mwelling/robot-chopper/Media/GCS-Platform/2010-04-21 18.45.57.jpg

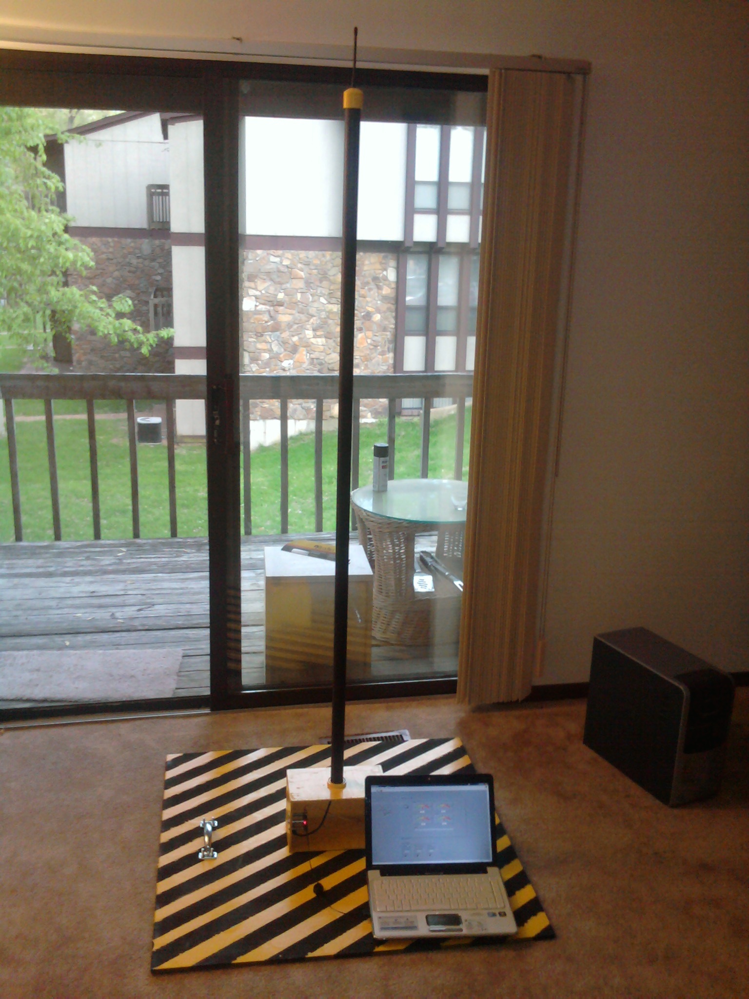
Media/GCS-Platform/2010-04-21 18.45.57.jpg
