mwelling/robot-chopper/Media/GCS-Interface/Interface2.png

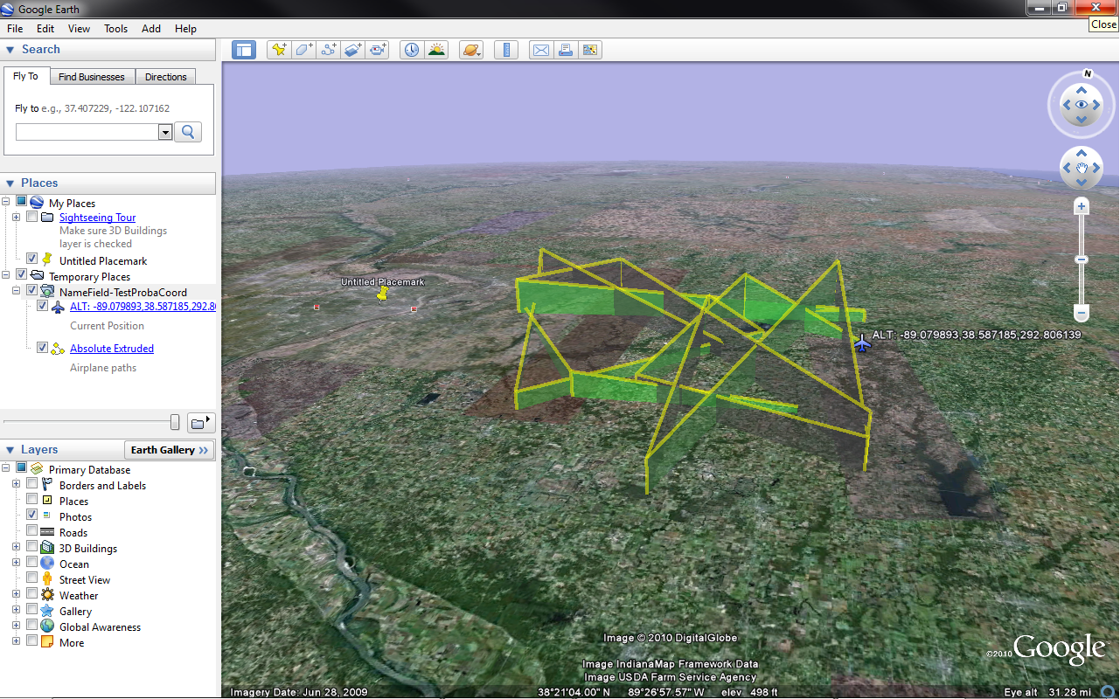
Media/GCS-Interface/Interface2.png
