mwelling/robot-chopper/RemoteControl/Program/ReadMe.txt

Version 1.0:  Manual Control of the Vehicle using the Analog Joysticks, including ability to remove power from Vehicle motor controllers using Kill Switch. Network initialization using 3-way handshake.  Error display on LCD Screen.  RCU will only work with Vehicle, no support for the GCS is possible.

Version 2.0:  Using XBee API Mode, RCU can communicate to GCS and/or Vehicle.

Version 3.0:  Limited autonomous functions (non-GPS enabled) such as Land, Take-Off and Hover implemented.  Force Feedback on RCU, specifics to be developed.

Version 4.0:  Enhanced autonomous functions (GPS enabled) such as Return to RCU, Follow-Me, etc.
