mwelling/robot-chopper/Analysis/INU Calibration/INU Design.docx

Accelerometer Filter Design

Overview:

An Accelerometer detects acceleration through a MEMS device. As an accelerometer works with quickly varying measurements, most of the noise present in an accelerometer is contained in a lower bandwidth.

Using the Matlab Filter Toolbox, a Low pass filter was designed with the following parameters:

Filter Type: Low-Pass, Butterworth, 4th Order.
Filter Cutoff Frequency: 20 Hz
Filter Equation:

H(s)=(.001(.0199s^4 +.0797s^3 +.1195s^2 +.0797s+.0199)/(s^4 -3.6353s^3 +4.9709s^2 -3.0293s+.6941)

Accelerometer Output: ∆a_x ,∆a_y ,∆a_z

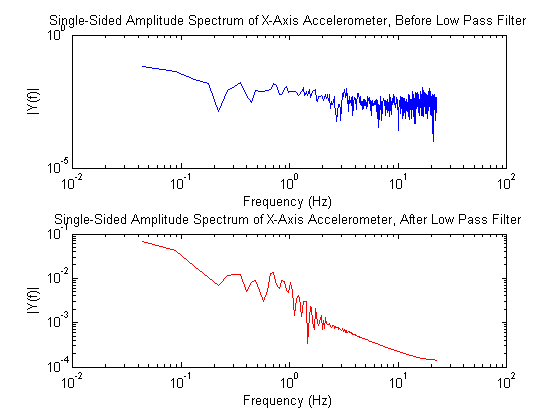
[picture p3: figure]

Figure 1. Accelerometer Filter Results

Gyroscope Filter Design

A Gyroscope detects rotational movement through a MEMS device. As a gyroscope works with measurements that are much slower to change, most of the noise present in a gyroscope is present in higher bandwidths.

bandwidth.

Using the Matlab Filter Toolbox, a High pass filter was designed with the following parameters:

Filter Type: High-Pass, Butterworth, 4th Order.
Filter Cutoff Frequency: 20 Hz
Filter Equation:

H(s)=(.3926s^4 - 1.5705s^3 +2.3558s^2 -1.5705s+.3296)/(s^4 -2.1909s^3 +2.0419s^2 - .895s+.1542)

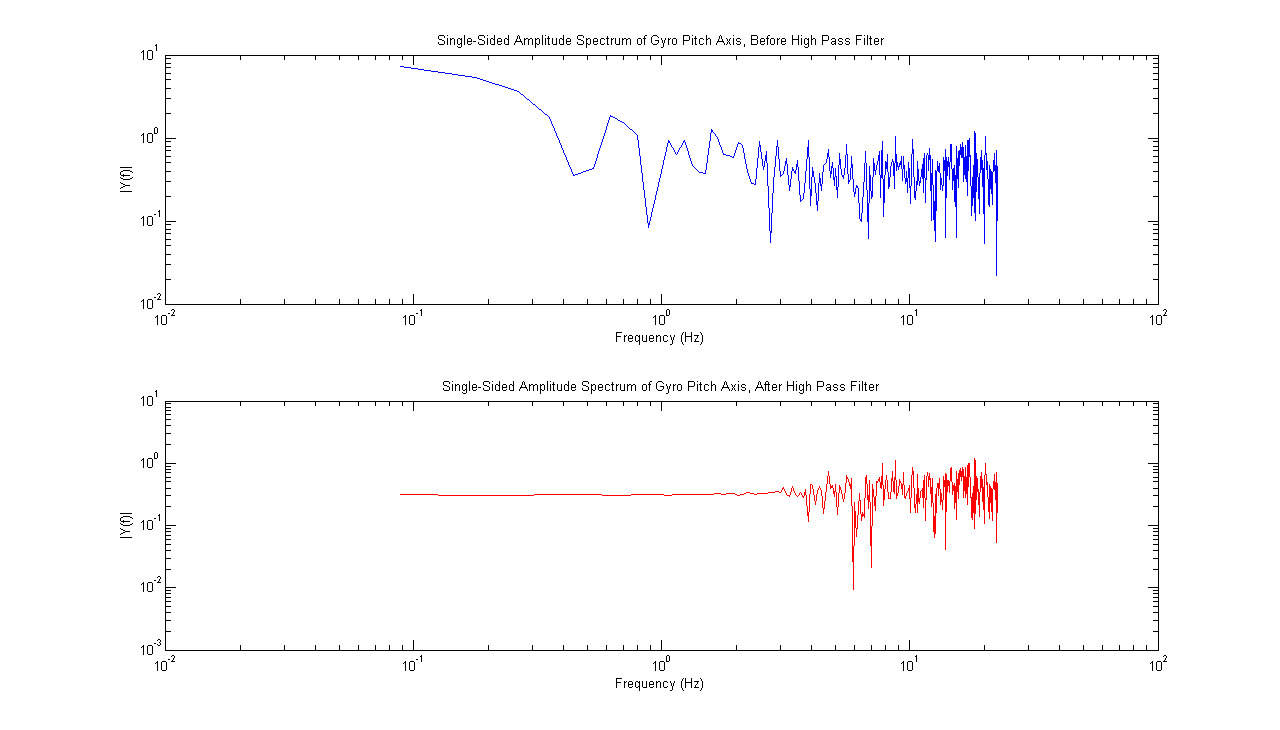
[picture p4: figure]

Figure 2. Gyroscope Filter Results

Kinematic Equations

∆v_x = ∆a_x ∆t ∆s_x = ∆v_x ∆t+ (∆a_x (∆t)^2)/2

s_x =∑ ∆s_x

∆v_y = ∆a_y ∆t ∆s_y = ∆v_y ∆t+ (∆a_y (∆t)^2)/2

s_y =∑ ∆s_y

∆v_z = ∆a_z ∆t ∆s_z = ∆v_z ∆t+ (∆a_z (∆t)^2)/2

s_z =∑ ∆s_z
