mwelling/robot-chopper/Analysis/Dynamics/Flight Dynamics Analysis.docx

Flight Dynamics Analysis

# List of Symbols

Symbol | Domain | Unit | Description
ε | R | - | Quaternion angle of rotation
θ | R | rad | Pitch Angle
θ | R | (rad)/s | Pitch Angle Rate
ω | R | (rad)/s | Propeller Angular Velocity
c_T | R | - | Thrust coefficient of a propeller
c_P | R | - | Power coefficient of a propeller
D_P | R | m | Propeller Diameter
F_P | R^(3x1) | N | Total thrust generated by the propellers, F_P =[F_(P_x) F_(P_y) F_(P_z) ]
I' | R | A | Electrical current consumption of the motor
I_O | R | A | Electrical current consumption of the motor in no-load condition
K_T | R | (kg∙m^2)/(rad^2) | Constant value to calculate the thrust provided by a propeller given its angular speed
K_M | R | (kg∙m^2)/(rad^2) | Constant value to calculate the moment provided by a propeller given its angular speed
K_(TM) | R | m | Constant value that relates thrust and moment of a propeller
k_v | R | (RPM)/V | Propeller’s speed in revolutions per minute per unit of voltage
M_P | R | N∙m | Propeller’s moment
n | R | s^(-1) | Propeller’s speed in revolutions per second
P_P | R | W | Propeller power
ρ | R | (kg)/(m^3) | Air density at sea level and 20°C
Q^(') | R | A⋅s | Electric charge of the battery (usually presented in mAh)
r | R | m | Propeller radius
T | R | N | Propeller Thrust
V_m | R | V | Motor’s power supply voltage
V_O | R | V | Minimum power supply required for propeller rotation
ω_v | R | (rad)/(V∙s) | Propeller angular speed in S.I. units per unit of voltage

# Equations

## Typical Values

ρ=1.2041 (kg)/(m^3)

## Propeller Power

c_P =.0743

P_P =c_P (4ρr^5)/(π^3)ω^3

## Propeller Thrust

c_T =.1154

T_P =c_T (4ρr^4)/(π^2)ω^2
