mwelling/robot-chopper/Project Management/Design Review/12-Nov-2010/Handouts/3-DevProgress.pdf

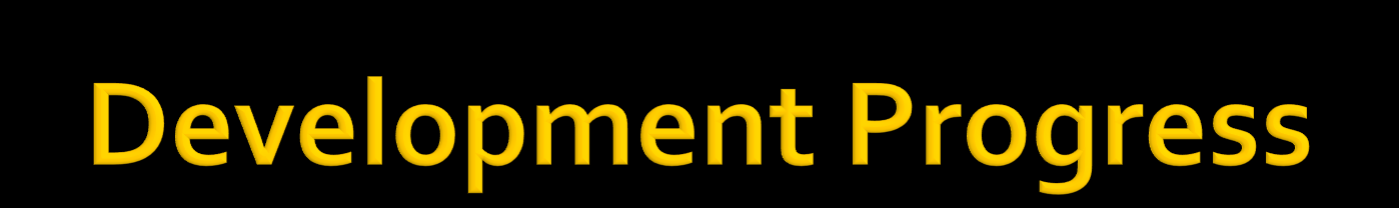
[picture p47: figure]

- Cost: 24% of material/part cost invested.
- Tasks: 23% of defined tasks completed.

# - Currently in Phase 1 with limited

development in Phase 2.

System | System Total: | Un-Funded: | Funded: | # Tasks | # Completed | % Complete
RCU: | 265.55 | 0.00 | 265.55 | 18 | 8 | 44%
Test-Stand: | 1,119.27 | 1,071.72 | 47.55 | 15 | 3 | 20%
GCS: | 2,245.59 | 1,926.89 | 318.70 | 12 | 4 | 33%
Vehicle: | 1,185.70 | 669.55 | 516.15 | 34 | 3 | 9%
Total: | 4,816.11 | 3,668.16 | 1,147.95 | 79 | 18 | 23%
