mwelling/robot-chopper/Marketing/PRPresentation.pdf

# General Overview (http://www.google.com/imgres?h=561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)

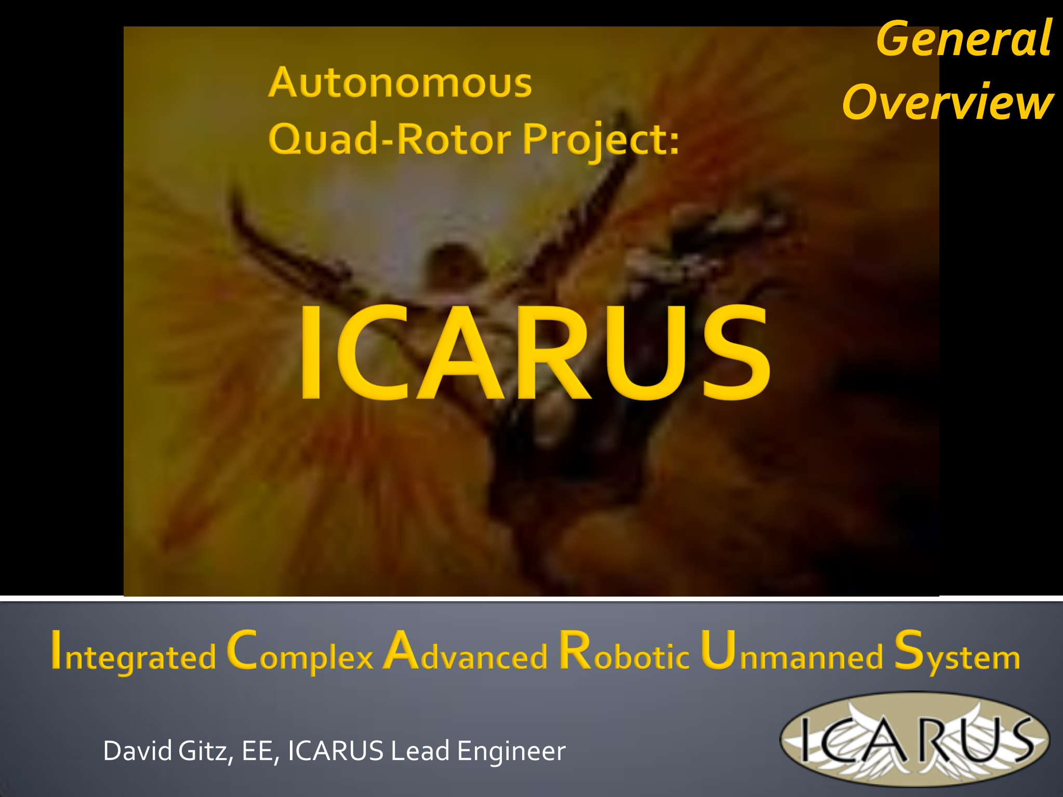
[picture p48: page 1]

## David Gitz, EE, ICARUS Lead Engineer

## - Ben Wasson

### - Masters Student - ICARUS Business Manager

## - David Gitz

### - Electrical Engineer - ICARUS Lead Engineer

## - Michael Welling

### - PhD Candidate - ICARUS Systems Engineer

## - James Chaklos

### - Masters Student - ICARUS Test-Stand Engineer

## - Steve Warren

### - Computer Engineer - ICARUS Communications Engineer

# Core Team

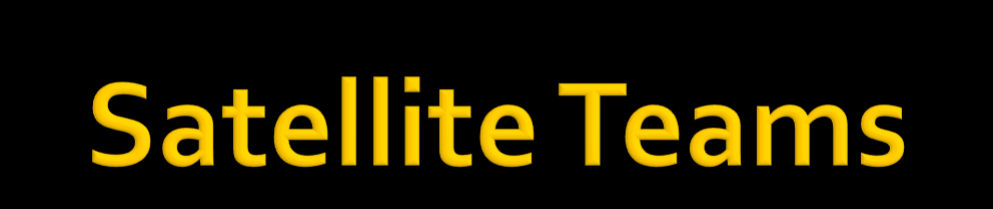
[picture p49: figure]

# - Washington University UAV Team - SIU-Carbondale Control Systems Lab - SIU-Carbondale Senior Design (pending)

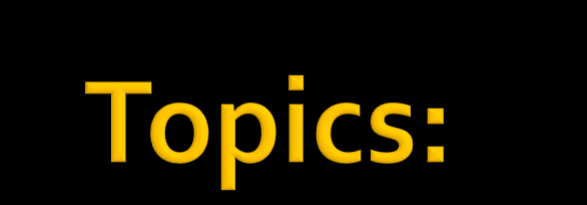
[picture p50: figure]

# - Applications - The Future - System Description - Capabilities - Competitor Analysis

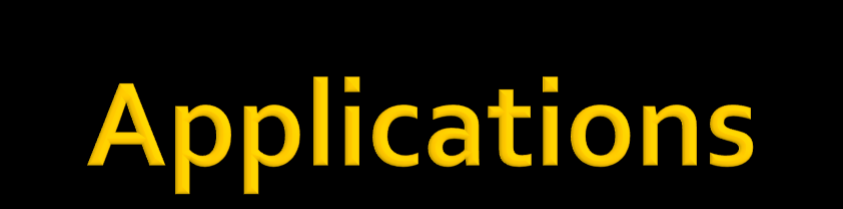
[picture p51: figure]
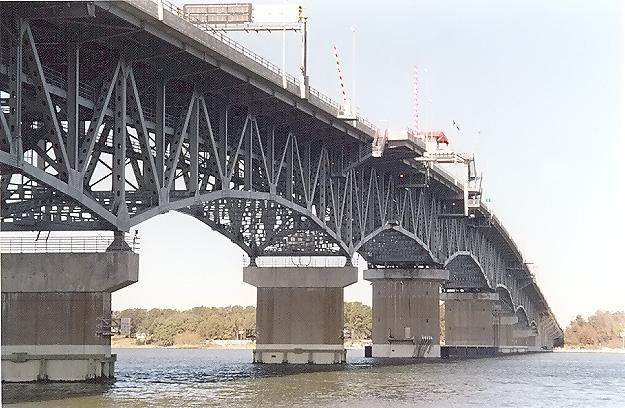
[picture p52: figure]
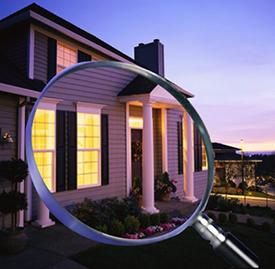
[picture p53: figure]

Civil Inspection | Residential
| Inspection

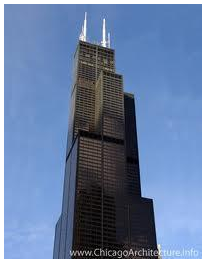
[picture p54: figure]

### Large Building Inspection

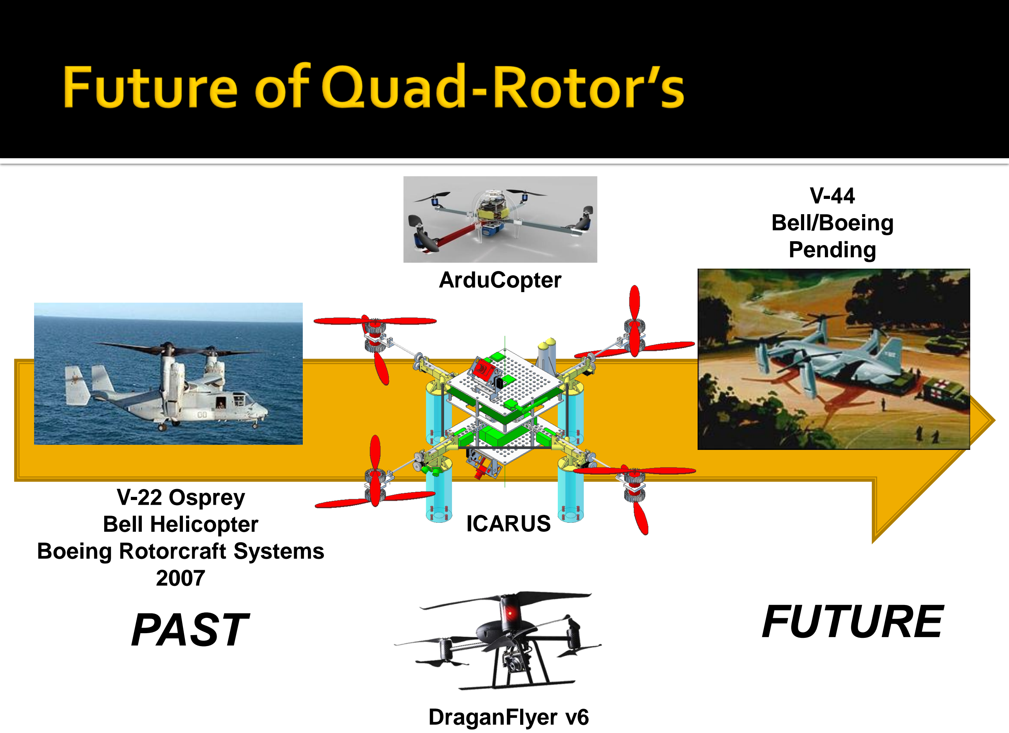
[picture p55: page 6]

V-44
Bell/Boeing
Pending

V-22 Osprey
Bell Helicopter
Boeing Rotorcraft Systems
2007

ArduCopter

DraganFlyer v6

PAST | FUTURE

ICARUS

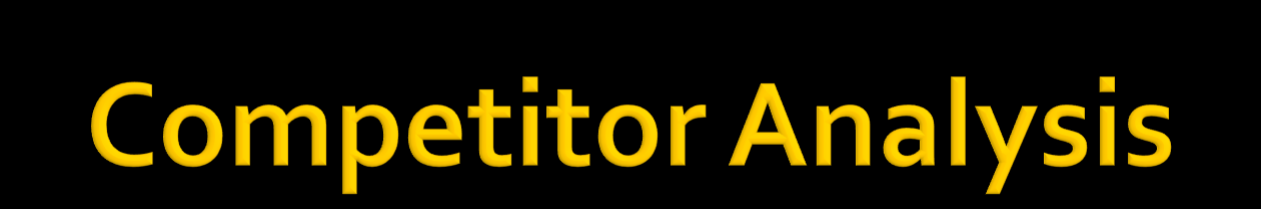
[picture p56: figure]
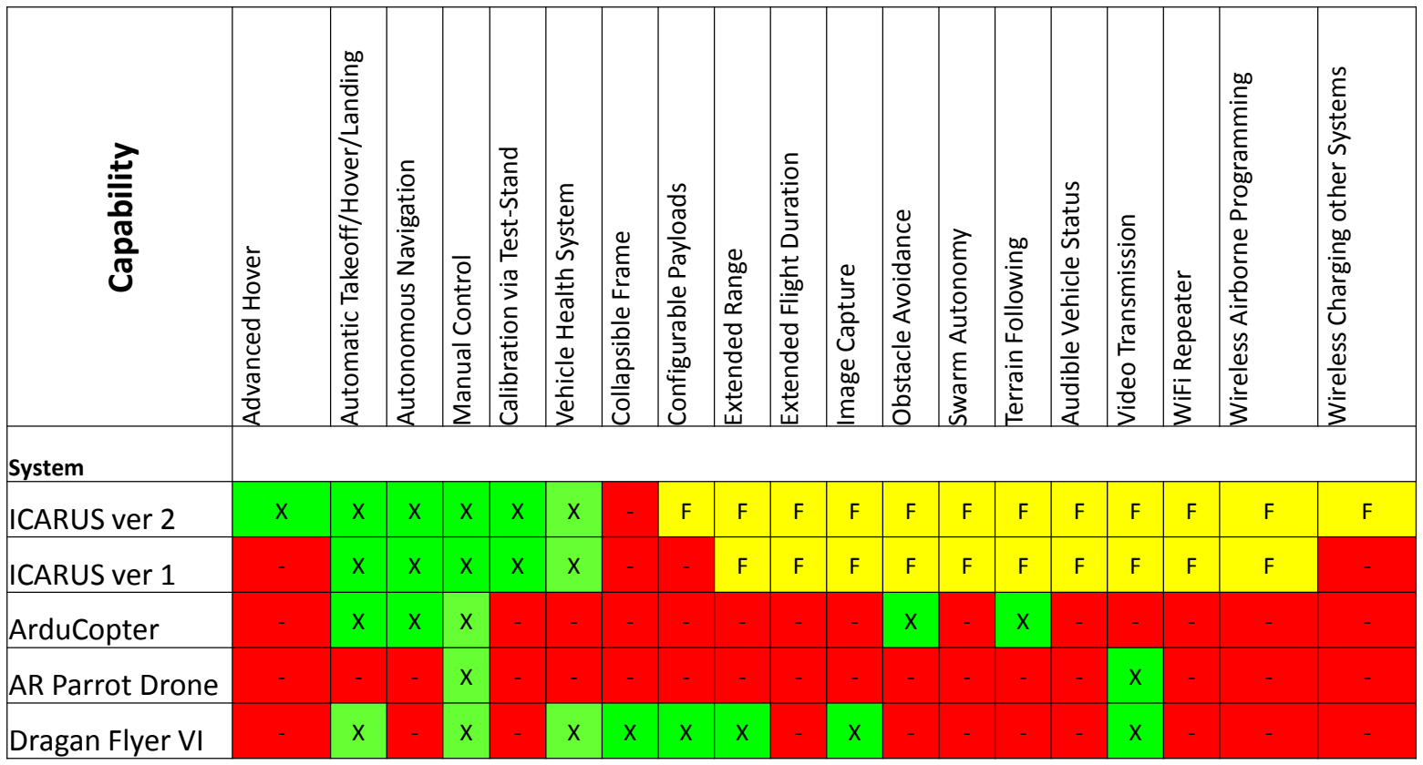
[picture p57: figure]
Capability; Advanced Hover; Automatic Takeoff/Hover/Landing; Autonomous Navigation; Manual Control; Calibration via Test-Stand; Vehicle Health System; Collapsible Frame; Configurable Payloads; Extended Range; Extended Flight Duration; Image Capture; Obstacle Avoidance; Swarm Autonomy; Terrain Following; Audible Vehicle Status; Video Transmission; WiFi Repeater; Wireless Airborne Programming; Wireless Charging other Systems; System

ICARUS ver 2 | X | X | X | X | X | X | - | F | F | F | F | F | F | F | F | F | F | F | F
ICARUS ver 1 | - | X | X | X | X | X | - | - | F | F | F | F | F | F | F | F | F | F | -
ArduCopter | - | X | X | X | - | - | - | - | - | - | - | X | - | X | - | - | - | - | -
AR Parrot Drone | - | - | - | X | - | - | - | - | - | - | - | - | - | - | - | X | - | - | -
Dragan Flyer VI | - | X | - | X | - | X | X | X | X | - | X | - | - | - | - | X | - | - | -

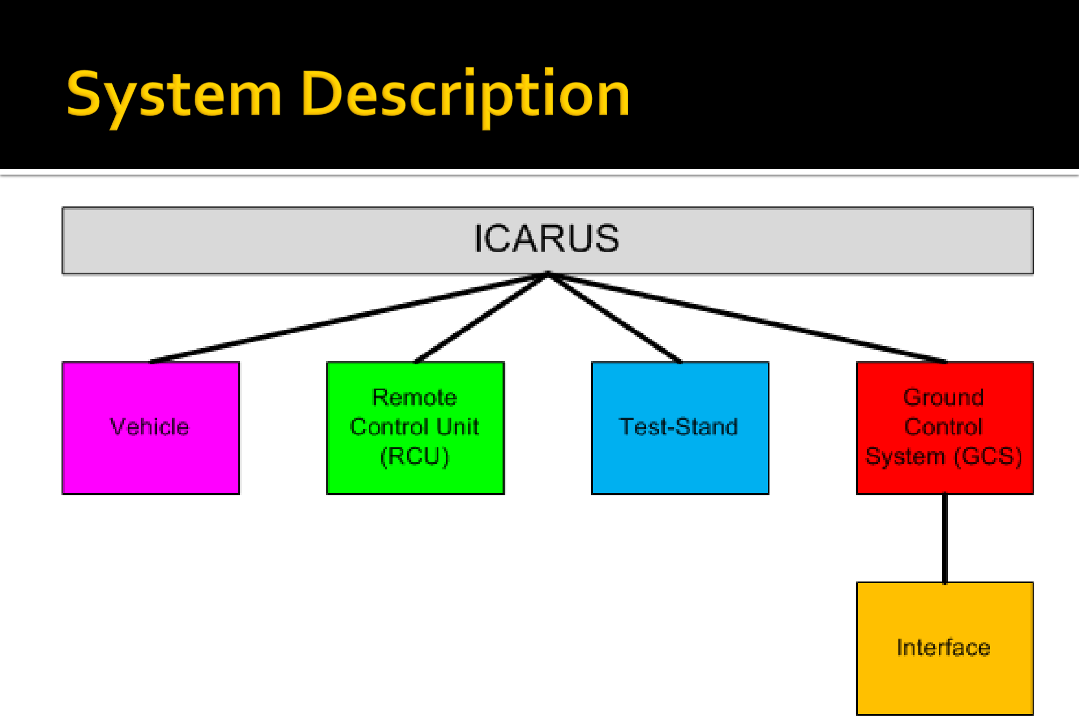
[picture p58: page 8]

# Vehicle

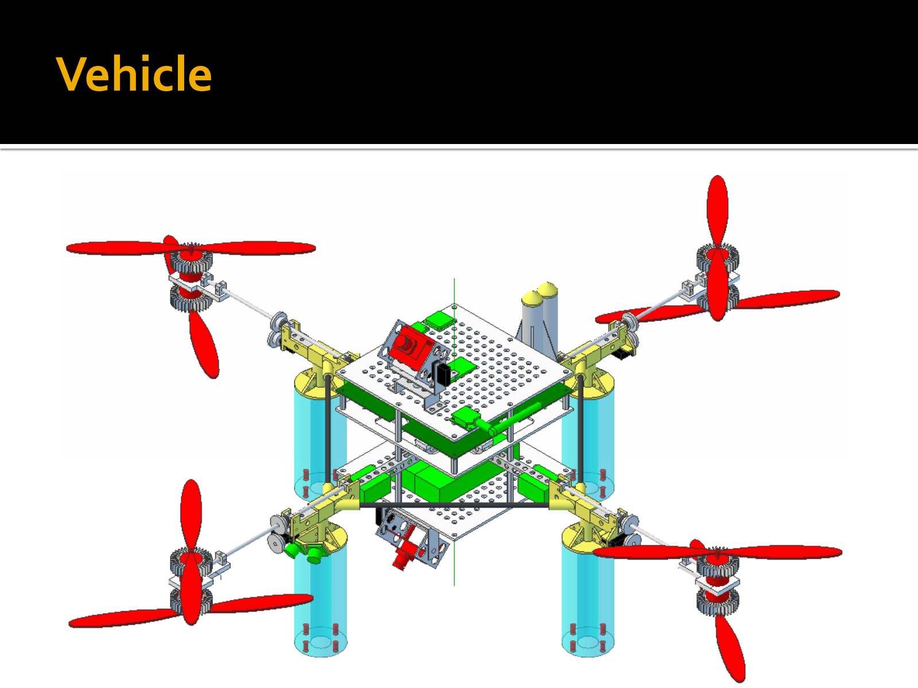
[picture p59: page 9]

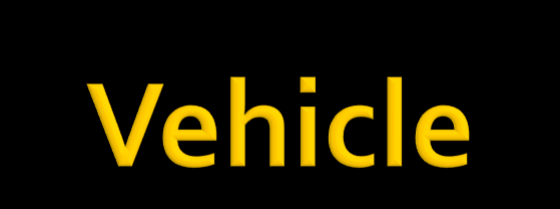
[picture p60: figure]
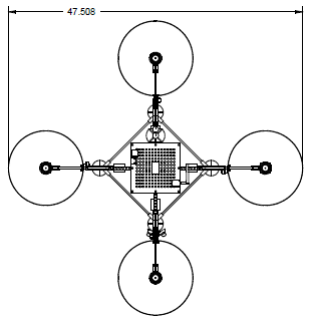
[picture p61: figure]

# - Quad-Rotor design – Offers simpler control system with fewer moving parts than a single rotor helicopter and minor reduction in lift capacity

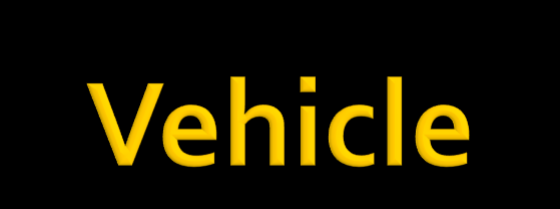
[picture p62: figure]

# - 2 “Brains”, 1 SoM Board and 1 Parallax PropellerTM uC - SoM handles waypoint

navigation, mission planning, vehicle health.

# - PropellerTM uC handles PWM

generation.

# - In the event of an in-air mishap, PropellerTM uC can take over Vehicle and land

safely.

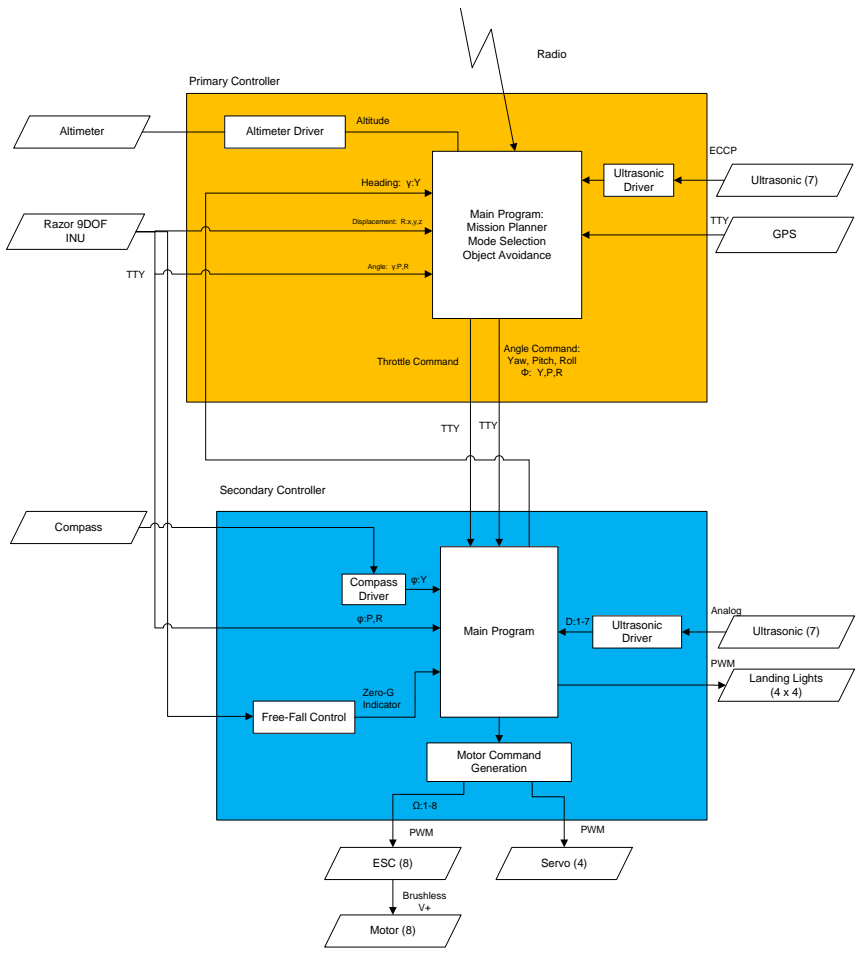
[picture p63: figure]
Primary Controller; Secondary Controller; Main Program; Motor Command Generation ESC (8) Ω:1-8; Motor (8); Ultrasonic (7); TTY; Analog; PWM; Brushless V+; Radio; TTY Altimeter; Altimeter Driver; Altitude; Compass; Compass Driver; Free-Fall Control; Ultrasonic Driver D:1-7 φ:Y φ:P,R; Zero-G Indicator; Ultrasonic (7) Ultrasonic Driver; ECCP Razor 9DOF INU; Servo (4); Landing Lights (4 x 4) PWM

Main Program: Mission Planner Mode Selection Object Avoidance | GPS
Throttle Command | Angle Command: Yaw, Pitch, Roll Φ: Y,P,R

Heading: γ:Y Displacement: R:x,y,z Angle: γ:P,R

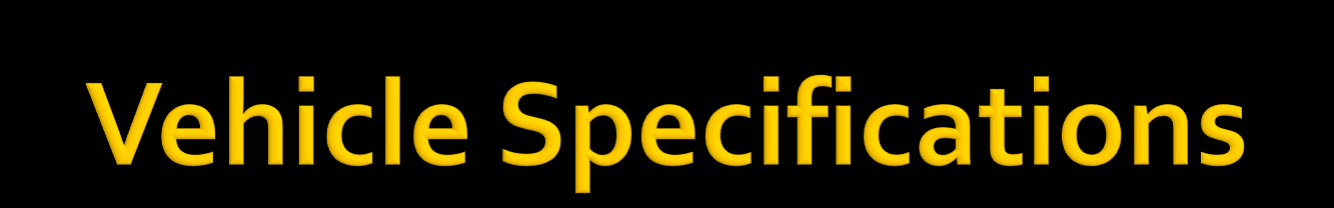
[picture p64: figure]

# - Sensors: 3-Axis Accelerometer, 3-Axis Gyroscope, 3-Axis Magnetometer (INU), Digital Compass, Altimeter, GPS, 7 Ultrasonic Sensors

- Power: 8 Brushless DC 200 Watt Motors, 4 Micro Servo’s,

# 2 Lithium-Ion 11.1V 5 Amp-Hours Batteries, 4 18A Electronic

Speed Controllers, 5V and 3.3V Linear Voltage Regulators.

# - Control: SoM Controller (Primary), Propeller Controller

(Secondary), custom PCB.

# - Communications: Xbee Radio for Command/Control, Video

Transmitter, Wi-Fi (Field programming, tentative).

# - Fabrication: ~50% COTS, ~50% produced by

MakerBot/Ponoku.

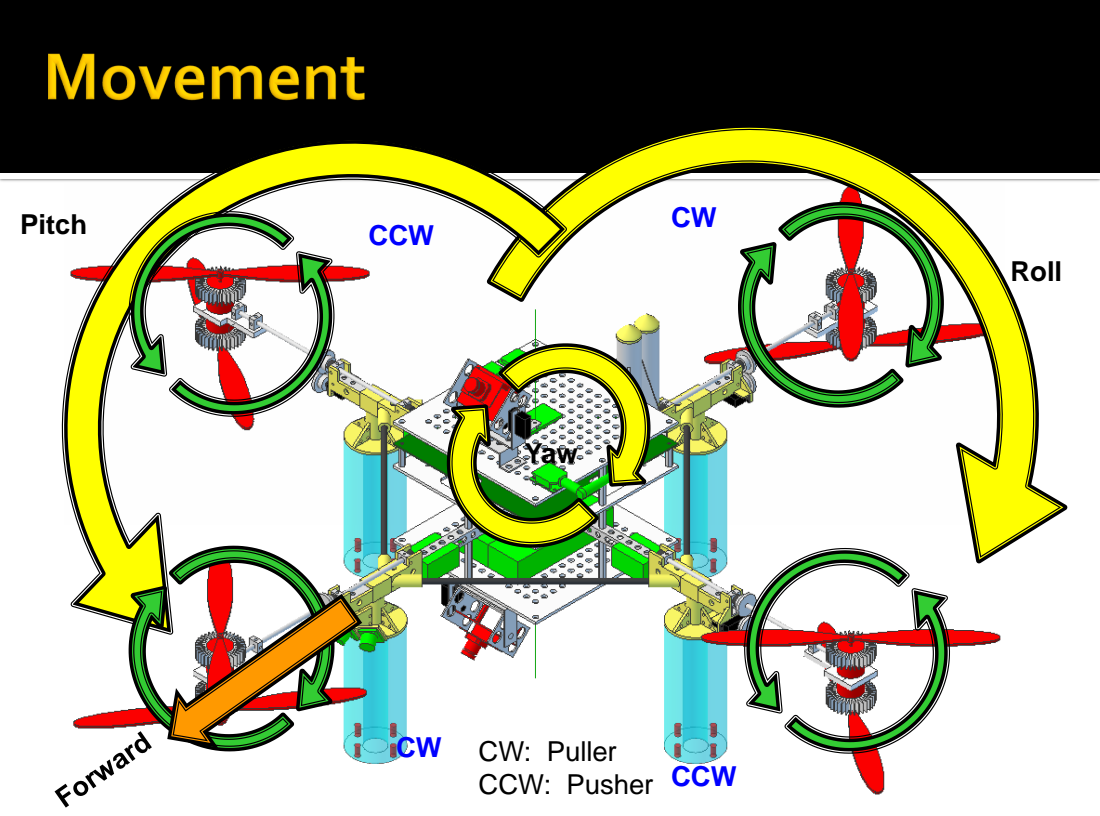
[picture p65: page 13]
Yaw; Pitch; Roll; CW: Puller CCW: Pusher; CCW

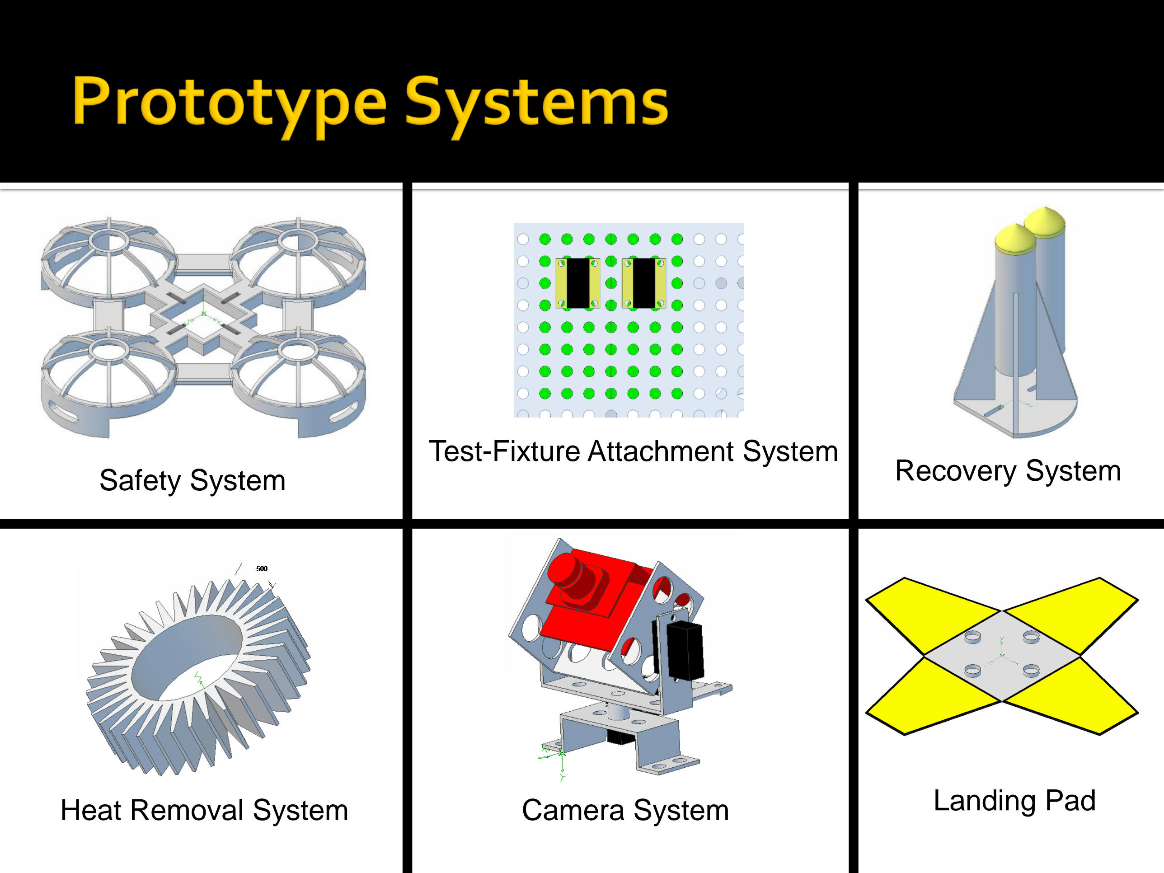
[picture p66: page 14]

### Heat Removal System

### Test-Fixture Attachment System

Safety System | Recovery System
Camera System | Landing Pad

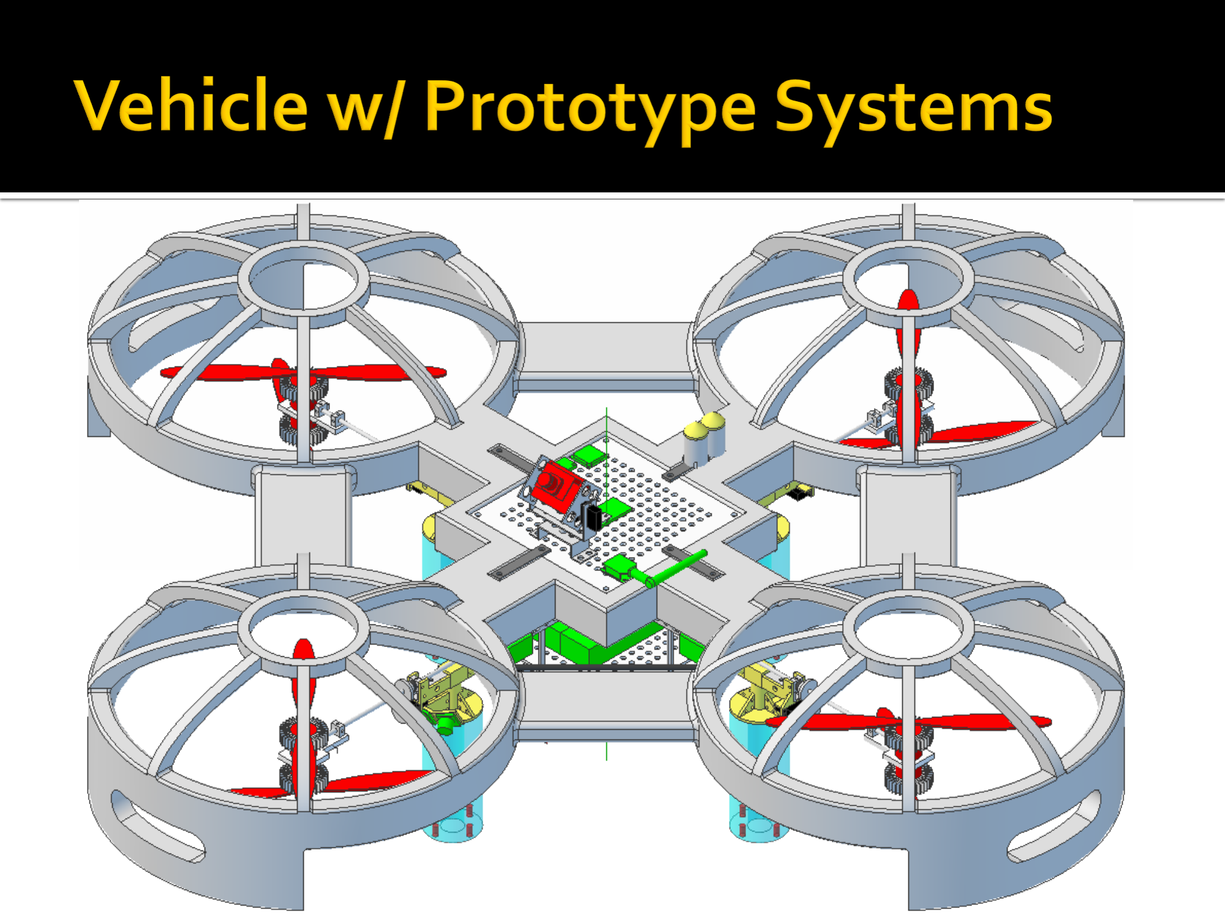
[picture p67: page 15]

# - Custom PCB inside

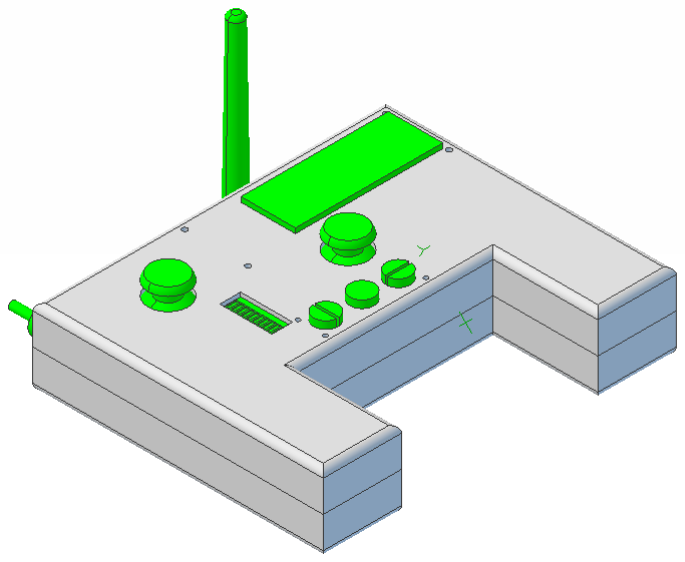
[picture p68: figure]

# Xbox-360 Controller - Features Mode and Error Display, Vehicle

Battery Indicator,

# Force-Feedback and 5 hours of continuous

operation.

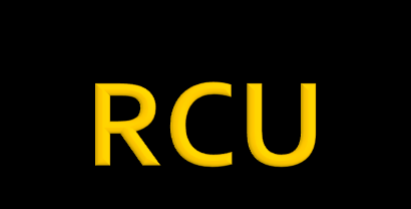
[picture p69: figure]

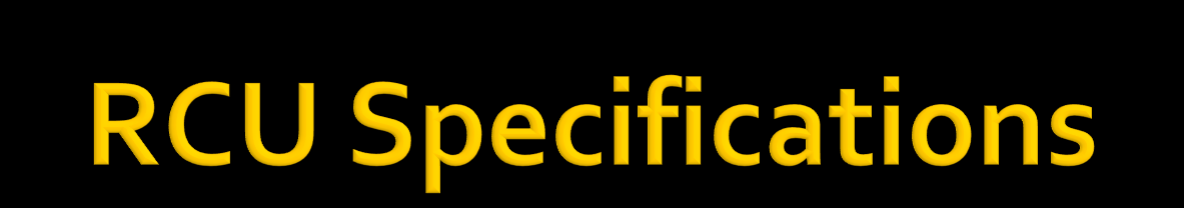
[picture p70: figure]

# - Communications: XBee Radio for Command/Control - Input/Output: 9 Switches/Buttons, 2 Dual-

Axis Joysticks, GPS Sensor, 10-Segment LED, LCD Screen, Vibrating Motors.

# - Power: 2 Ni-Mh AA Batteries, 3.3 and 5V

Boost Converters.

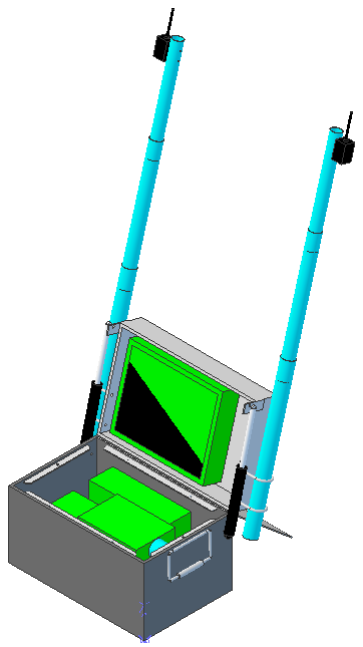
[picture p71: figure]

- Includes computer,

# touch-screen monitor and batteries for field

operation.

# - Communications Radio and Video Receiver - Heavy-duty field transportable case

# GCS

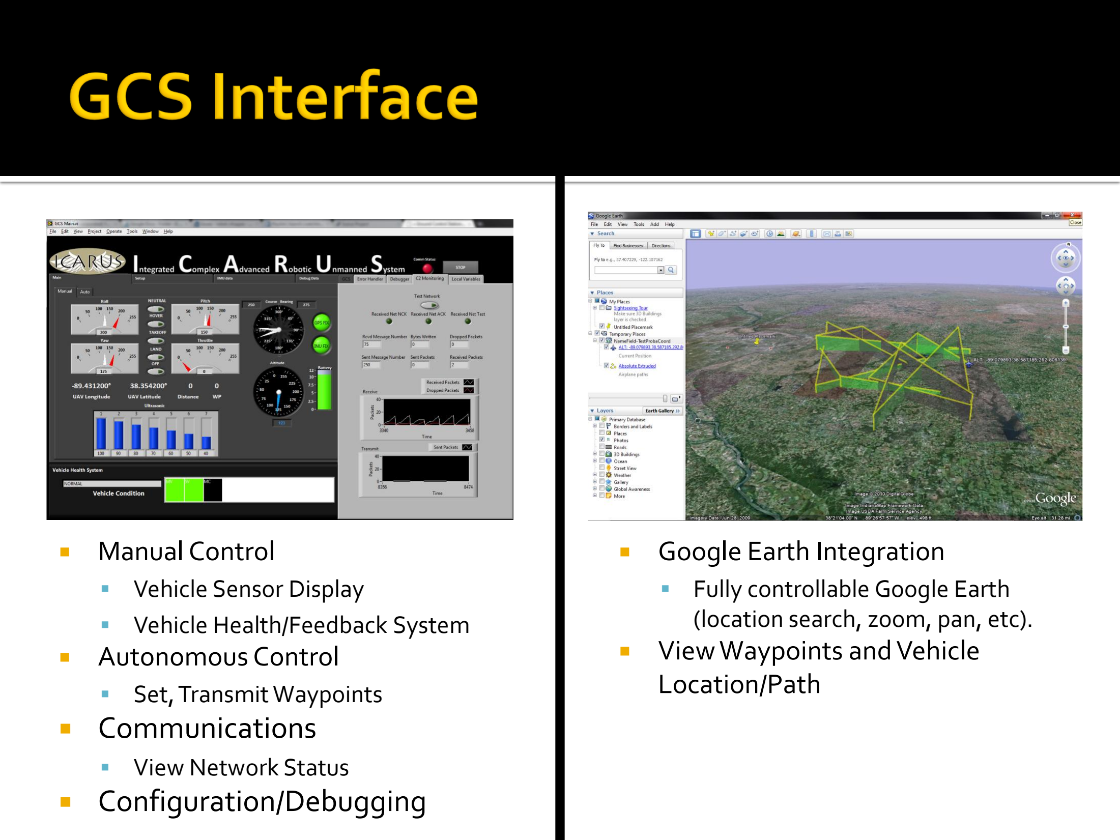
[picture p72: page 19]

### - Manual Control

- Vehicle Sensor Display
- Vehicle Health/Feedback System

### - Autonomous Control

- Set, Transmit Waypoints

## - Communications

- View Network Status

## - Configuration/Debugging

### - Google Earth Integration

- Fully controllable Google Earth (location search, zoom, pan, etc).

### - View Waypoints and Vehicle Location/Path

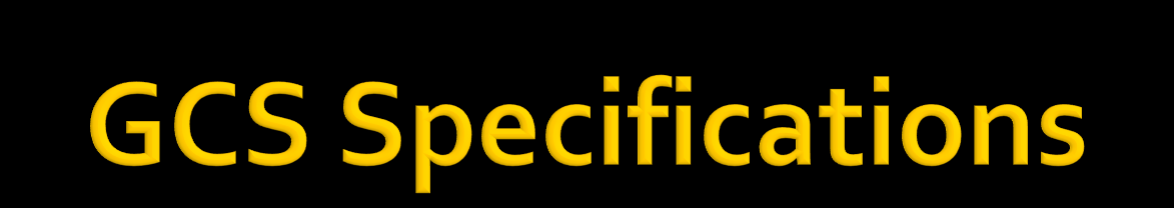
[picture p73: figure]

# - Software: National Instruments LabView integrated with Google Earth mapping

software.

# - Power: 2 12V 26Amp-Hour Batteries, 120V AC Power Inverter, Vehicle battery fast

charger.

# - Communications: XBee Radio for Command/Control, Video Receiver

# Test-Stand

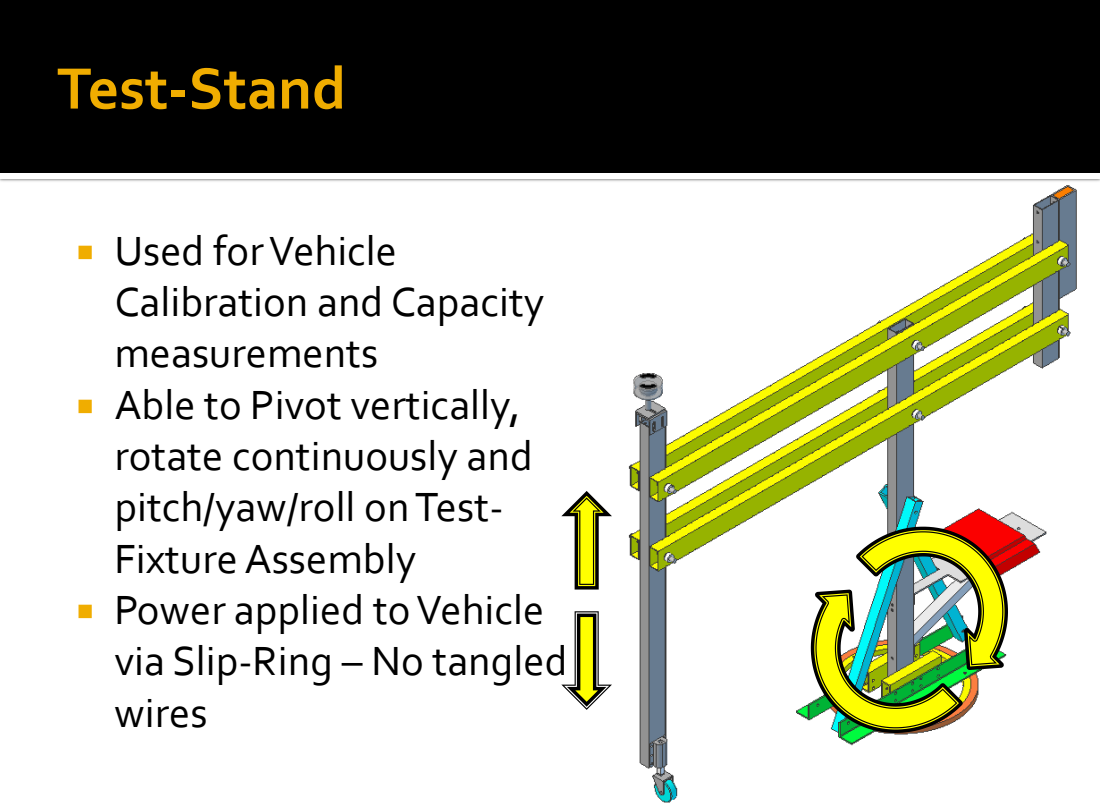
[picture p74: page 21]

Used for Vehicle
Calibration and Capacity
measurements
Able to Pivot vertically,
rotate continuously and
pitch/yaw/roll on Test-
Fixture Assembly
Power applied to Vehicle
via Slip-Ring – No tangled
wires

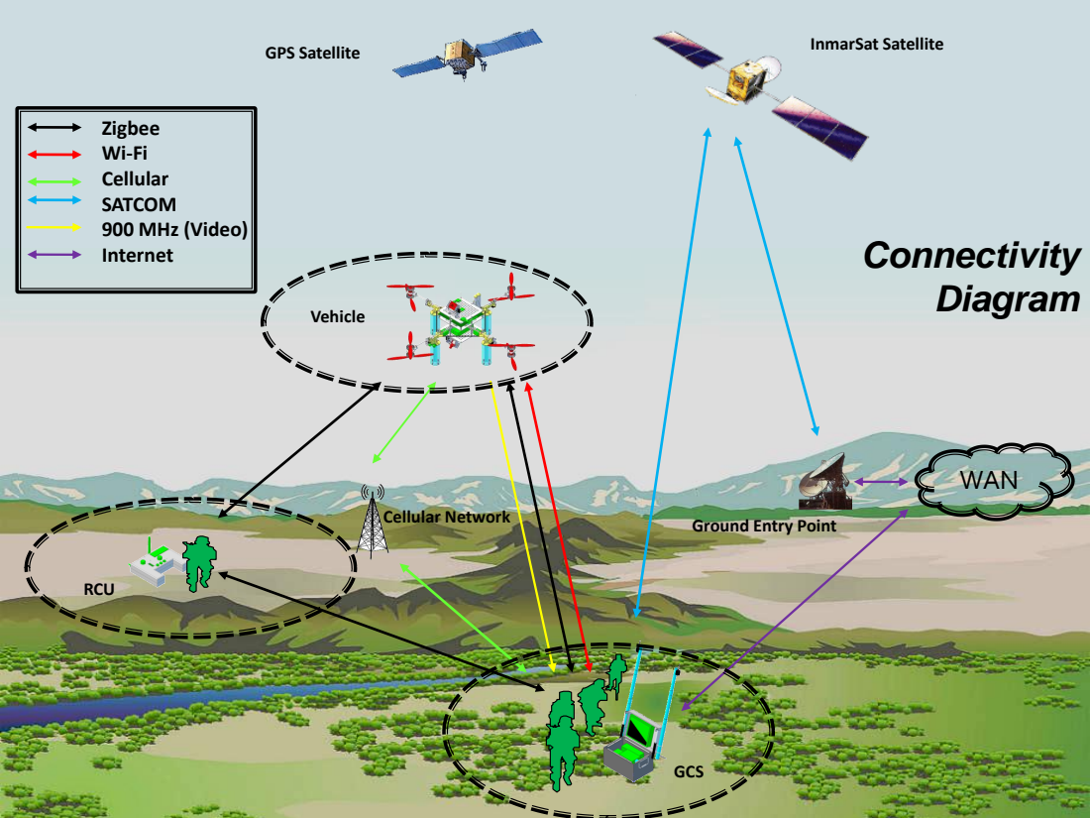
[picture p75: page 22]
GCS; RCU; Vehicle; Cellular Network; GPS Satellite; Zigbee Wi-Fi Cellular SATCOM 900 MHz (Video) Internet; InmarSat Satellite; WAN; Connectivity Diagram

Ground Entry Point

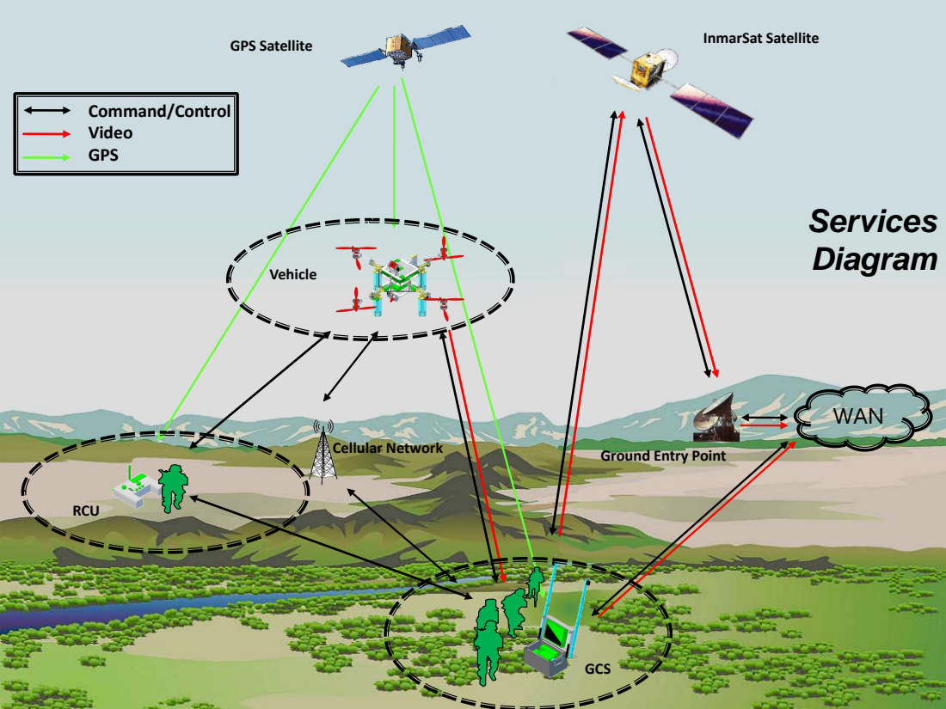
[picture p76: page 23]
GCS; RCU; Vehicle; Cellular Network; GPS Satellite; Command/Control Video GPS; InmarSat Satellite; WAN; Services Diagram

Ground Entry Point

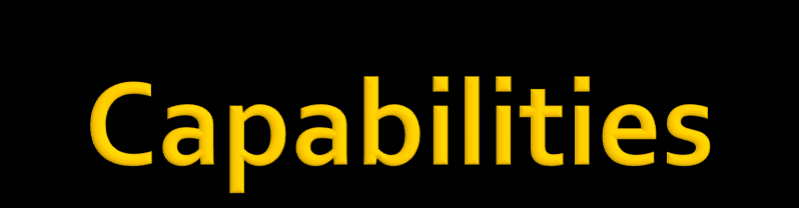
[picture p77: figure]

### Capabilities - Planned

ManualControl via RCU or GCS | Simple Calibration and Testing via Test-Stand
Limited Autonomous Navigation via RCU | Error Display on RCU and GCS
Extended Autonomous Navigation viaGCS | Force-Feedback on RCU
Automatic Takeoff, Hover and Landing | Vehicle Health Reporting

### Capabilities - Future

Real-TimeVideo Transmission to GCS | Image Capture
Wireless airborne programming | Advanced Hover modes
Vehicle Status Audio via RCU | Extended Range
Configurable Payloads | Terrain Following
Extended Flight Duration | Obstacle Avoidance
Swarm Autonomy | Vehicle Status -Audio

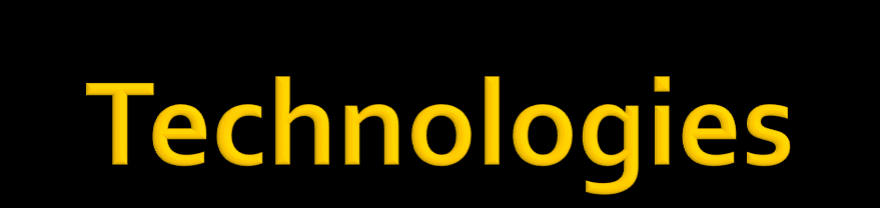
[picture p78: figure]

### Technologies - Planned

Command/Control Network Monitoring | Inertial Navigation Unit (INU) w/ Altitude and Heading Reference System (AHRS)
Power Management | Primary/Secondary Controller Implementation
Waypoint Navigation | Communications Protocol
Co-Axial Rotors | Tilt Rotors

### Technologies - Future

3d Feedback | Audio Commands
Automatic Landing Pad | Cellular Network
Cel-Phone Control | Target Detection
Data Storage | GCS Interface (MATLAB)
JAUS Interoperability | Motor Heat Dissipation
R/C Control | RCU Testing Software
Recovery System | Wireless Charging
Satellite Communications | Simultaneous Localization and Mapping (SLAM)

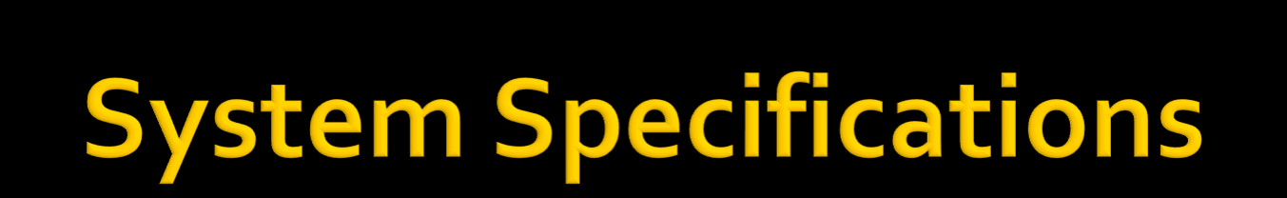
[picture p79: figure]

# - Range: ~1.5 km LOS (~3km with Xbee Mesh Network) - Duration:

# - Vehicle: ~12 min (100% Throttle) , ~20 min ( Hover) - RCU: ~4-6 hrs - GCS: ~4-6 hrs (including field charging Vehicle)

# - Speed: ~2 - 4 kph - Weight: ~5.5 lbs - Size: 48” x 48” x 10.5” - Propeller Rotation: Max: 3,000 RPM - Vertical Thrust: ~7.8 lbs

# - Contact:

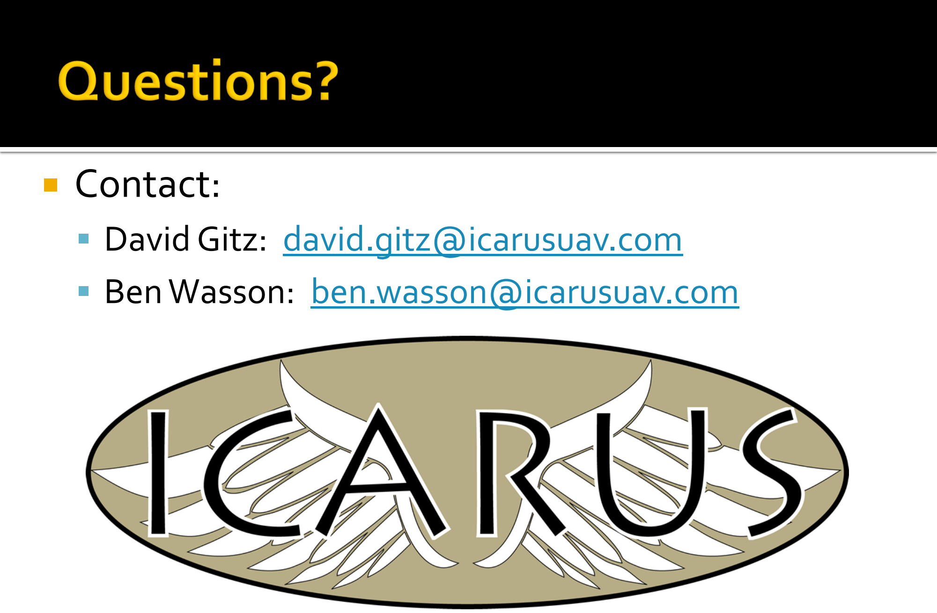
[picture p80: page 27]

# - David Gitz: david.gitz@icarusuav.com - Ben Wasson: ben.wasson@icarusuav.com
