mwelling/robot-chopper/Project Management/Phase Chart.pdf

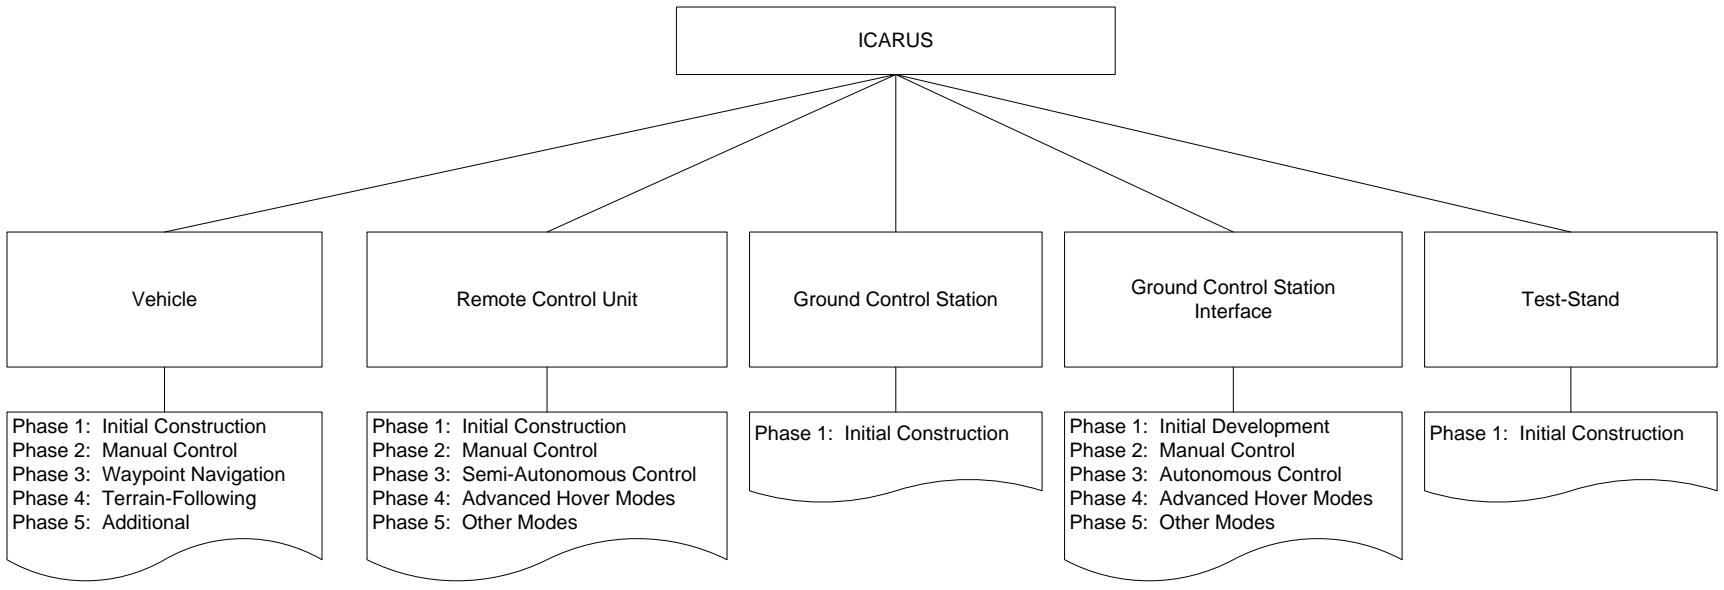
[picture p81: figure]
Phase 5: Additional; Vehicle; ICARUS; Phase 3: Semi-Autonomous Control; Remote Control Unit; Phase 1: Initial Development Phase 2: Manual Control Phase 3: Autonomous Control

Phase 1: Initial Construction Phase 2: Manual Control

Phase 3: Waypoint Navigation Phase 4: Terrain-Following

Phase 1: Initial Construction Phase 2: Manual Control

Phase 4: Advanced Hover Modes Phase 5: Other Modes

Phase 1: Initial Construction Ground Control Station | Ground Control Station Interface | Test-Stand
Phase 4: Advanced Hover Modes Phase 5: Other Modes | Phase 1: Initial Construction
