mwelling/robot-chopper/Marketing/MarketingPresentation.pdf

# Marketing Overview

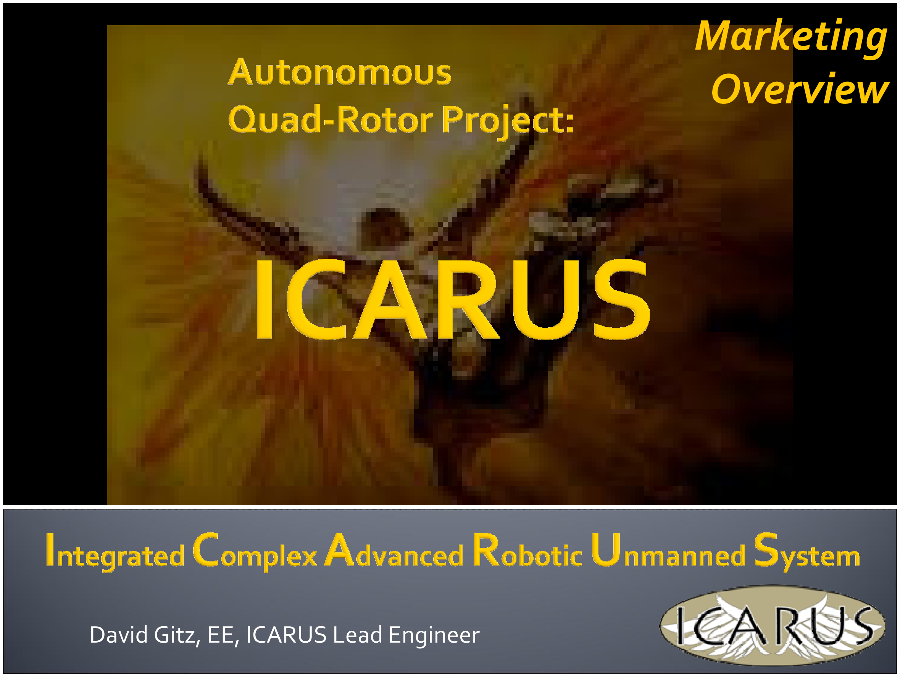
[picture p82: page 1]

### David Gitz, EE, ICARUS Lead Engineer

Sometimes, flying feels too godlike to be attained by man. Sometimes, the world from above seems too beautiful, too wonderful, too distant for human eyes to see . . .
— Charles A. Lindbergh, 'The Spirit of St. Louis,' 1953.'

There is an art, it says, or rather, a knack to flying. The knack lies in learning how to throw yourself at the ground and miss. [...] Clearly, it is this second part, the missing, which presents the difficulties.
— Douglas Adams,‘The Hitchhiker’s Guide to the Galaxy’

# “To develop innovative and interoperable unmanned systems”

| Ben Wasson
| Masters Student
| ICARUS Business Manager
| David Gitz
| Electrical Engineer
| ICARUS Lead Engineer
| Michael Welling
| PhD Candidate
| ICARUS Systems Engineer
| James Chaklos
| Masters Student
| ICARUS Test-Stand Engineer
| Steve Warren
| Computer Engineer
| ICARUS Communications Engineer

# Core Team

# Washington University UAV Team SIU-Carbondale ECE Lab Team SIU-Carbondale Senior Design (pending) Boeing ONE Group (pending)

# Applications The Future System Description Capabilities Competitor Analysis

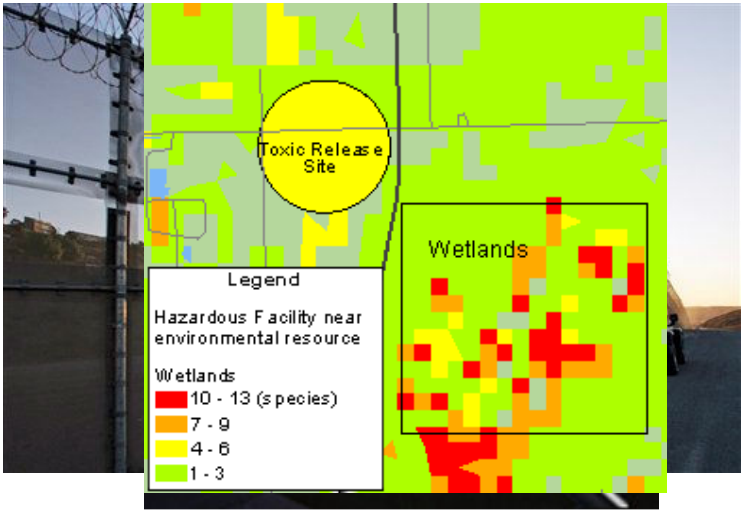
[picture p83: figure]

V-44
Bell/Boeing
Pending

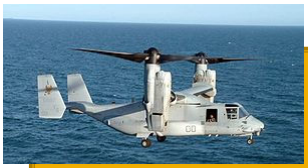
[picture p84: figure]
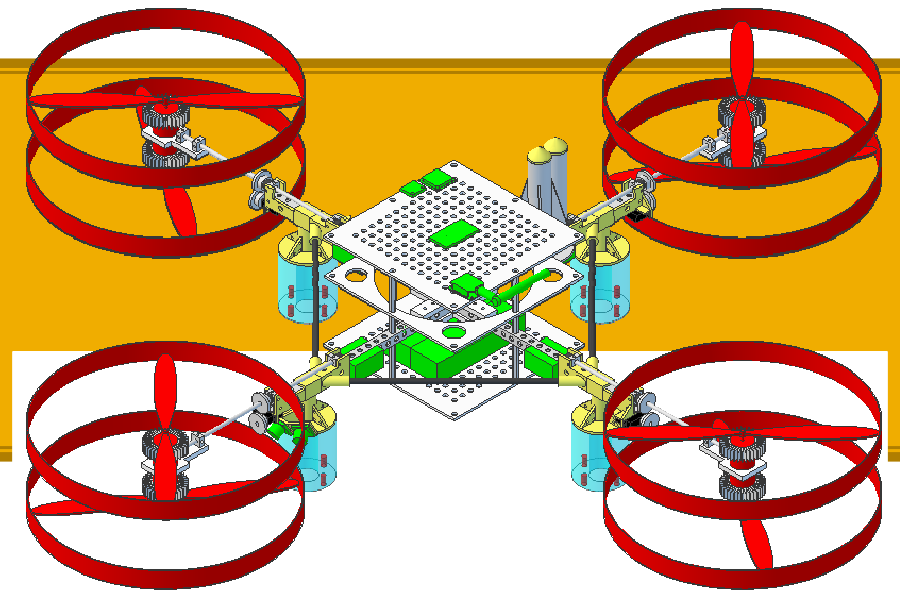
[picture p85: figure]

V-22 Osprey
Bell Helicopter
Boeing Rotorcraft Systems
2007

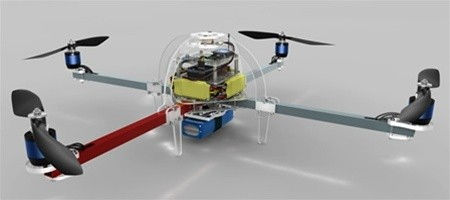
[picture p86: figure]
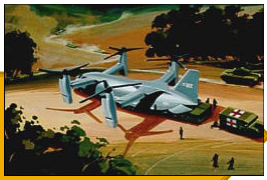
[picture p87: figure]

ArduCopter

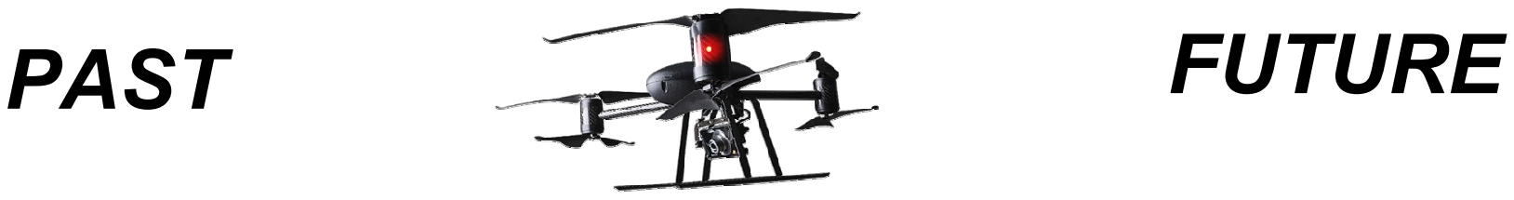
[picture p88: figure]
PAST; FUTURE

DraganFlyer v6

ICARUS

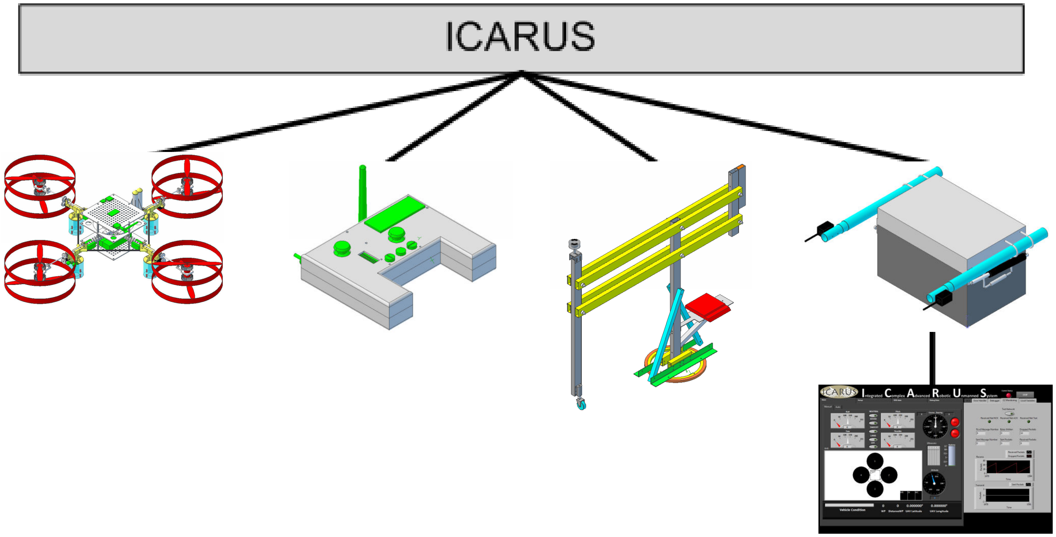
[picture p89: figure]
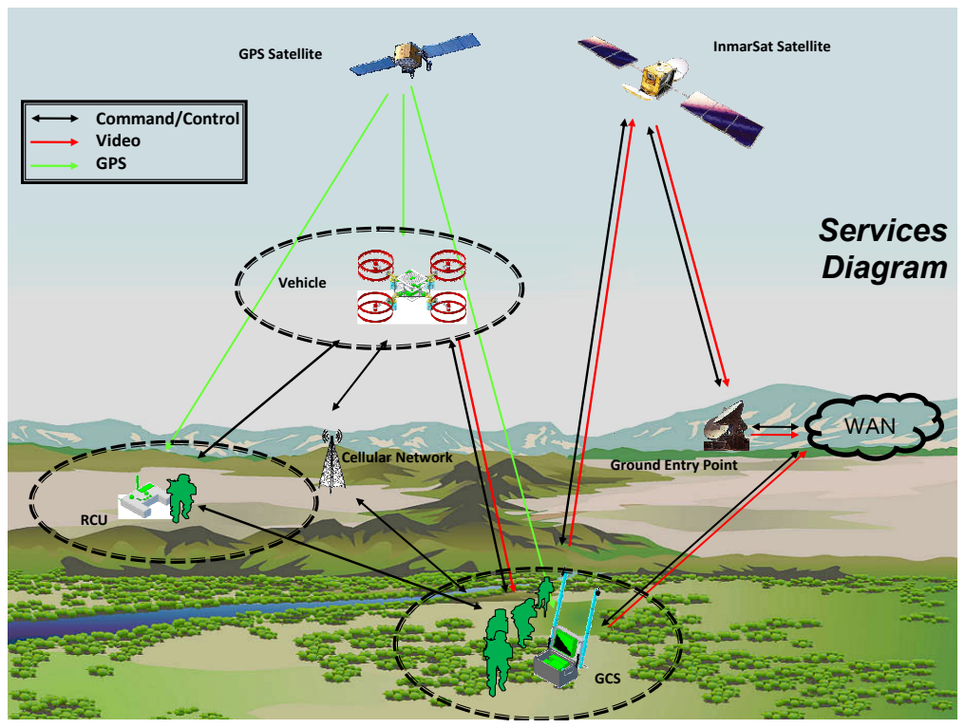
[picture p90: page 9]
GCS; RCU; Vehicle; Cellular Network; GPS Satellite; Command/Control Video GPS; InmarSat Satellite; WAN; Services Diagram

Ground Entry Point

Capabilities - Planned

Manual Control via RCU or GCS | Simple Calibration and Testing via Test-Stand
Limited Autonomous Navigation via RCU | Error Display on RCU and GCS
Extended Autonomous Navigation via GCS | Force-Feedback on RCU
Automatic Takeoff, Hover and Landing | Vehicle Health Reporting

Capabilities - Future

Real-Time Video Transmission to GCS | Image Capture
Wireless airborne programming | Advanced Hover modes
Vehicle Status Audio via RCU | Extended Range
Configurable Payloads | Terrain Following
Extended Flight Duration | Obstacle Avoidance
Swarm Autonomy | Vehicle Status - Audio

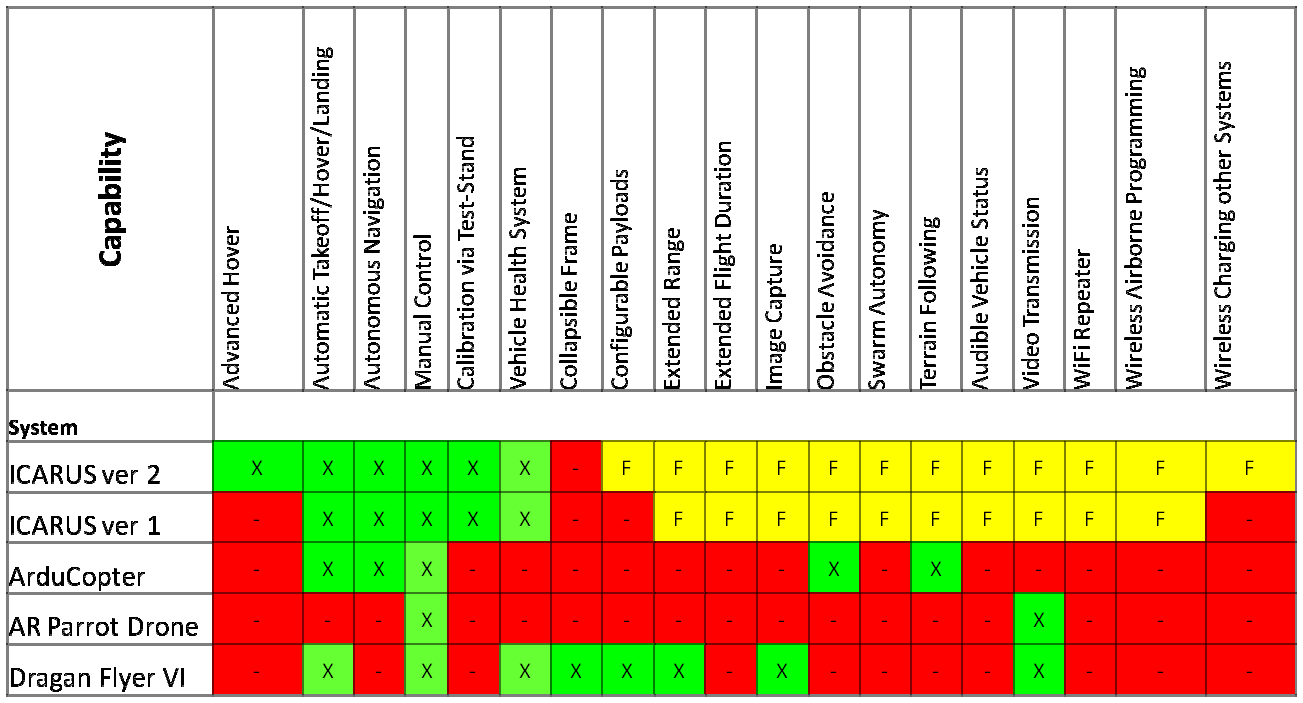
[picture p91: figure]

# Contact:

# David Gitz: david.gitz@icarusuav.com Ben Wasson: ben.wasson@icarusuav.com

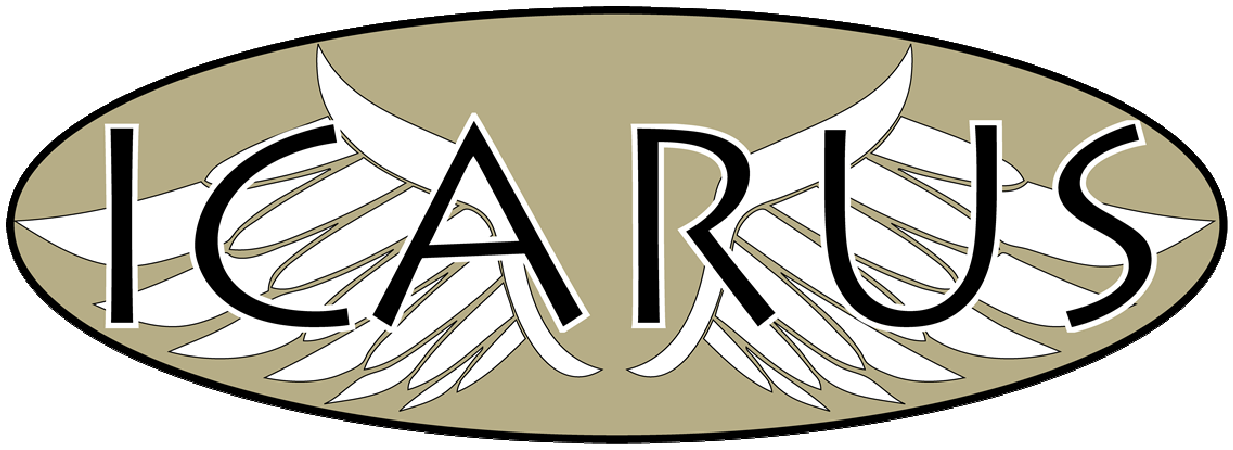
[picture p92: figure]
