mwelling/robot-chopper/Documentation/CompetitorAnalysis.pdf

Application Bridge Inspection

Crime Scene Investigation
Development Platform
Home Inspection

Enfironment Surveying
Reconaissance

Survivor Search

System
ICARUS ver 2 (http://www.icarusuav.com/) | X | X | X | X | X | X | X
ICARUS ver 1 | X | X | X | X | X | X | X
ArduCopter (http://code.google.com/p/arducopter/) | - | - | X | X | - | - | -
AR Parrot Drone (http://ardrone.parrot.com/parrot-ar-drone/usa/) | - | - | X | X | - | X | -
Dragan Flyer VI (http://www.draganfly.com/uav-helicopter/draganflyer-x6/index.php) | X | X | - | X | X | X | X

Capability
System
ICARUS ver 2 (http://www.icarusuav.com/) | X | X | X | X | X | X | - | F | F | F | F | F | F | F | F | F | F | F | F
ICARUS ver 1 | - | X | X | X | X | X | - | - | F | F | F | F | F | F | F | F | F | F | -
ArduCopter (http://code.google.com/p/arducopter/) | - | X | X | X | - | - | - | - | - | - | - | X | - | X | - | - | - | - | -
AR Parrot Drone (http://ardrone.parrot.com/parrot-ar-drone/usa/) | - | - | - | X | - | - | - | - | - | - | - | - | - | - | - | X | - | - | -
Dragan Flyer VI (http://www.draganfly.com/uav-helicopter/draganflyer-x6/index.php) | - | X | - | X | - | X | X | X | X | - | X | - | - | - | - | X | - | - | -

Advanced Hover

Automatic

Takeoff/Hover/Landing

Autonomous Navigation

Manual Control

Calibration via Test-Stand
Vehicle Health System

Collapsible Frame

Configurable Payloads

Extended Range

Extended Flight Duration

Image Capture

Obstacle Avoidance
Swarm Autonomy
Terrain Following

Audible Vehicle Status
Video Transmission

WiFi Repeater

Wireless Airborne

Programming

Wireless Charging other

Systems

Technology CoAxial Rotors

Command/Control Network Monitoring

Invertial Navigation Unit
Power Management

Primary/Secondary Controller Implementation

Rotatable Pylons

Waypoint Navigation
3D Feedback

Automatic Landing Pad

System
ICARUS ver 2 (http://www.icarusuav.com/) | X | X | X | X | X | X | X | F | F
ICARUS ver 1 | - | X | X | X | X | - | X | F | F
ArduCopter (http://code.google.com/p/arducopter/) | - | - | X | X | - | - | X | - | -
AR Parrot Drone (http://ardrone.parrot.com/parrot-ar-drone/usa/) | - | - | - | - | - | - | - | - | -
Dragan Flyer VI (http://www.draganfly.com/uav-helicopter/draganflyer-x6/index.php) | X | X | X | - | - | - | - | - | -

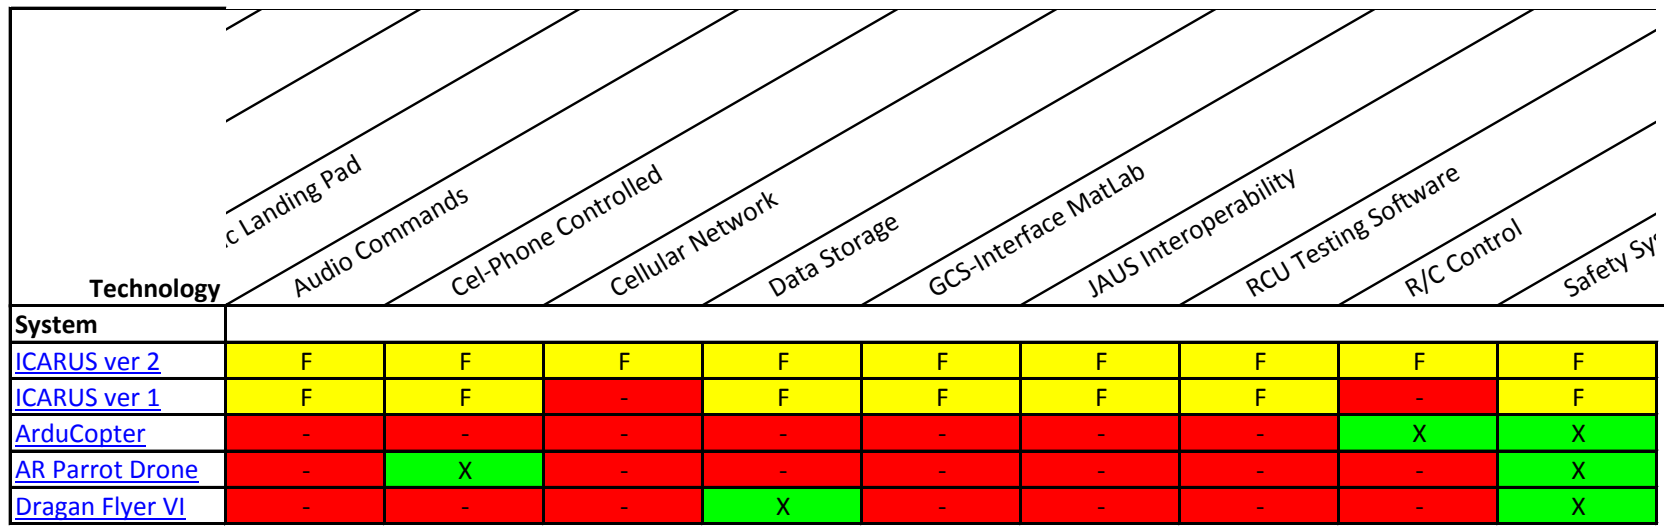
[picture p93: figure]
Technology System; ICARUS ver 2 (http://www.icarusuav.com/); ICARUS ver 1; ArduCopter (http://code.google.com/p/arducopter/); AR Parrot Drone (http://ardrone.parrot.com/parrot-ar-drone/usa/); Dragan Flyer VI (http://www.draganfly.com/uav-helicopter/draganflyer-x6/index.php); Audio Commands; Cel-Phone Controlled Cellular Network Data Storage; GCS-Interface MatLab JAUS Interoperability; RCU Testing Software; R/C Control; Safety System

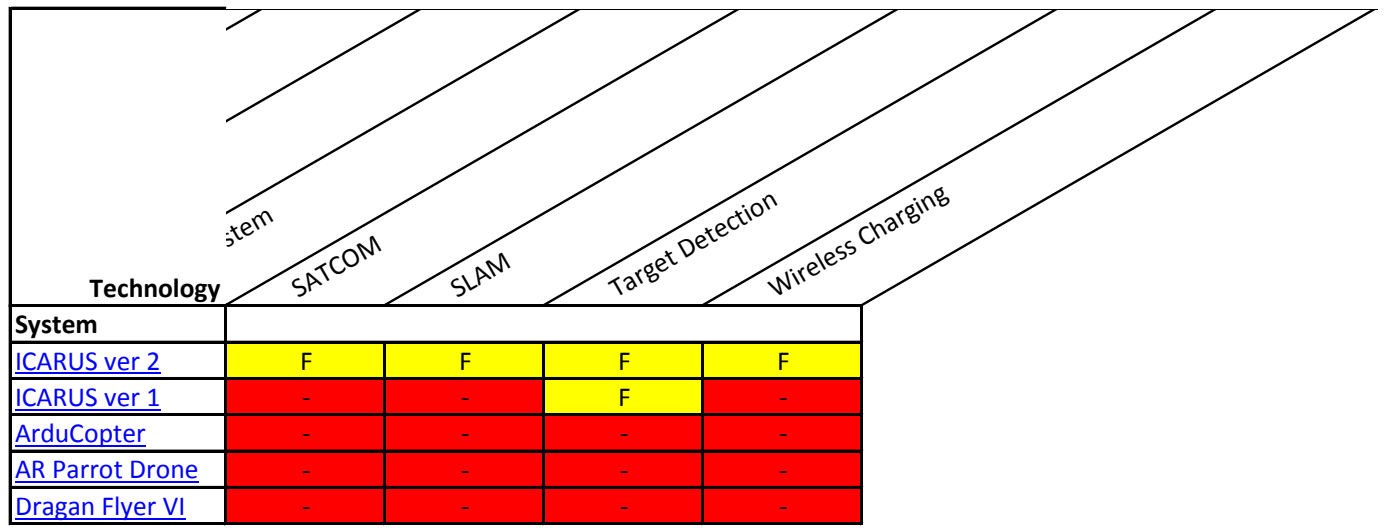
[picture p94: figure]
Technology System; ICARUS ver 2 (http://www.icarusuav.com/); ICARUS ver 1; ArduCopter (http://code.google.com/p/arducopter/); AR Parrot Drone (http://ardrone.parrot.com/parrot-ar-drone/usa/); Dragan Flyer VI (http://www.draganfly.com/uav-helicopter/draganflyer-x6/index.php); SATCOM; SLAM; Target Detection; Wireless Charging
