mwelling/robot-chopper/Marketing/TechnicalPresentation.pdf

# Technical Overview (http://www.google.com/imgres?h=561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)

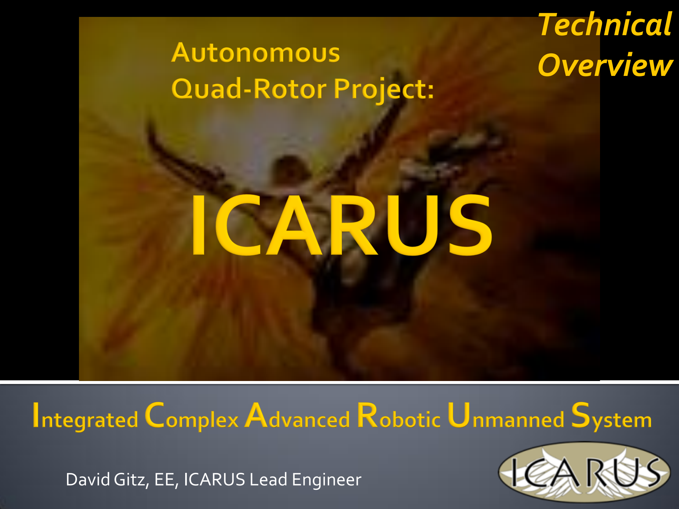
[picture p95: page 1]

## David Gitz, EE, ICARUS Lead Engineer


# - System Description - Capabilities and Technologies - System Specifications

- Q&A

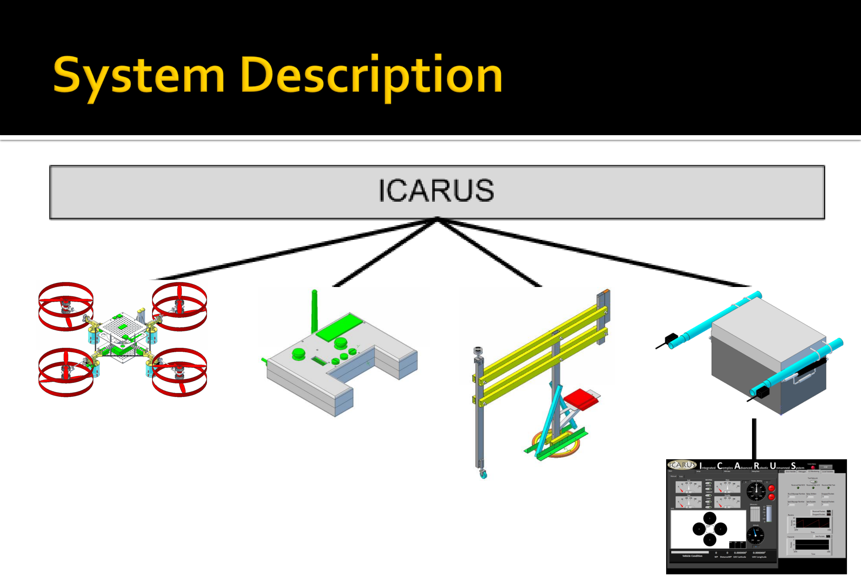
[picture p96: page 3]

# Vehicle (http://dgitz.ipower.com/projects/robochopper/Media/Vehicle/VehicleAssy.pdf)

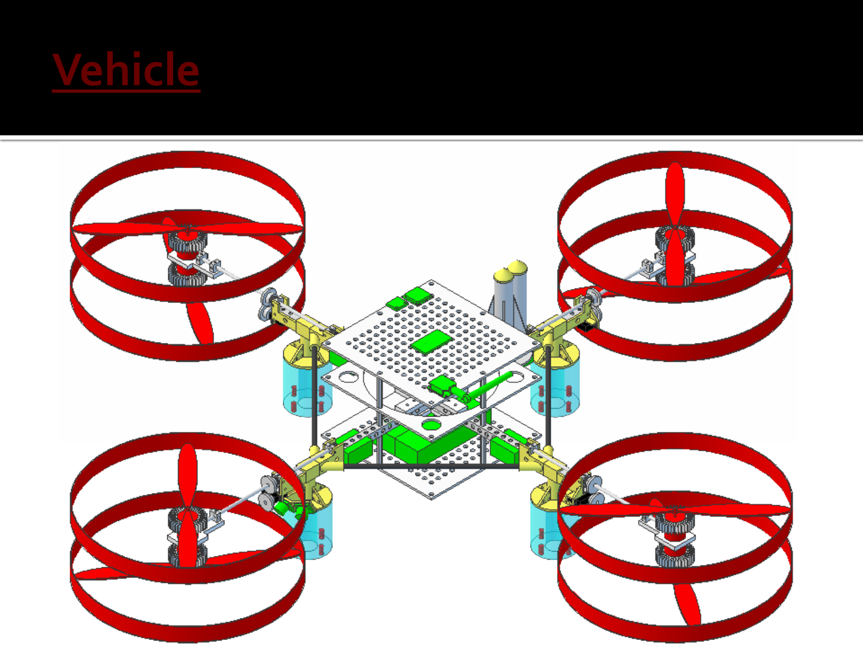
[picture p97: page 4]

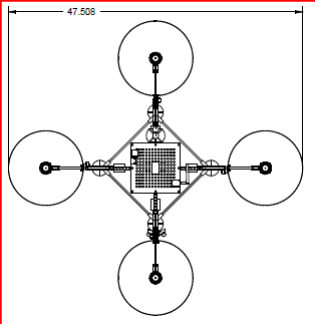
[picture p98: figure]

# - Quad-Rotor design – Offers simpler control system with fewer moving parts than a single rotor helicopter and minor reduction in lift capacity


# - 2 “Brains”, 1 SoM Board and 1 Parallax PropellerTM uC - SoM handles waypoint

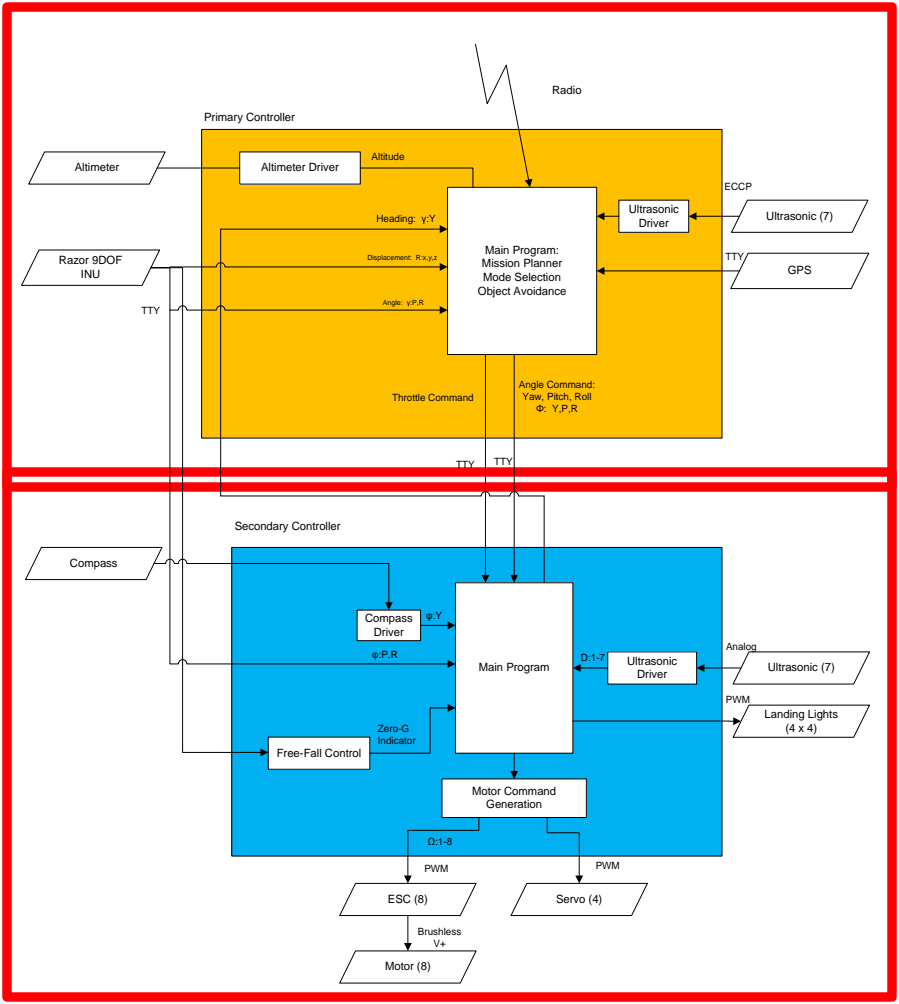
[picture p99: figure]
Primary Controller; Secondary Controller; Main Program; Motor Command Generation ESC (8) Ω:1-8; Motor (8); Ultrasonic (7); TTY; Analog; PWM; Brushless V+; Radio; TTY Altimeter; Altimeter Driver; Altitude; Compass; Compass Driver; Free-Fall Control; Ultrasonic Driver D:1-7 φ:Y φ:P,R; Zero-G Indicator; Ultrasonic (7) Ultrasonic Driver; ECCP Razor 9DOF INU; Servo (4); Landing Lights (4 x 4) PWM

navigation, mission planning, vehicle health.

# - PropellerTM uC handles PWM

generation.

# - In the event of an in-air mishap, PropellerTM uC can take over Vehicle and land

safely.

Main Program: Mission Planner Mode Selection Object Avoidance | GPS
Throttle Command | Angle Command: Yaw, Pitch, Roll Φ: Y,P,R

Heading: γ:Y Displacement: R:x,y,z Angle: γ:P,R


# - Sensors: 3-Axis Accelerometer, 3-Axis Gyroscope, 3-Axis Magnetometer (INU), Digital Compass, Altimeter, GPS, 7 Ultrasonic Sensors

- Power: 8 Brushless DC 200 Watt Motors, 4 Micro Servo’s,

# 2 Lithium-Ion 11.1V 5 Amp-Hours Batteries, 4 18A Electronic

Speed Controllers, 5V and 3.3V Linear Voltage Regulators.

# - Control: SoM Controller (Primary), Propeller Controller

(Secondary), custom PCB.

# - Communications: Xbee Radio for Command/Control, Video

Transmitter, Wi-Fi (Field programming, tentative).

# - Fabrication: ~50% COTS, ~50% produced by

MakerBot/Ponoku.

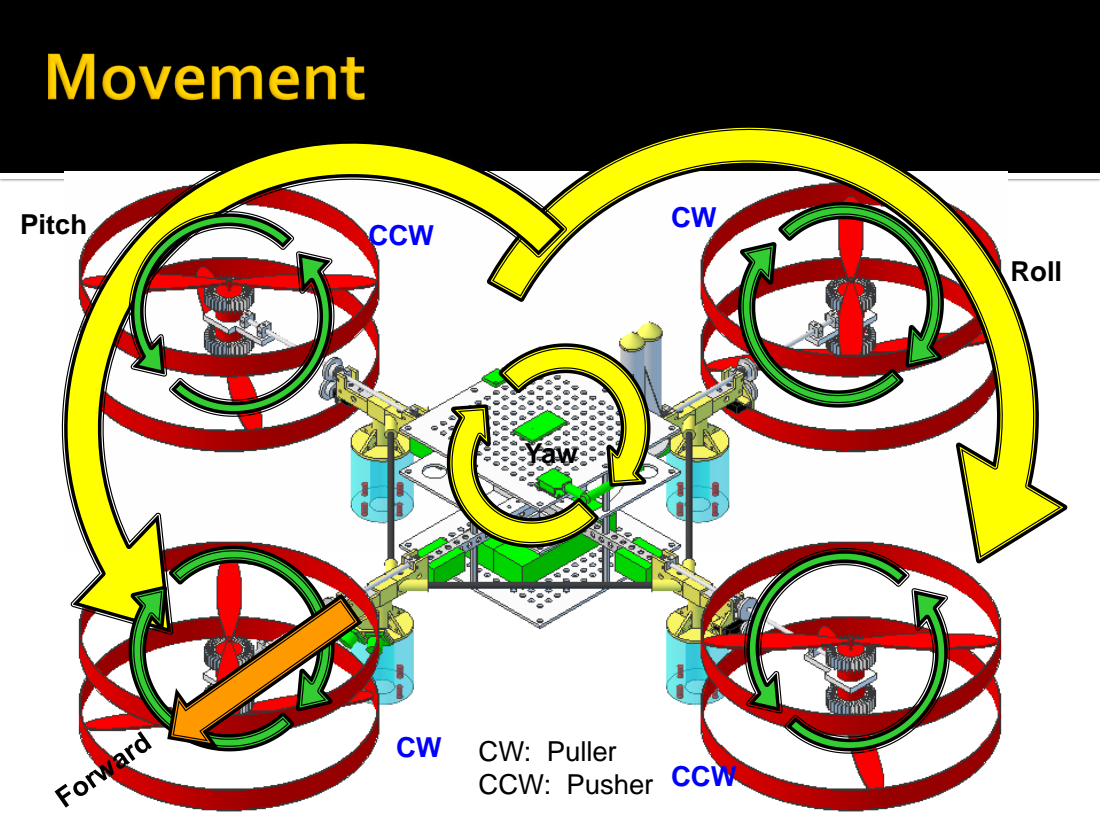
[picture p100: page 8]
Yaw; Pitch; Roll; CW: Puller CCW: Pusher; CCW

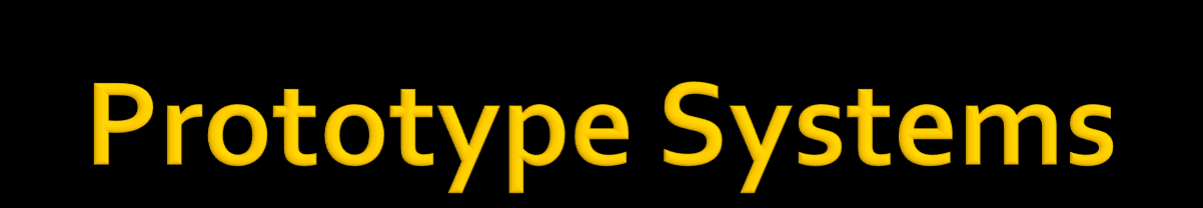
[picture p101: figure]
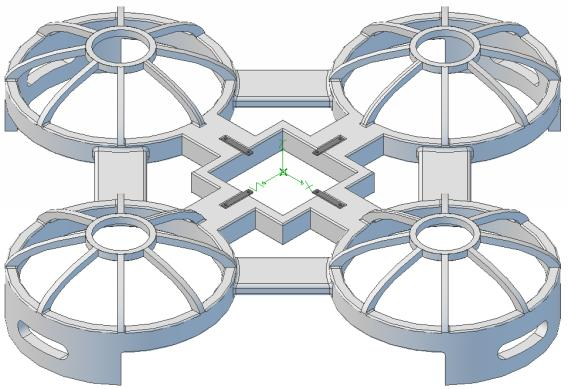
[picture p102: figure]
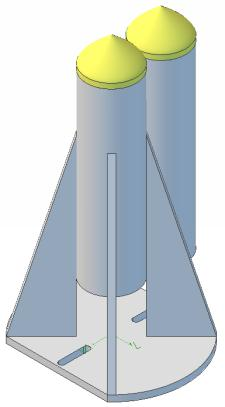
[picture p103: figure]

Safety System | Recovery System

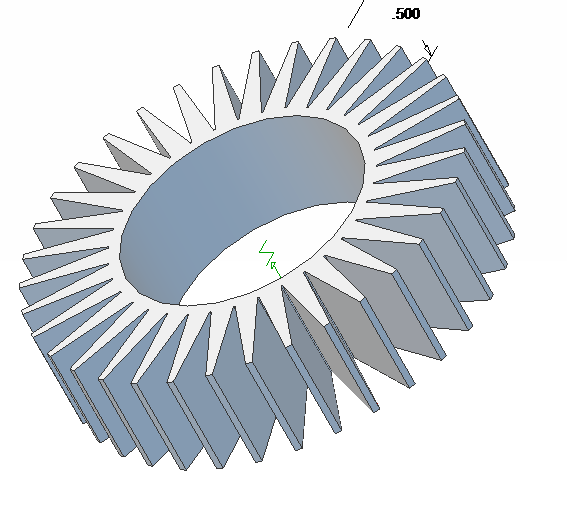
[picture p104: figure]
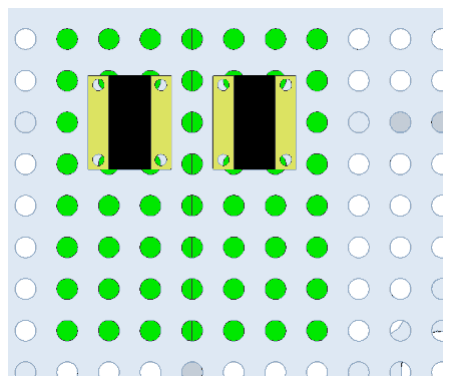
[picture p105: figure]

Heat Removal System | Test-Fixture Attachment System

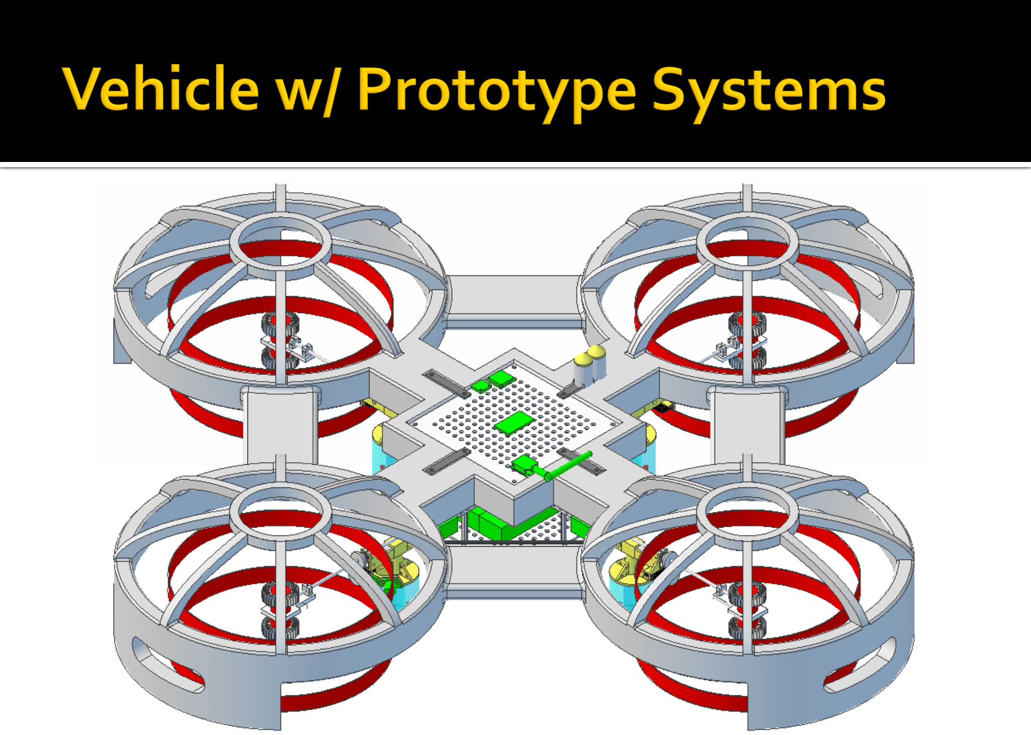
[picture p106: page 10]

# - Custom PCB inside


# Xbox-360 Controller - Features Mode and Error Display, Vehicle

Battery Indicator,

# Force-Feedback and 5 hours of continuous

operation.



# - Communications: XBee Radio for Command/Control - Input/Output: 9 Switches/Buttons, 2 Dual-

Axis Joysticks, GPS Sensor, 10-Segment LED, LCD Screen, Vibrating Motors.

# - Power: 2 Ni-Mh AA Batteries, 3.3 and 5V

Boost Converters.


- Includes computer,

# touch-screen monitor and batteries for field

operation.

# - Communications Radio and Video Receiver - Heavy-duty field transportable case

# GCS (http://dgitz.ipower.com/projects/robochopper/Media/GCS-Case/CaseOpen.pdf)

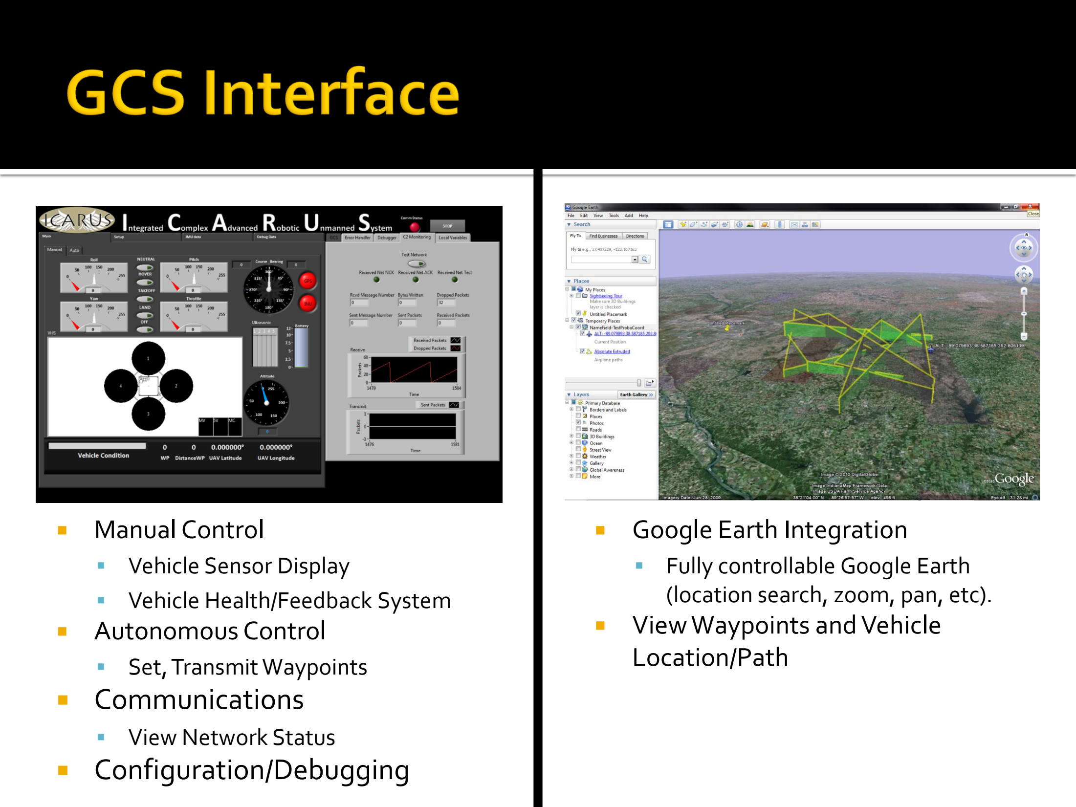
[picture p107: page 14]

### - Manual Control

- Vehicle Sensor Display
- Vehicle Health/Feedback System

### - Autonomous Control

- Set, Transmit Waypoints

## - Communications

- View Network Status

## - Configuration/Debugging

### - Google Earth Integration

- Fully controllable Google Earth (location search, zoom, pan, etc).

### - View Waypoints and Vehicle Location/Path


# - Software: National Instruments LabView integrated with Google Earth mapping

software.

# - Power: 2 12V 26Amp-Hour Batteries, 120V AC Power Inverter, Vehicle battery fast

charger.

# - Communications: XBee Radio for Command/Control, Video Receiver

Test (http://dgitz.ipower.com/projects/robochopper/Media/Test-Stand/TestStandAssy.pdf)- (http://dgitz.ipower.com/projects/robochopper/Media/Test-Stand/TestStandAssy.pdf)Stand (http://dgitz.ipower.com/projects/robochopper/Media/Test-Stand/TestStandAssy.pdf)

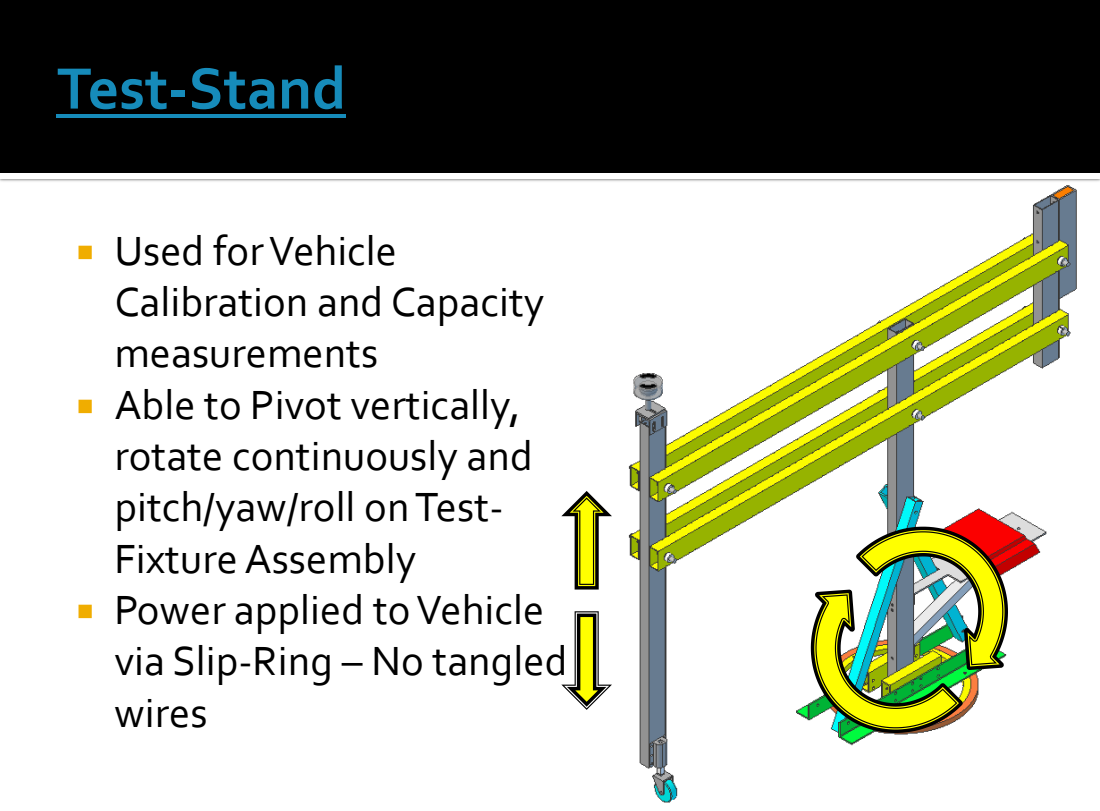
[picture p108: page 16]

Used for Vehicle
Calibration and Capacity
measurements
Able to Pivot vertically,
rotate continuously and
pitch/yaw/roll on Test-
Fixture Assembly
Power applied to Vehicle
via Slip-Ring – No tangled
wires

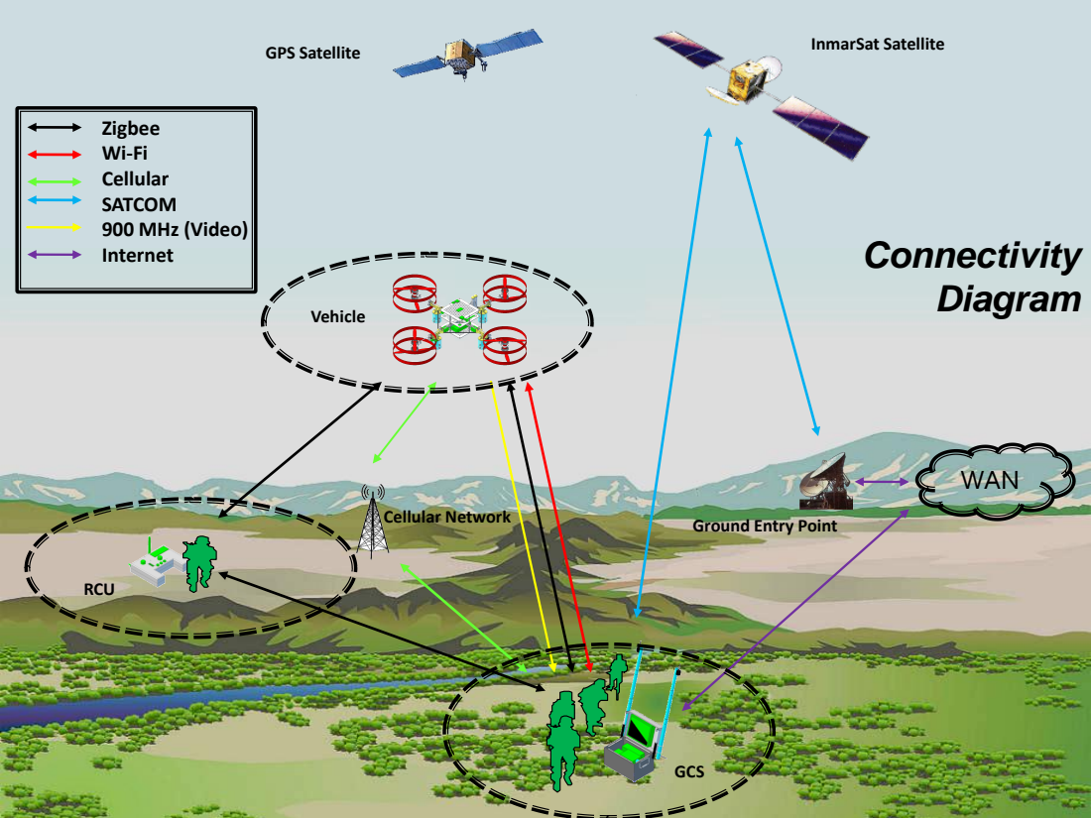
[picture p109: page 17]
GCS; RCU; Vehicle; Cellular Network; GPS Satellite; Zigbee Wi-Fi Cellular SATCOM 900 MHz (Video) Internet; InmarSat Satellite; WAN; Connectivity Diagram

Ground Entry Point

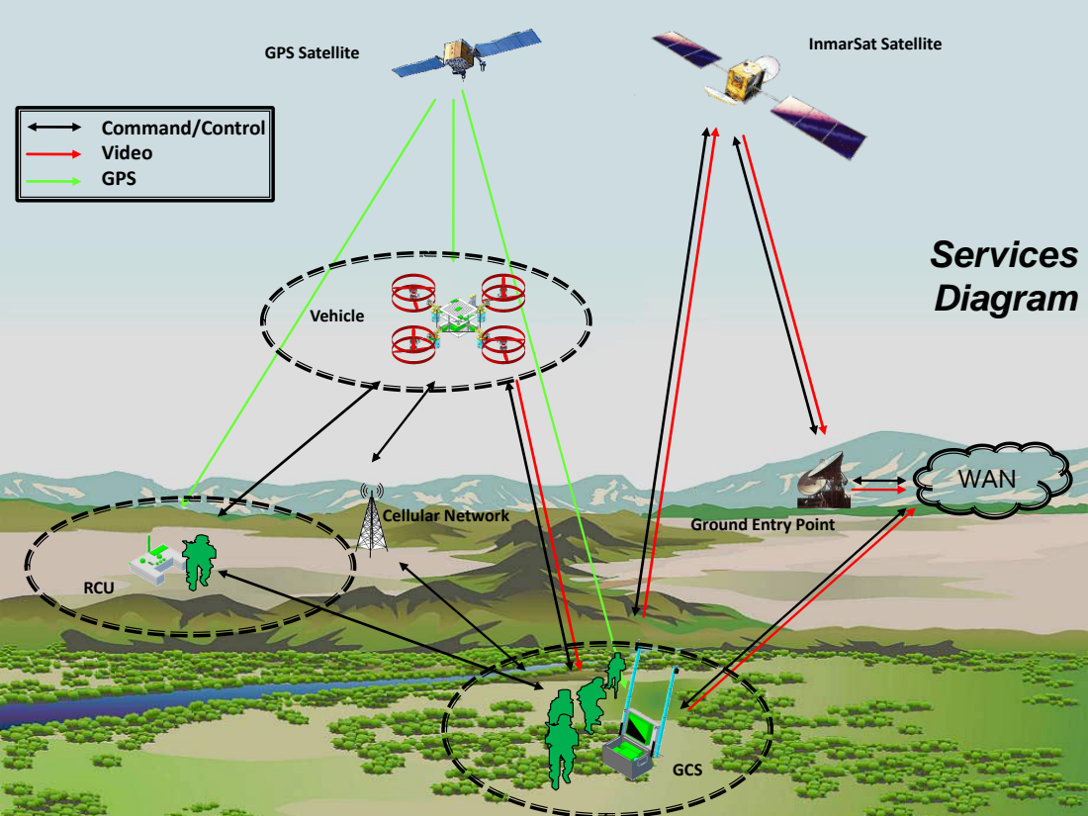
[picture p110: page 18]
GCS; RCU; Vehicle; Cellular Network; GPS Satellite; Command/Control Video GPS; InmarSat Satellite; WAN; Services Diagram

Ground Entry Point


### Capabilities - Planned

ManualControl via RCU or GCS | Simple Calibration and Testing via Test-Stand
Limited Autonomous Navigation via RCU | Error Display on RCU and GCS
Extended Autonomous Navigation viaGCS | Force-Feedback on RCU
Automatic Takeoff, Hover and Landing | Vehicle Health Reporting

### Capabilities - Future

Real-TimeVideo Transmission to GCS | Image Capture
Wireless airborne programming | Advanced Hover modes
Vehicle Status Audio via RCU | Extended Range
Configurable Payloads | Terrain Following
Extended Flight Duration | Obstacle Avoidance
Swarm Autonomy | Vehicle Status -Audio


### Technologies - Planned

Command/Control Network Monitoring | Inertial Navigation Unit (INU) w/ Altitude and Heading Reference System (AHRS)
Power Management | Primary/Secondary Controller Implementation
Waypoint Navigation | Communications Protocol
Co-Axial Rotors | Tilt Rotors

### Technologies - Future

3d Feedback | Audio Commands
Automatic Landing Pad | Cellular Network
Cel-Phone Control | Target Detection
Data Storage | GCS Interface (MATLAB)
JAUS Interoperability | Motor Heat Dissipation
R/C Control | RCU Testing Software
Recovery System | Wireless Charging
Satellite Communications | Simultaneous Localization and Mapping (SLAM)


# - Range: ~1.5 km LOS (~3km with Xbee Mesh Network) - Duration:

# - Vehicle: ~12 min (100% Throttle) , ~20 min ( Hover) - RCU: ~4-6 hrs - GCS: ~4-6 hrs (including field charging Vehicle)

# - Speed: ~2 - 4 kph - Weight: ~5.5 lbs - Size: 48” x 48” x 10.5” - Propeller Rotation: Max: 3,000 RPM - Vertical Thrust: ~7.8 lbs

# - Contact:


# - David Gitz: david.gitz@icarusuav.com - Ben Wasson: ben.wasson@icarusuav.com
