mwelling/robot-chopper/Documentation/SystemDiagram.pdf

## ICARUS

Vehicle

Remote
Control Unit
(RCU)

Test-Stand

Ground
Control
System (GCS)

GCS –
Interface
(GCSI)
