mwelling/robot-chopper/Marketing/Flyer.pdf

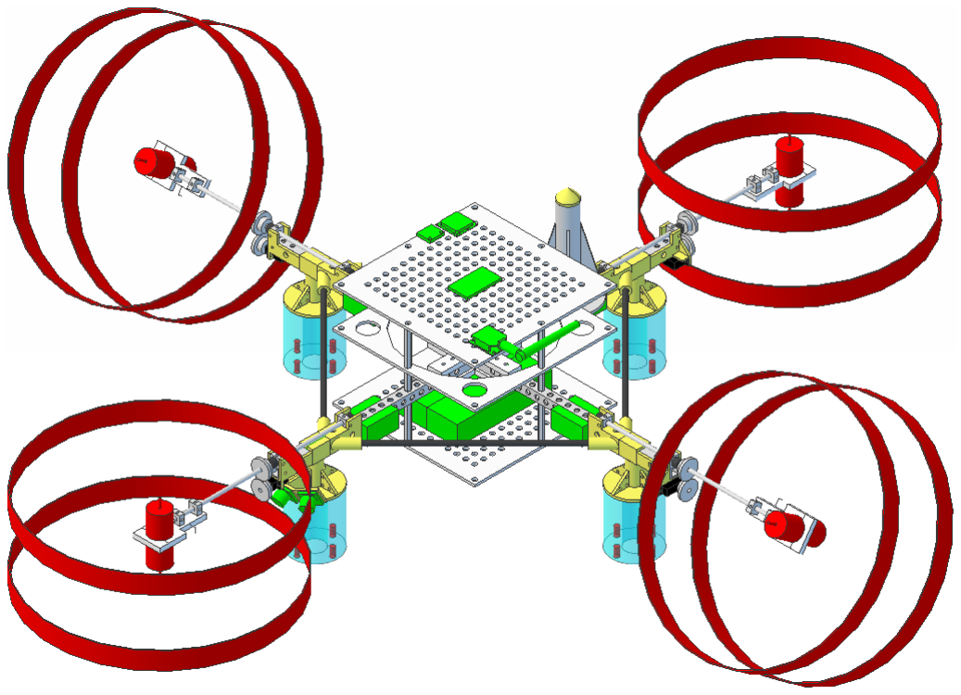
[picture p111: figure]
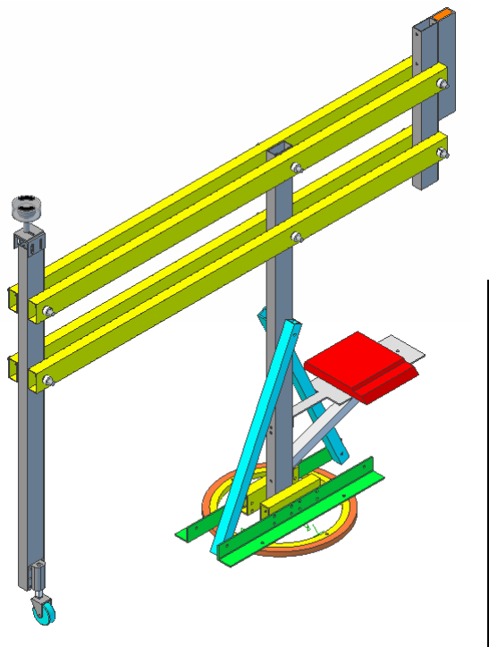
[picture p112: figure]
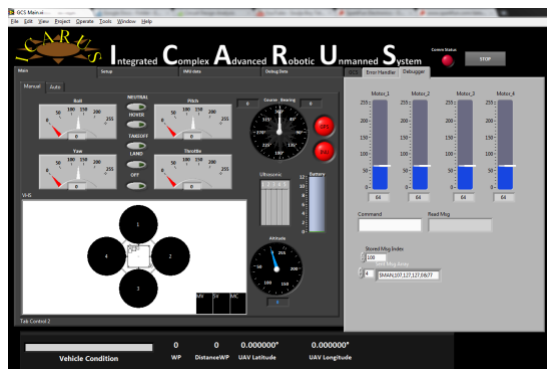
[picture p113: figure]

Industry | Applications
Home Inspecting | Roof and Exterior Surveying
Civil Engineering | Bridge Inspection
Law Enforcement | Search, Crime Scene Investigation
Military | Reconnaissance

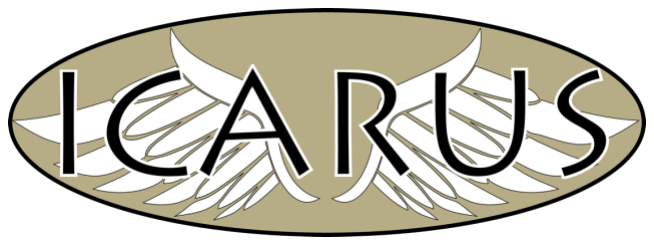
[picture p114: figure]

Hobbyists | Development Platform – Completely Open Source
Environmental | Nature Surveying and Data Collection

## Capabilities

Manual Control via RCU or GCS | 3km Range and 30 min duration
Limited Autonomous Navigation via RCU | Error Display on RCU and GCS
Waypoint Navigation | Force-Feedback on RCU
Automatic Takeoff, Hover and Landing | Terrain Following

## Autonomous Quad⁻Rotor Project

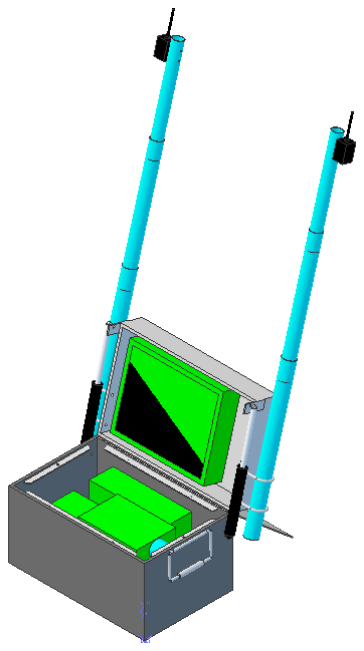
[picture p115: figure]

### Lead Engineer: David Gitz davidgitz@gmail.com www.dgitz.ipower.com

ICARUS

Vehicle | Remote Control Unit (RCU) | Test-Stand | Ground Control System (GCS)

Interface

# ICARUS

# Integrated Complex Advanced Robotic Unmanned System
