mwelling/robot-chopper/Vehicle/Documentation/Diagram.pdf

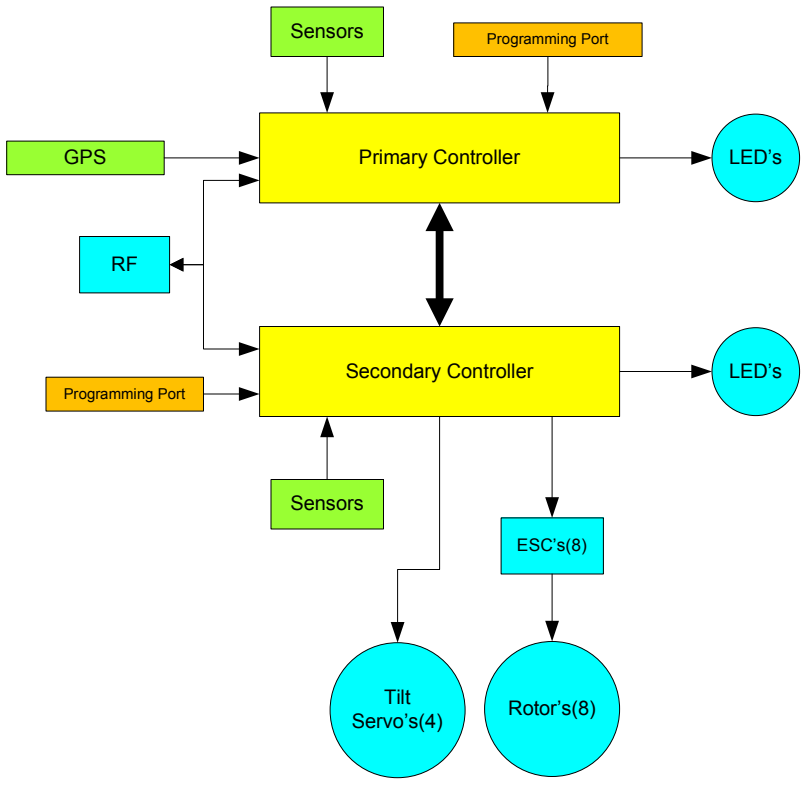
[picture p116: figure]
Sensors; GPS; Primary Controller; LED’s; ESC’s(8); Programming Port; Secondary Controller; Rotor’s(8) Tilt Servo’s(4)
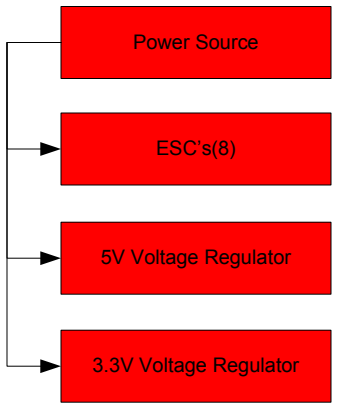
[picture p117: figure]
Power Source; 5V Voltage Regulator; 3.3V Voltage Regulator; ESC’s(8)

# Power

# Sensors

# Program

# Control

# Input/Output

# Legend

### EC3 Harness Parallel

### Main PCB

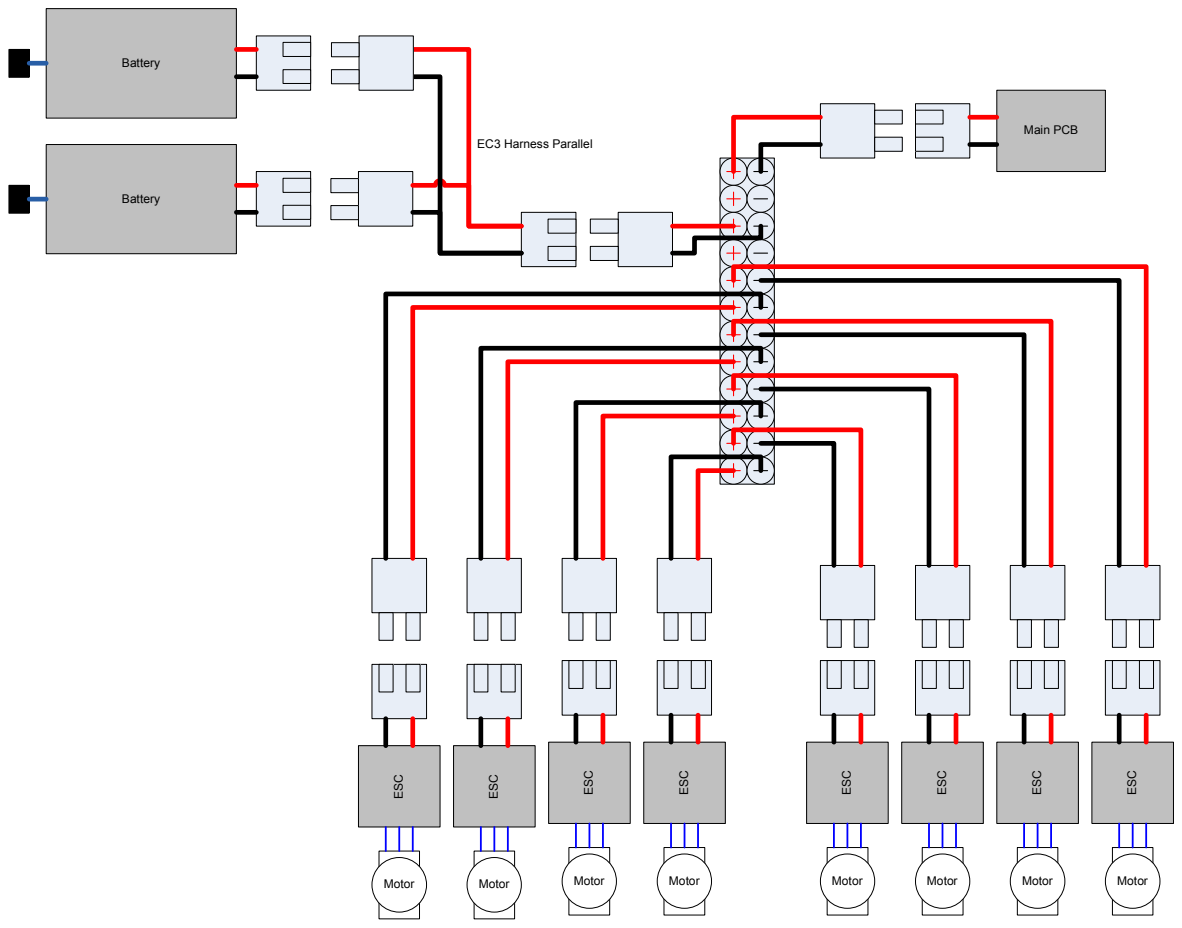
[picture p118: page 2]
ESC; Motor; Battery

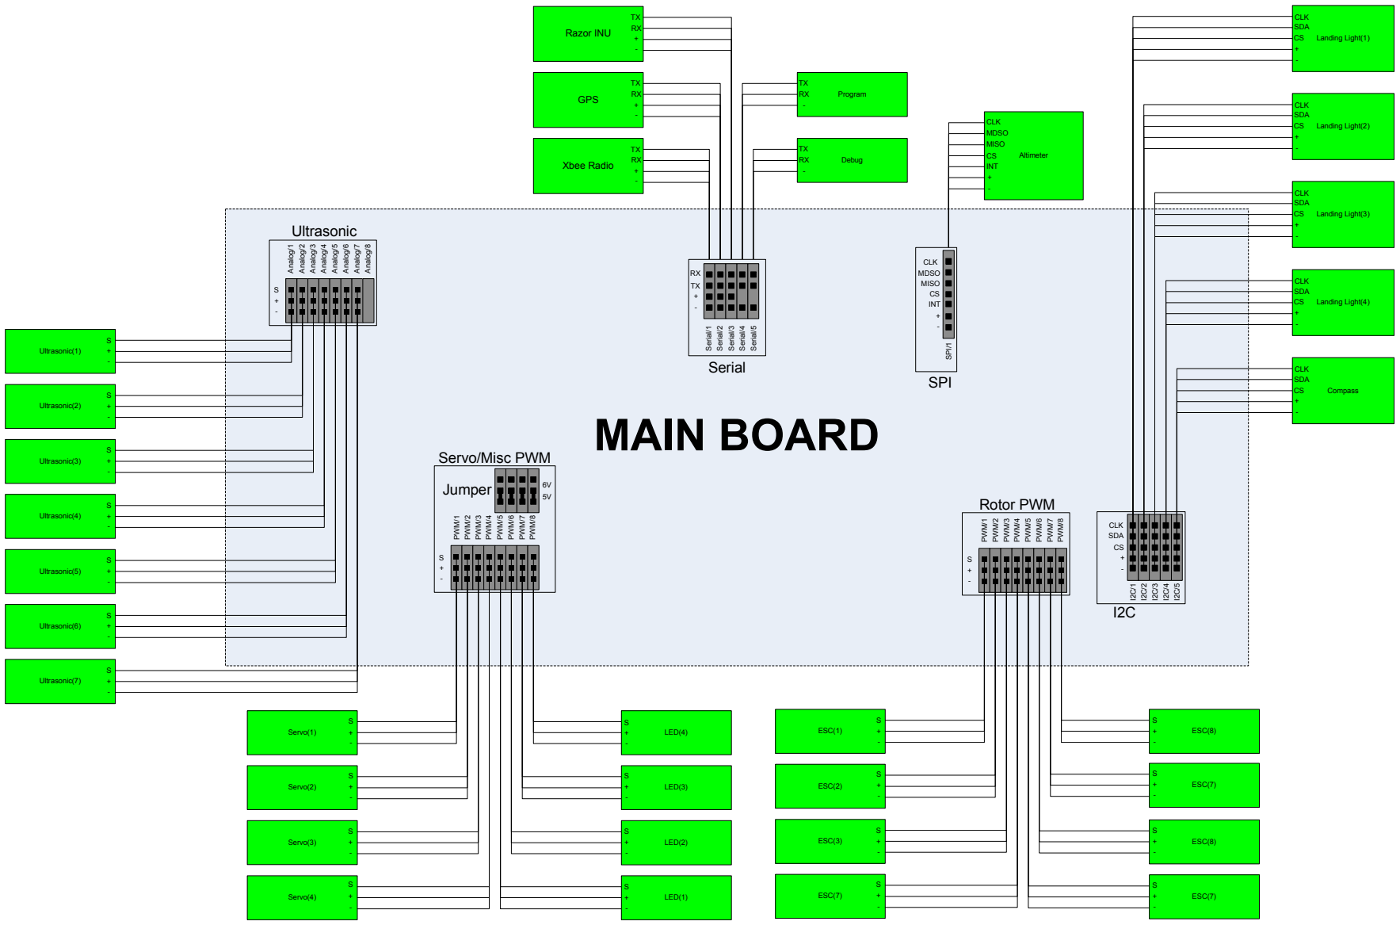
[picture p119: figure]
MAIN BOARD; Ultrasonic; Analog/1; Analog/2; Analog/3; Analog/4; Analog/5; Analog/6; Analog/7; Analog/8; Rotor PWM; PWM/1; PWM/2; PWM/3; PWM/4; PWM/5; PWM/6; PWM/7; PWM/8; Servo/Misc PWM; 6V 5V Jumper; ESC(8); GPS; Razor INU; Debug - TX; Program - TX; Altimeter; +-INT; MISO; MDSO; CLK; Serial/1; Serial/2; Serial/3; Serial/4; Serial/5; Serial; SDA; Landing Light(1); Landing Light(2); Landing Light(3); Landing Light(4); Compass; SPI/1; SPI ⁻ INT

+- | ESC(7) S+- | ESC(8) S+- | ESC(7) S+- ESC(1)
+- ESC(2) | S+- ESC(3) | S+- ESC(7) | S+- LED(4)
+- | LED(3) S+- | LED(2) S+- | LED(1) S+- Servo(1)
+- Servo(2) | S+- Servo(3) | S+- Servo(4) | S+- Ultrasonic(1)
+- Ultrasonic(2) | S+- Ultrasonic(3) | S+- Ultrasonic(4) | S+- Ultrasonic(5) | S+- Ultrasonic(6) | S+- Ultrasonic(7) | S+- | Xbee Radio | RX+- TX
