mwelling/robot-chopper/Vehicle/Documentation/ControlSystem.pdf

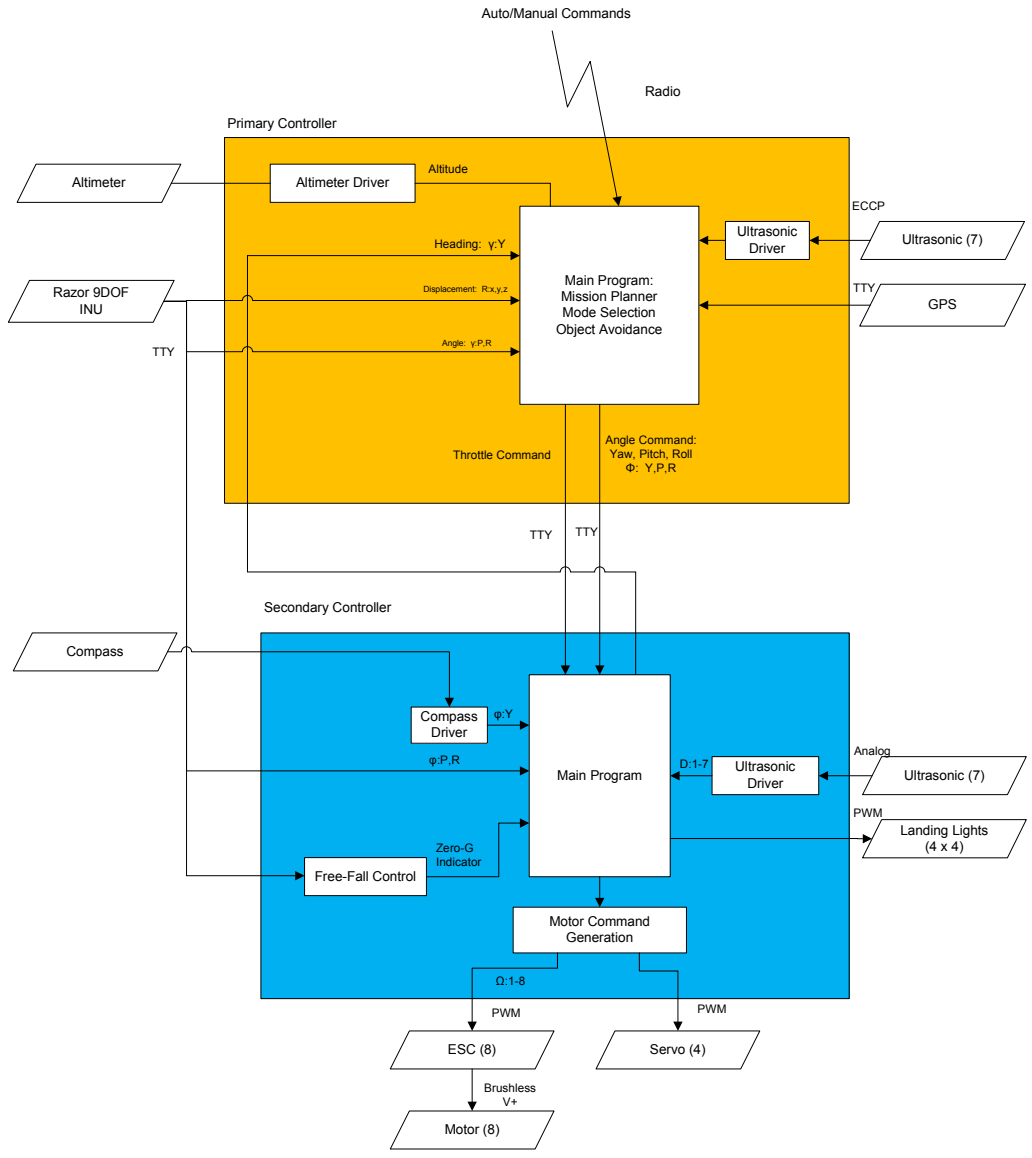
[picture p120: page 1]
Primary Controller; Main Program: Mission Planner Mode Selection Object Avoidance; GPS; Secondary Controller; Main Program; Motor Command Generation; ESC (8); Motor (8); Throttle Command; Ultrasonic (7); TTY; Analog; Brushless V+; Radio; Altimeter; Altimeter Driver; Heading: γ:Y; Displacement: R:x,y,z; Angle: γ:P,R; Altitude; Compass; Compass Driver; Ultrasonic Driver; Zero-G Indicator; Ultrasonic (7) Ultrasonic Driver; ECCP; Razor 9DOF INU; Servo (4); PWM; Landing Lights (4 x 4)

Auto/Manual Commands

Angle Command:
Yaw, Pitch, Roll

Free-Fall Control

PWM

# UPDATE!!!

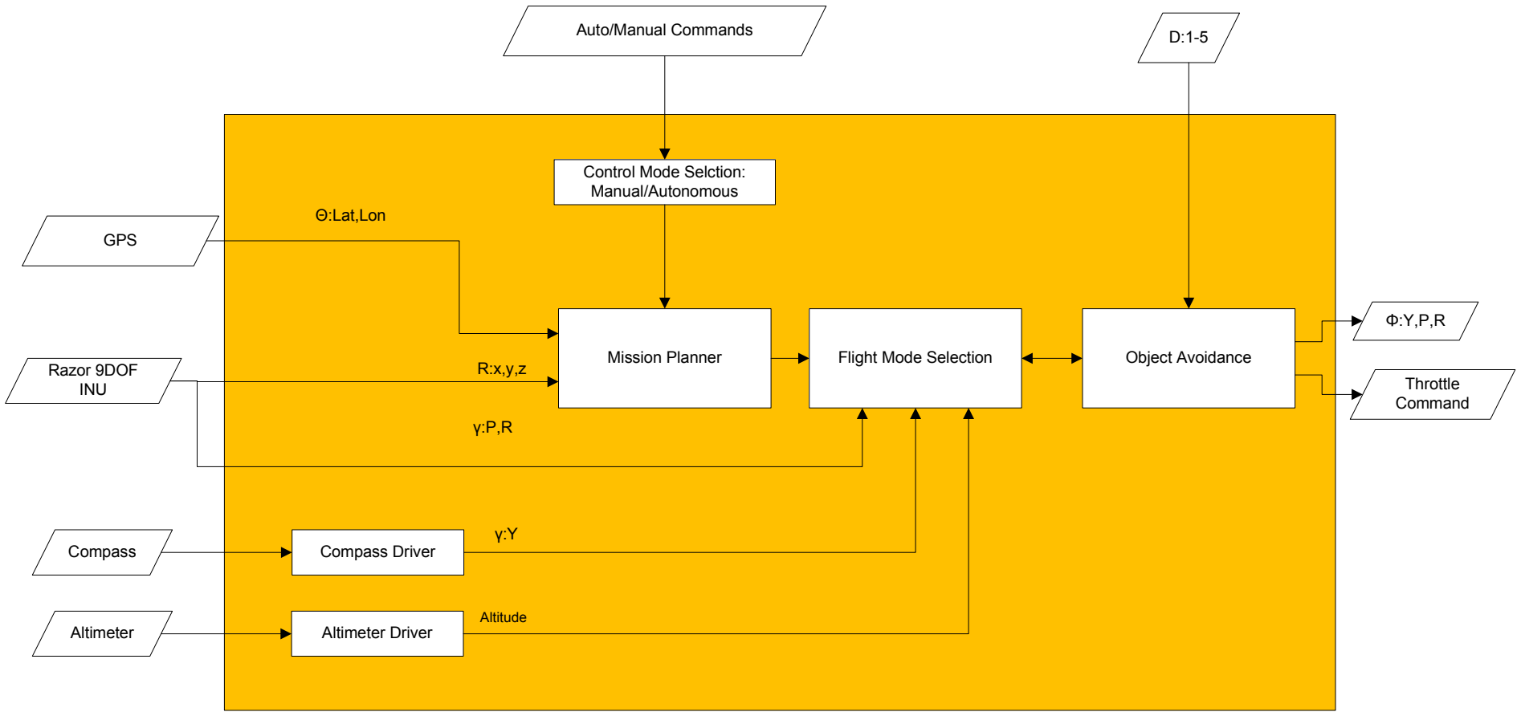
[picture p121: figure]
Compass; Compass Driver; Razor 9DOF INU; GPS; Altimeter; Altimeter Driver; Altitude; Mission Planner; Control Mode Selction: Manual/Autonomous; Flight Mode Selection; Object Avoidance; Throttle Command; Θ:Lat,Lon; Auto/Manual Commands

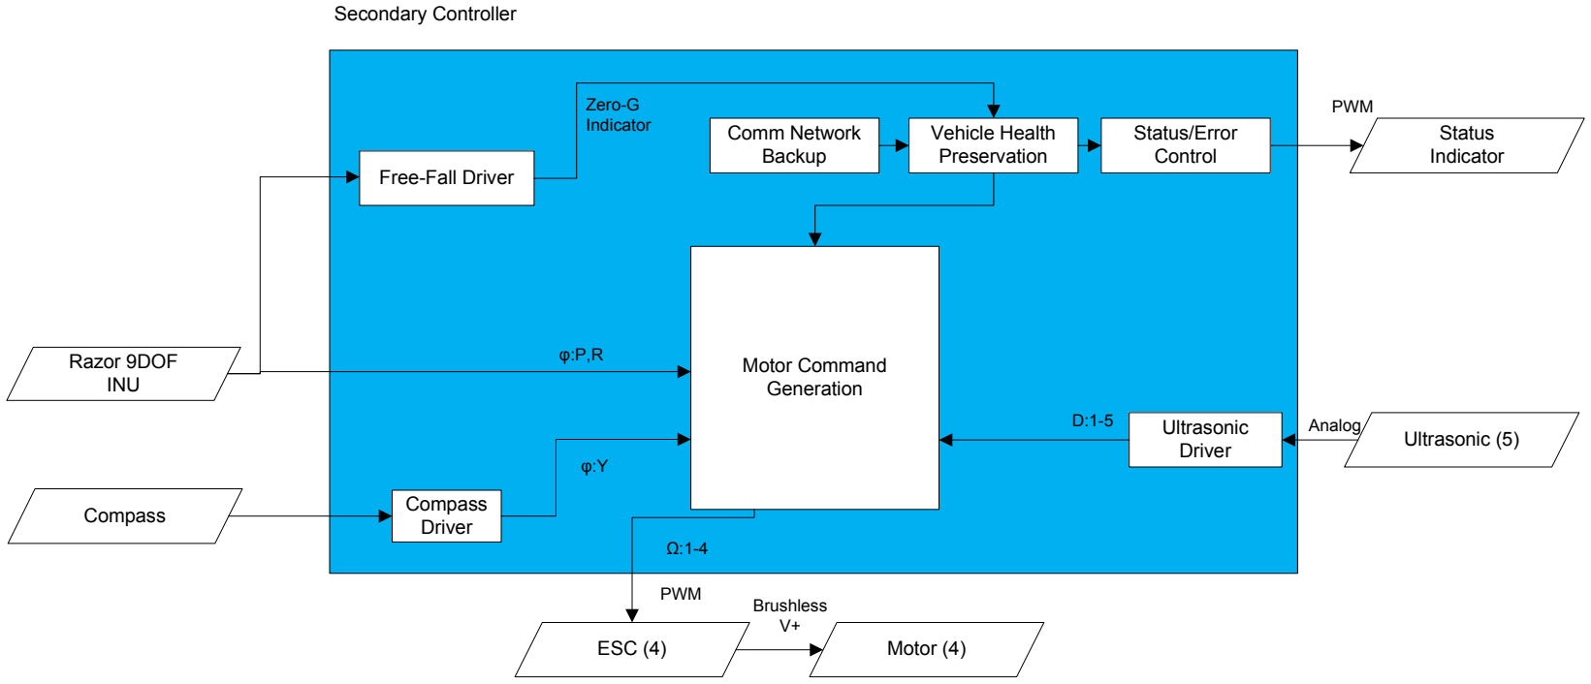
[picture p122: figure]
Secondary Controller; Motor Command Generation; ESC (4); Motor (4); Status Indicator; Ultrasonic (5); PWM; Analog; Compass; Razor 9DOF INU; Compass Driver; Free-Fall Driver; Ultrasonic Driver; Zero-G; Indicator; Comm Network; Backup; Vehicle Health Preservation; Status/Error Control; Brushless V+

# UPDATE!!!

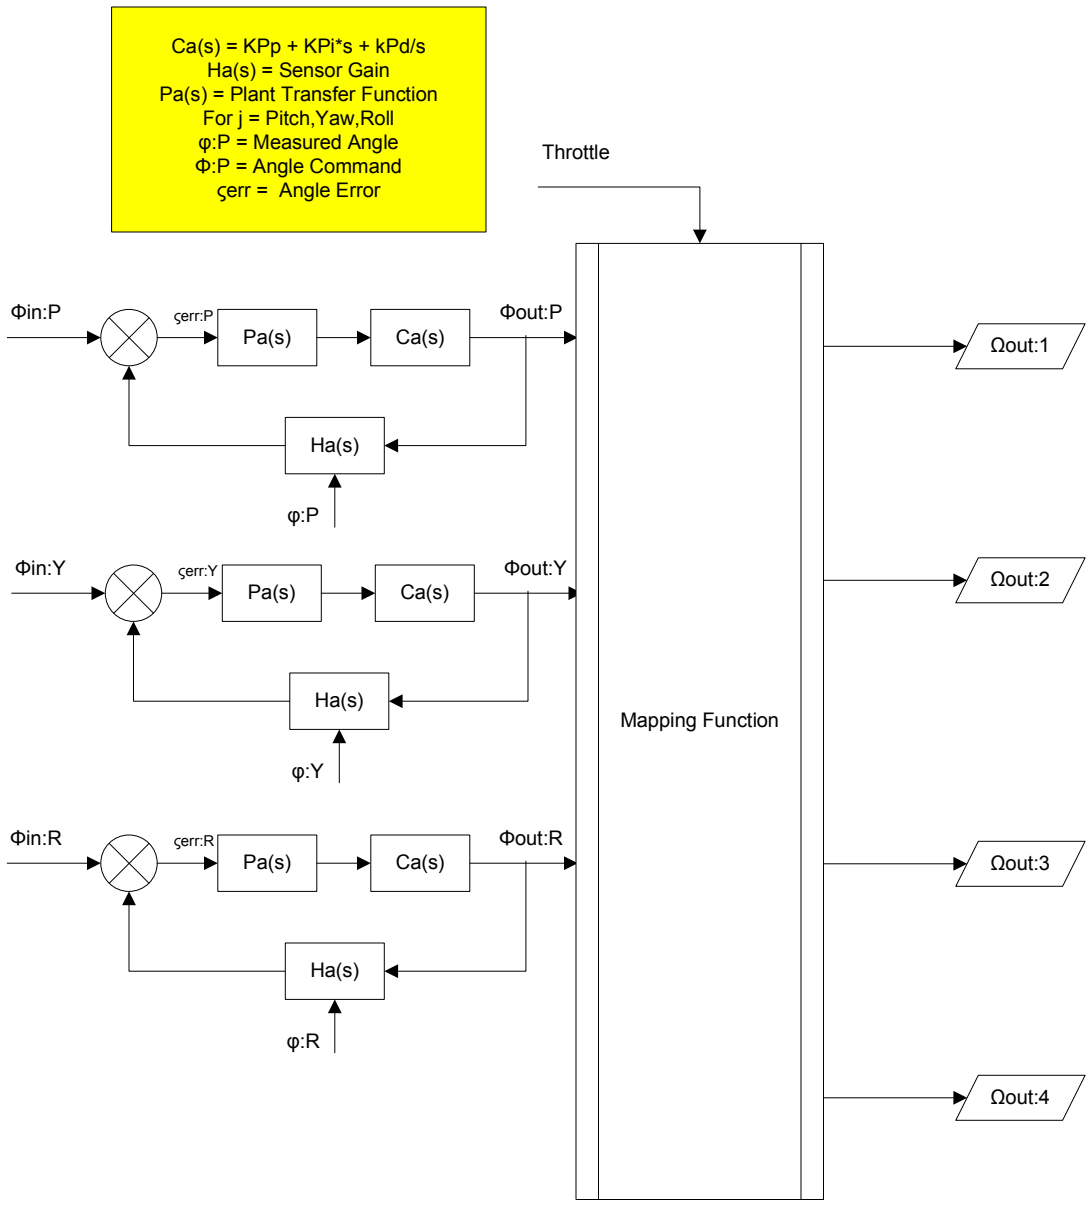
[picture p123: figure]
Ωout:1 Ca(s); Φin:P; Ca(s) = KPp + KPi*s + kPd/s Ha(s) = Sensor Gain Pa(s) = Plant Transfer Function For j = Pitch,Yaw,Roll φ:P = Measured Angle Φ:P = Angle Command ςerr = Angle Error; ςerr:P; Φout:P; Φin:Y; ςerr:Y; Φout:Y; Φin:R; ςerr:R; Φout:R; Ωout:2; Ωout:3; Ωout:4; Mapping Function; Throttle

Mapping Function:
Constants: MID_RANGE
Ωin:1 = Φout:P,Φout:Y,Φout:R,Throttle
