mwelling/robot-chopper/Project Management/PeopleOrgChart.pdf

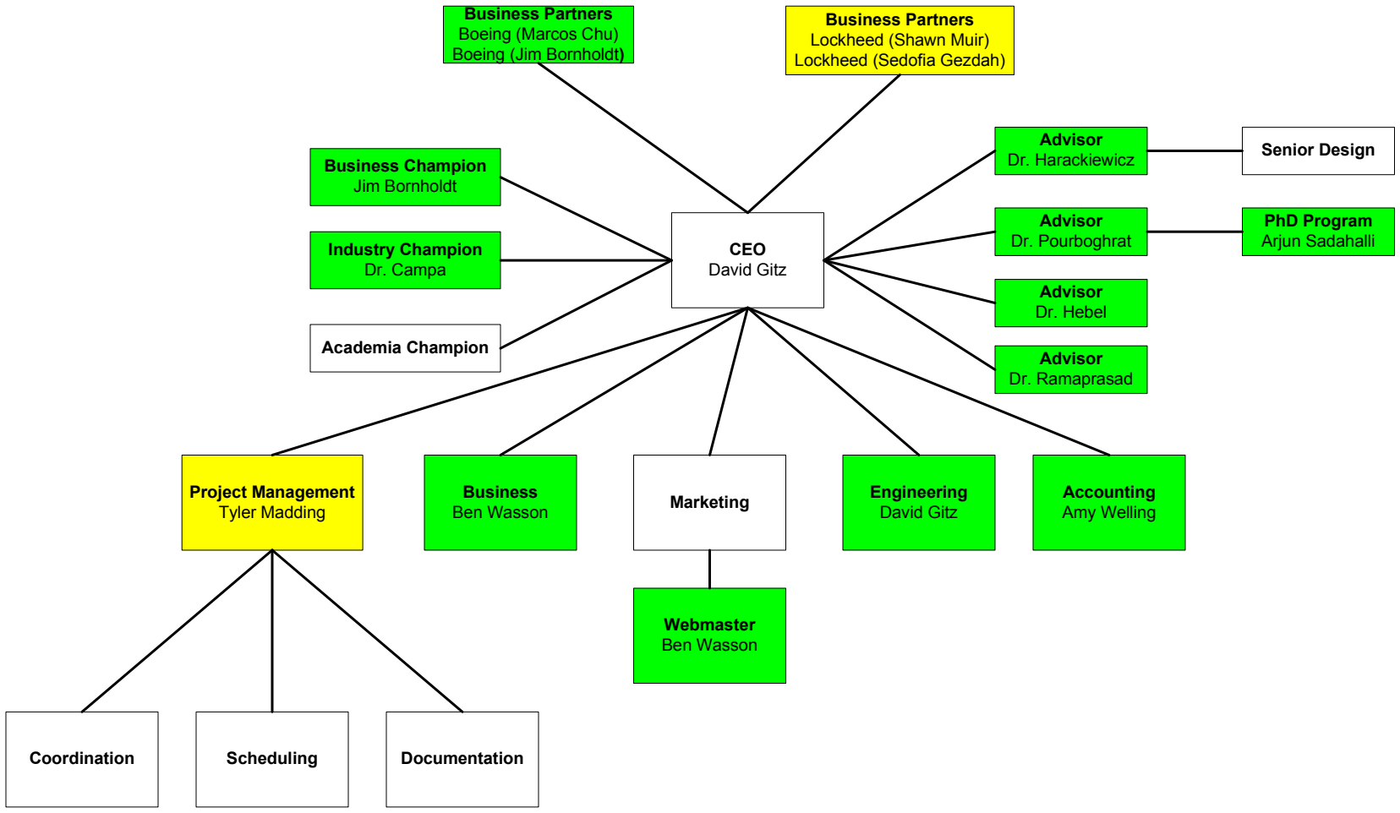
[picture p124: figure]
Engineering; CEO David Gitz; Advisor Dr. Hebel; Coordination; Scheduling; Documentation; Accounting Amy Welling; Industry Champion Dr. Campa; Business Ben Wasson; Academia Champion; Business Champion Jim Bornholdt; Advisor Dr. Pourboghrat; Advisor; Dr. Harackiewicz; Senior Design; PhD Program Arjun Sadahalli; Webmaster Ben Wasson; Advisor Dr. Ramaprasad; Business Partners Boeing (Marcos Chu) Boeing (Jim Bornholdt); Business Partners Lockheed (Shawn Muir) Lockheed (Sedofia Gezdah)

David Gitz Marketing Project Management Tyler Madding

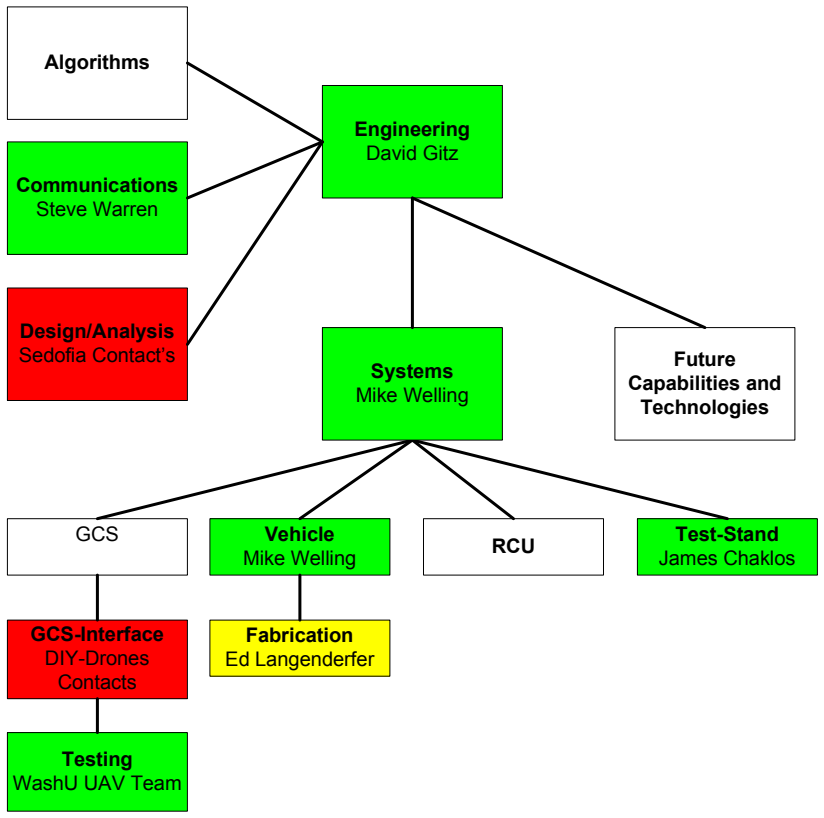
[picture p125: figure]
Engineering David Gitz; Vehicle; GCS-Interface DIY-Drones Contacts; Communications Steve Warren; Design/Analysis Sedofia Contact’s; Algorithms; Systems Mike Welling; Future Capabilities and Technologies; Fabrication Ed Langenderfer; Testing WashU UAV Team

Mike Welling | RCU GCS | Test-Stand James Chaklos
