mwelling/robot-chopper/DataSheets/Propellor/proprpmpcb.gif

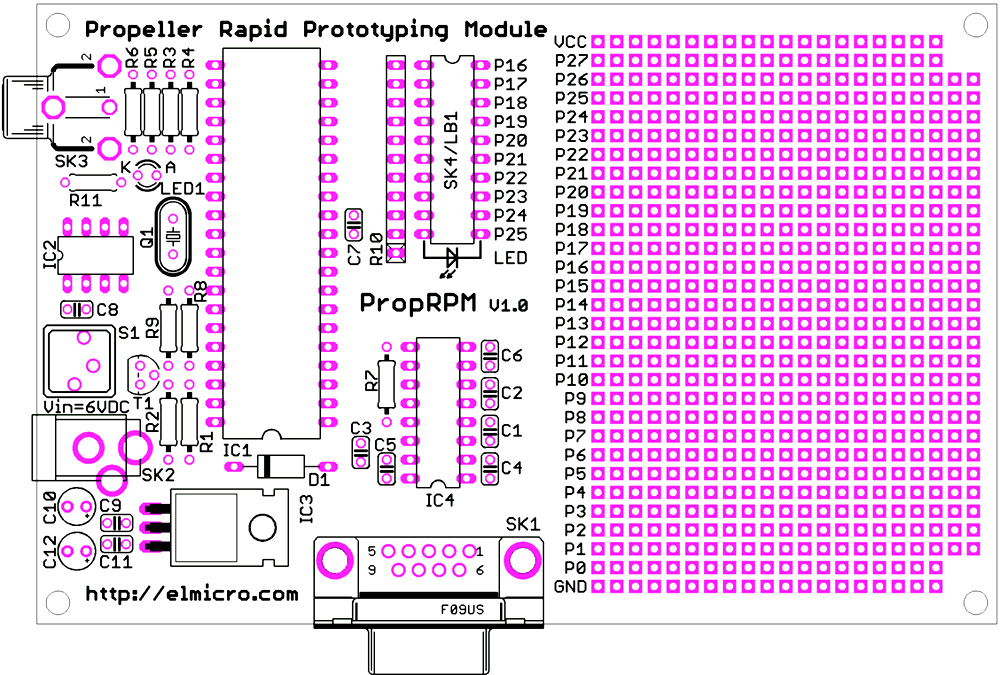
DataSheets/Propellor/proprpmpcb.gif
