mwelling/robot-chopper/Documentation/Engineering Notes/SCAN0039.JPG

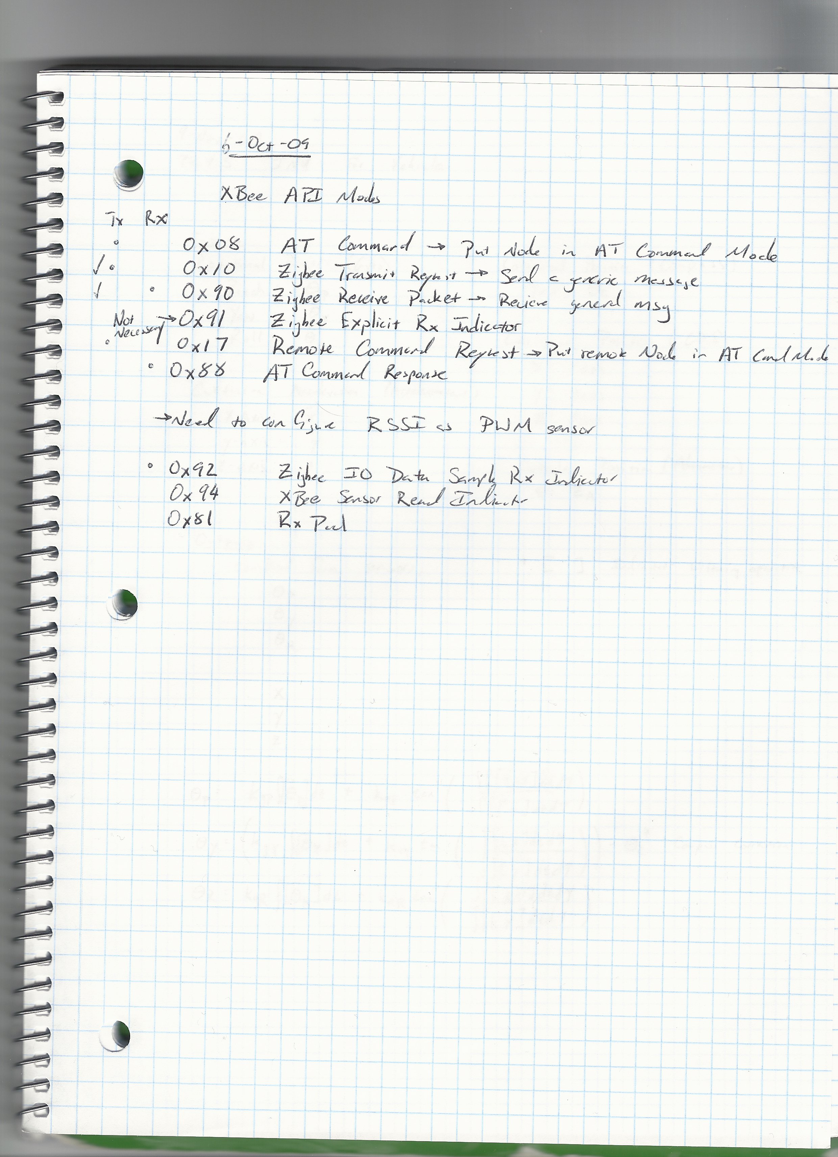
Documentation/Engineering Notes/SCAN0039.JPG
