mwelling/robot-chopper/Documentation/Engineering Notes/SCAN0040.JPG

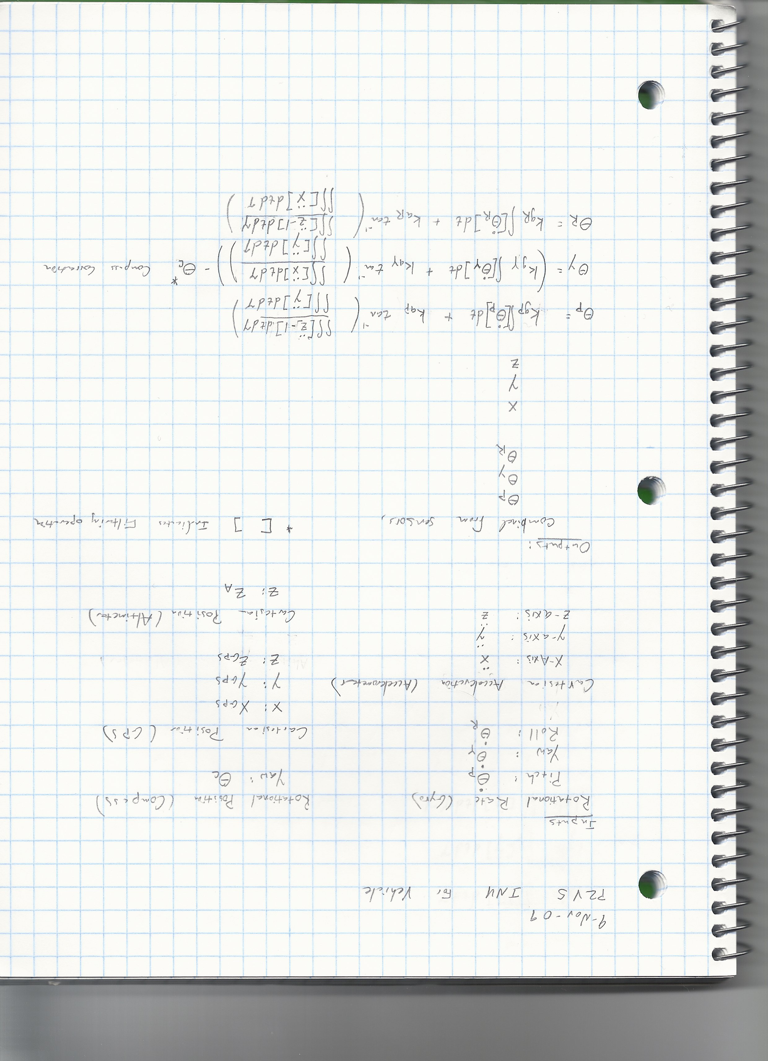
Documentation/Engineering Notes/SCAN0040.JPG
