mwelling/robot-chopper/Documentation/Engineering Notes/SCAN0041.JPG

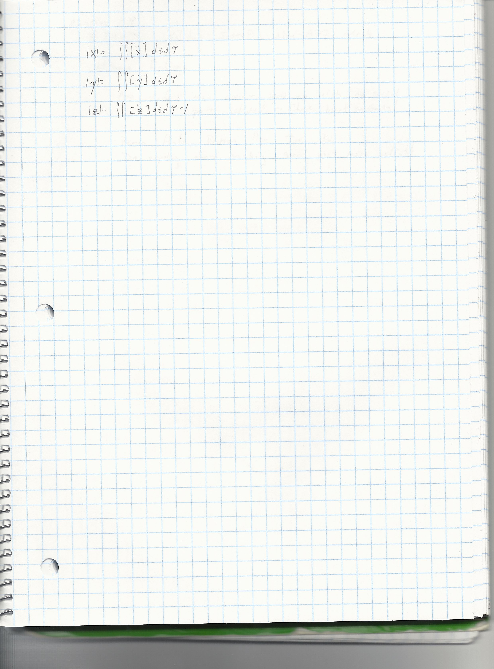
Documentation/Engineering Notes/SCAN0041.JPG
