mwelling/robot-chopper/Documentation/Engineering Notes/SCAN0042.JPG

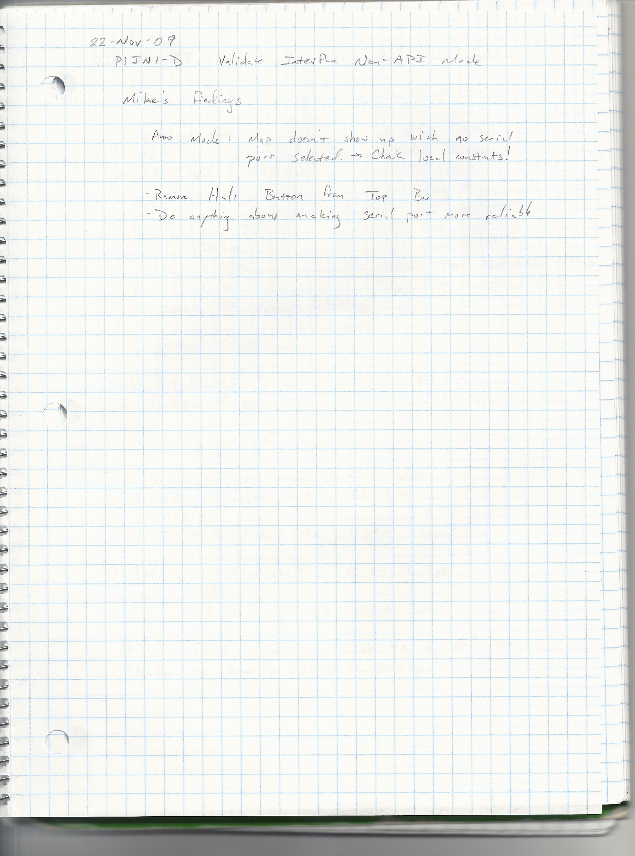
Documentation/Engineering Notes/SCAN0042.JPG
