mwelling/robot-chopper/Documentation/Engineering Notes/SCAN0043.JPG

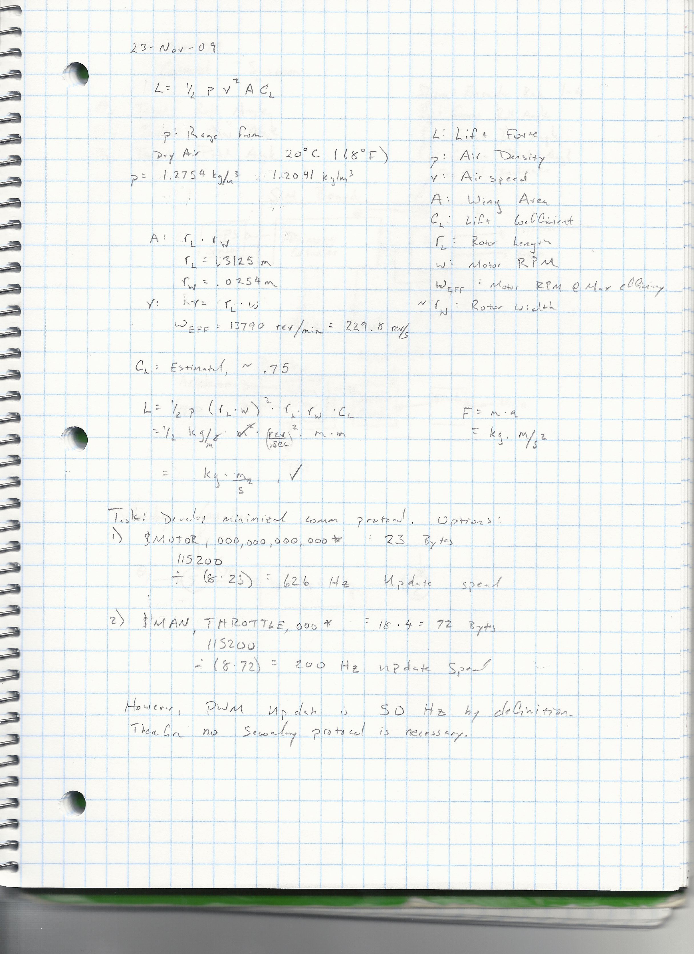
Documentation/Engineering Notes/SCAN0043.JPG
