mwelling/robot-chopper/Documentation/Engineering Notes/SCAN0044.JPG

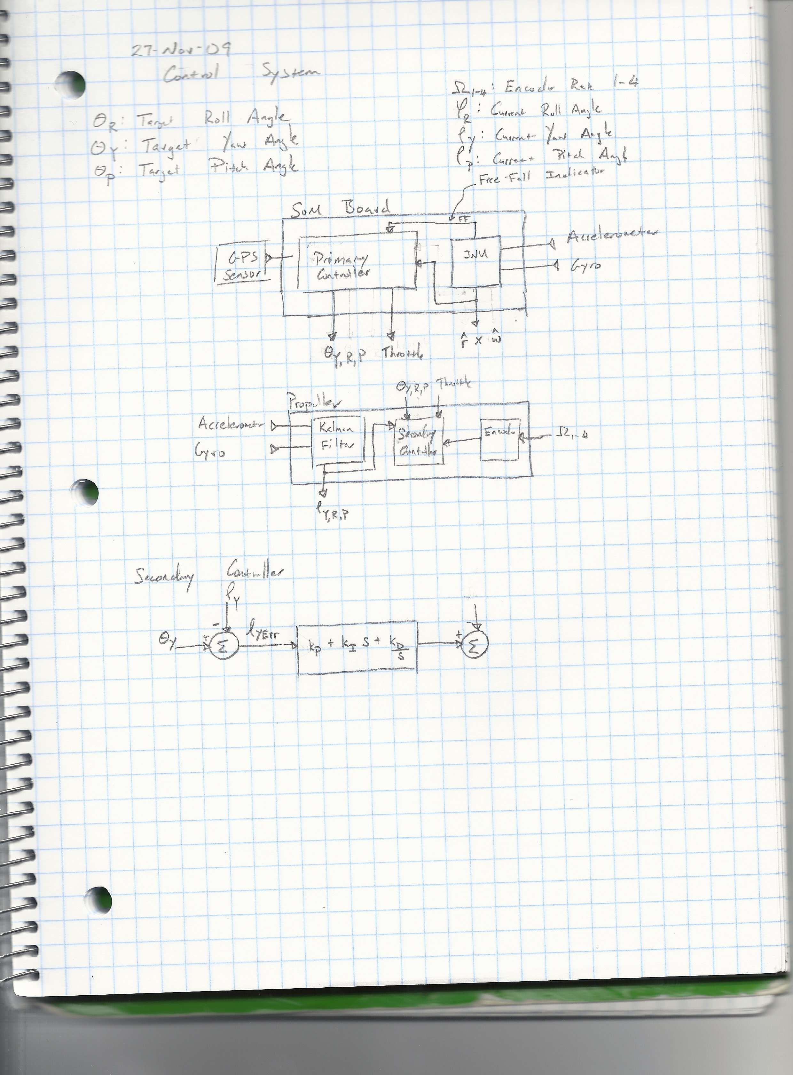
Documentation/Engineering Notes/SCAN0044.JPG
