mwelling/robot-chopper/Documentation/JAUSArchitecture.png

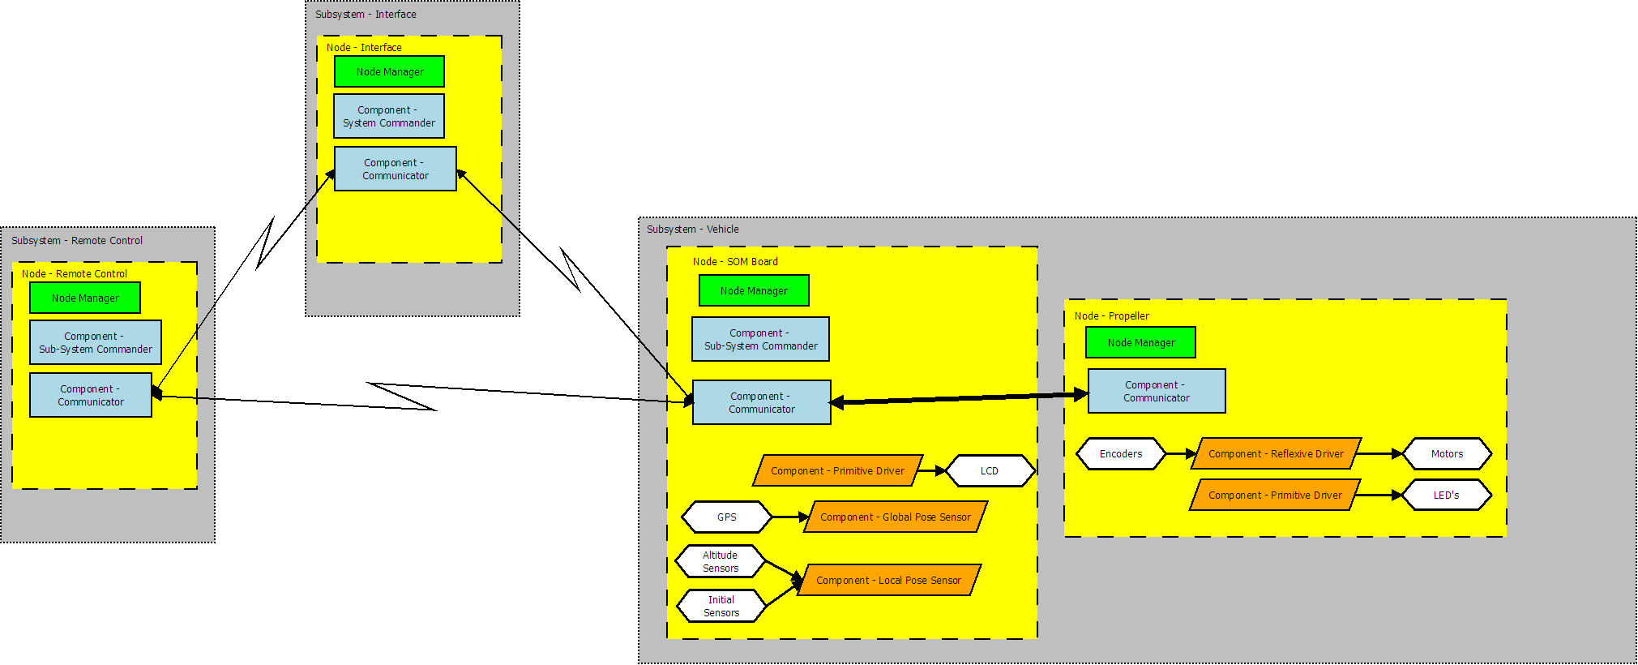
Documentation/JAUSArchitecture.png
