mwelling/robot-chopper/Ground Station/Documentation/Media/2.png

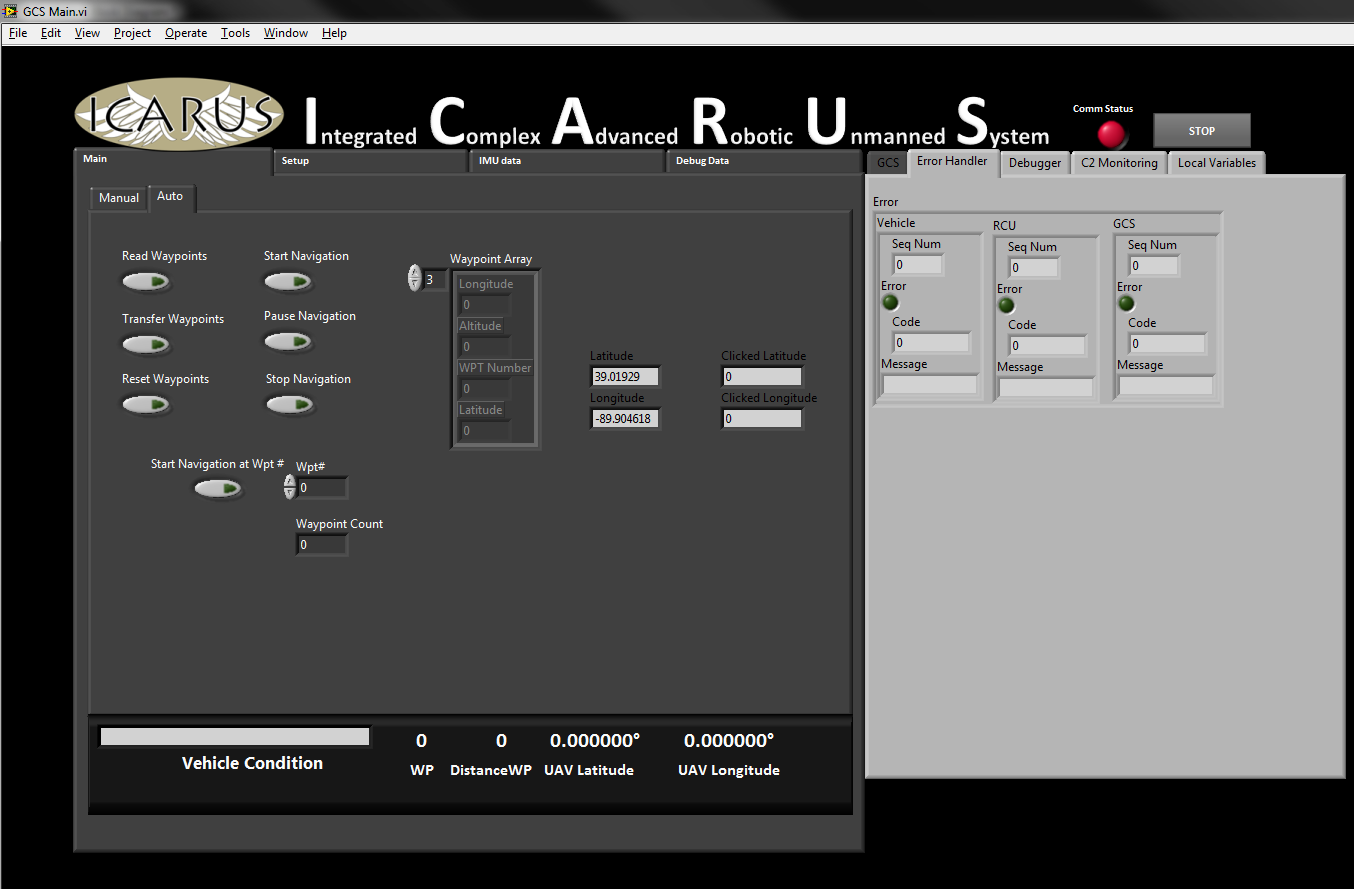
Ground Station/Documentation/Media/2.png
