mwelling/robot-chopper/Ground Station/Documentation/Media/3.png

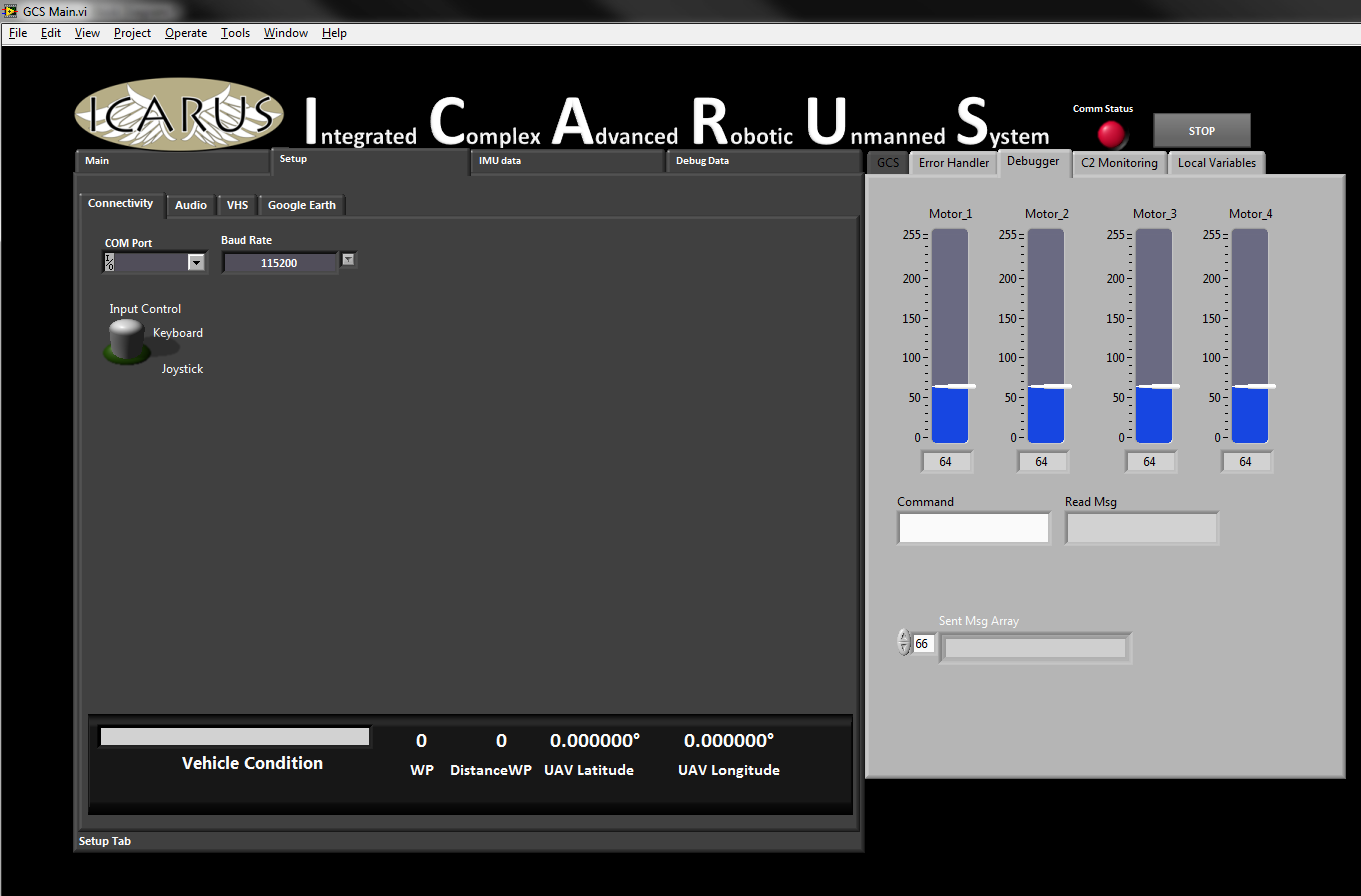
Ground Station/Documentation/Media/3.png
