mwelling/robot-chopper/Ground Station/Documentation/Media/4.png

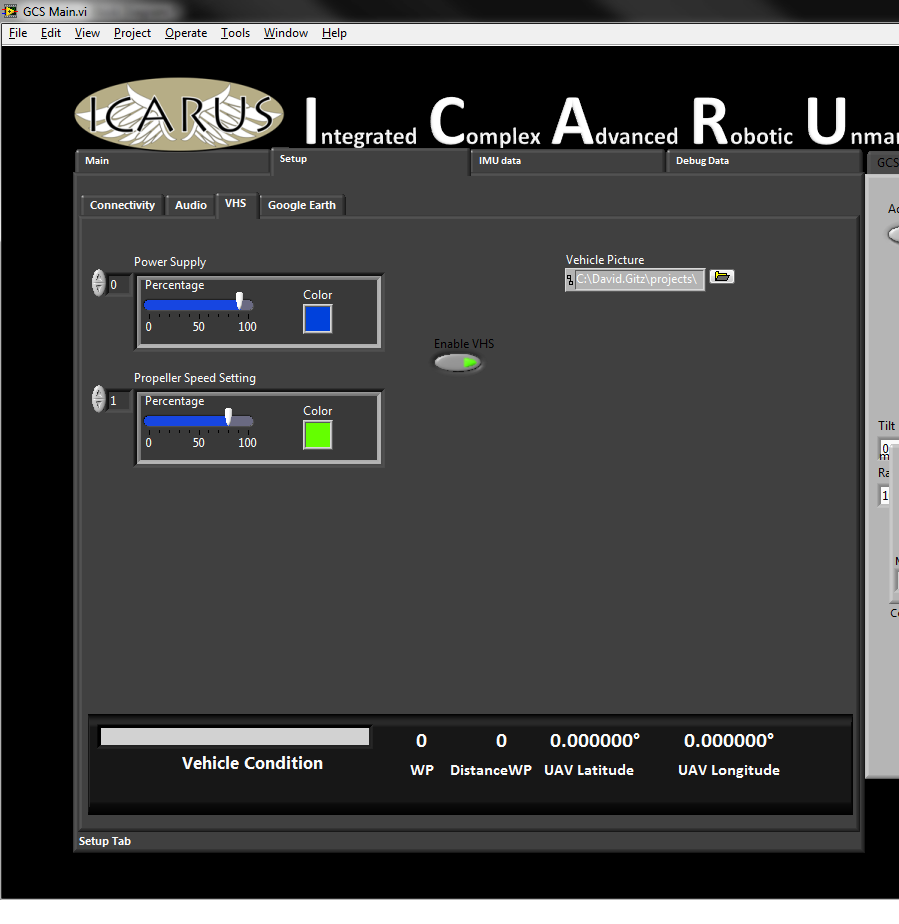
Ground Station/Documentation/Media/4.png
