mwelling/robot-chopper/Ground Station/Documentation/Media/5.png

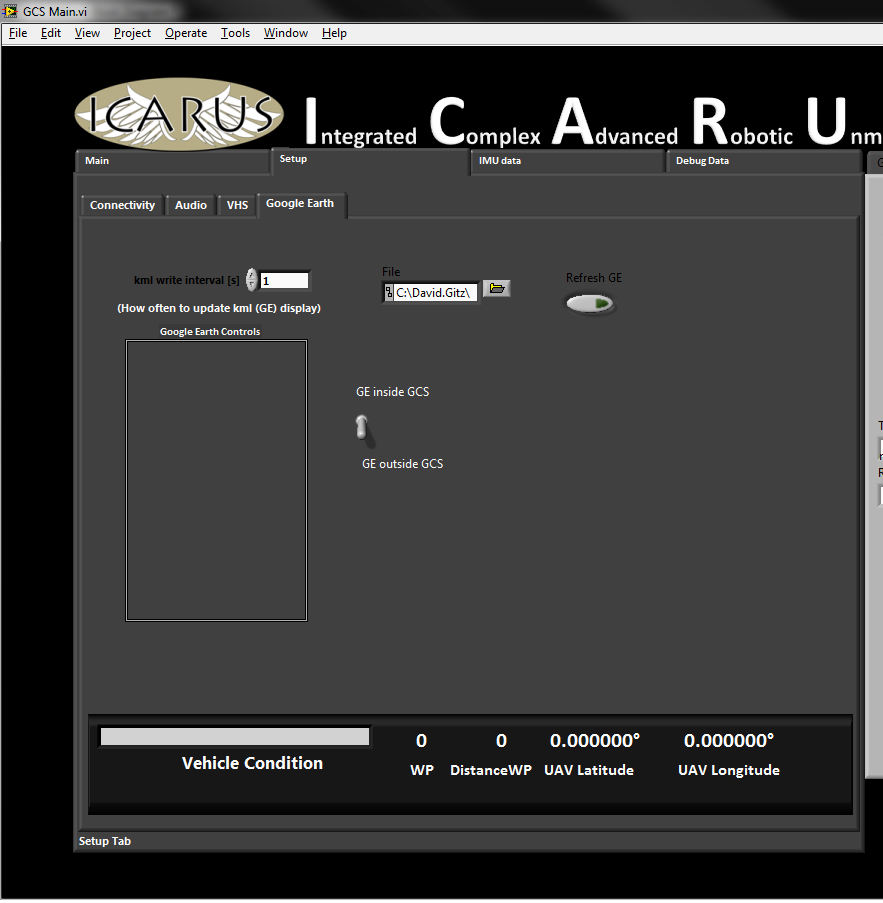
Ground Station/Documentation/Media/5.png
