mwelling/robot-chopper/Ground Station/Documentation/Media/AutonomousTab.png

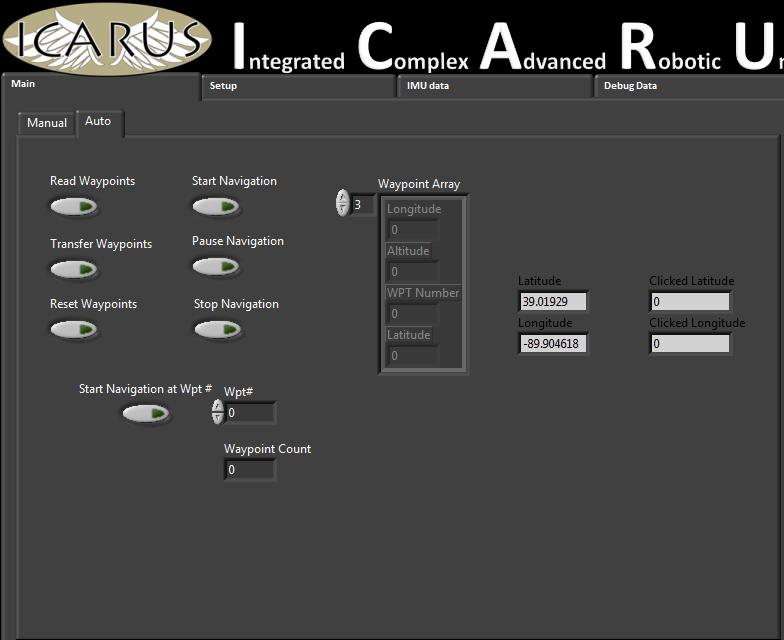
Ground Station/Documentation/Media/AutonomousTab.png
