mwelling/robot-chopper/Ground Station/Documentation/Media/C2MonitoringTab.png

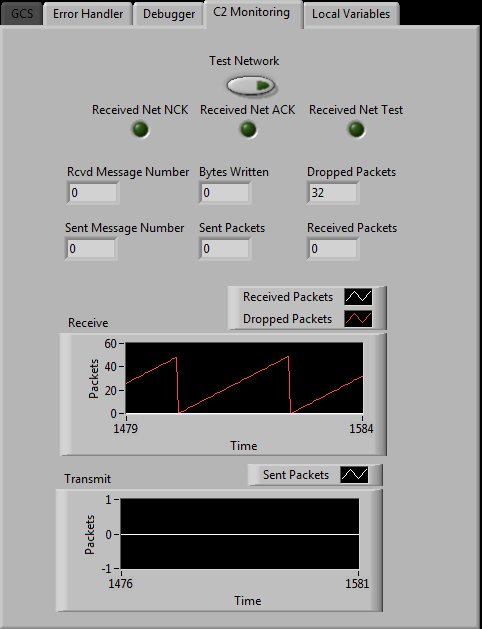
Ground Station/Documentation/Media/C2MonitoringTab.png
