mwelling/robot-chopper/Ground Station/Documentation/Media/ConnectivityTab.png

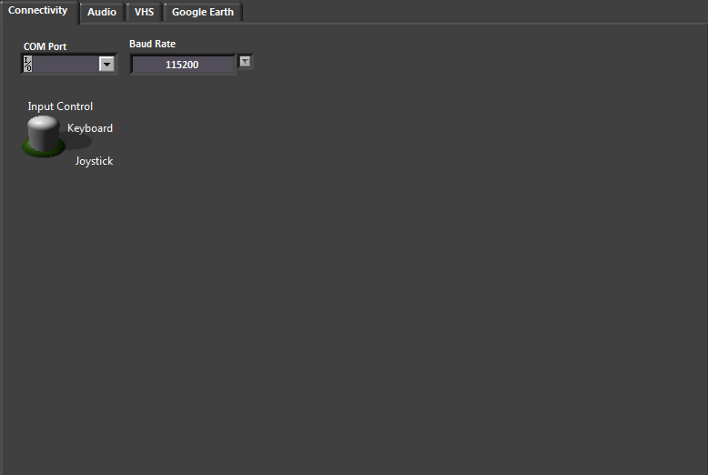
Ground Station/Documentation/Media/ConnectivityTab.png
