mwelling/robot-chopper/Ground Station/Documentation/Media/ErrorHandlerTab.png

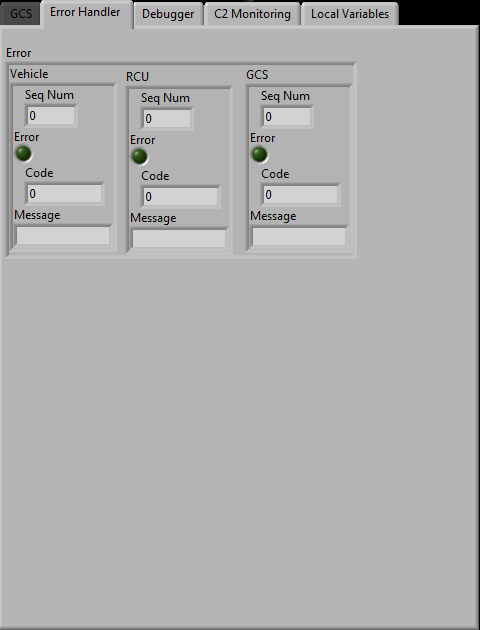
Ground Station/Documentation/Media/ErrorHandlerTab.png
