mwelling/robot-chopper/Ground Station/Documentation/Media/GEConfigTab.png

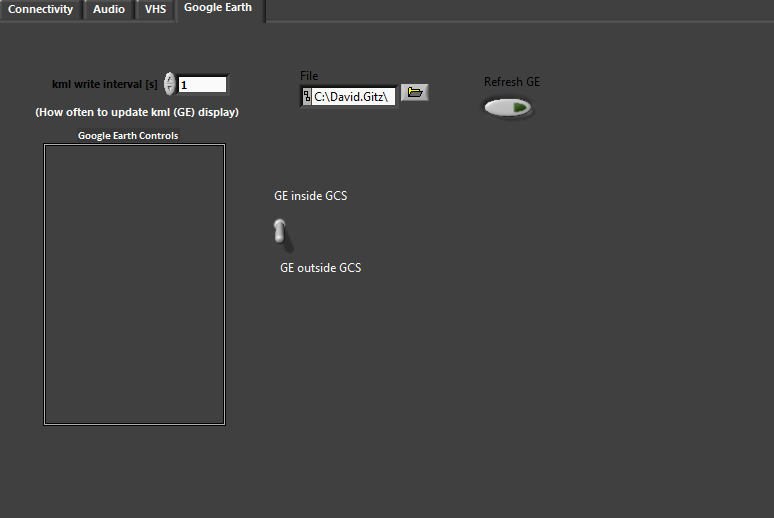
Ground Station/Documentation/Media/GEConfigTab.png
