mwelling/robot-chopper/Ground Station/Documentation/Media/VHSConfigTab.png

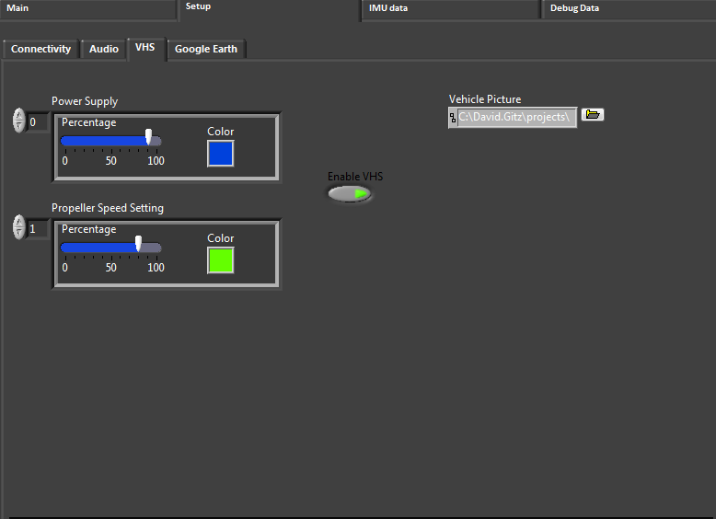
Ground Station/Documentation/Media/VHSConfigTab.png
