mwelling/robot-chopper/Ground Station/Interface/Data/Vehicle.png

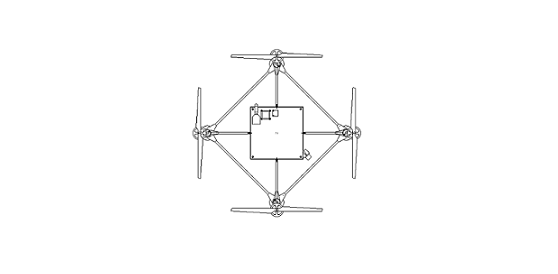
Ground Station/Interface/Data/Vehicle.png
