mwelling/robot-chopper/Media/GCS-Case/GCSClosed.png

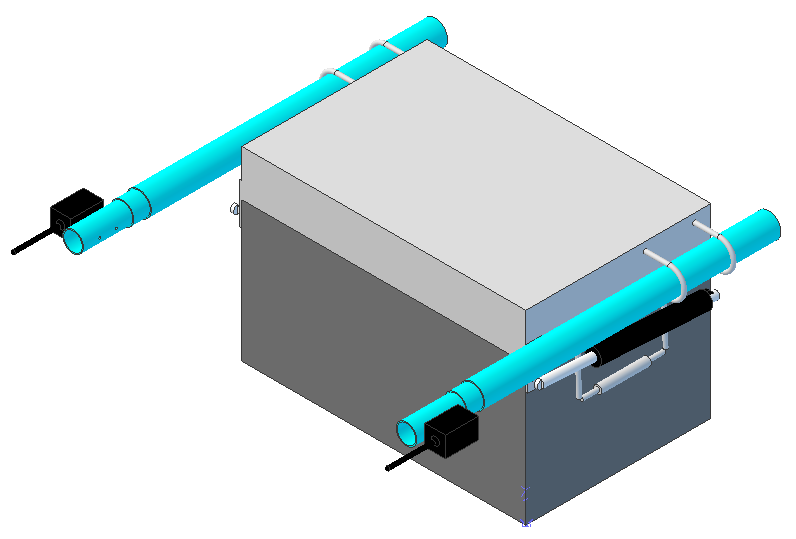
Media/GCS-Case/GCSClosed.png
