mwelling/robot-chopper/Media/GCS-Case/GCSOpen.png

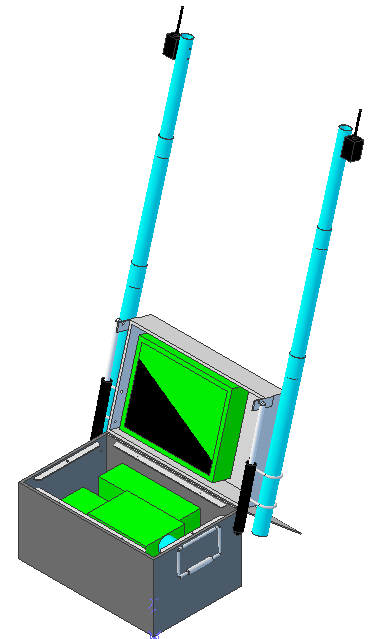
Media/GCS-Case/GCSOpen.png
