mwelling/robot-chopper/Media/GCS-Interface/Interface1.png

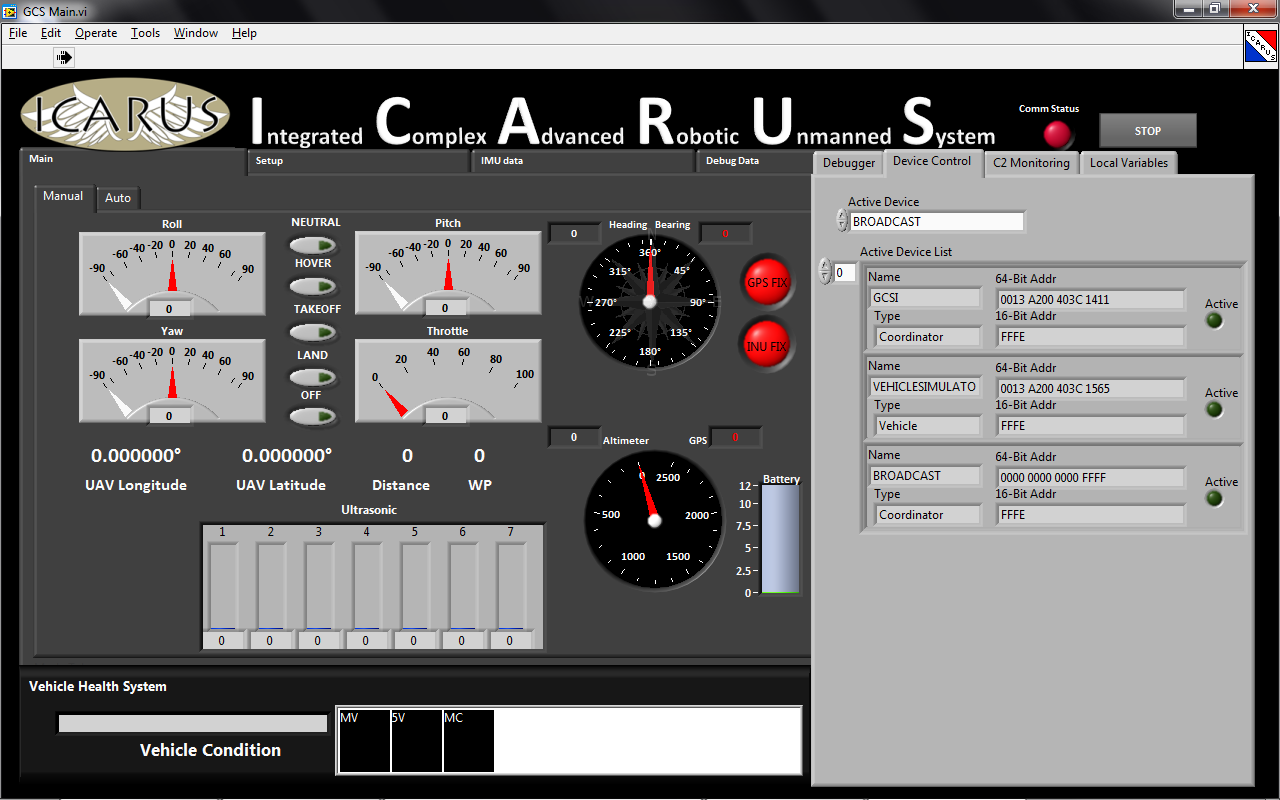
Media/GCS-Interface/Interface1.png
