mwelling/robot-chopper/Media/GCS-Platform/2010-04-21 18.46.10.jpg

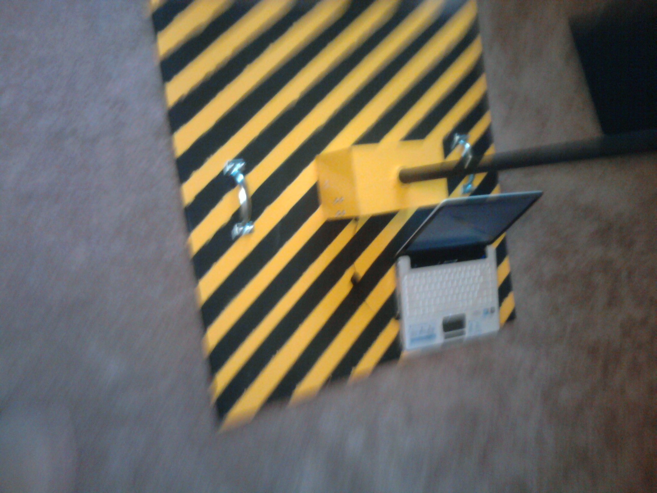
Media/GCS-Platform/2010-04-21 18.46.10.jpg
