mwelling/robot-chopper/Media/GCS-Platform/2010-04-21 18.46.22.jpg

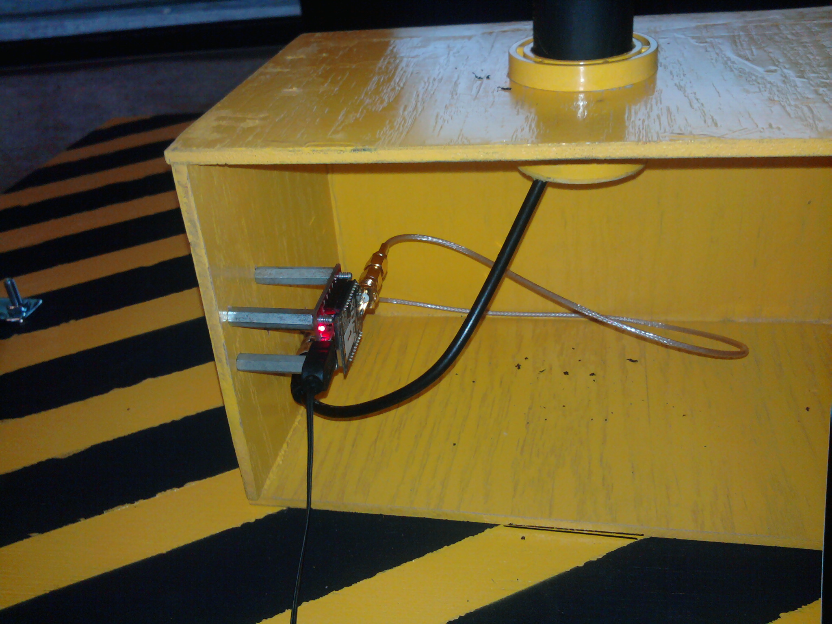
Media/GCS-Platform/2010-04-21 18.46.22.jpg
