mwelling/robot-chopper/Media/LandingPad/LandingPadwoVehicle.png

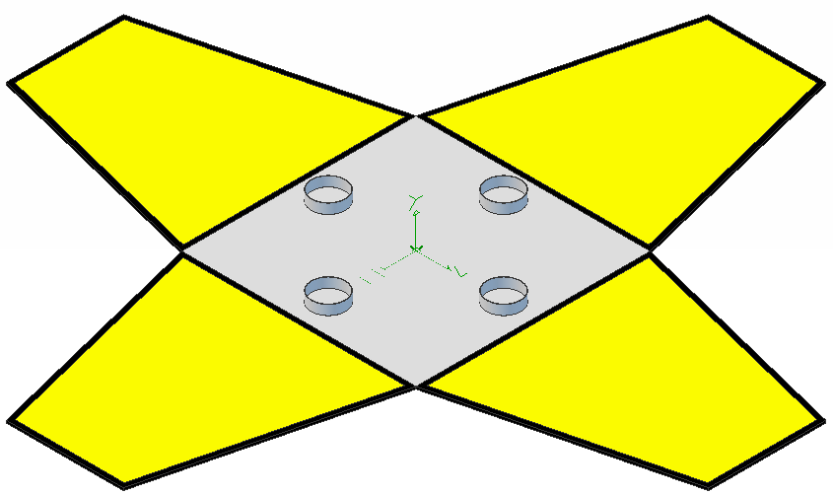
Media/LandingPad/LandingPadwoVehicle.png
