mwelling/robot-chopper/Media/RCU/RemoteControl.png

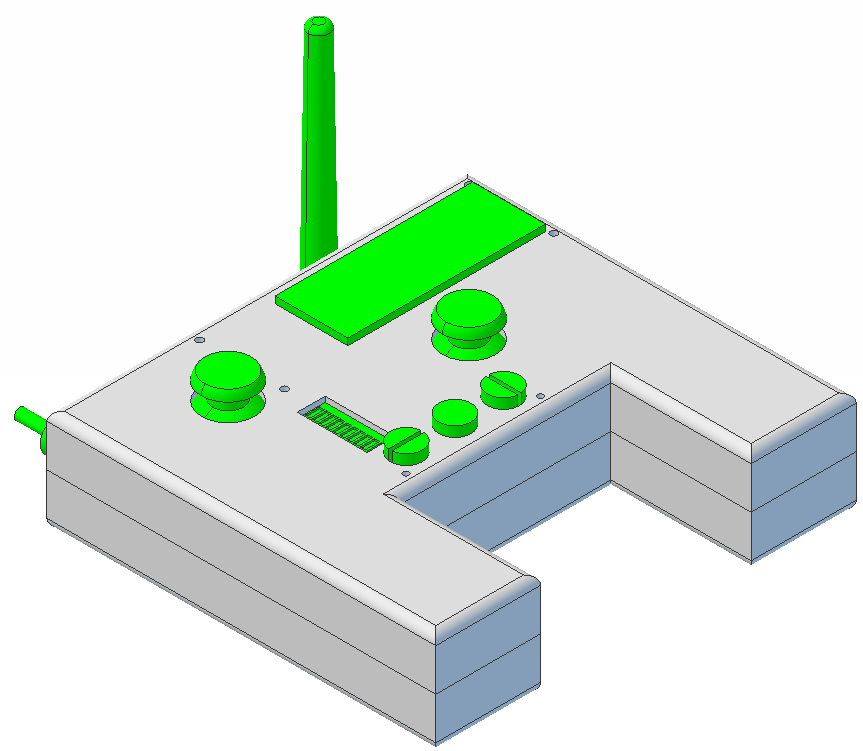
Media/RCU/RemoteControl.png
