mwelling/robot-chopper/Media/RCU/RemoteControlWireFrame.png

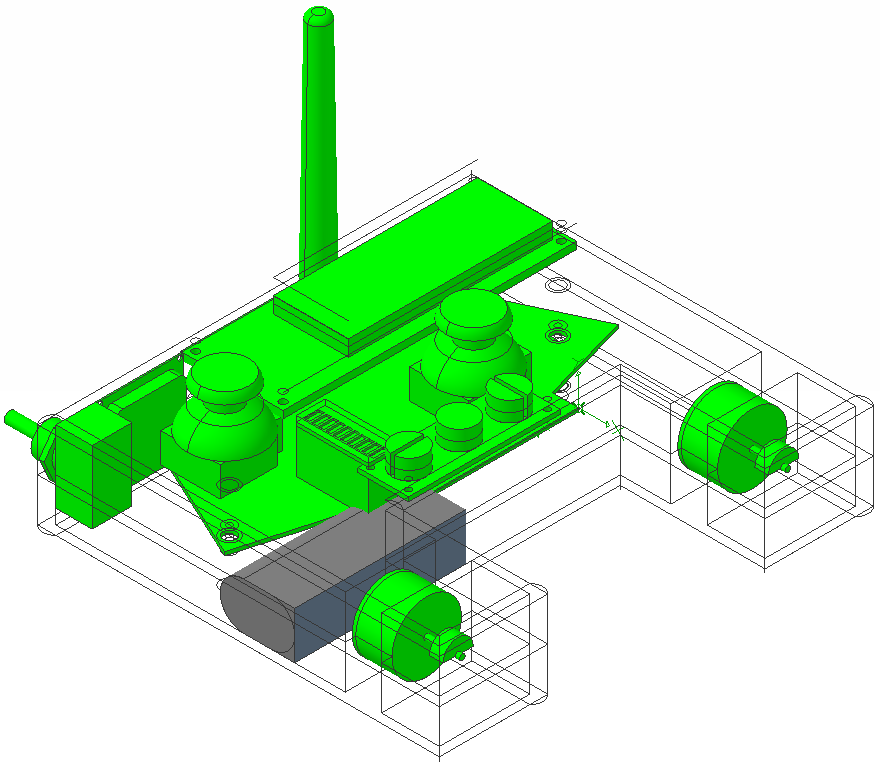
Media/RCU/RemoteControlWireFrame.png
