mwelling/robot-chopper/Media/Vehicle/Prototype/Camera.png

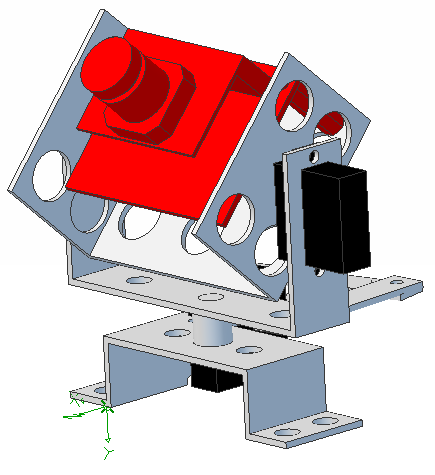
Media/Vehicle/Prototype/Camera.png
