mwelling/robot-chopper/Media/Vehicle/Vehicle.png

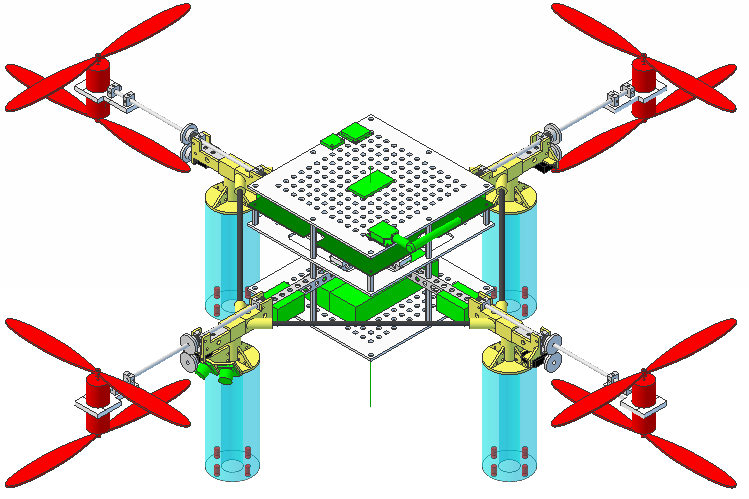
Media/Vehicle/Vehicle.png
