mwelling/robot-chopper/Media/Vehicle/VehicleFront.png

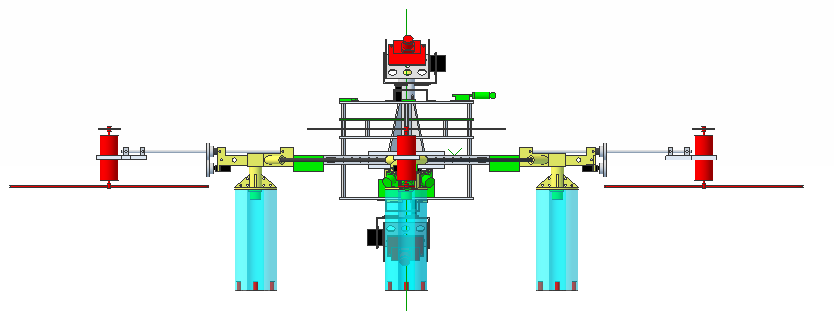
Media/Vehicle/VehicleFront.png
