mwelling/robot-chopper/Media/Vehicle/VehicleTop.png

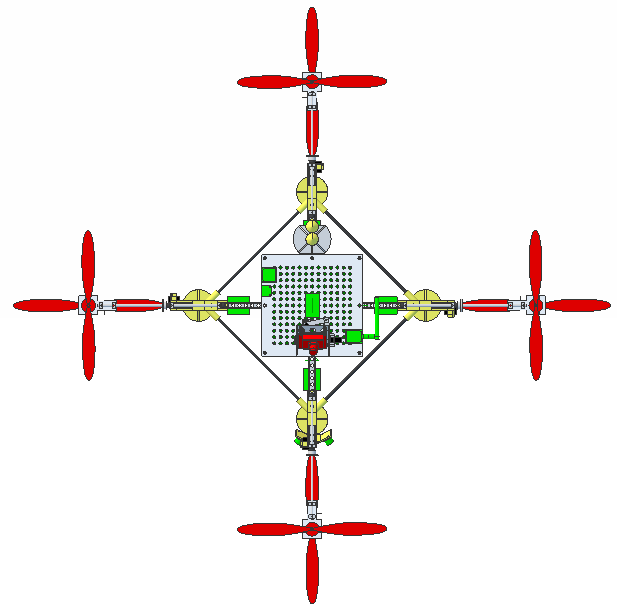
Media/Vehicle/VehicleTop.png
