mwelling/robot-chopper/Media/Vehicle/VehiclewPrototypes.png

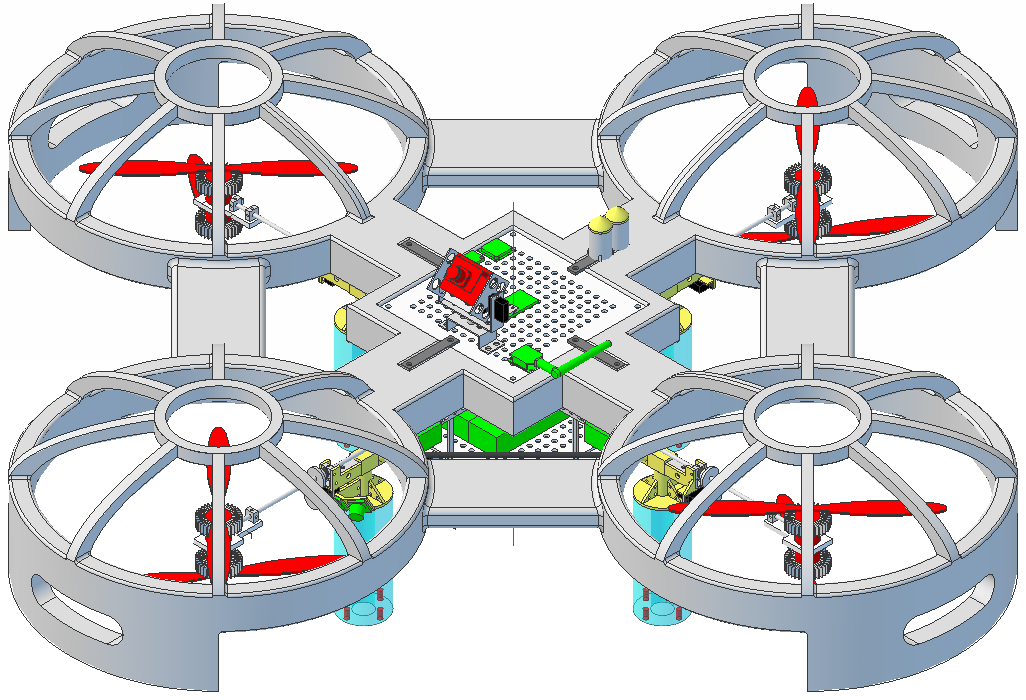
Media/Vehicle/VehiclewPrototypes.png
