mwelling/robot-chopper/Media/Vehicle/Version1/Vehicle.png

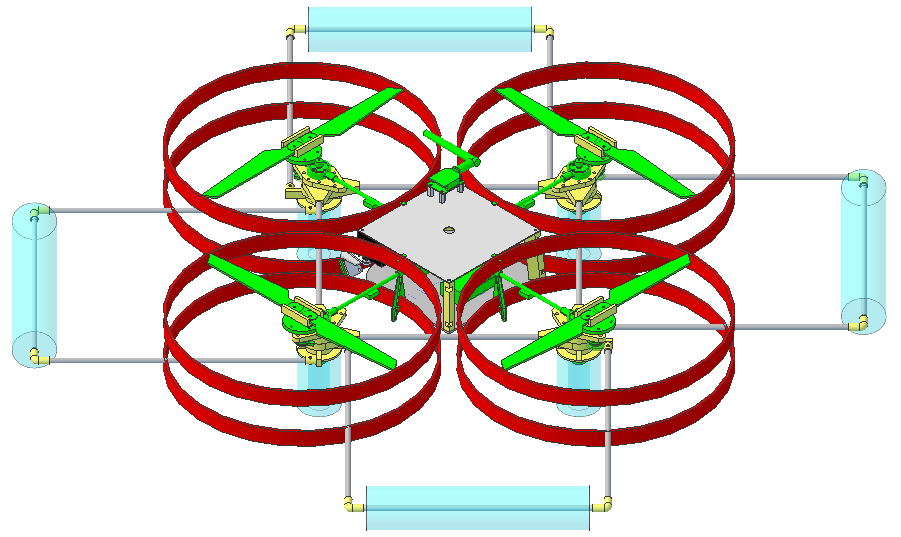
Media/Vehicle/Version1/Vehicle.png
