mwelling/robot-chopper/RemoteControl/Documentation/WirelessMatrixBottom.jpg

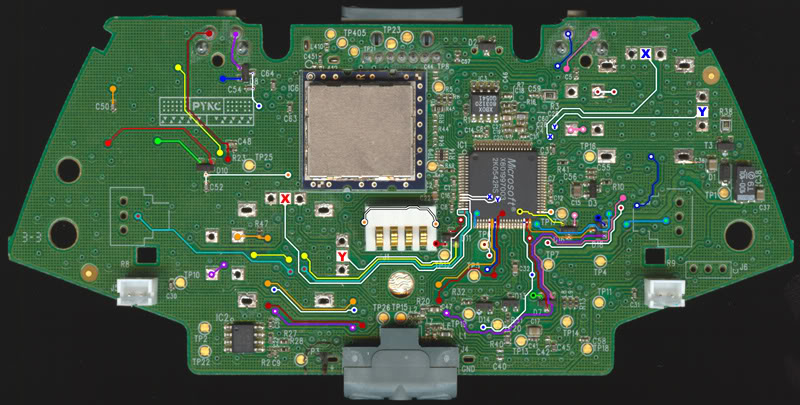
RemoteControl/Documentation/WirelessMatrixBottom.jpg
