mwelling/robot-chopper/RemoteControl/Documentation/WirelessMatrixBottomClean_v1.jpg

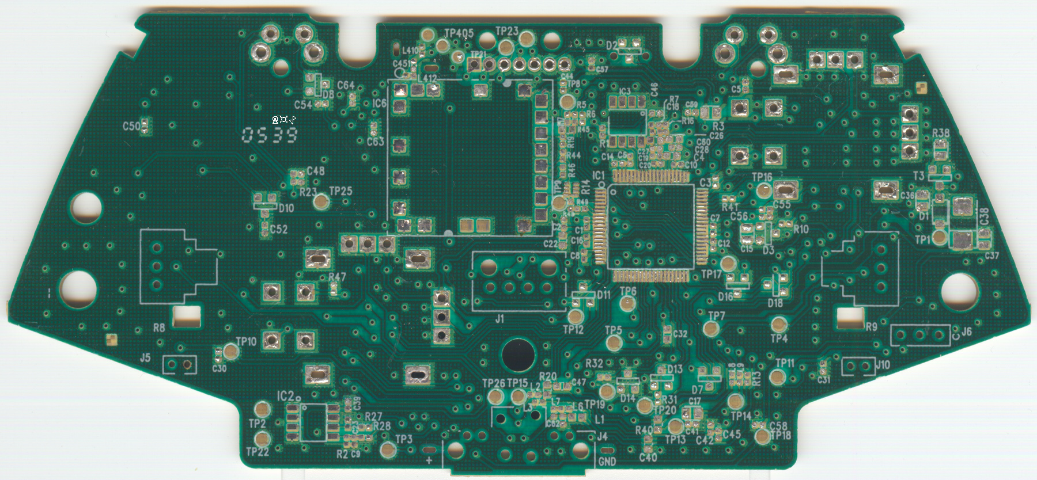
RemoteControl/Documentation/WirelessMatrixBottomClean_v1.jpg
