mwelling/robot-chopper/RemoteControl/Documentation/WirelessMatrixTopClean_v1.jpg

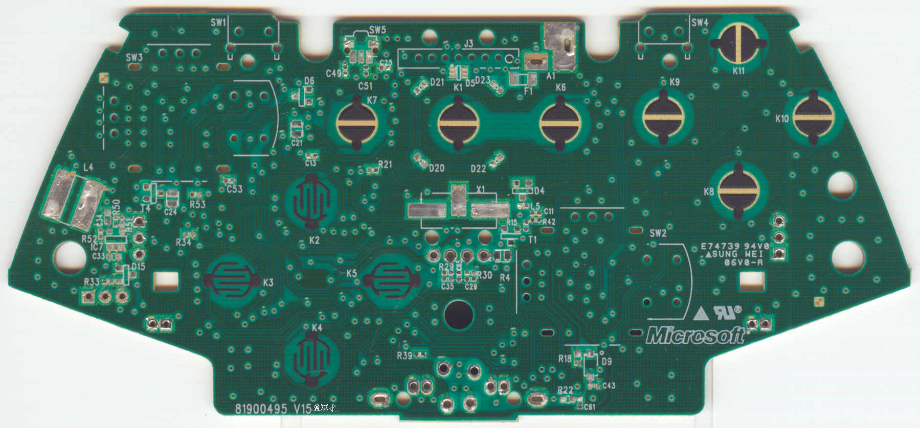
RemoteControl/Documentation/WirelessMatrixTopClean_v1.jpg
