mwelling/robot-chopper/Project Management/Bill of Materials.xls

Sheet: Bill Of Materials
Comments/RCVD | System | Subsystem | Name (units if applicable) | Quantity To Order | Quantity Required | Quantity On-Hand | Part Number | Unit Price | Order Price | Required Cost | Source | Website | Datasheet
RCVD | Ground Station | Platform | .5m SMA Adapter (F) to BNC (F) | 0 | 1 | 1 | 2780011 | 19.99 | 0.00 | 19.99 | Radio Shac
READY | Ground Station | Power | 12V Battery | 2 | 2 | 0 | ES12-12 | 57.95 | 115.90 | 115.90 | MK | http://www.apexbattery.com/mk-es12-12-battery-sealed-lead-acid-batteries-mk-battery.html
READY | Ground Station | Power | 12V Battery Charger | 1 | 1 | 0 | SC-600A | 28.00 | 28.00 | 28.00 | Schumacher | http://www.amazon.com/Schumacher-SC-600A-SpeedCharge-Frequency-Battery/dp/B000H94F6E
RCVD | Ground Station | Platform | 6' BNC Cable | 0 | 1 | 1 | 2780964 | 7.49 | 0.00 | 7.49 | Radio Shack
RCVD | Ground Station | Platform | Black Spray Paint | 0 | 3 | 3 | 20066187811 | 3.44 | 0.00 | 10.32 | Home Depot
RCVD | Ground Station | Platform | BNC Antenna | 0 | 1 | 1 |  | 19.99 | 0.00 | 19.99 | Radio Shack
READY | Ground Station | Power | DC Power Inverter | 1 | 1 | 0 | PW400-12 | 34.99 | 34.99 | 34.99 | DCACPowerInverters | http://www.dcacpowerinverters.com/itemdesc.asp?ic=PW400-12
RCVD | Ground Station | Platform | Door Handle | 0 | 2 | 2 | 30699151868 | 3.97 | 0.00 | 7.94 | Home Depot
SOURCE | Ground Station | Case | Gas Struts | 2 | 2 | 0 |  | 25.00 | 50.00 | 50.00 | McMaster-Carr
RCVD | Ground Station | Power | Lead Acid Batteries | 0 | 2 | 2 |  | 35.00 | 0.00 | 70.00
SOURCE | Ground Station | Power | Main Power Switch | 1 | 1 | 0 |  | 20.00 | 20.00 | 20.00
RCVD | Ground Station | Platform | Masking Tape | 0 | 1 | 1 | 51115036835 | 6.93 | 0.00 | 6.93 | Home Depot
RCVD | Ground Station | Ground Station | Misc. Hardware | 0 | 0 | 0 |  | 25.00 | 0.00 | 0.00 | Home Depot
RCVD | Ground Station | Platform | Plywood Box | 0 | 1 | 1 |  |  | 0.00 | 0.00 | Already Procured
RCVD | Ground Station | Control | Power Cable | 0 | 1 | 1 |  | 10.00 | 0.00 | 10.00
SOURCE | Ground Station | Power | Power Connectors | 4 | 4 | 0 |  | 20.00 | 80.00 | 80.00 | Anderson Power Products
RCVD | Ground Station | Platform | PVC Cap | 0 | 1 | 1 | 12871628320 | 0.51 | 0.00 | 0.51 | Home Depot
RCVD | Ground Station | Platform | PVC Flange | 0 | 1 | 1 | 12871616630 | 1.04 | 0.00 | 1.04 | Home Depot
RCVD | Ground Station | Platform | PVC Pipe - 10' | 0 | 1 | 1 | 754826200501 | 2.39 | 0.00 | 2.39 | Home Depot
RCVD | Ground Station | Platform | SMA Male to RPSMA Male Adapter | 0 | 1 | 1 | WRL-09233 | 4.95 | 0.00 | 4.95 | Spark Fun
RCVD | Ground Station | Platform | SMA M-M Coupler | 0 | 1 | 1 | 2780009 | 6.99 | 0.00 | 6.99 | Radio Shack
SOURCE | Ground Station | Control | Small Form Factor PC | 1 | 1 | 0 | UNO-2173A-A12E-250G-XPP | 769.00 | 769.00 | 769.00 | Advantech
SOURCE | Ground Station | Communications | Telescopic Tube | 1 | 1 | 0 |  | 15.00 | 15.00 | 15.00
SOURCE | Ground Station | Control | Touch Screen LCD | 1 | 1 | 0 | 1247L | 564.00 | 564.00 | 564.00 | ELO | http://www.newegg.com/Product/Product.aspx?Item=N82E16824217111
RCVD | Ground Station | Control | USB Cable | 0 | 3 | 3 |  | 10.00 | 0.00 | 30.00
RCVD | Ground Station | Control | Video Cable | 0 | 1 | 1 |  | 10.00 | 0.00 | 10.00
SOURCE | Ground Station | Control | Video Heads Up Display | 1 | 1 | 0 |  | 250.00 | 250.00 | 250.00
RCVD | Ground Station | Platform | Wood Base - 4' x 4' | 0 | 1 | 1 | 454532 | 29.94 | 0.00 | 29.94
RCVD | Ground Station | Communications | Xbee Radio | 0 | 1 | 1 | WRL-08768 | 44.95 | 0.00 | 44.95 | Spark Fun | http://www.sparkfun.com/commerce/product_info.php?products_id=8768
RCVD | Ground Station | Communications | XBee USB Board | 0 | 2 | 2 | WRL-08687 | 24.95 | 0.00 | 49.90 | Spark Fun | http://www.sparkfun.com/commerce/product_info.php?products_id=8687
RCVD | Ground Station | Platform | Yellow Spray Paint | 0 | 3 | 3 |  | 3.44 | 0.00 | 10.32 | Home Depot
RCVD | Remote Control | Control Board | 10 Resistor In-Line Network | 0 | 1 | 4 | 652-4611X-1LF-1K | 0.36 | 0.00 | 0.36 | Mouser | http://www.mouser.com/ProductDetail/Bourns/4611X-101-102LF/
RCVD | Remote Control | Control Board | 10 Segment LED Bar | 0 | 1 | 3 |  |  | 0.00 | 0.00
RCVD | Remote Control | Control Board | 16-Pin IC Socket | 0 | 3 | 5 |  |  | 0.00 | 0.00
RCVD | Remote Control | Control Board | 20-Pin IC Socket | 0 | 1 | 4 | 571-1825093-6 | 1.54 | 0.00 | 1.54 | Mouser | http://www.mouser.com/ProductDetail/Tyco-Electronics/1825093-6/
RCVD | Remote Control | Control Board | 40-Pin IC Socket | 0 | 0 | 5 | AE10018-ND | 2.31 | 0.00 | 0.00 | Digikey
RCVD | Remote Control | Control Board | 40-Pin IC ZIF Socket | 0 | 0 | 1 | A306-ND | 12.02 | 0.00 | 0.00 | Digikey
RCVD | Remote Control | Control Board | 64 KB EEPROM | 0 | 1 | 2 | 602-00032 | 1.50 | 0.00 | 1.50 | Parallax | http://www.parallax.com/tabid/768/txtSearch/602-00032/List/0/SortField/4/Default.aspx
RCVD | Remote Control | Control Board | 8 Resistor In-Line Network | 0 | 1 | 4 | 71-CSC09A01-1.0K | 0.59 | 0.00 | 0.59 | Mouser | http://www.mouser.com/ProductDetail/Vishay-Dale/CSC09A011K00GPA/
RCVD | Remote Control | Control Board | 8:3 Encoder | 0 | 1 | 1 | SN74HC148 | 0.60 | 0.00 | 0.60 | Digikey | http://search.digikey.com/scripts/DkSearch/dksus.dll?Detail&name=296-8233-5-ND
RCVD | Remote Control | Control Board | 8-Pin IC Socket | 0 | 1 | 3 | A32878-ND | 0.63 | 0.00 | 0.63 | Digikey
RCVD | Remote Control | Control Board | Analog-To-Digital Converter | 0 | 1 | 1 | MCP3208-CI/P-ND | 5.12 | 0.00 | 5.12 | Digikey | http://search.digikey.com/scripts/DkSearch/dksus.dll?Detail&name=MCP3208-CI/P-ND
RCVD | Remote Control | Control Board | Boost Converter | 0 | 2 | 4 | 791 | 14.95 | 0.00 | 29.90 | Pololu | http://www.pololu.com/catalog/product/791
RCVD | Remote Control | Control Board | Breadboard | 0 | 0 | 4 | PRT-00112 | 11.95 | 0.00 | 0.00 | Spark Fun | http://www.sparkfun.com/commerce/product_info.php?products_id=112
RCVD | Remote Control | Control Board | Capacitor Polarized 150 uF | 0 | 1 | 5 | 493-1822-ND | 0.40 | 0.00 | 0.40 | Digikey | http://search.digikey.com/scripts/DkSearch/dksus.dll?WT.z_header=search_go&lang=en&site=us&x=29&y=9
RCVD | Remote Control | Control Board | Crystal 5 MHz | 0 | 1 | 5 | N/A | 0.00 | 0.00 | 0.00 | Bench Stock | N/A
READY | Remote Control | System | Enclosure | 1 | 1 | 0 | N/A | 240.85 | 240.85 | 240.85 | Ponoko | www.ponoko.com
RCVD | Remote Control | Sensor | GPS Sensor | 0 | 1 | 1 | GPS-00465 | 59.95 | 0.00 | 59.95 | Spark Fun | http://www.sparkfun.com/commerce/product_info.php?products_id=465
RCVD | Remote Control | Control Board | H-Bridge | 0 | 1 | 3 | COM-00315 | 2.35 | 0.00 | 2.35 | Spark Fun | http://www.sparkfun.com/commerce/product_info.php?products_id=315
RCVD | Remote Control | Control Board | Kill Switch | 0 | 1 | 1 |  |  | 0.00 | 0.00 | Spark Fun
RCVD | Remote Control | Control Board | LCD Display | 0 | 1 | 1 | LCD-00813 | 26.95 | 0.00 | 26.95 | Spark Fun | http://www.sparkfun.com/commerce/product_info.php?products_id=813
RCVD | Remote Control | Control Board | LED | 0 | 0 | 6 | N/A | 0.00 | 0.00 | 0.00 | Bench Stock | N/A
RCVD | Remote Control | Control Board | PCB Manufacture | 0 | 1 | 4 | N/A | 20.00 | 0.00 | 20.00 | Batch PCB | http://batchpcb.com
RCVD | Remote Control | Control Board | Prop Plug | 0 | 1 | 0 | 32201 | 14.99 | 0.00 | 14.99 | Parallax | http://www.parallax.com/StoreSearchResults/tabid/768/List/0/SortField/4/ProductID/398/Default.aspx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
RCVD | Remote Control | Control Board | Propeller Processer - QFP | 0 | 1 | 0 | P8X32A-Q44 | 7.99 | 0.00 | 7.99 | Parallax | http://www.parallax.com/Store/Microcontrollers/PropellerChips/tabid/142/CategoryID/18/List/0/SortField/0/Level/a/ProductID/334/Default.aspx
RCVD | Remote Control | Control Board | PropRPM | 0 | 0 | 1 | 32202 | 49.99 | 0.00 | 0.00 | Parallax
RCVD | Remote Control | Control Board | PWM Cable | 0 | 6 | 8 | 0-CA6X | 3.79 | 0.00 | 22.74 | Robot Marketplace | http://www.robotmarketplace.com/products/0-CA6X.html
RCVD | Remote Control | Control Board | Resistor 4.7k | 0 | 2 | 20 | N/A | 0.00 | 0.00 | 0.00 | Bench Stock | N/A
RCVD | Remote Control | Control Board | Ribbon Cable | 1 | 1 | 0 |  |  | 0.00 | 0.00
RCVD | Remote Control | Control Board | Thumbstick | 0 | 2 | 4 |  |  | 0.00 | 0.00
RCVD | Remote Control | Control Board | XBee 2mm Socket | 0 | 2 | 2 | PRT-08272 | 1.00 | 0.00 | 2.00 | Spark Fun | http://www.sparkfun.com/commerce/product_info.php?products_id=8272
RCVD | Remote Control | Control Board | XBee Radio Breakout | 0 | 1 | 1 | BOB-08276 | 2.95 | 0.00 | 2.95 | Spark Fun | http://www.sparkfun.com/commerce/product_info.php?products_id=8276
RCVD | Remote Control | System | XBox 360 Wireless Controller w/ Battery Pack | 0 | 1 | 1 | N/A | 64.99 | 0.00 | 64.99 | Game Stop | http://www.gamestop.com/Catalog/ProductDetails.aspx?product_id=65036
HOLD | System | N/A | Misc. Parts | 0 |  |  | N/A | 50.00 | 0.00 | 0.00 | Misc.
RCVD | System | N/A | XBee Radio | 0 | 2 | 2 | WRL-08768 | 44.95 | 0.00 | 89.90 | Spark Fun | http://www.sparkfun.com/commerce/product_info.php?products_id=8768
RCVD | System | N/A | XBEE RPSMA Antenna | 0 |  |  | WRL-00145 | 7.95 | 0.00 | 0.00 | Radio Shack
SOURCE | Test Stand | Power | 12V 100A Power Supply | 1 | 1 | 0 |  | 200.00 | 200.00 | 200.00
READY | Test Stand | Frame | Aluminum L Angle 1.5" x 1.5" x (in) | 0 |  |  | 4630T25 | 0.35 | 0.00 | 0.00 | McMaster-Carr | http://www.mcmaster.com/#4630t25/=3ncw1f
READY | Test Stand | Test Fixture | Aluminum L Angle 1.5" x 1.5" x (in) | 0 |  |  | 4630T25 | 0.35 | 0.00 | 0.00 | McMaster-Carr | http://www.mcmaster.com/#4630t25/=3ncw1f
READY | Test Stand | Frame | Aluminum Rect Tube 2" x 1" x (in) | 0 |  |  | 6546K393 | 0.45 | 0.00 | 0.00 | McMaster-Carr | http://www.mcmaster.com/#6546k393/=3ncxhd
READY | Test Stand | Frame | Aluminum Rect Tube 2" x 1" x (in) | 0 |  |  | 6546K393 | 0.45 | 0.00 | 0.00 | McMaster-Carr | http://www.mcmaster.com/#6546k393/=3ncxhd
READY | Test Stand | Frame | Aluminum Rect Tube 2" x 1" x (in) | 0 |  |  | 6546K393 | 0.45 | 0.00 | 0.00 | McMaster-Carr | http://www.mcmaster.com/#6546k393/=3ncxhd
READY | Test Stand | Frame | Aluminum Rect Tube 2" x 1" x (in) | 0 |  |  | 6546K393 | 0.45 | 0.00 | 0.00 | McMaster-Carr | http://www.mcmaster.com/#6546k393/=3ncxhd
READY | Test Stand | Frame | Aluminum Rect Tube 2" x 1" x (in) | 0 |  |  | 6546K393 | 0.45 | 0.00 | 0.00 | McMaster-Carr | http://www.mcmaster.com/#6546k393/=3ncxhd
READY | Test Stand | Frame | Aluminum Rect Tube 2" x 1" x (in) | 0 |  |  | 6546K393 | 0.45 | 0.00 | 0.00 | McMaster-Carr | http://www.mcmaster.com/#6546k393/=3ncxhd
READY | Test Stand | Frame | Aluminum Shaft .375" OD x (in) | 0 |  |  | 8974K32 | 0.28 | 0.00 | 0.00 | McMaster-Carr | http://www.mcmaster.com/#9062k15/=3ncyg9
READY | Test Stand | Test Fixture | Aluminum Shaft .5" OD x (in) | 0 |  |  | 9062K16 | 0.35 | 0.00 | 0.00 | McMaster-Carr | http://www.mcmaster.com/#9062k16/=3nczq8
READY | Test Stand | Test Fixture | Aluminum Shaft 1.5" OD x (in) | 0 |  |  | 9062K231 | 1.70 | 0.00 | 0.00 | McMaster-Carr | http://www.mcmaster.com/#9062k231/=3nd05p
READY | Test Stand | Frame | Aluminum Square Tube 1" x 1" x 6' | 1 | 1 |  | 88875K33 | 16.83 | 16.83 | 16.83 | McMaster-Carr | http://www.mcmaster.com/#88875k33/=3nd1dz
HOLD | Test Stand | Frame | Fabrication | 1 | 1 |  | L136145 | 650.00 | 650.00 | 650.00 | Integrated Ideas & Technologies, Inc
READY | Test Stand | Frame | Lazy Susan | 1 | 1 |  | 18635A52 | 31.59 | 31.59 | 31.59 | McMaster-Carr | http://www.mcmaster.com/#18635a52/=3nd17o
READY | Test Stand | Frame | Nylog Bushings 3/8" ID 3/8" length (5 ea) | 6 | 6 |  | 6389K625 | 2.26 | 13.56 | 13.56 | McMaster-Carr | http://www.mcmaster.com/#6389k625/=2bur0y
SOURCE | Test Stand | Test Fixture | Screw Disk | 1 | 1 | 0 |  | 50.00 | 50.00 | 50.00
READY | Test Stand | Frame | Shaft Collar 3/8" ID | 12 | 12 |  | 9946K13 | 1.91 | 22.92 | 22.92 | McMaster-Carr | http://www.mcmaster.com/#9946k13/=2butsl
READY | Test Stand | Frame | Shock Absorber | 1 | 1 |  | 23045T31 | 26.82 | 26.82 | 26.82 | McMaster-Carr | http://www.mcmaster.com/#23045t31/=3nd1vo
SOURCE | Test Stand | Power | Slip Ring - 4 Conductor, 500V, 2 @ 30A ea | 2 | 2 |  |  | 30.00 | 60.00 | 60.00 | Mercotac | http://www.mercotac.com/html/435.html
RCVD | Test Stand | Force Measurement | USB Scale | 0 | 1 | 1 | PEL1734773 | 47.55 | 0.00 | 47.55 | Amazon | http://www.amazon.com/gp/product/B001B0EYSW/ref=ord_cart_shr?ie=UTF8&m=AQNACJEM8PUJ1
RCVD | Tools | Tools | 6-Pin Stackable Female Header | 0 | 2 | 2 | PRT-09280 | 0.50 | 0.00 | 1.00 | Spark Fun | http://www.sparkfun.com/commerce/product_info.php?products_id=9280
SOURCE | Tools | Motor Propeller Test Set | Aluminum Square Tube 1" x 1" x 6' | 0 |  |  |  |  | 0.00 | 0.00
RCVD | Tools | Tools | DC Clamp Meter | 0 | 1 | 1 | 03473756000 | 109.99 | 0.00 | 109.99 | Craftsman | http://www.craftsman.com/shc/s/p_10155_12602_03473756000P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
RCVD | Tools | Tools | FTDI Breakout Board | 0 | 1 | 1 | DEV-10009 | 13.95 | 0.00 | 13.95 | Spark Fun | http://www.sparkfun.com/commerce/product_info.php?products_id=10009
RCVD | Tools | Tools | Nano-Oscilloscope | 0 | 1 | 1 | TOL-09625 | 99.99 | 0.00 | 99.99 | Spark Fun | http://www.sparkfun.com/commerce/product_info.php?products_id=9625
RCVD | Tools | Tools | Weight Scale | 1 | 1 | 1 | N/A | 8.49 | 8.49 | 8.49 | Amazon | http://www.amazon.com/Portable-Digital-Hangging-Luggage-Fishing/dp/B002GXO5E6/ref=pd_rhf_p_t_1
SOURCE | Tools | Motor Propeller Test Set | Aluminum Flat 2" x 12" | 1 | 1 |  |  |  | 0.00 | 0.00
READY | Vehicle | Control Board | 3.3V Multiplexer | 1 | 1 |  | 296-1645-5-ND | 0.75 | 0.75 | 0.75 | Digikey | http://search.digikey.com/scripts/DkSearch/dksus.dll?Detail&name=296-1645-5-ND
READY | Vehicle | Power | 3.3V Regulator | 0 | 2 | 2 | COM-00526 | 1.95 | 0.00 | 3.90 | Spark Fun | http://www.sparkfun.com/commerce/product_info.php?products_id=526
SOURCE | Vehicle | Frame | 3/16" Lock Collar | 8 | 8 |  | 6166K18 |  | 0.00 | 0.00 | McMaster-Carr | http://www.mcmaster.com/#shaft-collars/=9pbba5
READY | Vehicle | Frame | 3/32" Snap Ring (pk of 50) | 1 | 1 | 0 | 98408A112 | 8.48 | 8.48 | 8.48 | McMaster-Carr | http://www.mcmaster.com/#snap-rings/=9ck971
RCVD | Vehicle | Control Board | 32 KB EEPROM | 0 | 1 | 1 | 602-00032 | 1.50 | 0.00 | 1.50 | Parallax | http://www.parallax.com/Store/Microcontrollers/PropellerComponents/tabid/785/CategoryID/87/List/0/SortField/0/Level/a/ProductID/400/Default.aspx
READY | Vehicle | Power | 5V Regulator | 0 | 2 | 2 | COM-00107 | 1.25 | 0.00 | 2.50 | Spark Fun | http://www.sparkfun.com/commerce/product_info.php?products_id=107
RCVD | Vehicle | Frame | Air Frame | 0 | 0 | 1 | DF-COMPLETE-AIRFRAME | 200.00 | 0.00 | 0.00 | RC Toys | http://www.rctoys.com/rc-toys-and-parts/DF-COMPLETE-AIRFRAME/RC-PARTS-DRAGANFLYER-FRAME.html
SOURCE | Vehicle | Frame | Al Shaft | 4 | 4 |  | 6750K121 |  | 0.00 | 0.00 | McMaster-Carr | http://www.mcmaster.com/#aluminum/=9pbaxc
RCVD | Vehicle | Sensors | Altimeter | 0 | 1 | 1 | SEN-08161 | 54.95 | 0.00 | 54.95 | Spark Fun | http://www.sparkfun.com/commerce/product_info.php?products_id=8161
RCVD | Vehicle | Sensors | Altimeter Gasket | 0 | 1 | 1 | SEN-08925 | 0.95 | 0.00 | 0.95 | Spark Fun | http://www.sparkfun.com/commerce/product_info.php?products_id=8925
SOURCE | Vehicle | Frame | Aluminum Square Tube .5" | 0 |  |  |  |  | 0.00 | 0.00
READY | Vehicle | Power | Battery - 3 Cell Li-Poly 11.1V 5000 mAh 100A Continuous discharge | 2 | 2 | 0 | TP-5000-3SPL2 | 114.99 | 229.98 | 229.98 | RC Toys | http://www.rctoys.com/rc-toys-and-parts/TP-5000-3SPL2/RC-PARTS-THUNDER-POWER-PRO-LITE-LI-POLY-BATTERY.html
SOURCE | Vehicle | Power | Battery Charger | 1 | 1 | 0 | K-DF-BALANCECHARGER | 34.95 | 34.95 | 34.95 | RC Toys | http://www.rctoys.com/rc-toys-and-parts/K-DF-BALANCECHARGER/RC-PARTS-DRAGANFLYER-ELECTRONICS.html
READY | Vehicle | Power | Battery Harness | 1 | 1 | 0 | AM-8015 | 3.56 | 3.56 | 3.56 | Hobby King | http://www.hobbyking.com/hobbyking/store/uh_viewItem.asp?idProduct=7880
SOURCE | Vehicle | Frame | Bushing | 8 | 8 |  | 6627K11 |  | 0.00 | 0.00 | McMaster-Carr | http://www.mcmaster.com/#sleeve-bearings/=9od9ce
READY | Vehicle | Frame | Carbon Fiber Tubes | 2 | 2 | 0 | 2153t35 | 23.92 | 47.84 | 47.84 | McMaster-Carr | http://www.mcmaster.com/#carbon-fiber-tubing/=99jd7c
RCVD | Vehicle | Sensors | Compass | 0 | 1 | 1 | SEN-07915 | 59.95 | 0.00 | 59.95 | Spark Fun | http://www.sparkfun.com/commerce/product_info.php?products_id=7915
READY | Vehicle | Control Board | Ethernet connector | 1 | 1 | 0 | PRT-00643 | 1.50 | 1.50 | 1.50 | Spark Fun | http://www.sparkfun.com/commerce/product_info.php?products_id=643
READY | Vehicle | Power | Female Power Connector | 11 | 11 | 0 | EC3-M-WIR | 1.42 | 15.62 | 15.62 | Hobby King | http://www.hobbyking.com/hobbyking/store/uh_viewItem.asp?idProduct=8327
SOURCE | Vehicle | Frame | Foam Block | 0 |  |  |  |  | 0.00 | 0.00 | McMaster-Carr | http://www.mcmaster.com/#foam/=9p92sz
SOURCE | Vehicle | Frame | Gear | 8 | 8 | 0 | 57655K24 |  | 0.00 | 0.00 |  | http://www.mcmaster.com/#nylon-gears/=9oh6bk
RCVD | Vehicle | Sensors | GPS | 0 | 1 | 1 | GPS-08975 | 59.95 | 0.00 | 59.95 | Spark Fun | http://www.sparkfun.com/commerce/product_info.php?products_id=8975
ORDER | Vehicle | Control Board | Landing Lights | 4 | 4 | 0 | COM-08579 | 12.95 | 51.80 | 51.80 | Spark Fun | http://www.sparkfun.com/products/8579
SOURCE | Vehicle | Frame | Lexan .125" | 0 |  |  | 8560K239 |  | 0.00 | 0.00 | McMaster-Carr | http://www.mcmaster.com/#plastics/=9pb9q1
SOURCE | Vehicle | Frame | Lexan .25" | 0 |  |  | 8560K354 |  | 0.00 | 0.00 | McMaster-Carr | http://www.mcmaster.com/#plastics/=9pba0x
READY | Vehicle | Power | Male Power Connector | 10 | 10 | 0 | EC3-F-WIR | 1.23 | 12.30 | 12.30 | Hobby King | http://www.hobbyking.com/hobbyking/store/uh_viewItem.asp?idProduct=8328
READY | Vehicle | Control Board | Mini-SD Card connector | 1 | 1 | 0 | PRT-00127 | 3.95 | 3.95 | 3.95 | Spark Fun | http://www.sparkfun.com/commerce/product_info.php?products_id=127
ORDER | Vehicle | Power | Motor | 8 | 8 | 0 | TR28-30B-1050 | 10.79 | 86.32 | 86.32 | Hobby King | http://www.hobbyking.com/hobbyking/store/uh_viewItem.asp?idProduct=2112
RCVD | Vehicle | Frame | Motor Couplers | 0 | 0 | 10 | N/A | 10.00 | 0.00 | 0.00 | Ryan Basilisk
RCVD | Vehicle | Control Board | Opto-Isolator | 0 | 0 | 2 | COM-00784 | 2.25 | 0.00 | 0.00 | Spark Fun | http://www.sparkfun.com/commerce/product_info.php?products_id=784
READY | Vehicle | Control Board | Primary Controller - SOM Board | 1 | 1 | 0 | SoM-9260 | 150.00 | 150.00 | 150.00 | Emac Inc | http://www.emacinc.com/som/som9260.htm
ORDER | Vehicle | Frame | Propeller (pusher/puller) | 4 | 4 | 0 | APC-10-047-SF-CR | 9.90 | 39.60 | 39.60 | RC Toys | http://www.rctoys.com/rc-toys-and-parts/APC-10-047-SF-CR/RC-PARTS-APC-PROPELLERS.html
RCVD | Vehicle | Control Board | Propeller Processor | 0 | 1 | 1 | P8X32A-D40 | 7.99 | 0.00 | 7.99 | Parallax
ORDER | Vehicle | Sensors | Razor 9DOF INU | 1 | 1 | 0 | SEN-09623 | 124.65 | 124.65 | 124.65 | Spark Fun | http://www.sparkfun.com/commerce/product_info.php?products_id=9623
READY | Vehicle | Frame | RGB Led | 16 | 16 | 0 | COM-00105 | 1.95 | 31.20 | 31.20 | Spark Fun | http://www.sparkfun.com/commerce/product_info.php?products_id=105
RCVD | Vehicle | Control Board | Right Angle Header | 0 | 1 | 1 | PRT-00553 | 1.95 | 0.00 | 1.95 | Spark Fun | http://www.sparkfun.com/commerce/product_info.php?products_id=553
READY | Vehicle | Control Board | Serial Converter | 1 | 1 | 0 | COM-00316 | 1.95 | 1.95 | 1.95 | Spark Fun | http://www.sparkfun.com/commerce/product_info.php?products_id=316
READY | Vehicle | Control Board | Servo | 4 | 4 | 0 | 9306MG | 12.46 | 49.84 | 49.84 | Hobby King | http://www.hobbyking.com/hobbyking/store/uh_viewItem.asp?idProduct=8610
READY | Vehicle | Control Board | SODIMM Connector | 1 | 1 | 0 | 390322-1 | 4.19 | 4.19 | 4.19 | Arrow NAC | http://app.arrownac.com/aws/pg_webc?s=P
ORDER | Vehicle | Power | Speed Controller | 8 | 8 | 0 | TAE-25A | 10.58 | 84.64 | 84.64 | Hobby King | http://www.hobbyking.com/hobbyking/store/uh_viewItem.asp?idProduct=11616
SOURCE | Vehicle | Frame | Steel Guide Wire | 0 |  |  |  |  | 0.00 | 0.00 | McMaster-Carr | http://www.mcmaster.com/#steel-wire/=9pb8lh
READY | Vehicle | Power | Tilt Servo | 4 | 4 | 0 | 9306MG | 12.46 | 49.84 | 49.84 | Hobby King | http://www.hobbyking.com/hobbyking/store/uh_viewItem.asp?idProduct=8610
RCVD | Vehicle | Sensors | Ultrasonic | 0 | 1 | 1 | SEN-08503 | 27.95 | 0.00 | 27.95 | Spark Fun | http://www.sparkfun.com/commerce/product_info.php?products_id=8503
ORDER | Vehicle | Sensors | Ultrasonic | 6 | 6 | 0 | SEN-08504 | 27.95 | 167.70 | 167.70 | Spark Fun | http://www.sparkfun.com/products/8504
READY | Vehicle | Control Board | USB Host connector | 1 | 1 | 0 | PRT-09011 | 1.25 | 1.25 | 1.25 | Spark Fun | http://www.sparkfun.com/commerce/product_info.php?products_id=9011
READY | Vehicle | Sensors | Video Camera | 1 | 1 | 0 | CN20012RX45 | 57.92 | 57.92 | 57.92 | Hobby King | http://www.hobbyking.com/hobbyking/store/uh_viewItem.asp?idProduct=13438
RCVD | Vehicle | Control Board | XBee 2mm Socket | 0 | 2 | 2 | PRT-08272 | 1.00 | 0.00 | 2.00 | Spark Fun | http://www.sparkfun.com/commerce/product_info.php?products_id=8272
RCVD | Vehicle | Control Board | XBee Radio Breakout | 0 | 1 | 1 | BOB-08276 | 2.95 | 0.00 | 2.95 | Spark Fun | http://www.sparkfun.com/commerce/product_info.php?products_id=8276
READY | Tools | Motor Propeller Test Set | Temperature Sensor | 1 | 1 | 0 | SEN-09570 | 19.95 | 19.95 | 19.95 | Spark Fun | http://www.sparkfun.com/products/9570
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
 |  |  |  |  |  |  |  |  | 0.00 | 0.00
 |  |  |  |  |  |  |  |  | 0.00 | 0.00
 |  |  |  |  |  |  |  |  | 0.00 | 0.00
 |  |  |  |  |  |  |  |  | 0.00 | 0.00
 |  |  |  |  |  |  |  |  | 0.00 | 0.00
 |  |  |  |  |  |  |  |  | 0.00 | 0.00
 |  |  |  |  |  |  |  |  | 0.00 | 0.00

Sheet: Costs
 |  | System Cost: | System Total: | Un-Funded: | Funded: | Perc Funded
Funded Percentage: | 16.27826055% | Remote Control: | 506.40 | 240.85 | 265.55 | 52.44%
 |  | Test Stand: | 1119.27 | 1071.72 | 47.55 | 4.25%
 |  | Ground Control Station: | 2270.54 | 1926.89 | 343.65 | 15.14%
 |  | Vehicle: | 1477.89 | 1259.83 | 218.06 | 14.75%
 |  | Total: | 5374.10 | 4499.29 | 874.81 | 16.28%

Sheet: Data
Ground Station
Remote Control
System
Test Stand
Vehicle
RCVD
ORDER
HOLD
SOURCE
