mwelling/robot-chopper/Vehicle/Documentation/ComponentSelection.xls

Sheet: Altimeter
Specification | Minimum Requirement | Altimeter
 |  | SEN-08161
Measurement Range |  | 30 – 120 kPa
Resolution |  | 1.5 Pa
Refresh Rate |  | 1.8 Hz/9 Hz
Comm Protocol |  | SPI
Input Voltage |  | 2.4 – 3.3 Volts
Current Draw |  | 25 uA
Size |  | .56 in^2
Weight
Price |  | 34.95
Other Features |  | High Resolution Mode/High Speed Mode
Vendor |  | Spark Fun
Website |  | Link (http://www.sparkfun.com/commerce/product_info.php?products_id=8161)

Sheet: Compass
Specification | Minimum Requirement | Compass
 |  | SEN-07915
Resolution |  | .5 Deg
Repeatability |  | 1 Deg
Refresh Rate |  | 1 – 20 Hz
Field Range |  | .75 Gauss
Comm Protocol |  | I2C
Input Voltage |  | 2.7 – 5.2 Volts
Current Draw |  | 10 mA
Size |  | 1.5 in^2
Weight
Price |  | $34.95
Other Features
Vendor |  | Spark Fun
Website |  | Link (http://www.sparkfun.com/commerce/product_info.php?products_id=7915)

Sheet: INU
Specification | Minimum Requirement | INU | INU
 |  | SEN-09623 | SEN-10010
DOF | 6 | 9 | 6
Accelerometer Specifications |  | 3-Axis, 13 bit, +/-16g | 3-Axis, 300mV/g,+/- 3g
Gyroscope Specifications |  | 3-Axis 300 deg/sec | .83 mV/deg/sec, 300 deg/sec
Magnetometer Specifications |  | 3-Axis, digital | -
Comm Protocol |  | Serial | Analog
Input Voltage |  | 3.5V-16V | 2.7-3.6 V
Current Draw
Size |  | 49.53mm x 27.94mm
Weight
Price |  | $124.95 | $89.95
Other Features |  | Full AHRS code
Vendor |  | Spark Fun | Spark Fun
Website |  | Link (http://www.sparkfun.com/products/9623) | Link (http://www.sparkfun.com/products/10010)

Sheet: Ultrasonic
Specification | Minimum Requirement | Ultrasonic | Ultrasonic
 |  | SEN-08503 | 28015
Refresh Rate |  | 20 Hz | 50 Hz
Resolution |  | 1 inch
Range |  | 6 – 254 in | 1 – 118 in
Operating frequency |  | 42 kHz | 40 kHz
Comm Protocol |  | Analog, Serial, PWM | ECCP
Input Voltage |  | 2.5 – 5.5 Volts | 5 Volts
Current Draw |  | 2 mA | 35 mA
Size |  | .69 in^2 | 1.5 in^2
Weight
Price |  | $27.95 | $29.99
Other Features |  | Multiple comm protocols
Vendor |  | Spark Fun | Parallax
Website |  | Link (http://www.sparkfun.com/commerce/product_info.php?products_id=8503) | Link (http://www.parallax.com/Store/Sensors/ObjectDetection/tabid/176/CategoryID/51/List/0/Level/a/ProductID/92/Default.aspx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,ProductName)

Sheet: GPS
Specification | Minimum Requirement | GPS | GPS | GPS
 |  | GPS-08975 | SEN-00465 | GPS-08621
Refresh Rate | 1 Hz | 5 Hz | N/A | N/A
Channels | 12 | 32 | 20 | 20
Position accuracy |  | 3 meters | 10 meters | 10 meters
Sensitivity |  | N/A | -159 dBm | -3.5 dB
Comm Protocol | Serial - NMEA | Serial - NMEA | Serial - NMEA | Serial - NMEA
Input Voltage |  | 3.3 Volts | 4.5 – 6.5 Volts | 3.1 – 3.5 Volts
Current Draw |  | 41 mA | 44 mA | 82 mA
Size |  | 1.5 in^2 | 1.2 in^2 | 5 in^2
Weight
Price |  | 59.95 | 59.95 | 89.95
Other Features |  | LED Fix Indicator, WAAS, battery backup | LED Fix Indicator, GPS Time Sync output, battery backup | Helical Antenna, GPS Time Sync output, battery backup
Vendor |  | Spark Fun | Spark Fun | Spark Fun
Website |  | Link (http://www.sparkfun.com/commerce/product_info.php?products_id=8975) | Link (http://www.sparkfun.com/commerce/product_info.php?products_id=465) | Link (http://www.sparkfun.com/commerce/product_info.php?products_id=8621)

Sheet: Video Camera
Specification | Minimum Requirement | FPV System | FPV System | FPV System
 |  | CN10024RX4T | CN20012RX45
Frequency |  | 2.4 GHz | 900 MHz
Tx Power |  | 100 mW | 200 mW
Video Resolution |  | 510(H) x 492(V) | 510(H) x 492(V)
Video Format | NTSC | NTSC | NTSC
Input Voltage |  | 9-12V | 9-12V
Current Draw |  | 80 mA | 80 mA
Size
Weight
Price |  | $57.92 | $57.92
Other Features
Vendor |  | Hobby King | Hobby King
Website |  | Link (http://www.hobbyking.com/hobbyking/store/uh_viewItem.asp?idProduct=13440) | Link (http://www.hobbyking.com/hobbyking/store/uh_viewItem.asp?idProduct=13438) | Link

Sheet: Frame
Specification | Minimum Requirement | 2153T35 | 88875K31 | Unknown | Unknown
Material |  | Carbon Fiber | Aluminum | Aluminum | Aluminum
Wall Thickness (in) |  | 0.048 | 0.125 | 0.0625 | 0.0625
Geometry |  | Tubular | Square | Square | Square
Dimensions |  | 0.254 | 0.75 | 0.5 | 0.25
Density (oz/in^3) |  | 1.0288 | 1.5600 | 1.5600 | 1.5600
Weight per ft (oz) |  | 0.3833 | 5.8500 | 2.0475 | 0.8775
Price per ft |  | $5.98 | $1.64
Price |  | $23.92 | $9.85
Other Features |  | Must use diamond tools, Light
Vendor |  | McMaster-Carr | McMaster-Carr
Website |  | Link (http://www.mcmaster.com/) | Link (http://www.mcmaster.com/) | Link | Link

Sheet: Landing Lights
Specification | Minimum Requirement | LED Driver 280 | BlinkM COM-08579 | BlinkM COM-08580
Channels |  | 16 | N/A | N/A
Package |  | 28Pin-DIP | Module | Module
Input Voltage |  | 5.6-20V | 5V | 5V
Current Consumption |  | 15 mA | 60 Ma | 250 mA
Intensity |  | N/A | 8000 mcd | 445000 mcd
Communication Method |  | Serial | I2C | I2C
Weight
Size |  |  | .75" x .75" | 1.5" x 1.5"
Price |  | $26.95 | $12.95 | $24.95
Other Features |  | Serial Baud Rate Auto-Detect
Vendor |  | Pololu | SparkFun | SparkFun
Website |  | Link (http://www.pololu.com/catalog/product/280/resources) | Link (http://www.sparkfun.com/products/8579) | Link (http://www.sparkfun.com/products/8579)

Sheet: Propeller
Specification | Minimum Requirement | Propeller | Propeller | Propeller
 |  | APC-10-047-SF-CR | APC-12-038-SF-CR
Length (in) |  | 10" | 12"
Pitch |  | 4.7 | 3.8
Material |  | 1-piece composite | 1-piece composite
Shaft size
Weight
Price |  | $9.90 | $12.95
Other Features |  | Pusher and Puller | Pusher and Puller
Vendor |  | RC Toys | RC Toys
Website |  | Link (http://www.rctoys.com/rc-toys-and-parts/APC-10-047-SF-CR/RC-PARTS-APC-PROPELLERS.html) | Link (http://www.rctoys.com/rc-products/APC-12-038-SF-CR.html) | Link

Sheet: Battery
Specification | Minimum Requirement | DF-BATT1350-BALANCE | TP-2100-3SPL2 | TP-5000-3SPL2
Chemistry | LiPo | Lipo | Lipo | Lipo
Nominal Voltage |  | 11.1 V (3 cells) | 11.1 (3 cells) | 11.1 (3 cells)
Cell Count |  |  | 6 | 6
Charge/Discharge Cycles |  | 150
Continuous Discharge |  | 27A | 42A | 100A
Max Discharge |  |  | 84 A | 200 A
Capacity (mAh) |  | 1350 | 2100 | 5000
Size |  | 19 x 34 x 65 mm | 21 x 35 x 103 mm | 28 x 43 x 136 mm
Weight (oz) |  | 3.03 | 5.183 | 12.73
Capacity/Weight (mAh/oz) |  | 445.5446 | 405.1708 | 392.7730
Capacity/Volume (mAh/mm^3) |  | 0.0322 | 0.0277 | 0.0305
Price |  | $59.95 | $47.99 | $114.99
Other Features |  | Balance Connector, Wired Connectors,OEM | Balance Connector | Balance Connector
Vendor |  | RC Toys | RC Toys | RC Toys
Website |  | Link (http://www.rctoys.com/rc-toys-and-parts/DF-BATT1350-BALANCE/RC-PARTS-DRAGANFLYER-ELECTRONICS.html) | Link (http://www.rctoys.com/rc-toys-and-parts/TP-2100-3SPL2/RC-PARTS-THUNDER-POWER-PRO-LITE-LI-POLY-BATTERY.html) | Link (http://www.rctoys.com/rc-toys-and-parts/TP-5000-3SPL2/RC-PARTS-THUNDER-POWER-PRO-LITE-LI-POLY-BATTERY.html)

Sheet: ESC
Specification | Minimum Requirement | ESC | ESC | ESC
 |  | HK-SS20A-HW | TR_B18 | TAE-25A
Type | Brushless | Brushless | Brushless | Brushless
Battery Cells | 3S | 2S, 3S | 3S | 2S,3S,4S
Max Continuous Current |  | 18 A | 18 A | 25 A
Peak Current |  | 20 A | 22 A | 35 A
BEC? | Yes | 2 A | 5 V/2 A | 5 V/2 A
Weight |  | 19 g | 19 g | 24 g
Price |  | $7.80 | $13.99 | $10.58
Other Features |  | Programmable |  | Programmable
Vendor |  | Hobby King | Hobby King | Hobby King
Website |  | Link (http://www.hobbyking.com/hobbyking/store/uh_viewItem.asp?idProduct=6548) | Link (http://www.hobbyking.com/hobbyking/store/uh_viewItem.asp?idProduct=2168) | Link (http://www.hobbyking.com/hobbyking/store/uh_viewItem.asp?idProduct=11616)

Sheet: Motor
Specification | Minimum Requirement | Motor | Motor | Motor
 |  | BA-BL290S | TR28-30B-1050 | KDA20-22L
Type | Brushless | Brushless | Brushless | Brushless
Style | Outrunner | Outrunner | Outrunner | Outrunner
Max Voltage
Kv (rpm/V) |  | 1200 | 1050 | 924
Power
Stall Current |  | 25 A | 14 A | 17 a
Suggested Prop |  |  | 10x5 or 10x6 | 11x4.7
Thrust |  |  | 400-900 g
Weight |  | 44 g | 58 g | 56 g
Price |  | $20.80 | $10.79 | $14.72
Other Features |  |  |  | Not In Stock
Vendor |  | Hobby King | Hobby King | Hobby King
Website |  | Link (http://www.hobbyking.com/hobbyking/store/uh_viewItem.asp?idProduct=5228) | Link (http://www.hobbyking.com/hobbyking/store/uh_viewItem.asp?idProduct=2112) | Link (http://www.hobbyking.com/hobbyking/store/uh_viewItem.asp?idProduct=4700)

Sheet: Tilt Servo
Specification | Minimum Requirement | Servo | Servo
 |  | ROB-09065 | 9306MG
Type |  | Small | Mini
Max Voltage | 6V | 6V | 6V
Torque@6V (kg-cm,oz-in) |  | 1.4kg-cm,19.6oz-in | 1.8kg-cm,
Speed@6V (sec/deg) |  | .1sec/60 deg | .14sec/60 deg
Size |  | 22.8 mm x 11.8 mm x 20.6 mm | 23 mm x 22.5 mm x 10 mm
Weight |  | 9g | 7.4 g
Price |  | $8.95 | $12.46
Other Features
Vendor |  | Spark Fun | Hobby King
Website |  | Link (http://www.sparkfun.com/products/9065) | 1 (http://www.hobbyking.com/hobbyking/store/uh_viewItem.asp?idProduct=8610) | Link

Sheet: XBee Radio
Specification | Minimum Requirement | Radio | Radio | Radio
 |  | WRL-08768 | WRL-09411 | WRL-09099
Type |  | XBee | XBee | Xbee
Range |  | 1 mile | 40 miles | 6 miles
Operating Frequency |  | 2.4 GHz | 900 MHz | 900 MHz
Output |  | 50 mW/17dBm | 1 W/30 dBm | 50 mW/17dBm
Comm Protocol | Serial | Serial | Serial | Serial
IEEE Protocol |  | 802.15.4 | N/A
Data Throughput |  | 115200 max |  | 115200 max
Input Voltage |  | 3.3V | 5V | 3.3V
Current Draw |  | 295 mA | 730 mA | 210 mA
Size |  | 2 in^2 | 4 in^2 | 2 in^2
Price |  | $44.95 | $184.95 | $44.95
Other Features |  | Mesh Network capable | Mesh Network capable, uses FHSS, maximum power legally available | No Mesh Networking
Vendor |  | Spark Fun | Spark Fun | Spark Fun
Website |  | Link (http://www.sparkfun.com/commerce/product_info.php?products_id=8768) | Link (http://www.sparkfun.com/commerce/product_info.php?products_id=9411) | Link (http://www.sparkfun.com/products/9099)

Sheet: Cellular Radio
Specification | Minimum Requirement | Radio | Radio | Radio
 |  | CEL-09342
Type |  | Evaluation Board
Operating Bands |  | Quad
Radio Present? | YES | YES
SIM Card Socket? | YES | YES
Antenna |  | U.FL Antenna connector
Data Throughput
Input Voltage
Current Draw
Size
Price |  | $149.95
Other Features
Vendor |  | Spark Fun
Website |  | Link (http://www.sparkfun.com/products/9342)
