mwelling/robot-chopper/RemoteControl/Documentation/ComponentSelection.xls

Sheet: Wi-Fi
Specification | Minimum Requirement | WiFly GSX
 |  | WRL-09333
Wi-Fi Mode |  | 2.4 GHz, 802.11 b/g
Comm Protocol | UART | UART, up to 1 Mbps
Air Transmission |  | 1 -11 Mbps (802.11b) 6 - 54 Mbps (802.11g)
Input Voltage |  | 3.3 V
Current Draw |  | 4 uA Sleep, 210 mA Tx, 40 mA Rx
Size |  | 1.2" x 1.8"
Weight
Price |  | $84.95
Other Features
Vendor |  | Spark Fun
Website |  | Link (http://www.sparkfun.com/products/9333)

Sheet: Bluetooth
Specification | Minimum Requirement | BlueSMiRF RP-SMA | Rayson
 |  | WRL-00158 | WRL-09977
Antenna |  | RP-SMA | Trace
Comm Protocol | UART | UART | UART
Air Transmission
Input Voltage |  | 3.3V-6V | 3.3V
Current Draw |  | 25 mA | 58 mA Tx,2.4 mA Rx
Size |  | .15" x .6" x 1.9" | 25mm x 14.5mm x 2.2mm
Weight
Price |  | $64.95 | $44.95
Other Features |  | Co-exists with ZigBee,802.11 | Co-exists with 802.11
Vendor |  | Spark Fun | Spark Fun
Website |  | Link (http://www.sparkfun.com/products/158) | Link (http://www.sparkfun.com/products/9977)

Sheet: Audio Output
http://www.parallax.com/StoreSearchResults/tabid/768/txtSearch/audio/List/0/SortField/4/ProductID/108/Default.aspx
http://www.rcsys.com/modules.htm
