mwelling/robot-chopper/TestStand/Documentation/TestStandBOM.xls

Subsystem | Part Name | Material (unit) | Part Number | Quantity | Unit Cost | Cost | Vendor | Reference
Arm | Main Arm | Aluminum Rect Tube 2" x 1" x (in) |  | 36 |  | 0
Arm | Rear Short Arm | Aluminum Rect Tube 2" x 1" x (in) |  | 1 |  | 0
Arm | Weight | Lead Shot (kg) |  | 5 |  | 0
Arm | Lock Collar | Lock Collar 3/8" ID (ea) |  | 12 |  | 0
Arm | Weight Box | Aluminum Rect Tube 2" x 1" x (in) |  | 10 |  | 0
Arm | Long Arm | Aluminum Rect Tube 2" x 1" x (in) |  | 192 |  | 0
Arm | Front Short Arm | Aluminum Rect Tube 2" x 1" x (in) |  | 34.5 |  | 0
Arm | Bushing | Plastic Bushing 3/8" ID |  | 36 |  | 0
Arm | Pin | Aluminum Shaft 3/8" OD x (in) |  | 30.75 |  | 0
Base | Bottom Bracket | Aluminum L Angle 1.5" x 1.5" x (in) |  | 36 |  | 0
Base | Lazy Susan | Lazy Susan 10.35" ID |  | 1 |  | 0
Base | Brace | Aluminum Square Tube 1" x 1" x (in) |  | 44 |  | 0
Base | Bracket Spacer | Aluminum Rect Tube 2" x 1" x (in) |  | 12 |  | 0
Shock Absorber | Shock Absorber | N/A |  | 1 |  | 0 | McMaster-Carr
Test Fixture | Bracket | Aluminum L Angle 1.5" x 1.5" x (in) |  | 4 |  | 0
Test Fixture | Screw Disk |  |  | 1 |  | 0
Test Fixture | Peg | Aluminum Shaft 1/2" OD x (in) |  | 1.5 |  | 0
Test Fixture | Top Disk |  |  | 1 |  | 0
