mwelling/robot-chopper/Documentation/Design Report Appendix/Test Stand Calculations.xlsx

Sheet: CAD Design Parameters
Measurements from CAD Design | Length (m)
Nominal Height(Arm Ɵ=90°) : | 1.139
Max Height (Arm Binding, Ɵ=155°): | 1.84
Min Height (Arm Ɵ=82°): | 1.05

Sheet: Physical Properties
Test-Stand Physical Properties
Item | Mass (kg) | Δd (from rotation center, Left negative)) (m) | Quantity | Torque (kg*m)
Weight Box | 0.127 | 0.4826 | 1 | 0.0612902
Shock Absorber | 0.356 | -0.762 | 1 | -0.271272
Test Fixture | 0.134 | -0.762 | 1 | -0.102108
Back Arm | 0.251 | 0.4572 | 1 | 0.1147572
Front Arm | 0.544 | -0.762 | 1 | -0.414528
Long Arm, Left | 0.476 | -0.762 | 4 | -1.450848
Long Arm, Right | 0.285 | 0.4572 | 4 | 0.521208
Back Hinge | 0.06 | 0.4318 | 2 | 0.051816
Front Hinge | 0.06 | -0.7366 | 2 | -0.088392

Sheet: Weight Box Calculations
Torque =
To solve for weight in weight box:
 |  | -1.5780766 | (kg*m)
 |  |  | 3.269947368 | (kg) | Lead Density: | 11.37 | g/cm^3)
Using Lead Shot as a counter-weight:
 |  |  |  |  | Weight Box width: | 2.54 | (cm)
 |  |  |  |  | Weight Box length: | 5.08 | (cm)
 |  |  |  |  | Weight Height: | 22.28860404 | (cm)
 |  |  |  |  | Weight Box Height:
 | Results: Need approximately 3.27 kg of lead to fulfill requirement of counter-weighting the weight of the Test-Stand. This weight will take up approximately 22.29 cm of the Weight Box, leaving 3.11 cm of room left in the Weight Box for error.
