mwelling/robot-chopper/RemoteControl/Documentation/Power Analysis.xlsx

Component | Power Source | Voltage | Current (Worst Case) (mA) | Current (Standby) (mA) | Power Dissipated (Worst Case) (mW) | Power Dissipated (Standby) (mW) | Notes
3.3V Boost Converter | Battery | 2.4 | 400 | 400
5V Boost Converter | Battery | 2.4 | 800 | 800
Propeller | 3.3V Boost Converter | 3.3 | 100 | 80 | 330 | 264
Xbee Radio | 3.3V Boost Converter | 3.3 | 215 | 0.01 | 709.5 | 0.033
24LC256 | 3.3V Boost Converter | 3.3 | 3 | 3 | 9.9 | 9.9
10 Segment LED | 3.3V Boost Converter | 3.3 | 33 | 3.3 | 108.9 | 10.89 | Worst Case: All 10 LED's On. Standby: 1 LED On.
GPS | 3.3V Boost Converter | 3.3 | 41 | 41 | 135.3 | 135.3
LCD | 5V Boost Converter | 5 | 60 | 3 | 300 | 15
MCP3208 | 3.3V Boost Converter | 3.3 | 0.4 | 0.4 | 1.32 | 1.32
74HC148 | 3.3V Boost Converter | 3.3 | 50 | 50 | 165 | 165
 |  |  |  |  | 0 | 0
System Total | Required Current (mA) | Available Current (mA) | Excess Current (mA)
3.3V Source | 442.4 | 800 | 357.6
5V Source | 60 | 400 | 340
 | Worst Case (mW) | Standby (mW)
Power Dissipated | 1759.92 | 601.443
Battery Capacity: | Current (mAh) | Voltage (V) | Power (mWh)
 | 2500 | 2.4 | 6000
Expected Run-Time (Worst Case): | 3.41 | hrs
Expected Run-Time (Standby): | 9.98 | hrs
