mwelling/robot-chopper/Ground Station/Documentation/Media/ManualTab.png

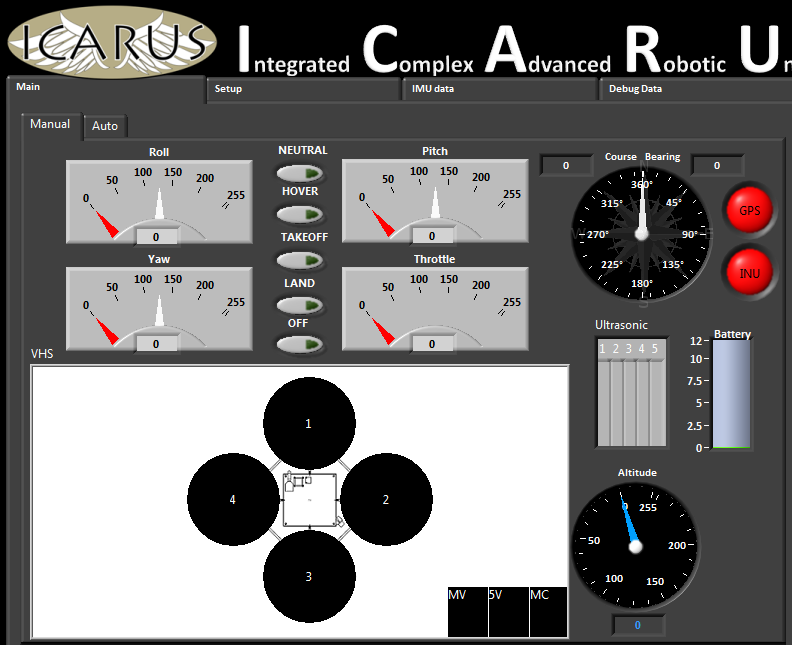
Ground Station/Documentation/Media/ManualTab.png
