mwelling/robot-chopper/TestStand/Design/TestFixtureAssy/TestFixtureAssy.pdf

Robo Chopper Test Stand Test Fixture Assembly

David Gitz 9-Sep-09
