mwelling/robot-chopper/Analysis/Accelerometer/FilterResultsXAxis.png

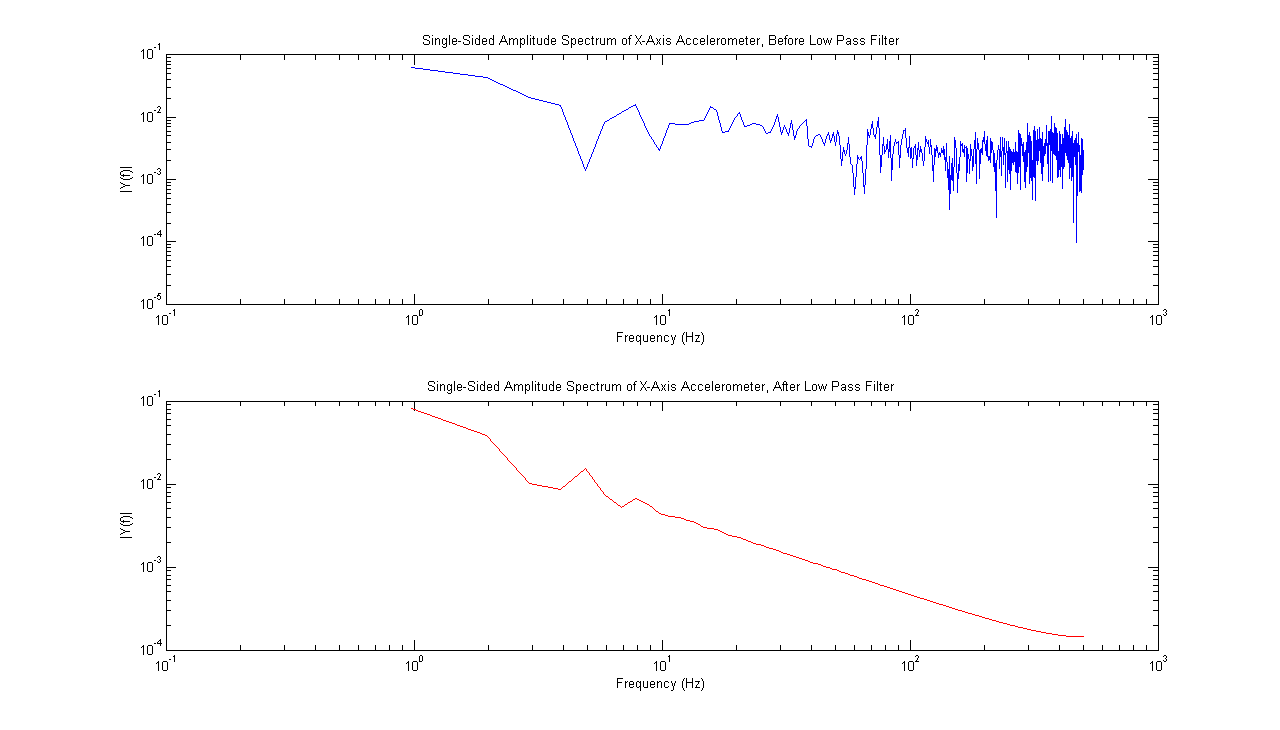
Analysis/Accelerometer/FilterResultsXAxis.png
