mwelling/robot-chopper/Analysis/Communications/RF DAQ/Matlab/Results/115200H.png

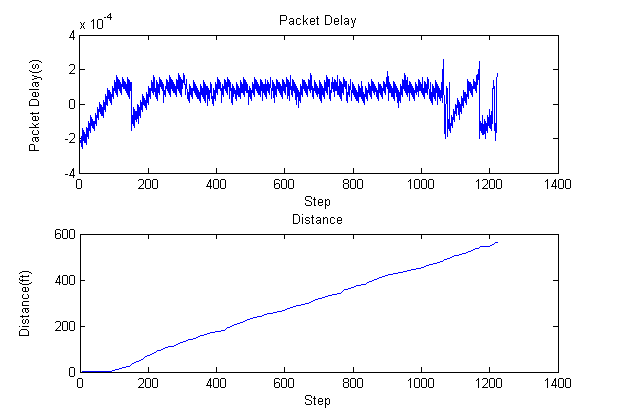
Analysis/Communications/RF DAQ/Matlab/Results/115200H.png
