mwelling/robot-chopper/Analysis/INU Calibration/Complimentary Filter.png

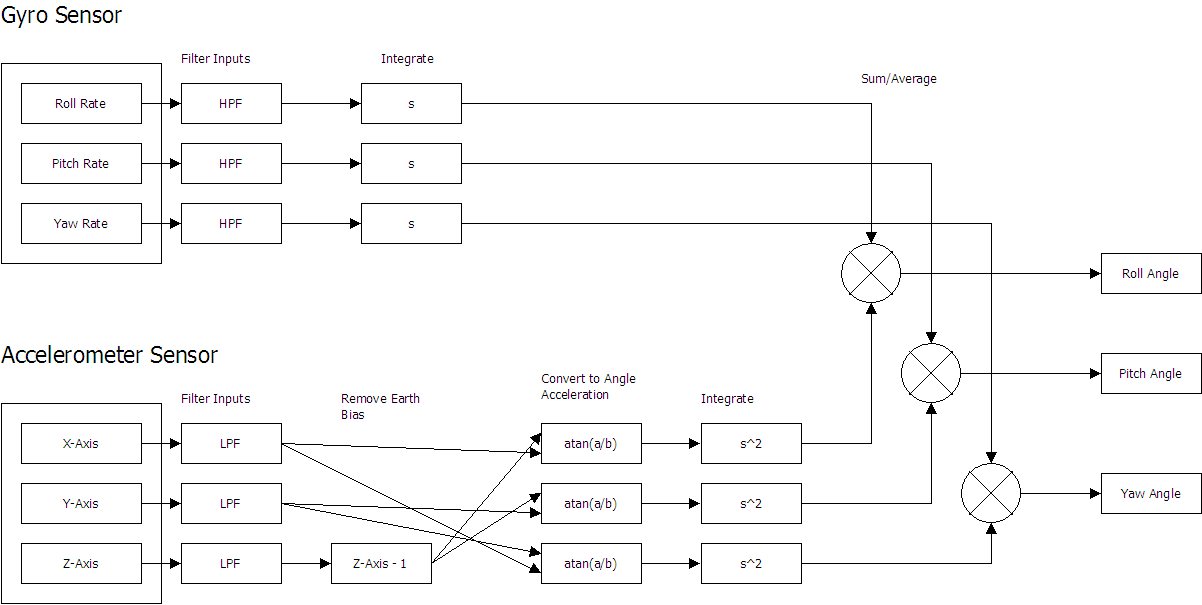
Analysis/INU Calibration/Complimentary Filter.png
