mwelling/robot-chopper/Documentation/NetworkTest.png

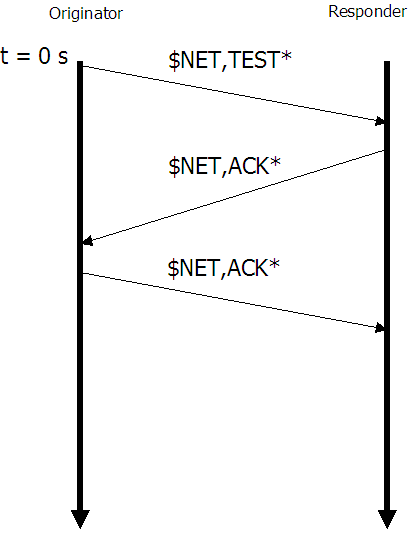
Documentation/NetworkTest.png
