mwelling/robot-chopper/Media/Test-Stand/TestStandAssywoVehicle.png

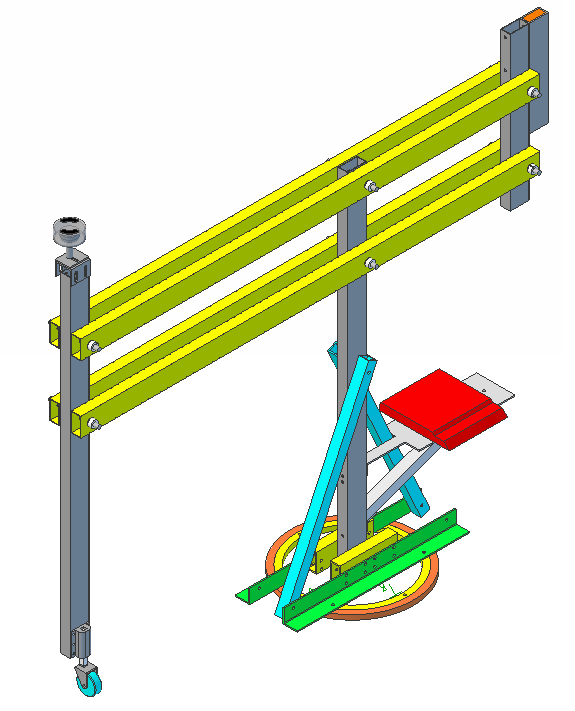
Media/Test-Stand/TestStandAssywoVehicle.png
