mwelling/robot-chopper/Media/Test-Stand/TestStandAssywVehicle.png

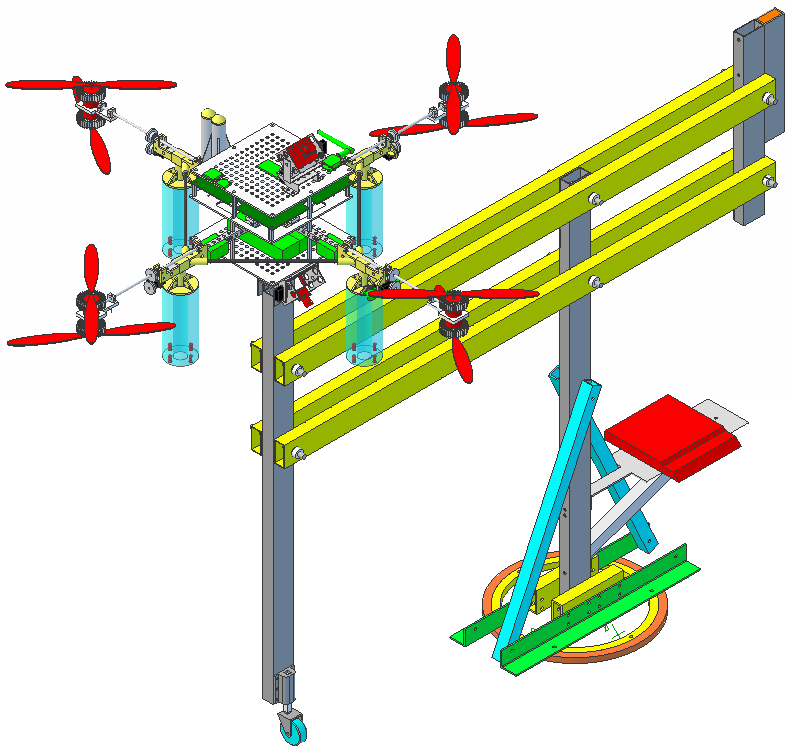
Media/Test-Stand/TestStandAssywVehicle.png
