mwelling/robot-chopper/Media/Vehicle/Prototype/TestFixtureSystem.png

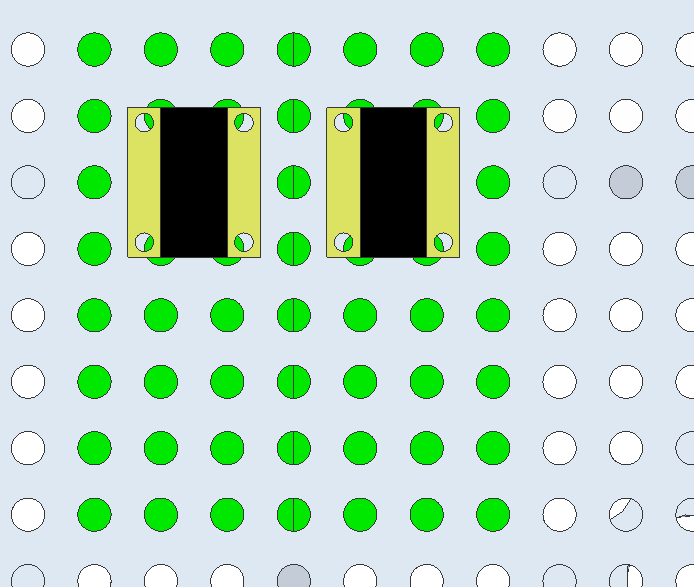
Media/Vehicle/Prototype/TestFixtureSystem.png
