mwelling/robot-chopper/TestStand/Documentation/Neutral.PNG

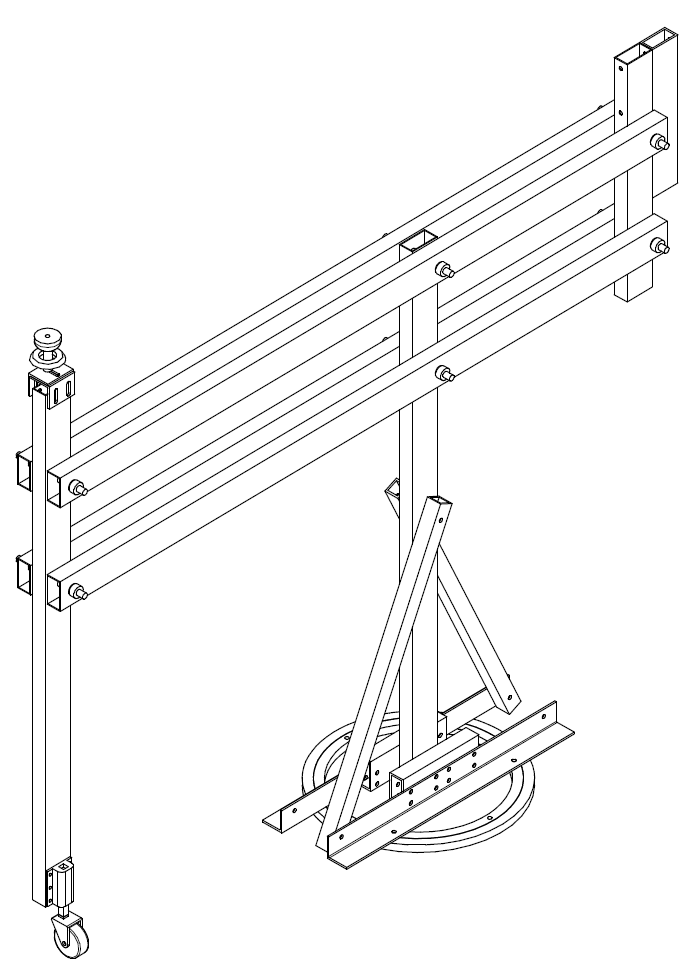
TestStand/Documentation/Neutral.PNG
