mwelling/robot-chopper/TestStand/Design/TestStandAssemblySchematic.pdf

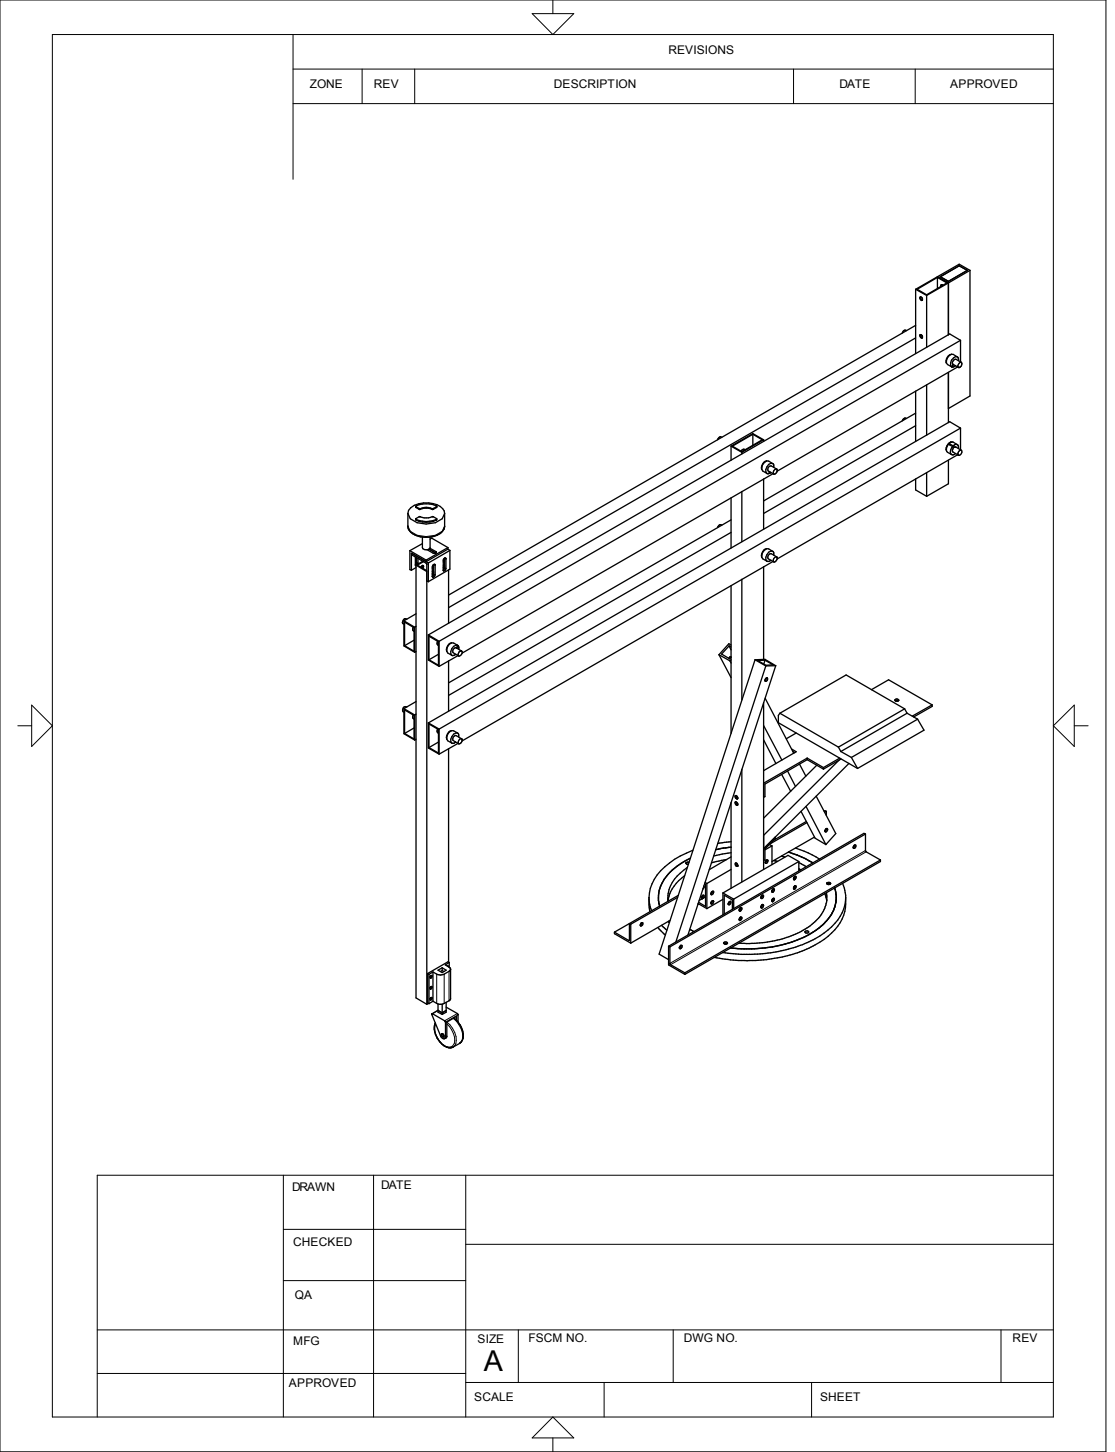
[picture p188: page 1]

REVISIONS

ZONE | REV | DESCRIPTION | DATE | APPROVED

DRAWN | DATE

CHECKED

MFG | | SIZE A | FSCM NO. | DWG NO. | REV

APPROVED

SCALE | SHEET

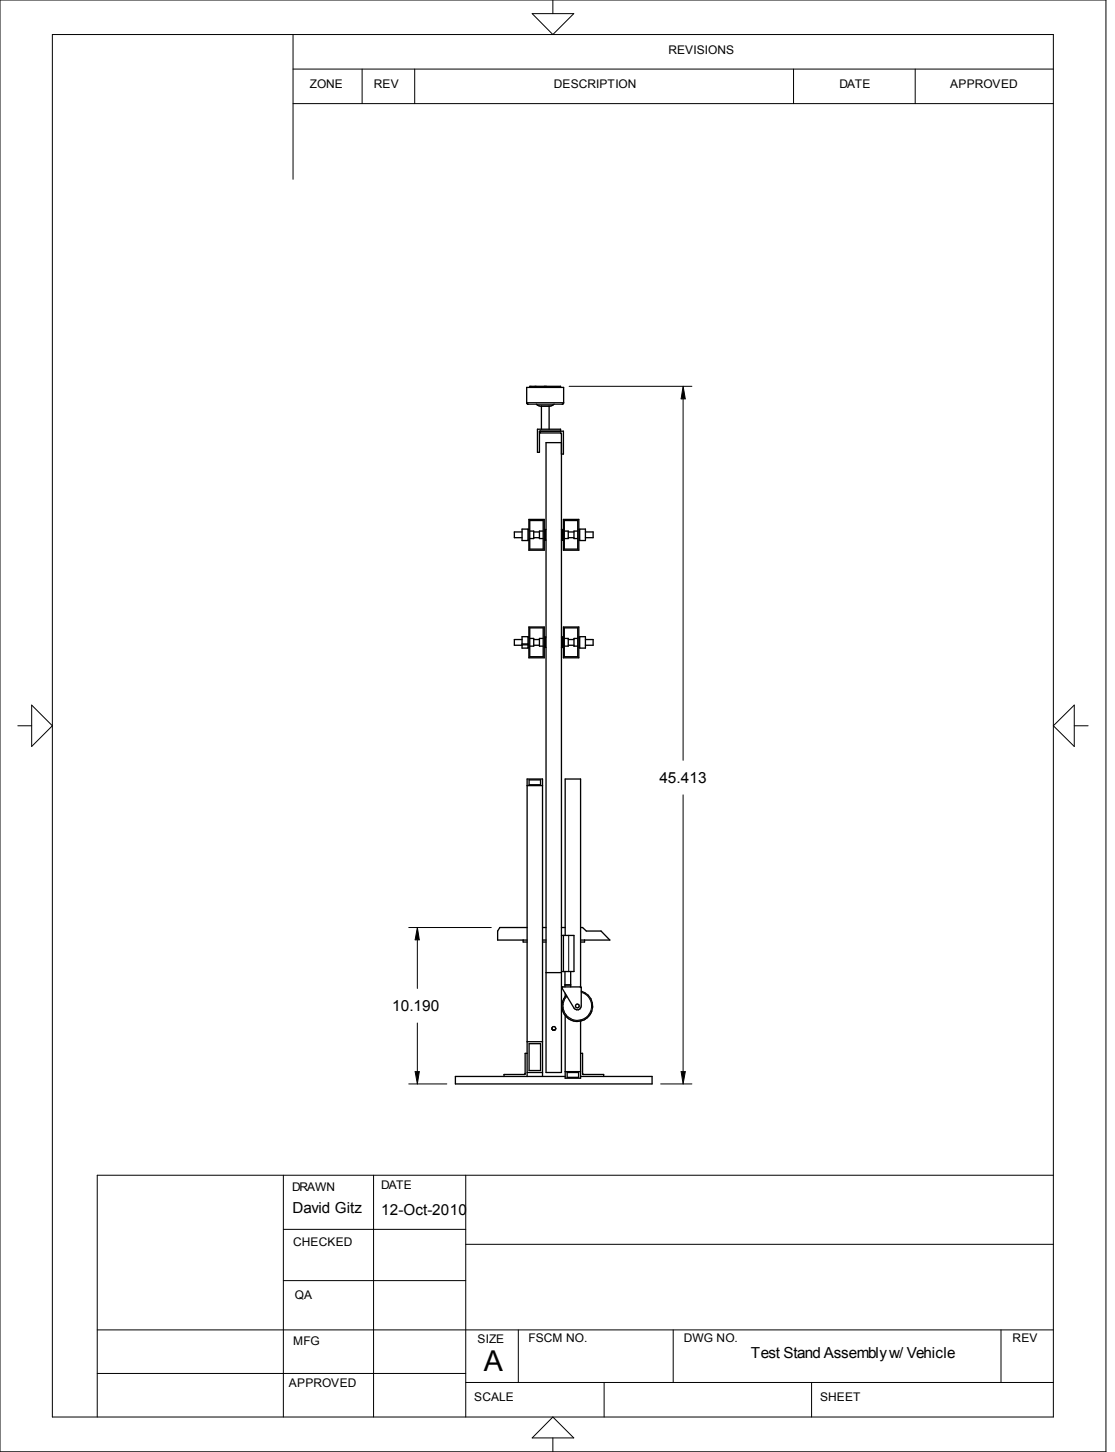
[picture p189: page 2]

REVISIONS

ZONE | REV | DESCRIPTION | DATE | APPROVED

DRAWN David Gitz | DATE 12-Oct-2010

CHECKED

MFG | | SIZE A | FSCM NO. | DWG NO. Test Stand Assembly w/ Vehicle | REV

APPROVED

SCALE | SHEET
