mwelling/robot-chopper/Media/Test-Stand/TestStandAssemblySchematic.pdf

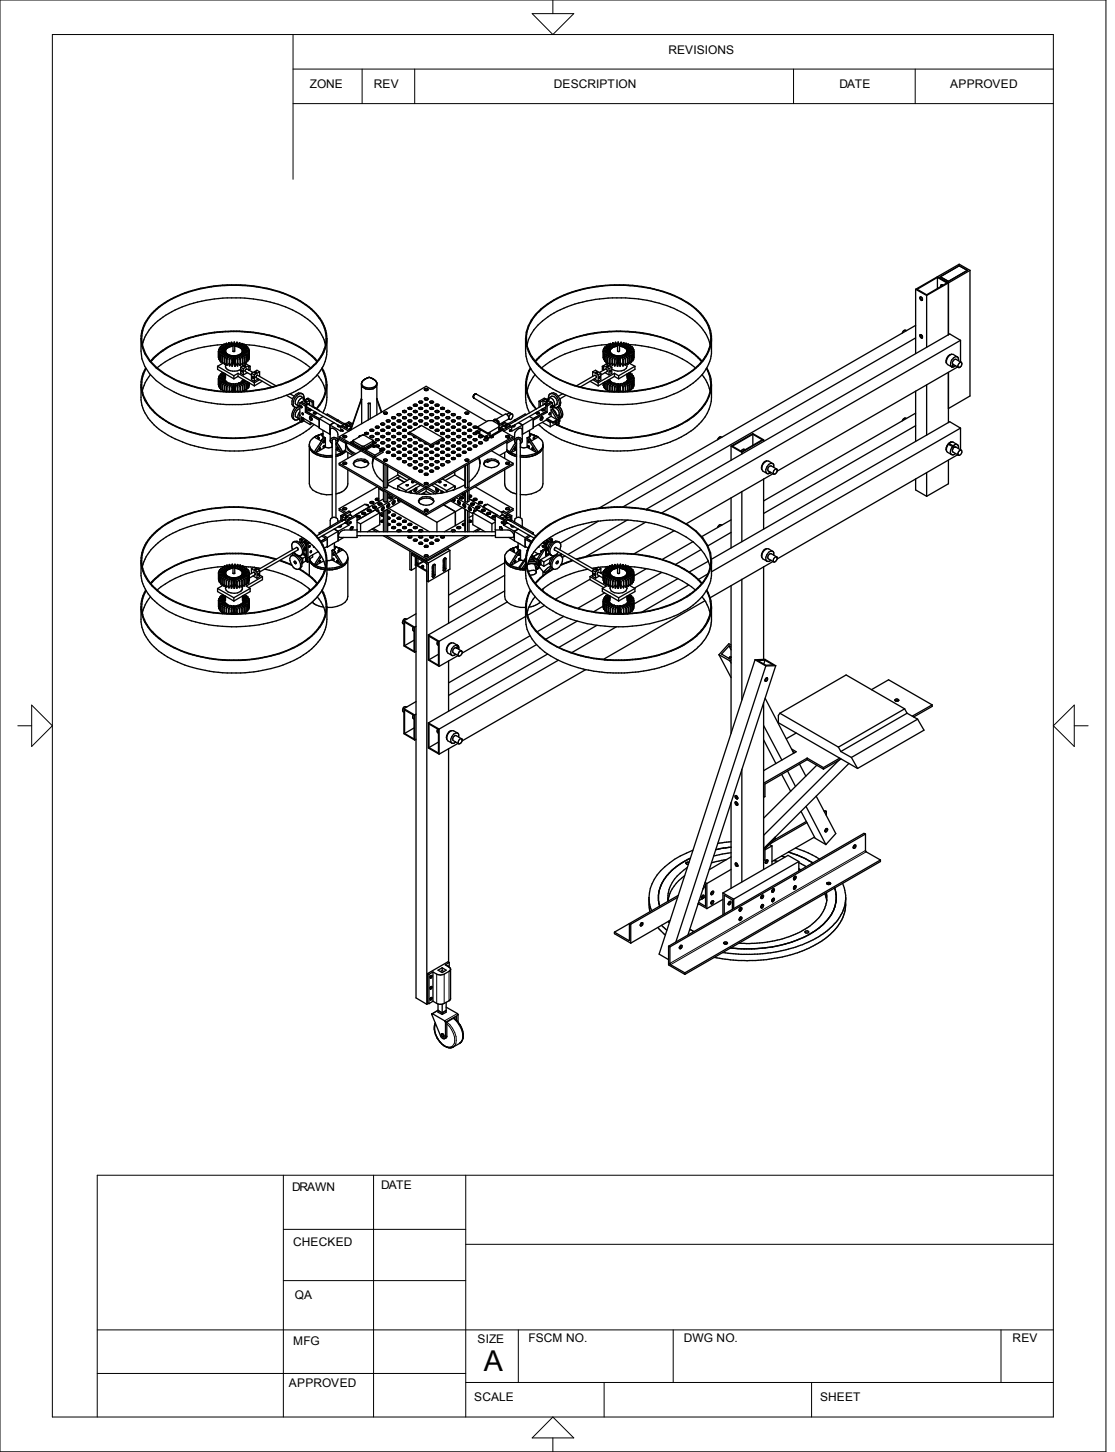
[picture p190: page 1]
SIZE; CHECKED; REVISIONS; ZONE; REV; DATE; APPROVED; DRAWN; SHEET; FSCM NO.; MFG; DESCRIPTION; SCALE; DWG NO.

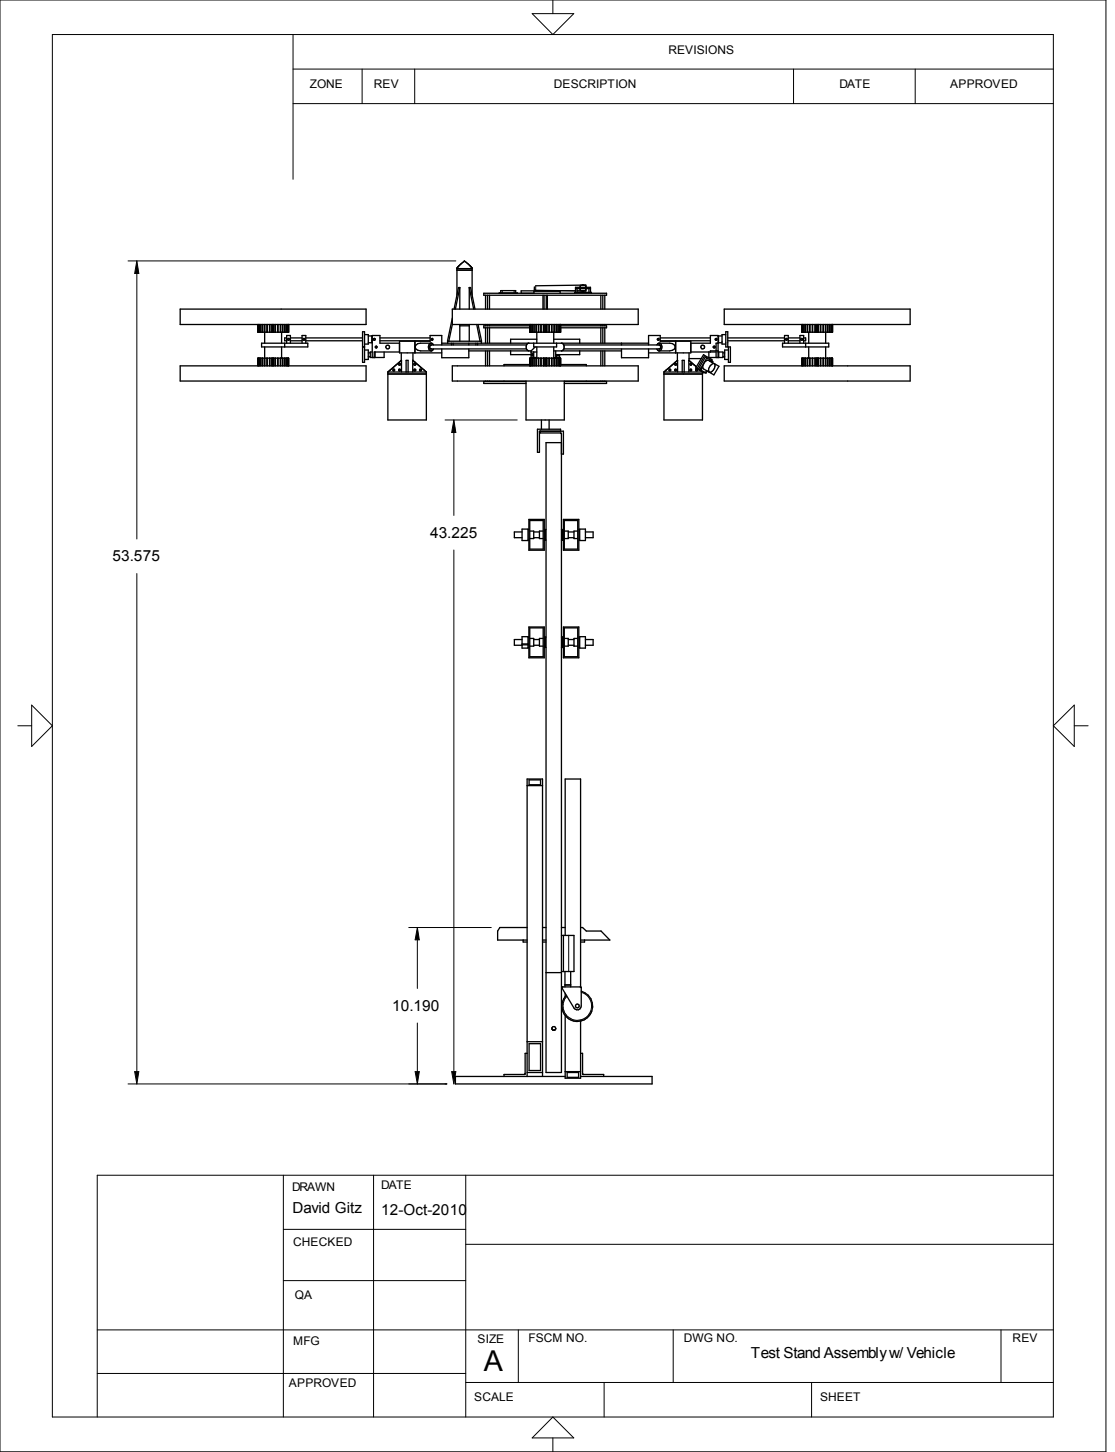
[picture p191: page 2]

REVISIONS

ZONE | REV | DESCRIPTION | DATE | APPROVED

DRAWN David Gitz | DATE 12-Oct-2010

CHECKED

MFG | | SIZE A | FSCM NO. | DWG NO. Test Stand Assembly w/ Vehicle | REV

APPROVED

SCALE | SHEET
