mwelling/robot-chopper/Vehicle/Design/Vehicle/VehicleAssySchematic.pdf

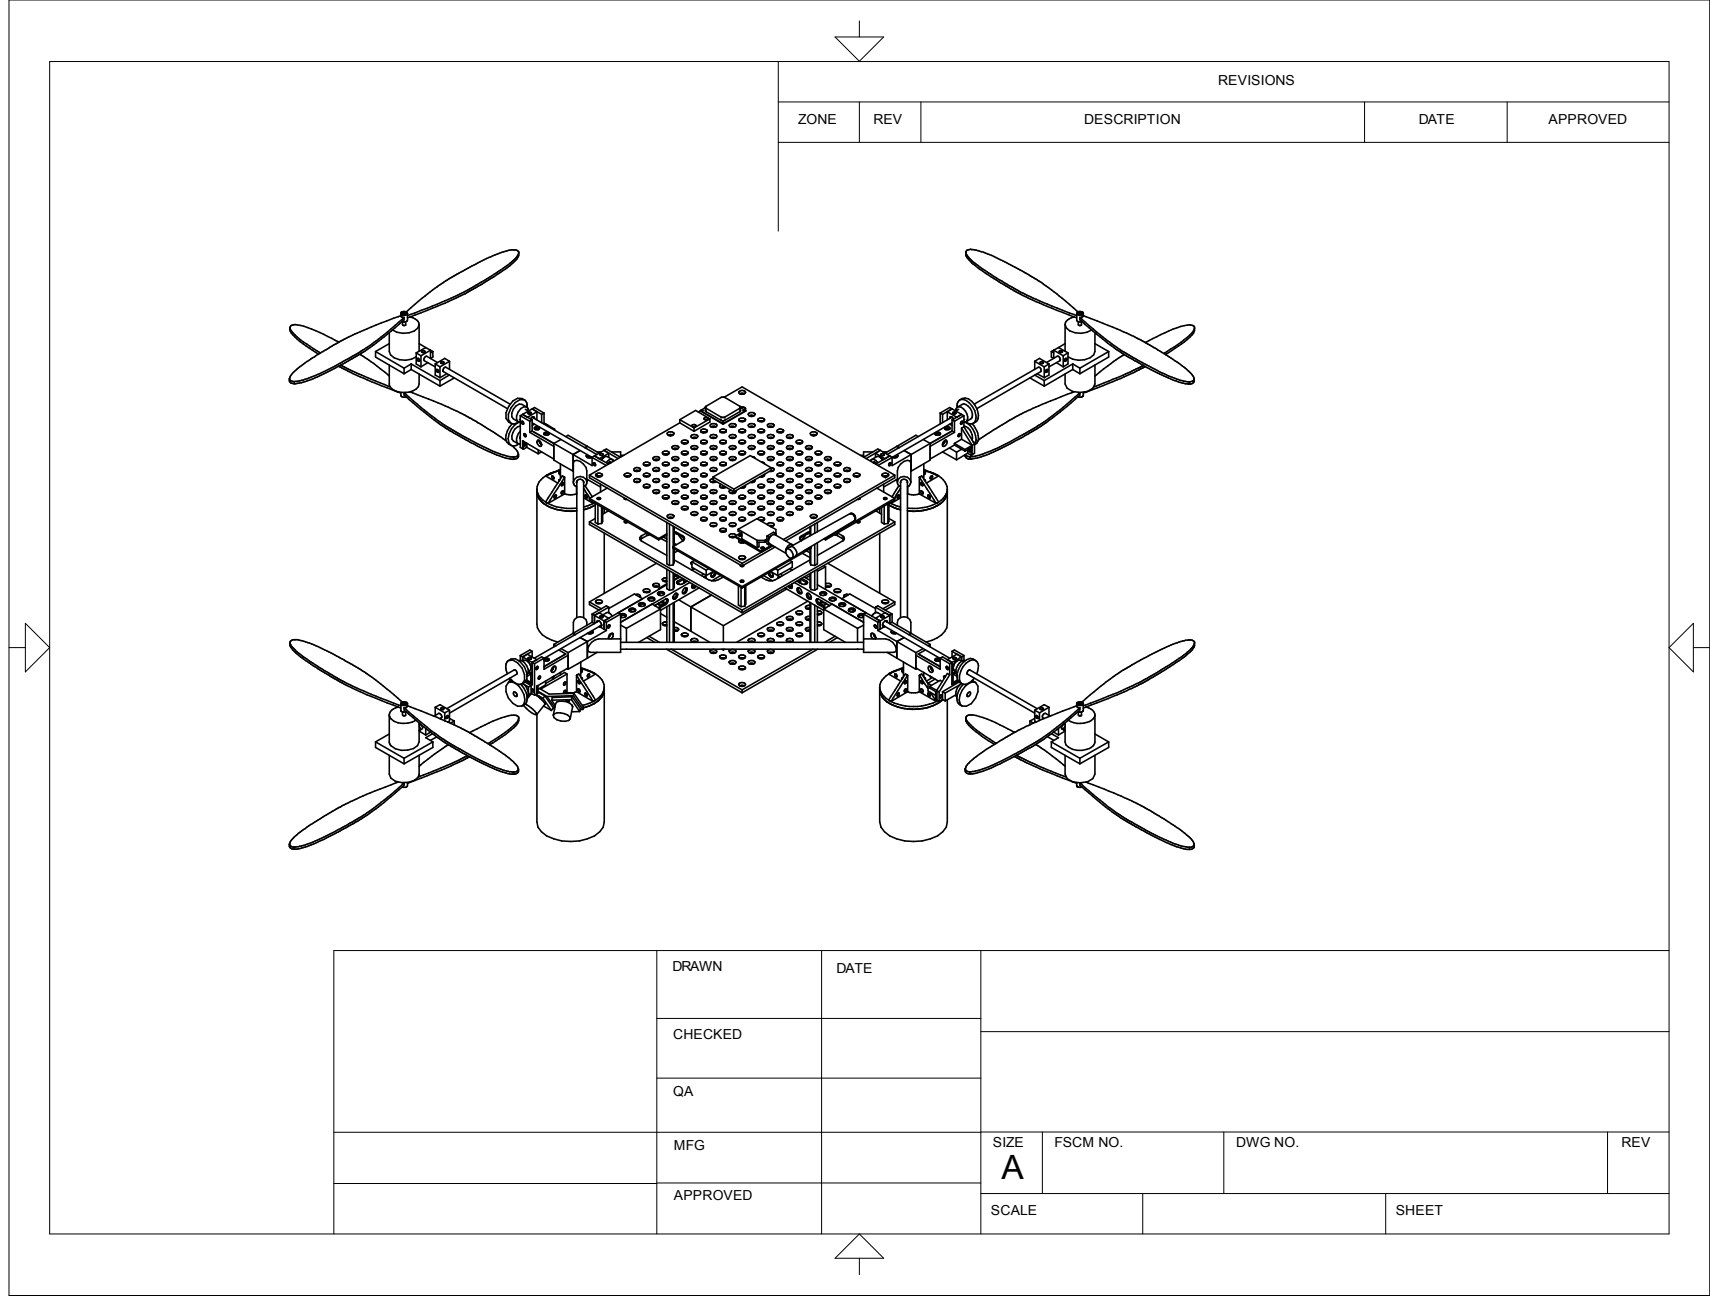
[picture p192: page 1]
FSCM NO.; DWG NO.; DATE; APPROVED; SIZE; CHECKED; REV; ZONE; MFG; SCALE; DRAWN; REVISIONS; SHEET; DESCRIPTION

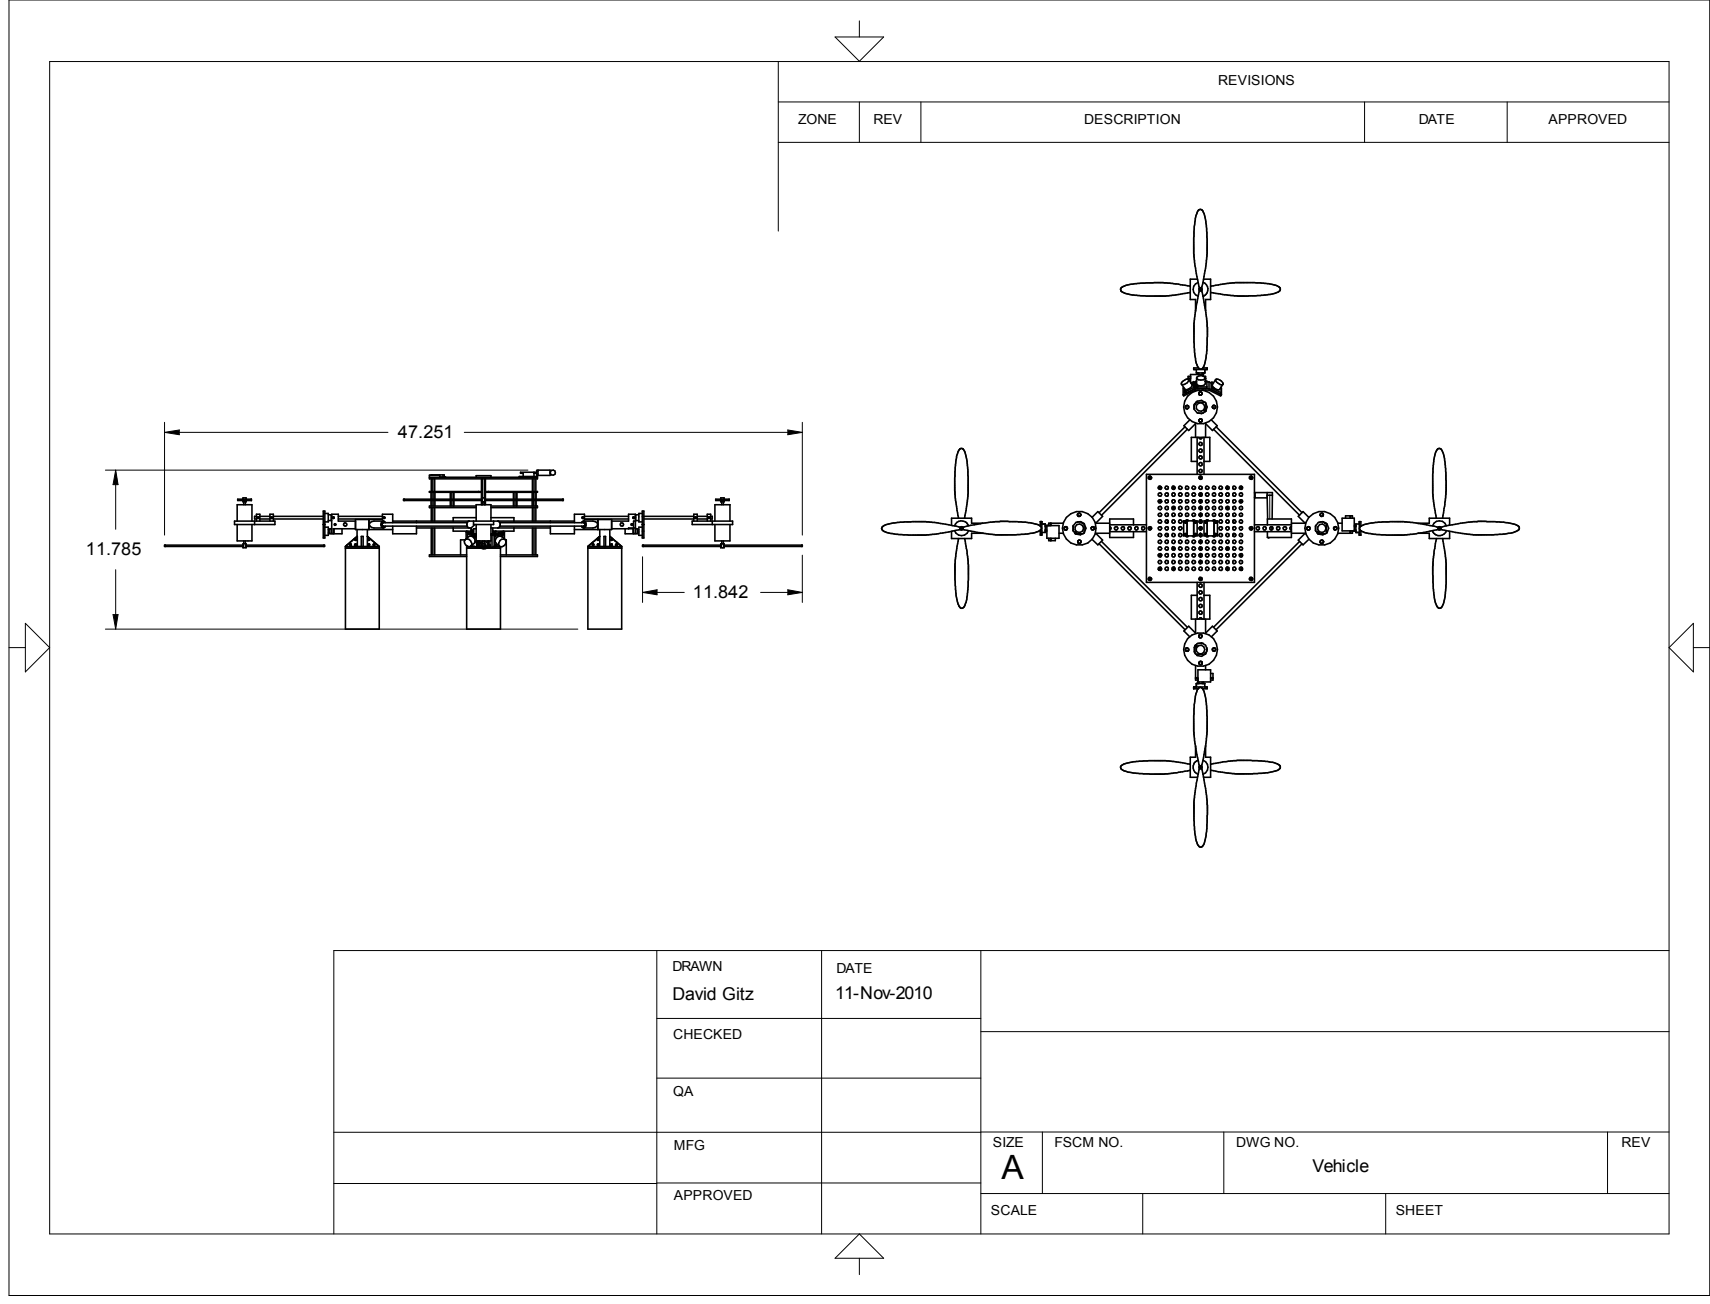
[picture p193: page 2]
Vehicle; SIZE; DRAWN; MFG; 11-Nov-2010; APPROVED; REV; DATE; David Gitz; FSCM NO.; DWG NO.; ZONE; SCALE; CHECKED; DESCRIPTION; SHEET

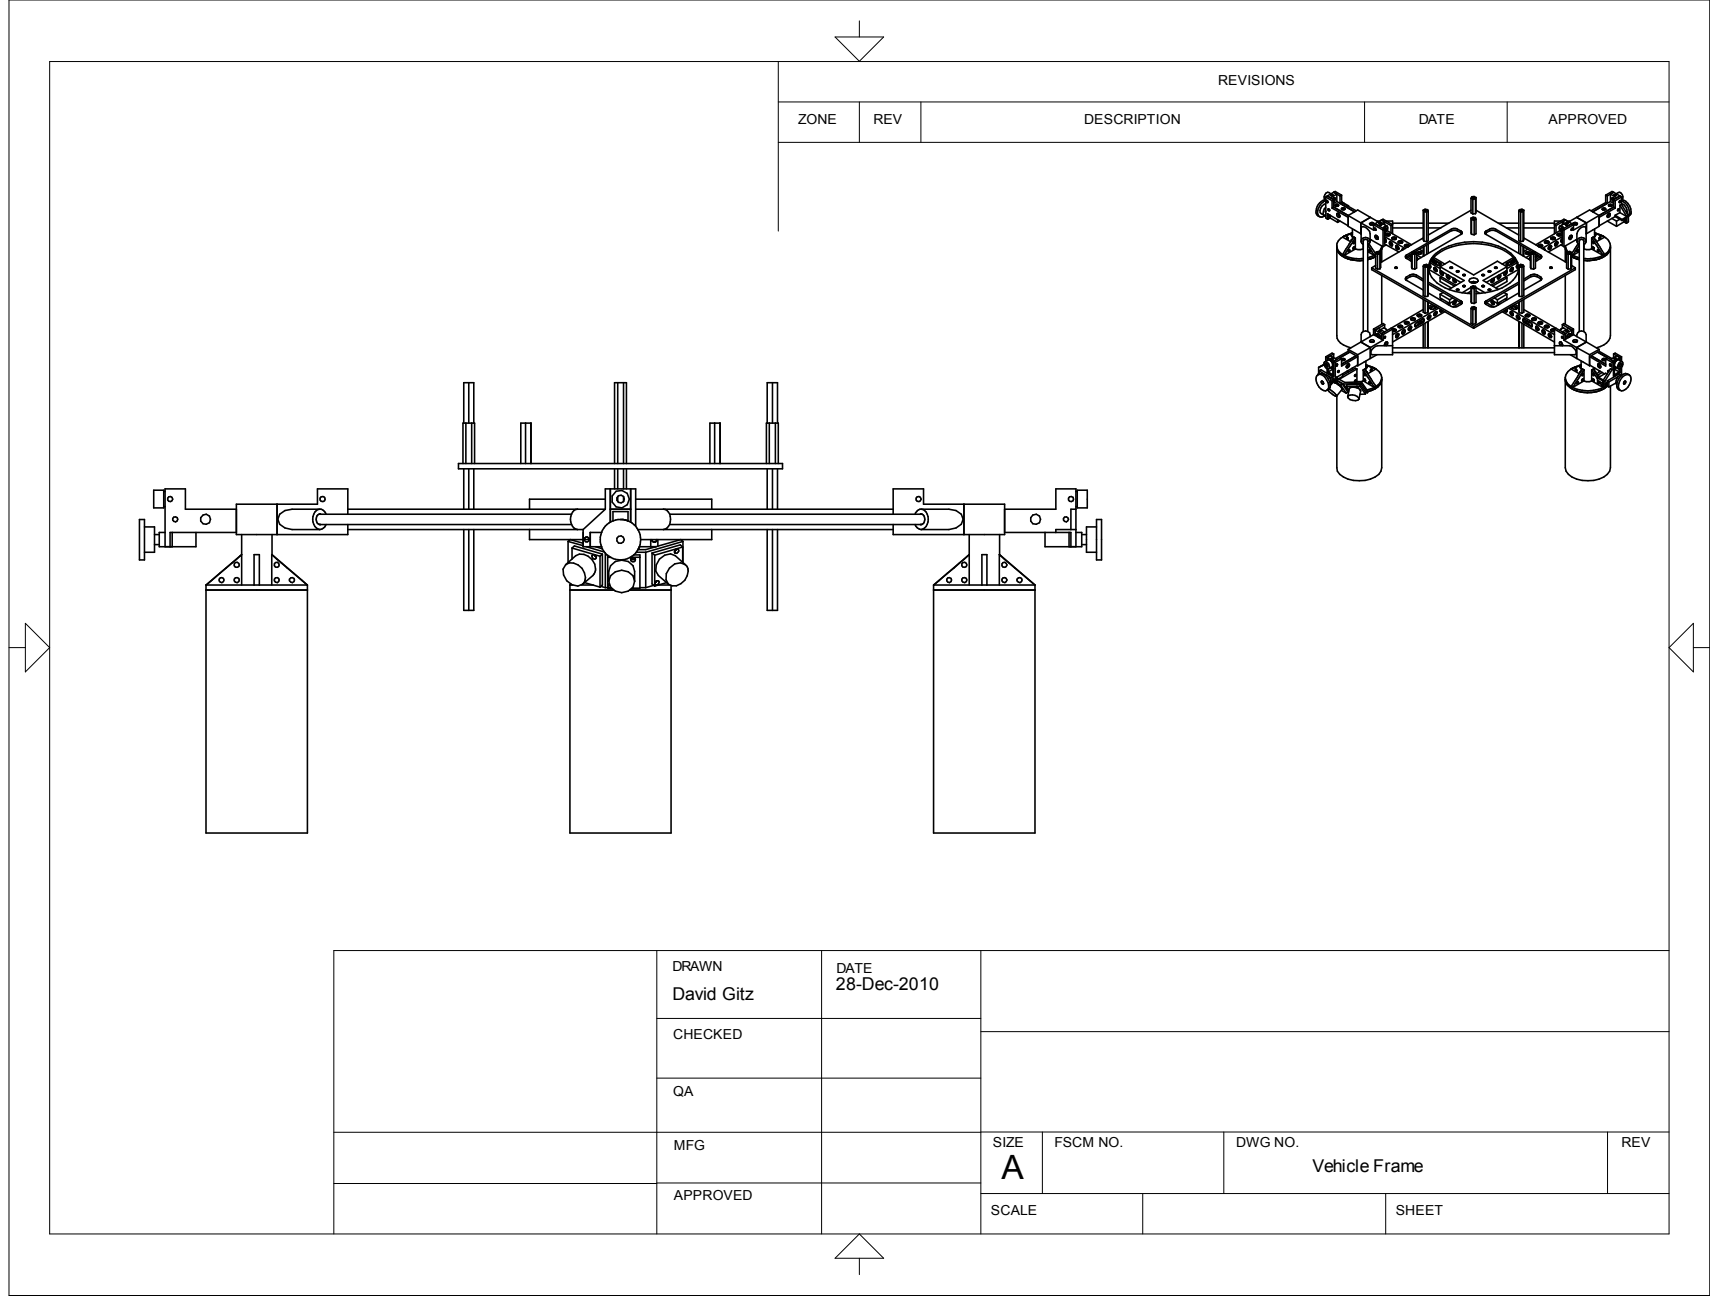
[picture p194: page 3]
DATE; DRAWN; 28-Dec-2010; DESCRIPTION; David Gitz; REV; APPROVED; SIZE; SCALE; CHECKED; ZONE; Vehicle Frame; DWG NO.; SHEET; FSCM NO.; MFG

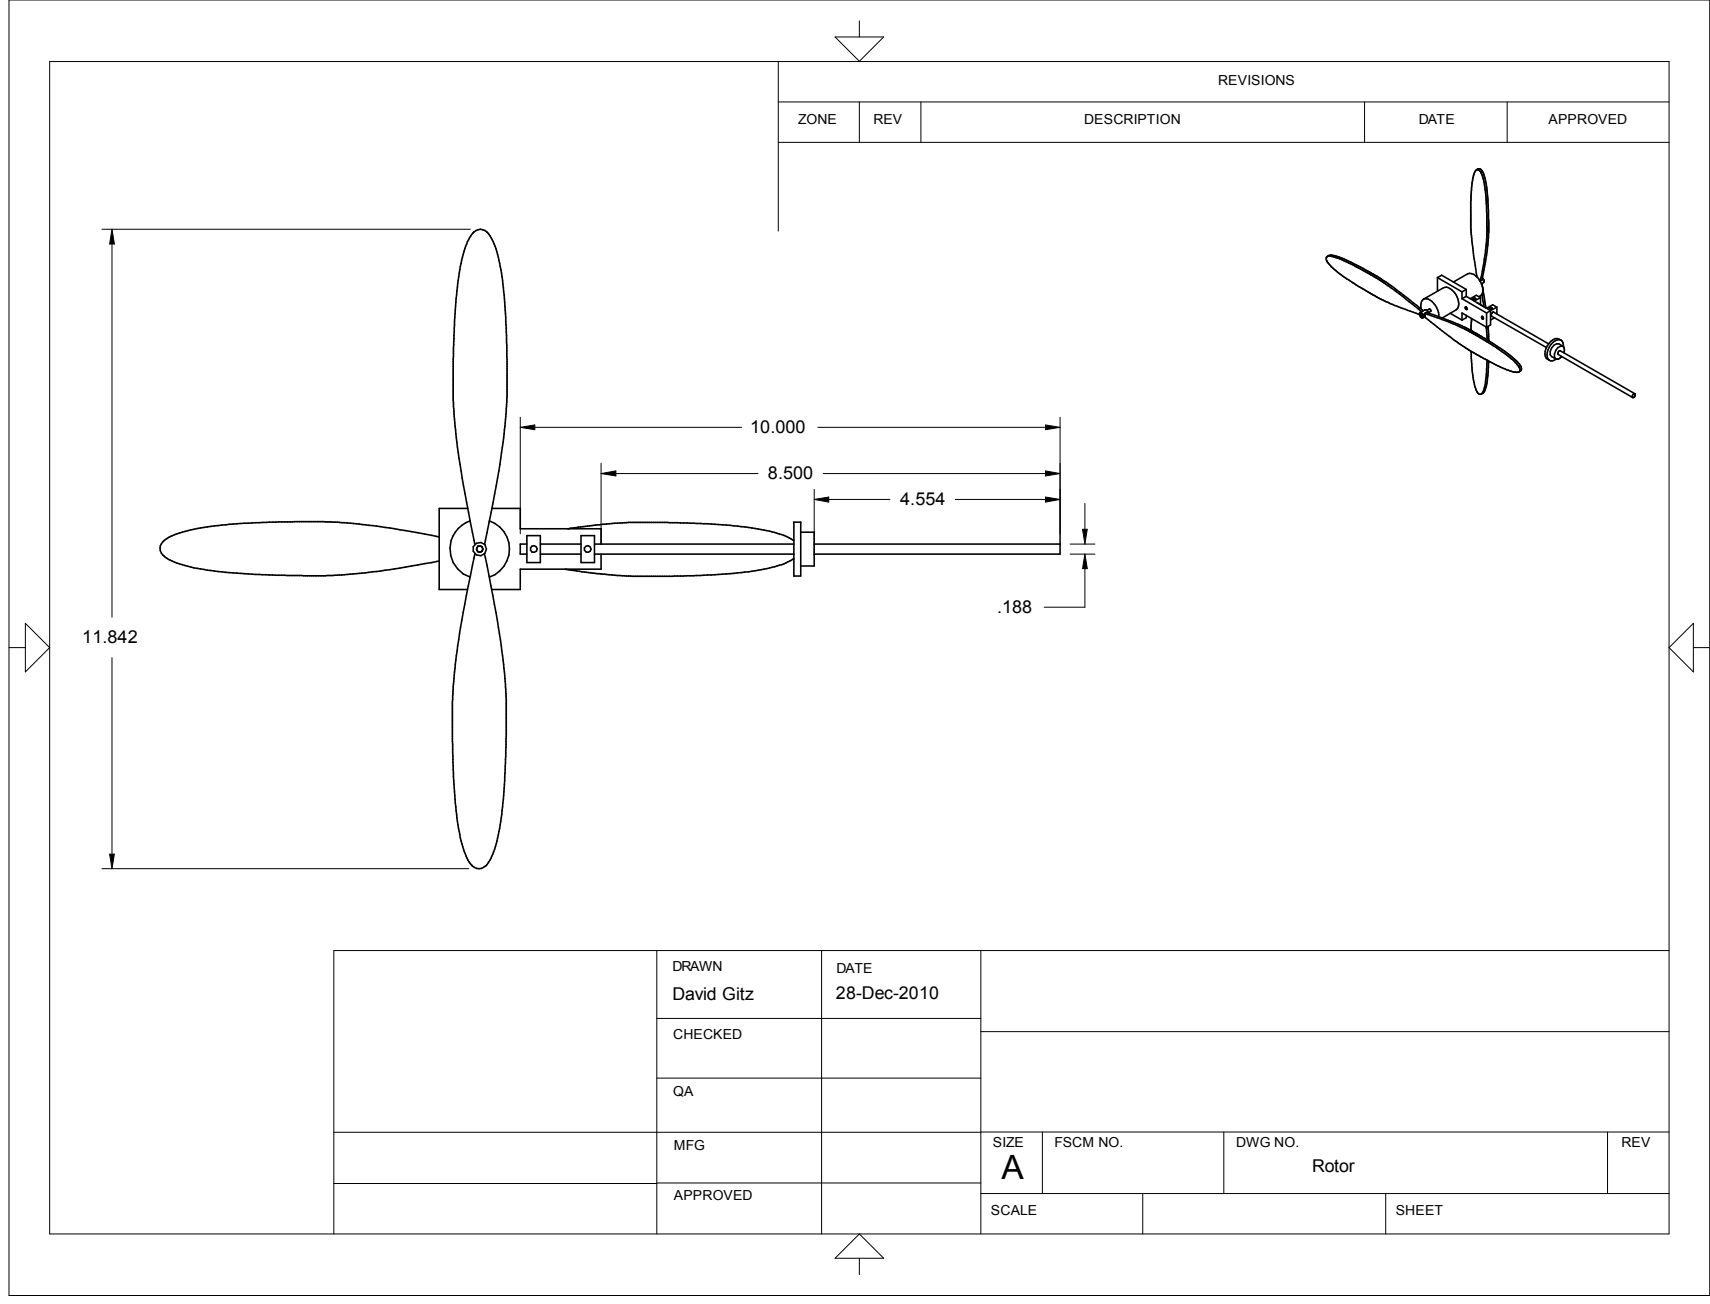
[picture p195: page 4]
APPROVED; ZONE; DESCRIPTION; REV; DATE

DRAWN David Gitz | DATE 28-Dec-2010

CHECKED

MFG | | SIZE A | FSCM NO. | DWG NO. Rotor | REV

APPROVED

SCALE | SHEET
