mwelling/robot-chopper/Analysis/Dynamics/Test Results/11Oct2010 - batt3.pdf

10/11/2010 5:11:01 PM

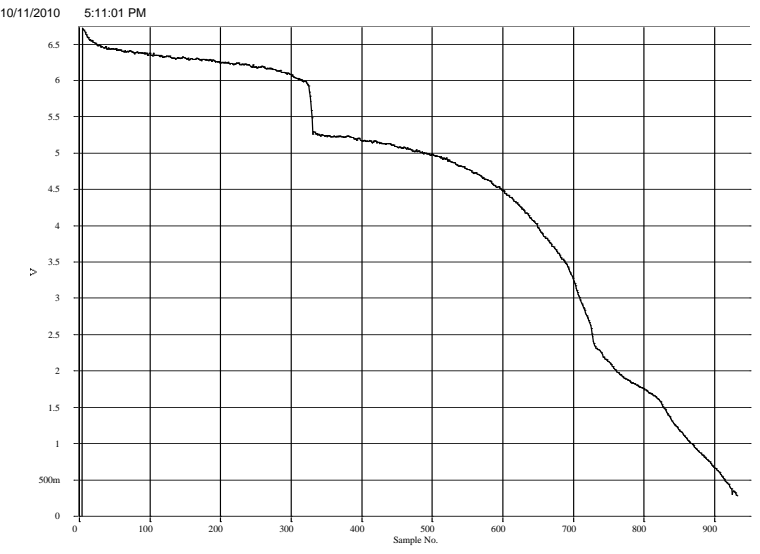
[picture p196: page 1]
Sample No.
