mwelling/robot-chopper/Analysis/Dynamics/Test Results/12Oct2010-batt4.pdf

10/13/2010 4:28:32 PM

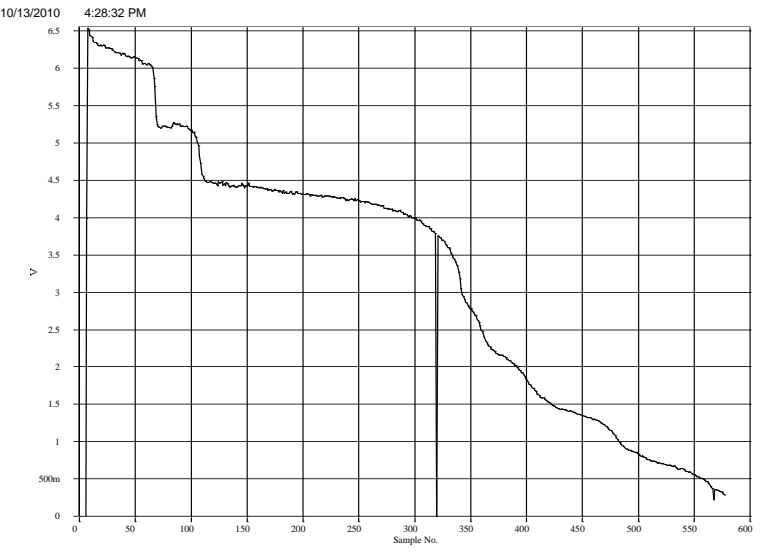
[picture p197: page 1]
Sample No.
