mwelling/robot-chopper/Analysis/Dynamics/Test Results/15Oct2010-batt3.pdf

10/15/2010 2:08:27 PM

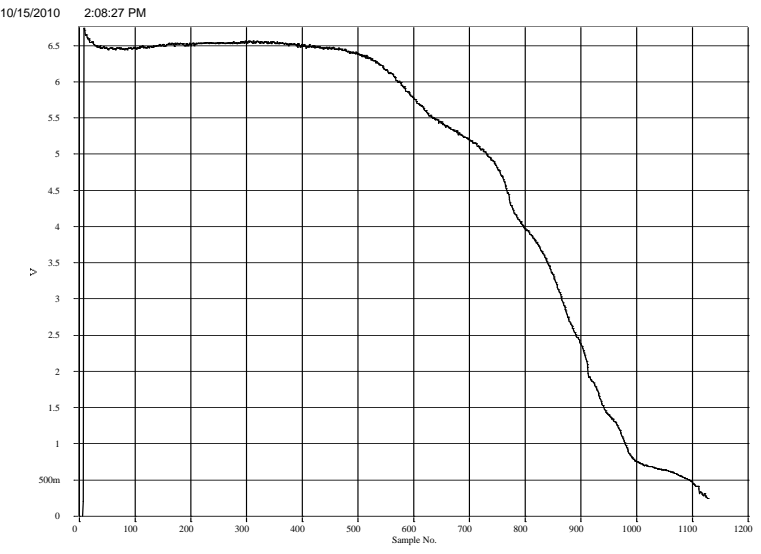
[picture p198: page 1]
Sample No.
