mwelling/robot-chopper/Analysis/Dynamics/Test Results/15Oct2010-batt4.pdf

10/15/2010 1:47:10 PM

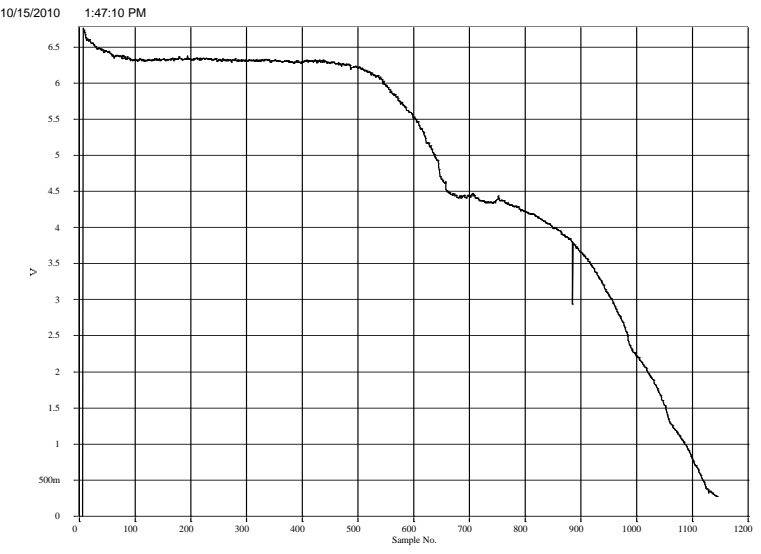
[picture p199: page 1]
Sample No.
