mwelling/robot-chopper/Documentation/Design Report Appendix/Test Stand Design Drawings/Arm.pdf

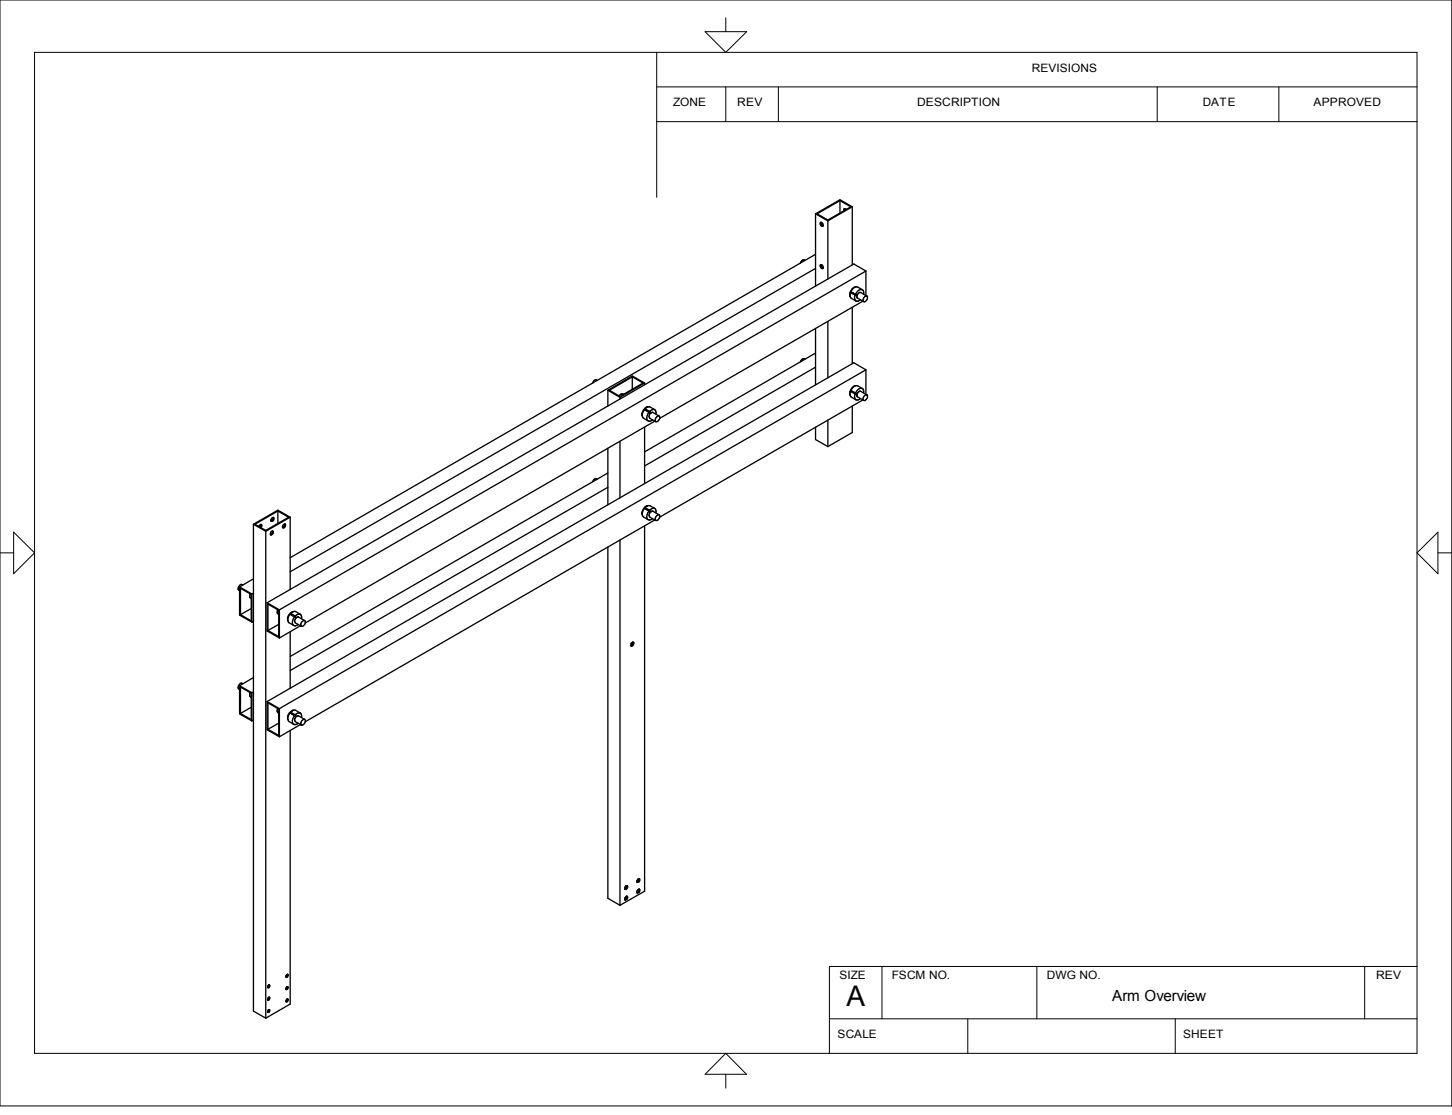
[picture p200: page 1]

REVISIONS

ZONE | REV | DESCRIPTION | DATE | APPROVED

SIZE A | FSCM NO. | DWG NO. Arm Overview | REV

SCALE | | SHEET

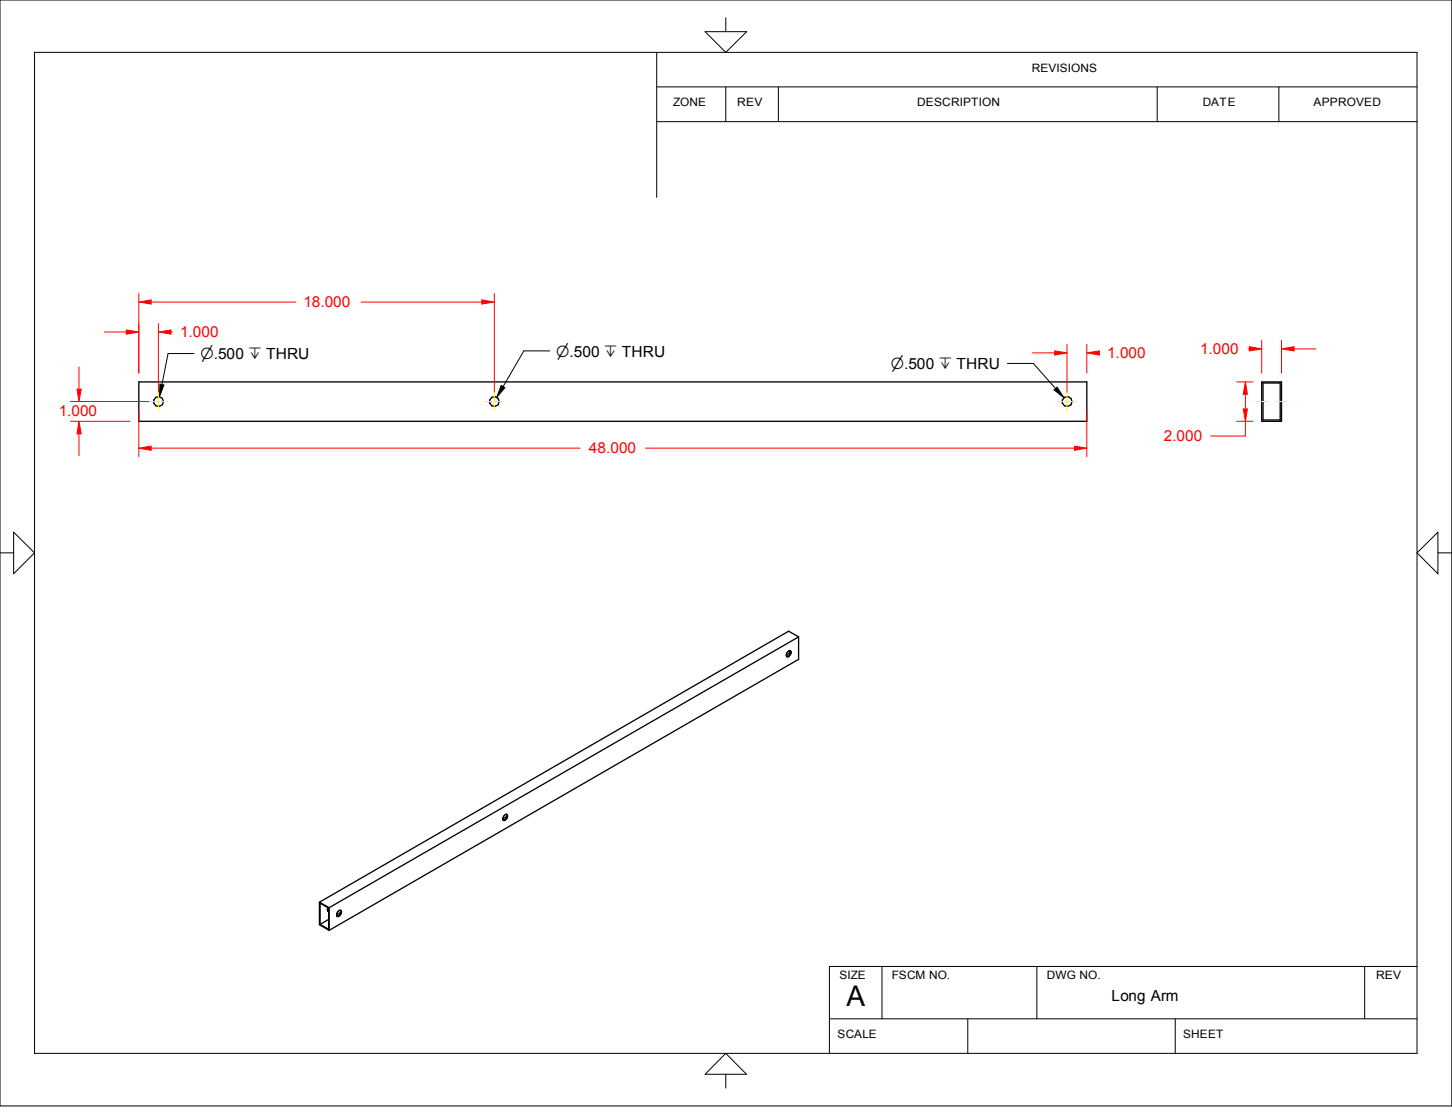
[picture p201: page 2]
n.500 x THRU n.500 x THRU; n.500 x THRU; SIZE; FSCM NO.; DWG NO.; REV; DESCRIPTION; Long Arm; ZONE; DATE; APPROVED

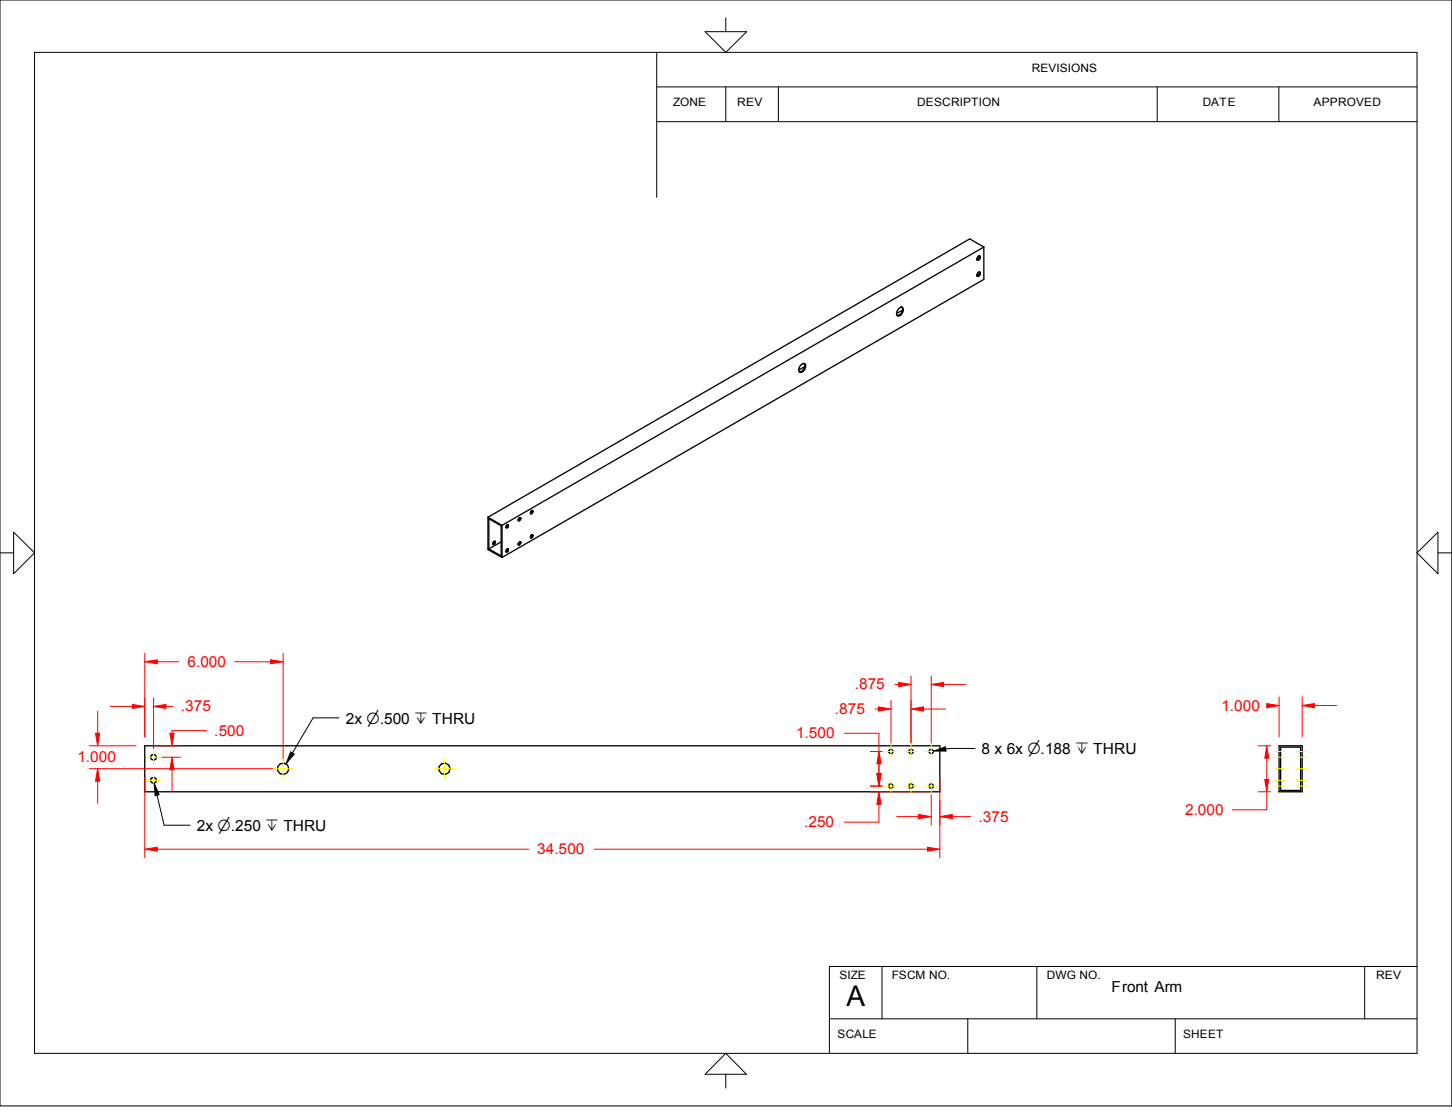
[picture p202: page 3]
2x n.500 x THRU; 2x n.250 x THRU; 8 x 6x n.188 x THRU; Front Arm; ZONE; SIZE; REV; DWG NO.; DESCRIPTION; DATE; FSCM NO.; APPROVED

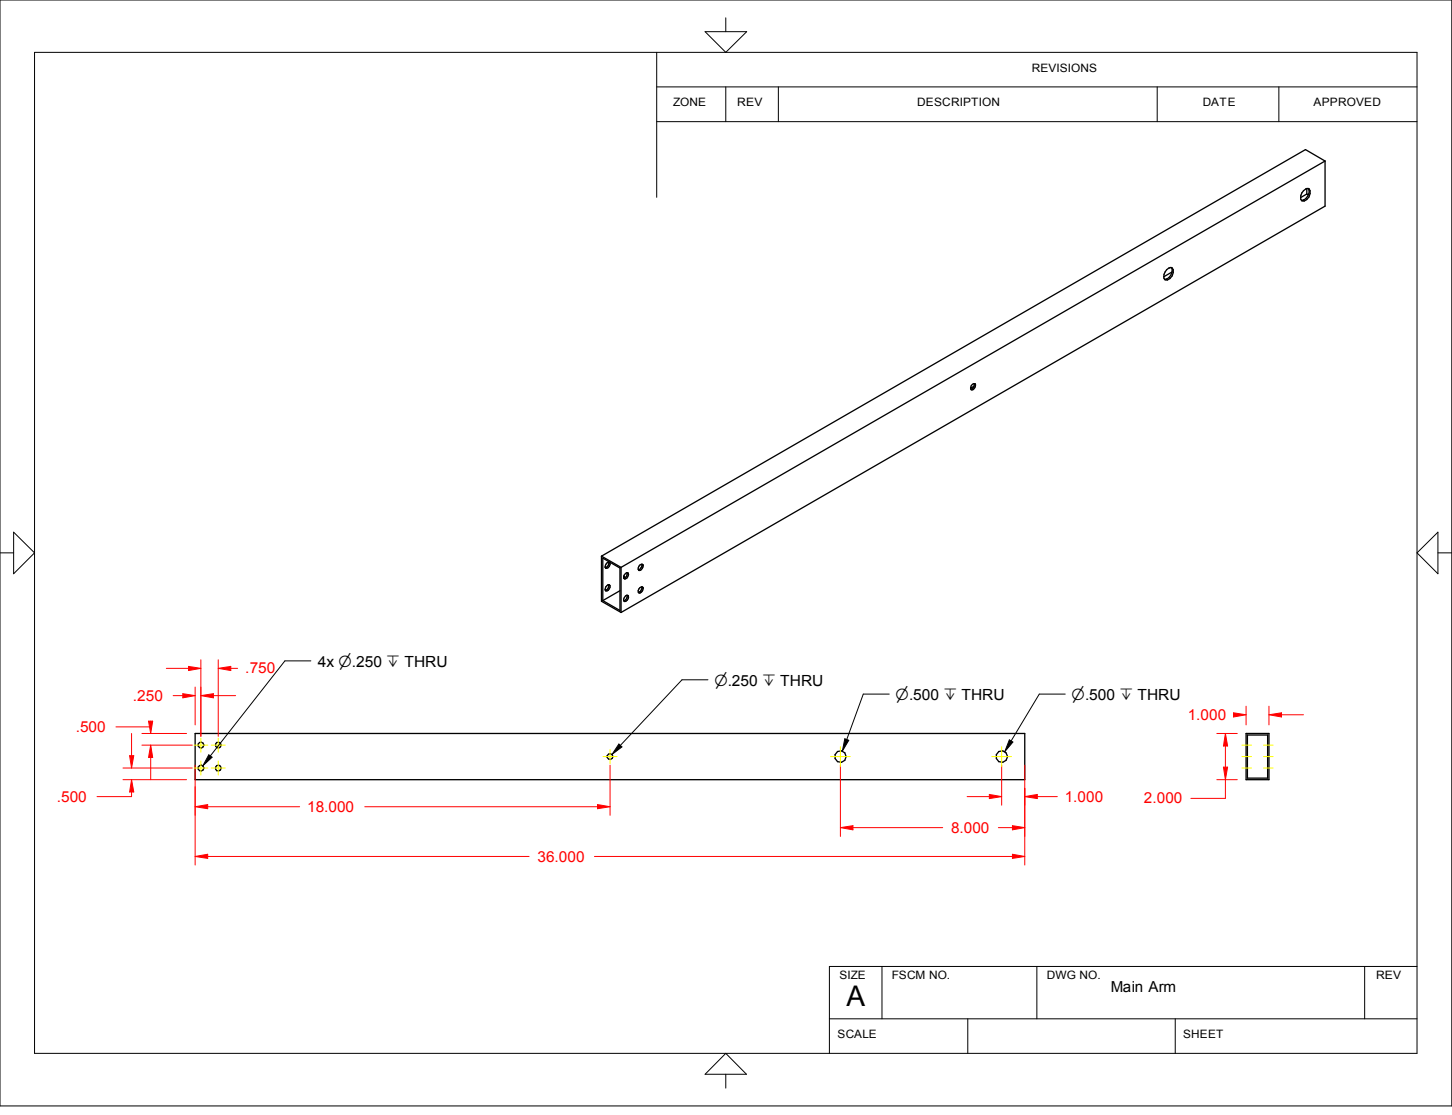
[picture p203: page 4]
n.500 x THRU; 4x n.250 x THRU; n.250 x THRU; DWG NO.; DESCRIPTION; DATE; APPROVED; REV; Main Arm; ZONE; SIZE; FSCM NO.

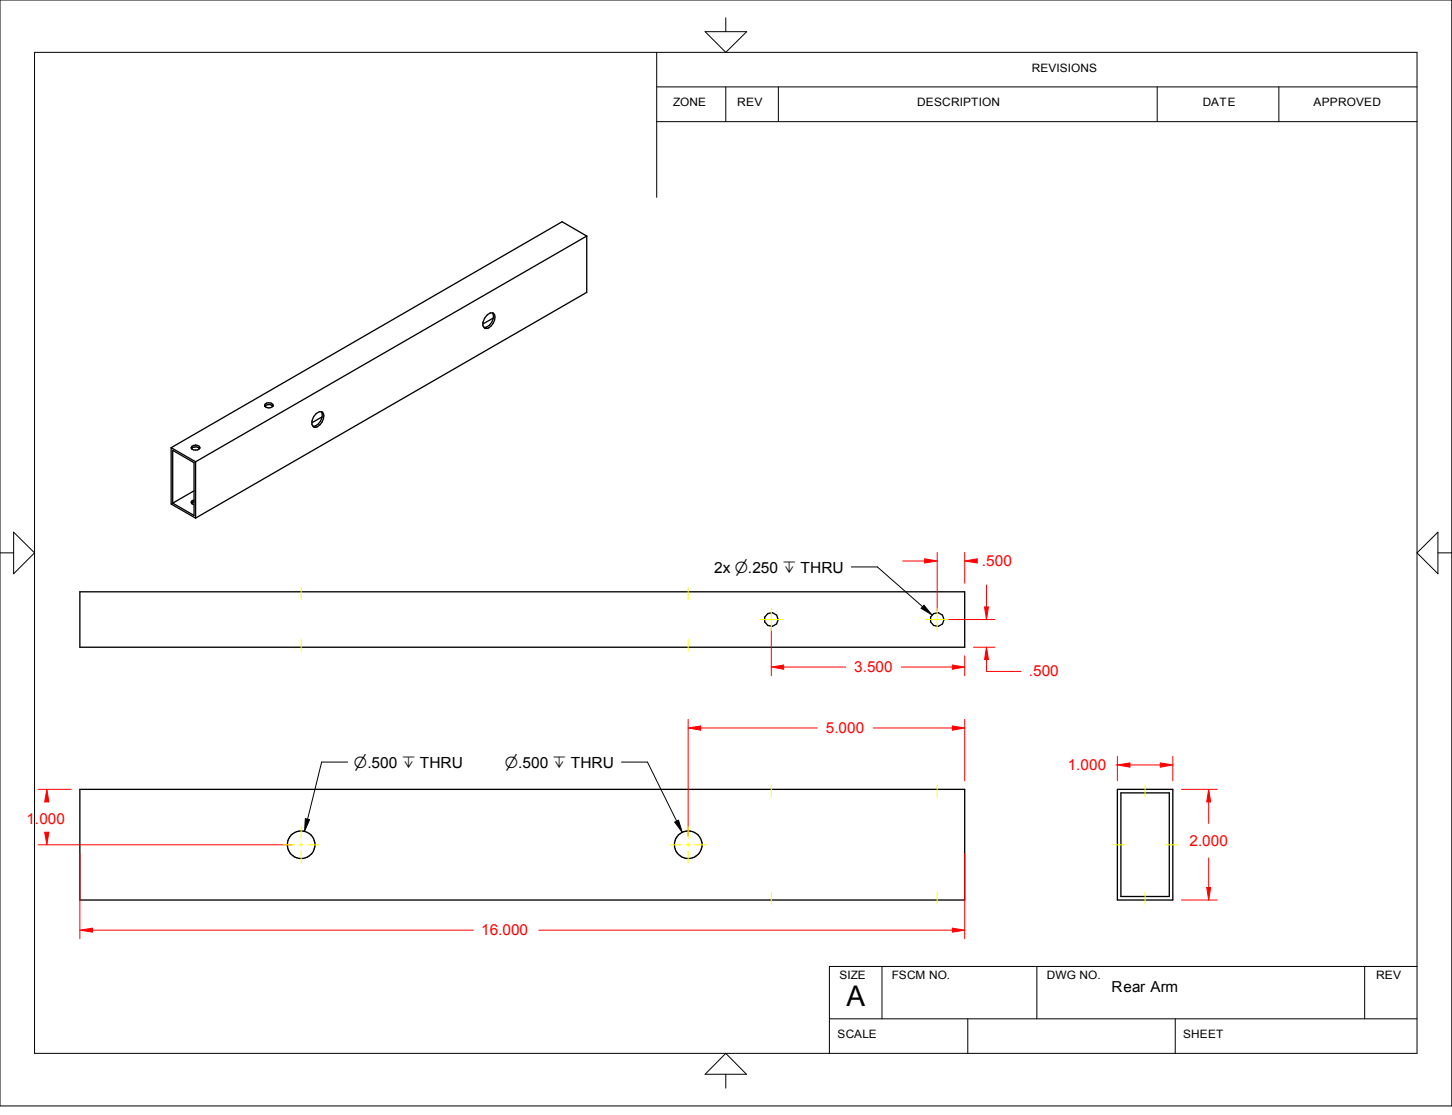
[picture p204: page 5]
n.500 x THRU; 2x n.250 x THRU; DESCRIPTION; SIZE; DWG NO.; ZONE; REV; APPROVED; Rear Arm; DATE; FSCM NO.

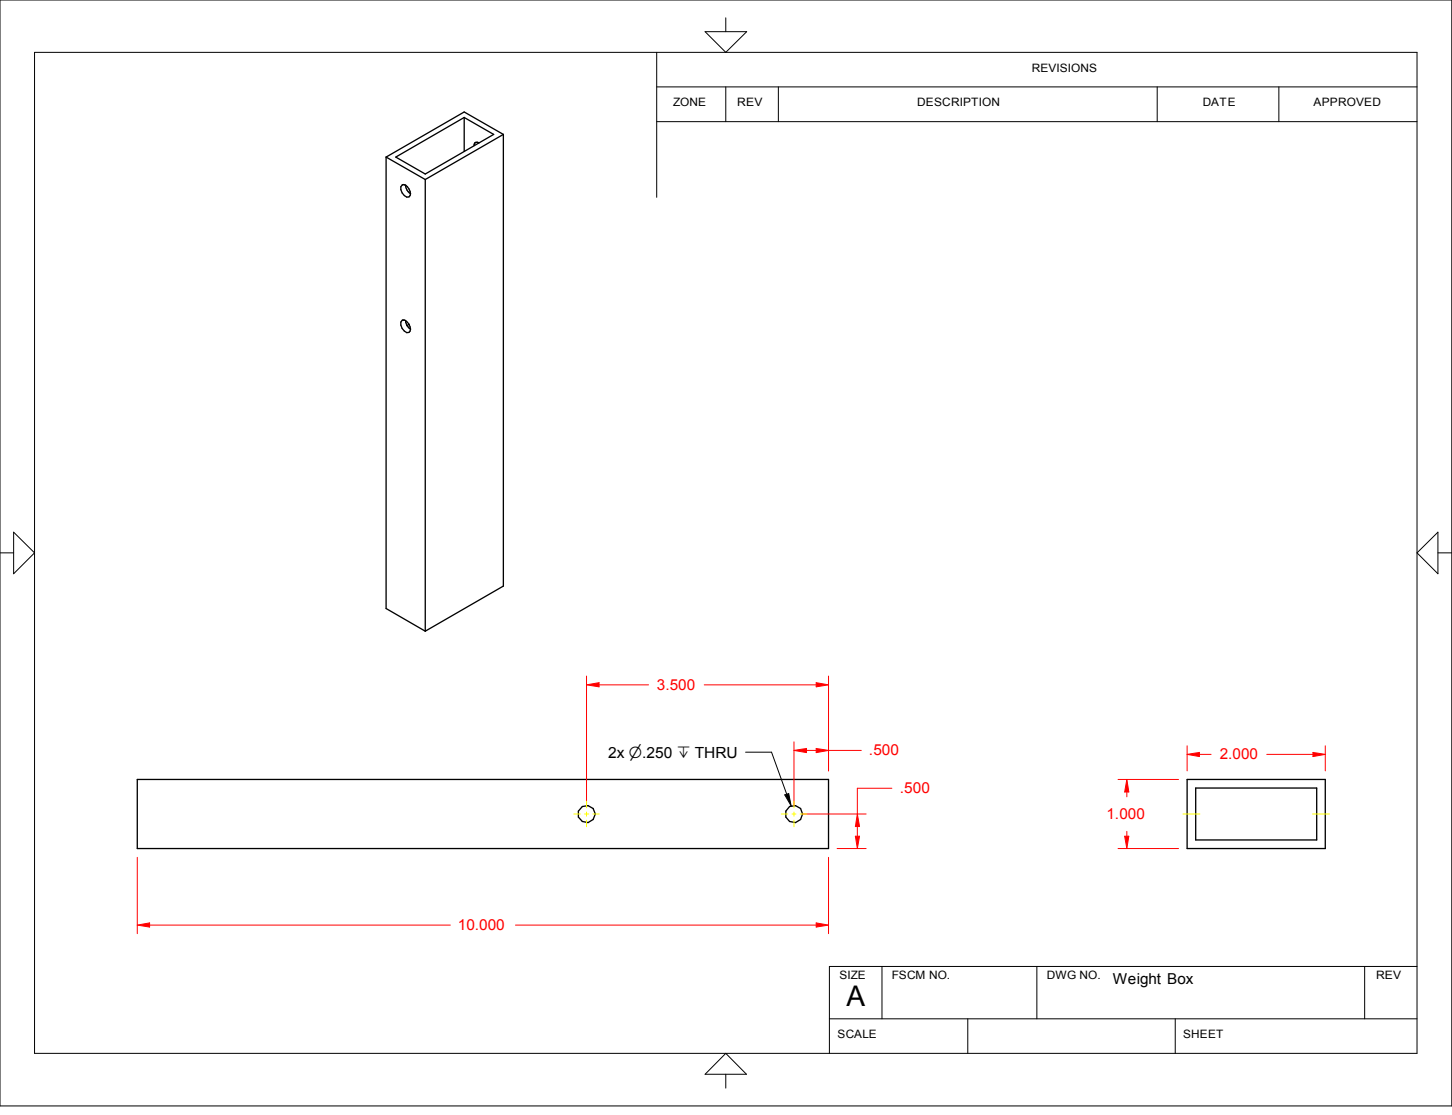
[picture p205: page 6]
2x n.250 x THRU; DATE; REV; Weight Box; DESCRIPTION; SIZE; ZONE; APPROVED; FSCM NO.; DWG NO.

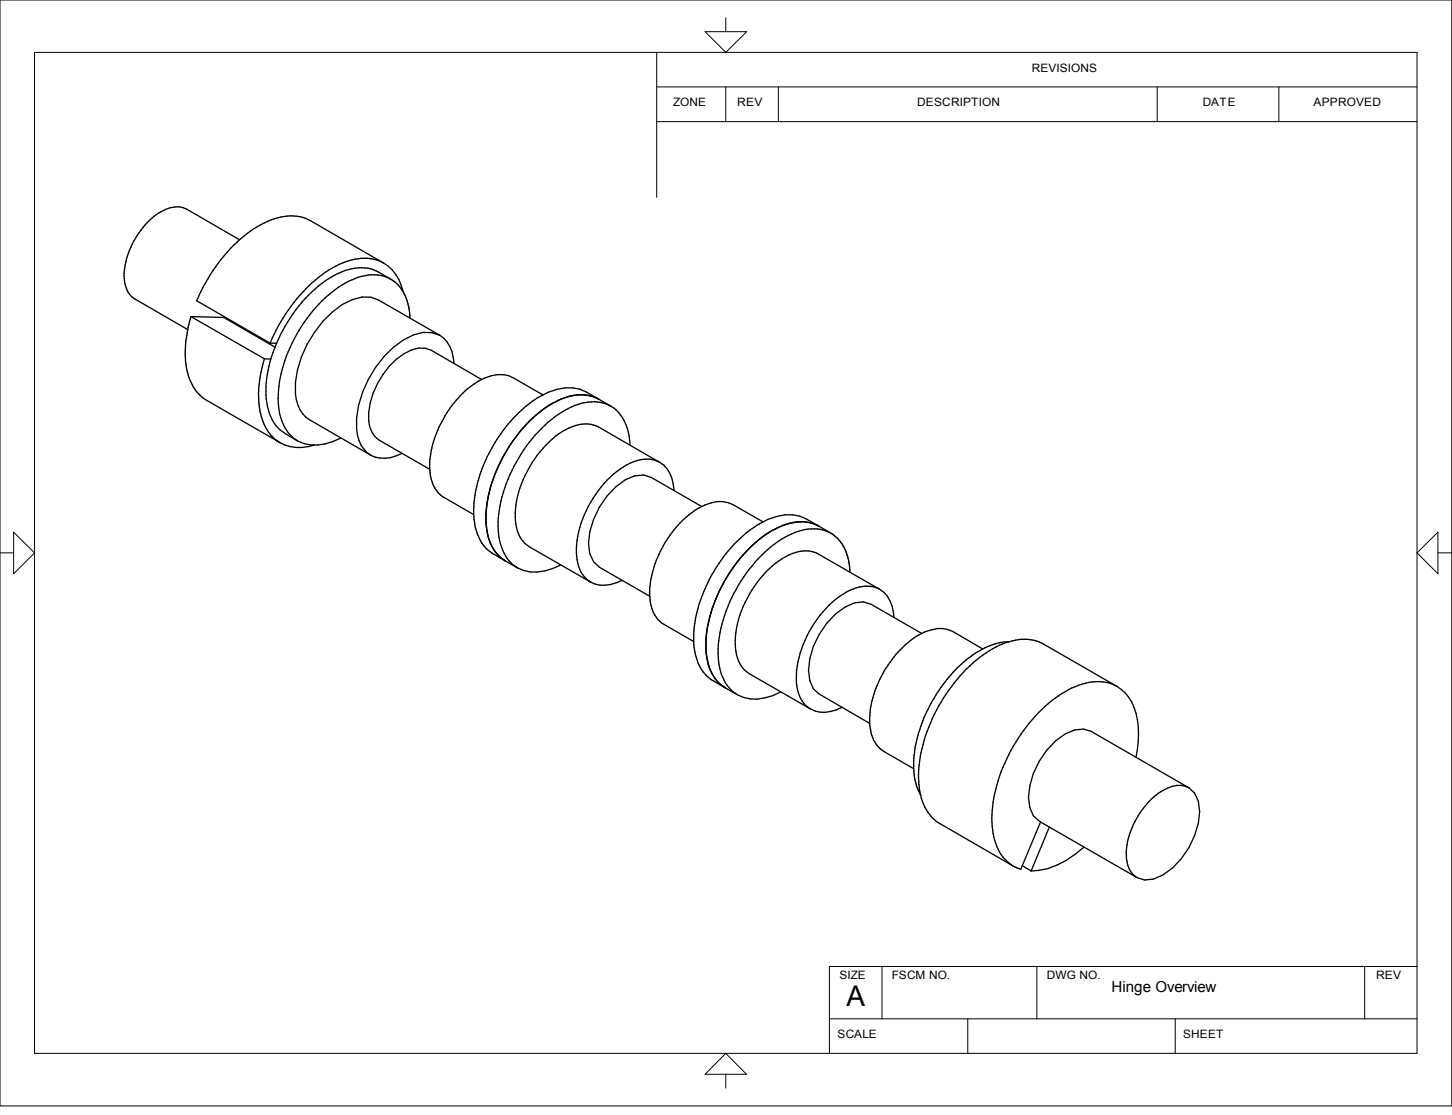
[picture p206: page 7]
ZONE; APPROVED; DWG NO.; DATE; REV; A Hinge Overview; SIZE; FSCM NO.; DESCRIPTION

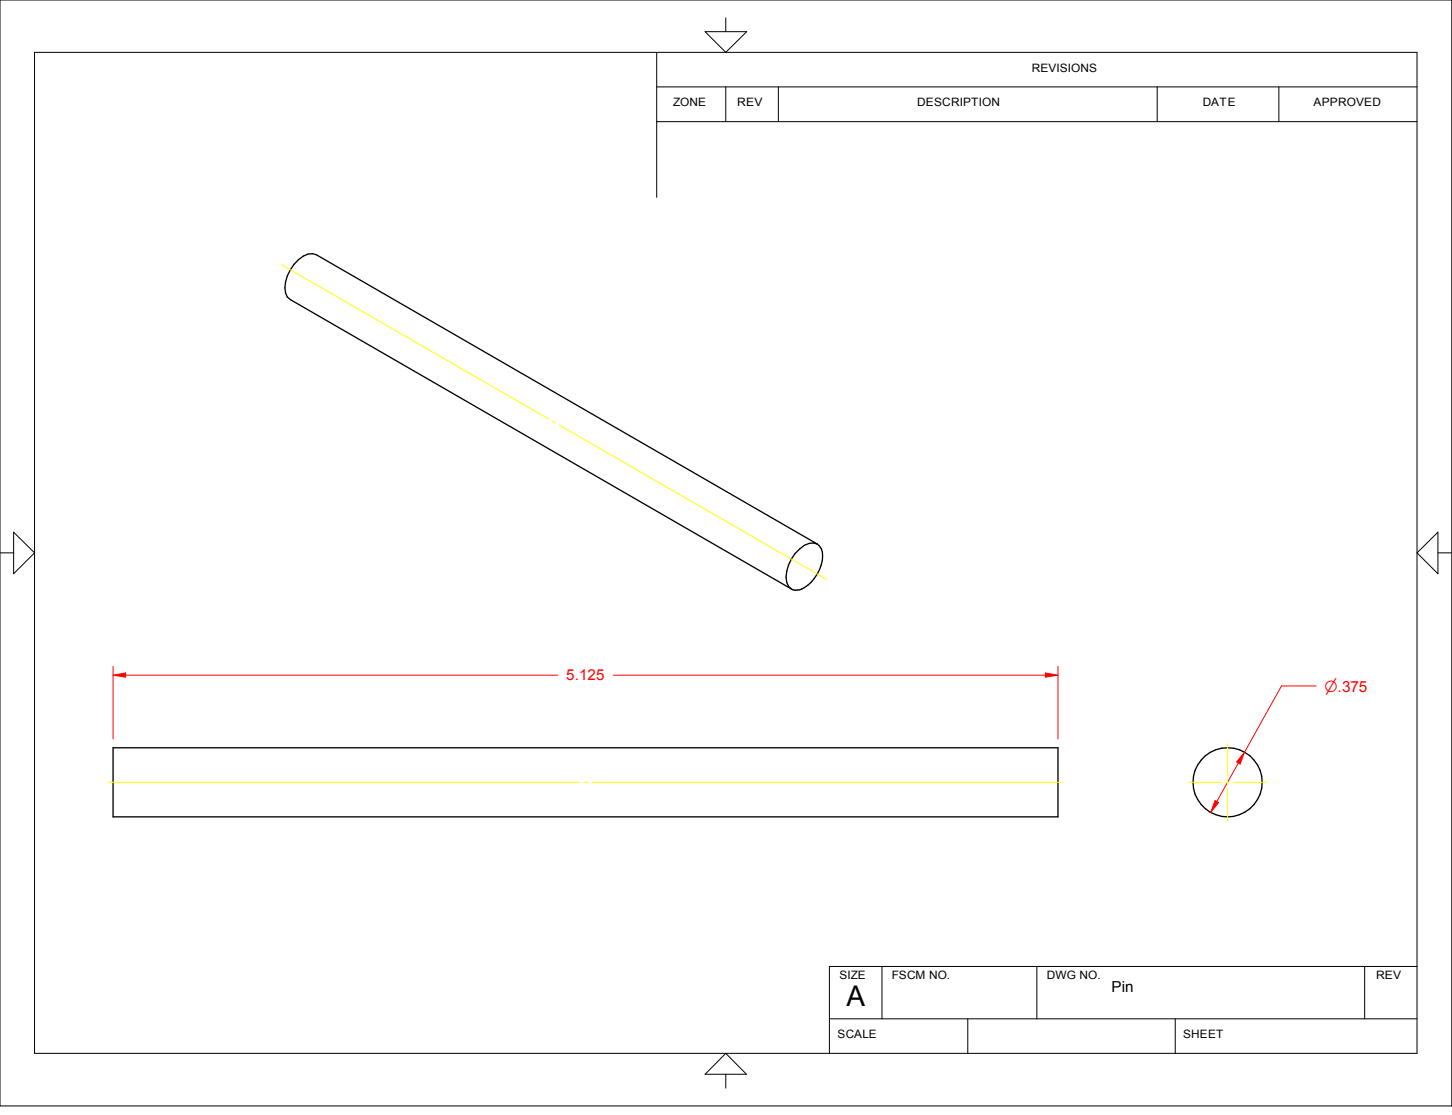
[picture p207: page 8]
DESCRIPTION; REV; ZONE; DWG NO.; APPROVED; SIZE Pin A; DATE; FSCM NO.

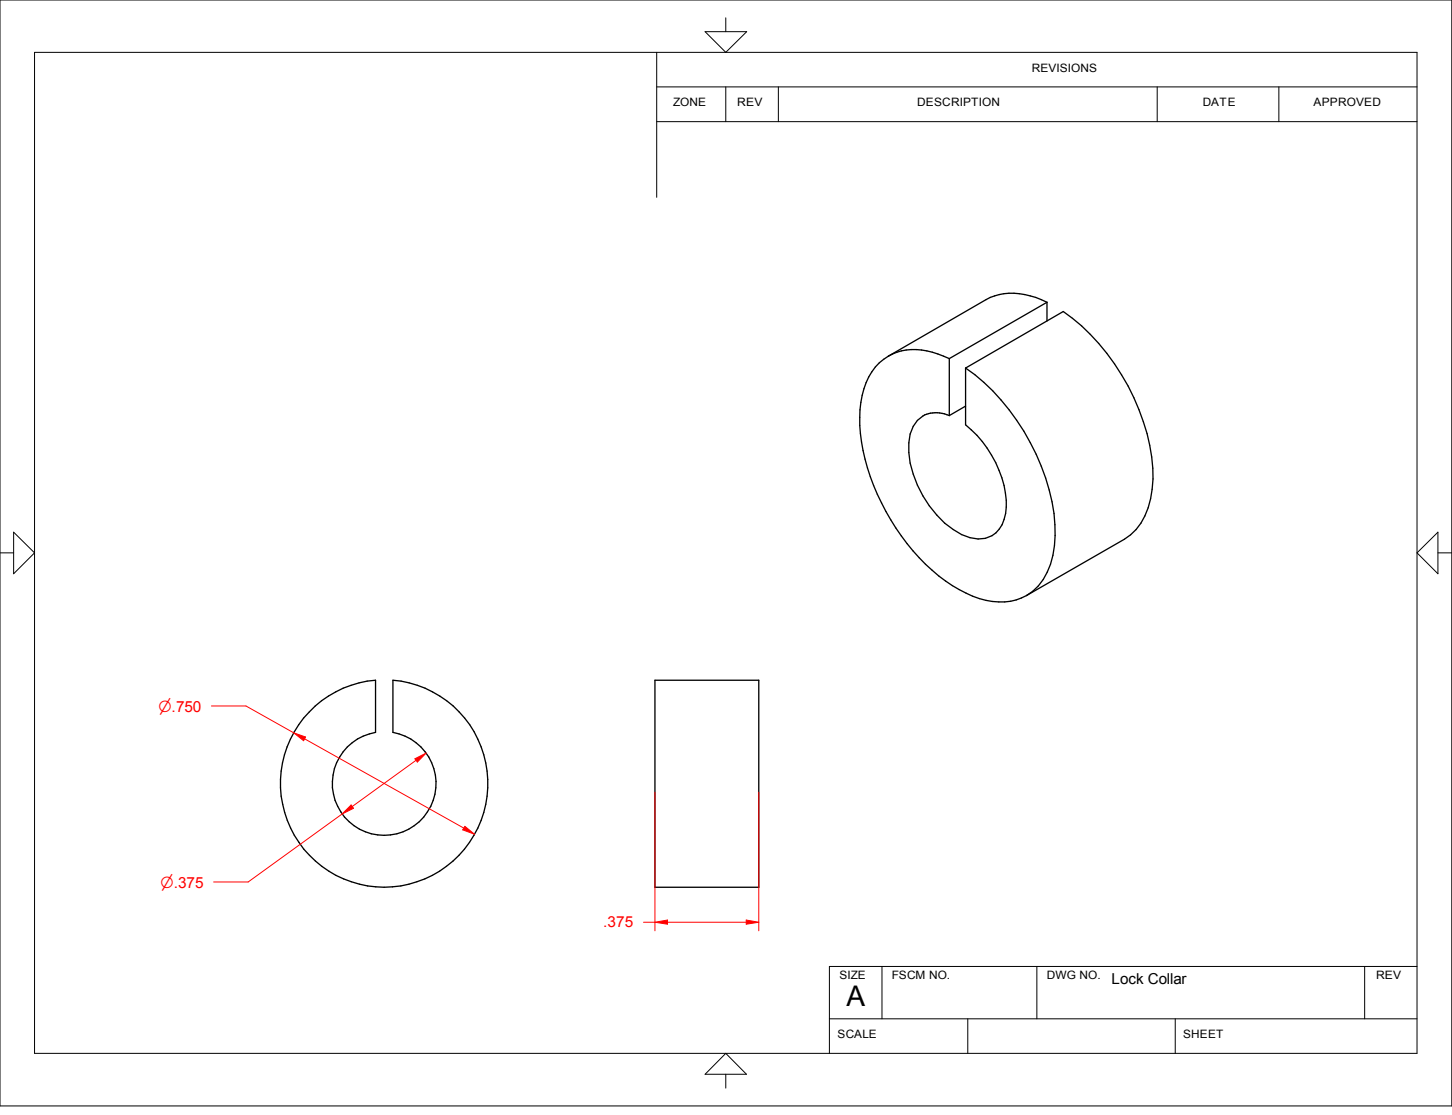
[picture p208: page 9]
REV; APPROVED; SIZE; ZONE; DESCRIPTION; DATE; FSCM NO.; DWG NO.; REV Lock Collar

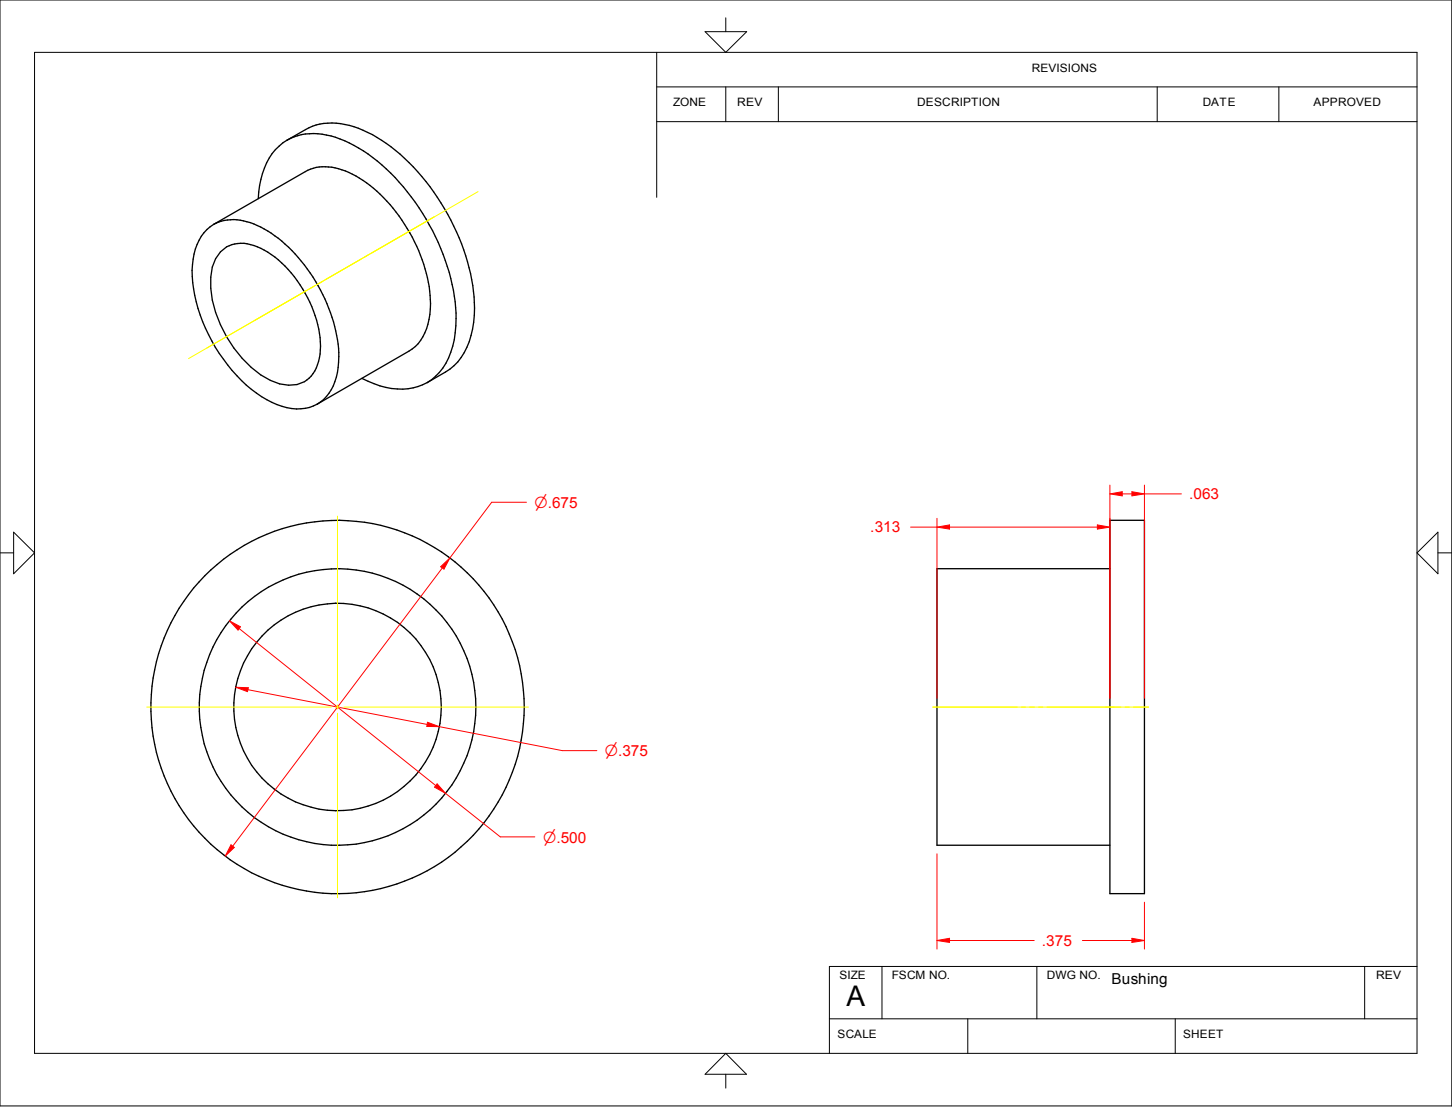
[picture p209: page 10]
SIZE; FSCM NO.; REV Bushing; DESCRIPTION; DATE; APPROVED; DWG NO.; ZONE; REV
