mwelling/robot-chopper/Documentation/Design Report Appendix/Test Stand Design Drawings/Base.pdf

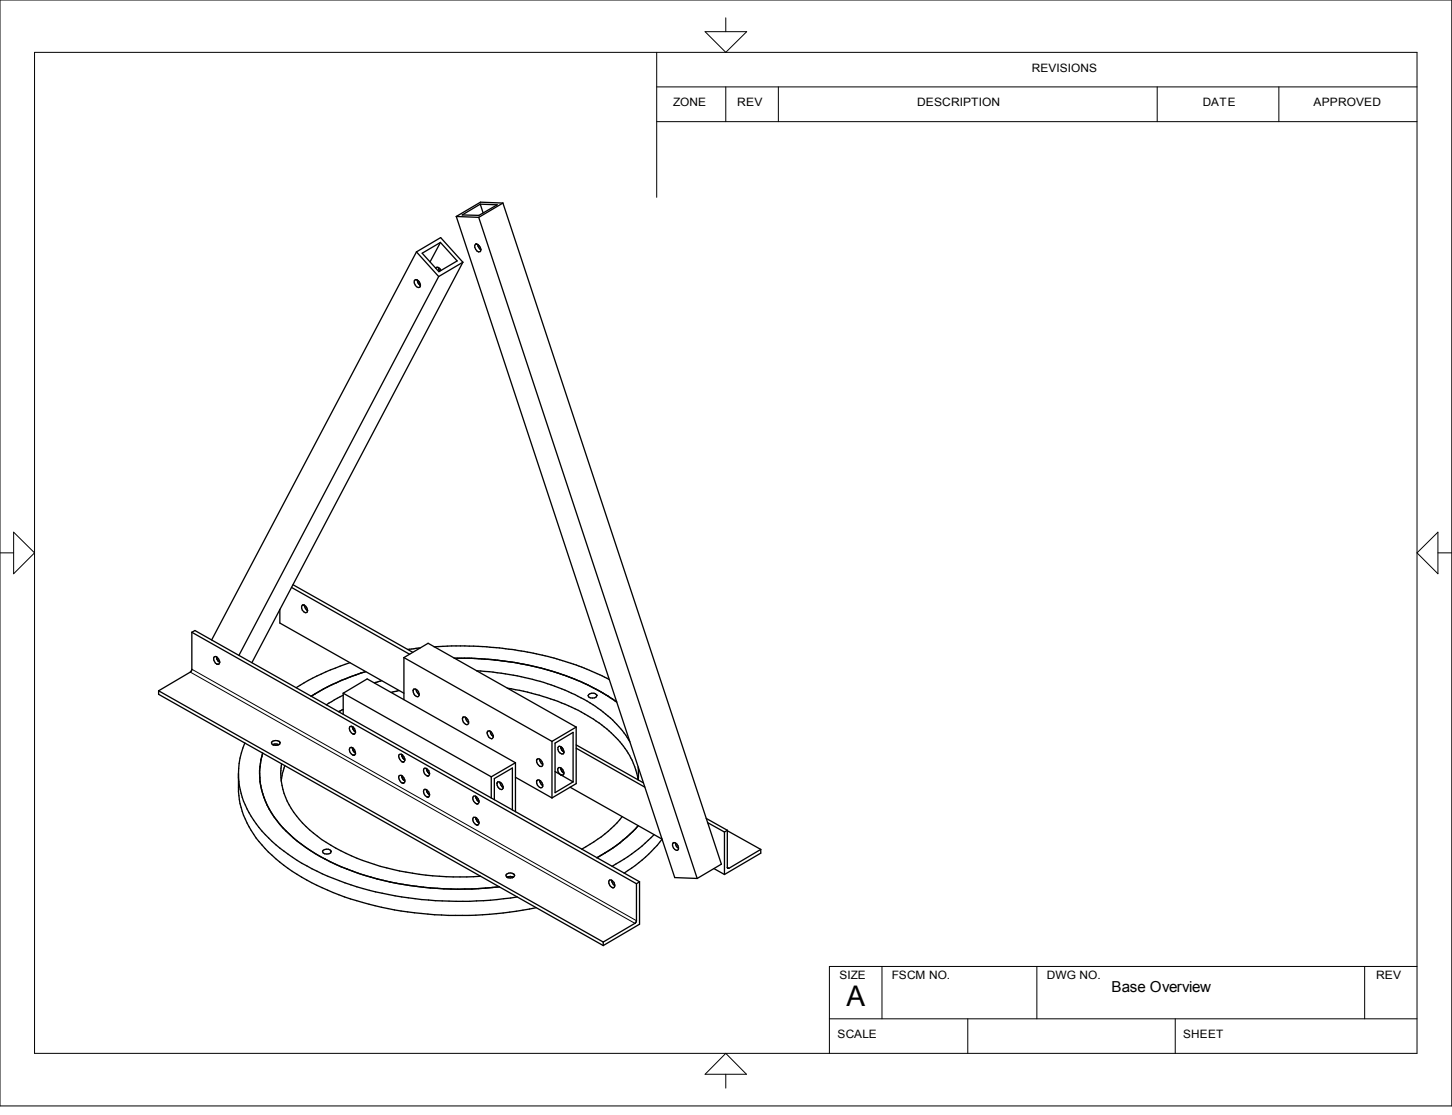
[picture p210: page 1]

REVISIONS

ZONE | REV | DESCRIPTION | DATE | APPROVED

SIZE A | FSCM NO. | DWG NO. Base Overview | REV

SCALE | | SHEET

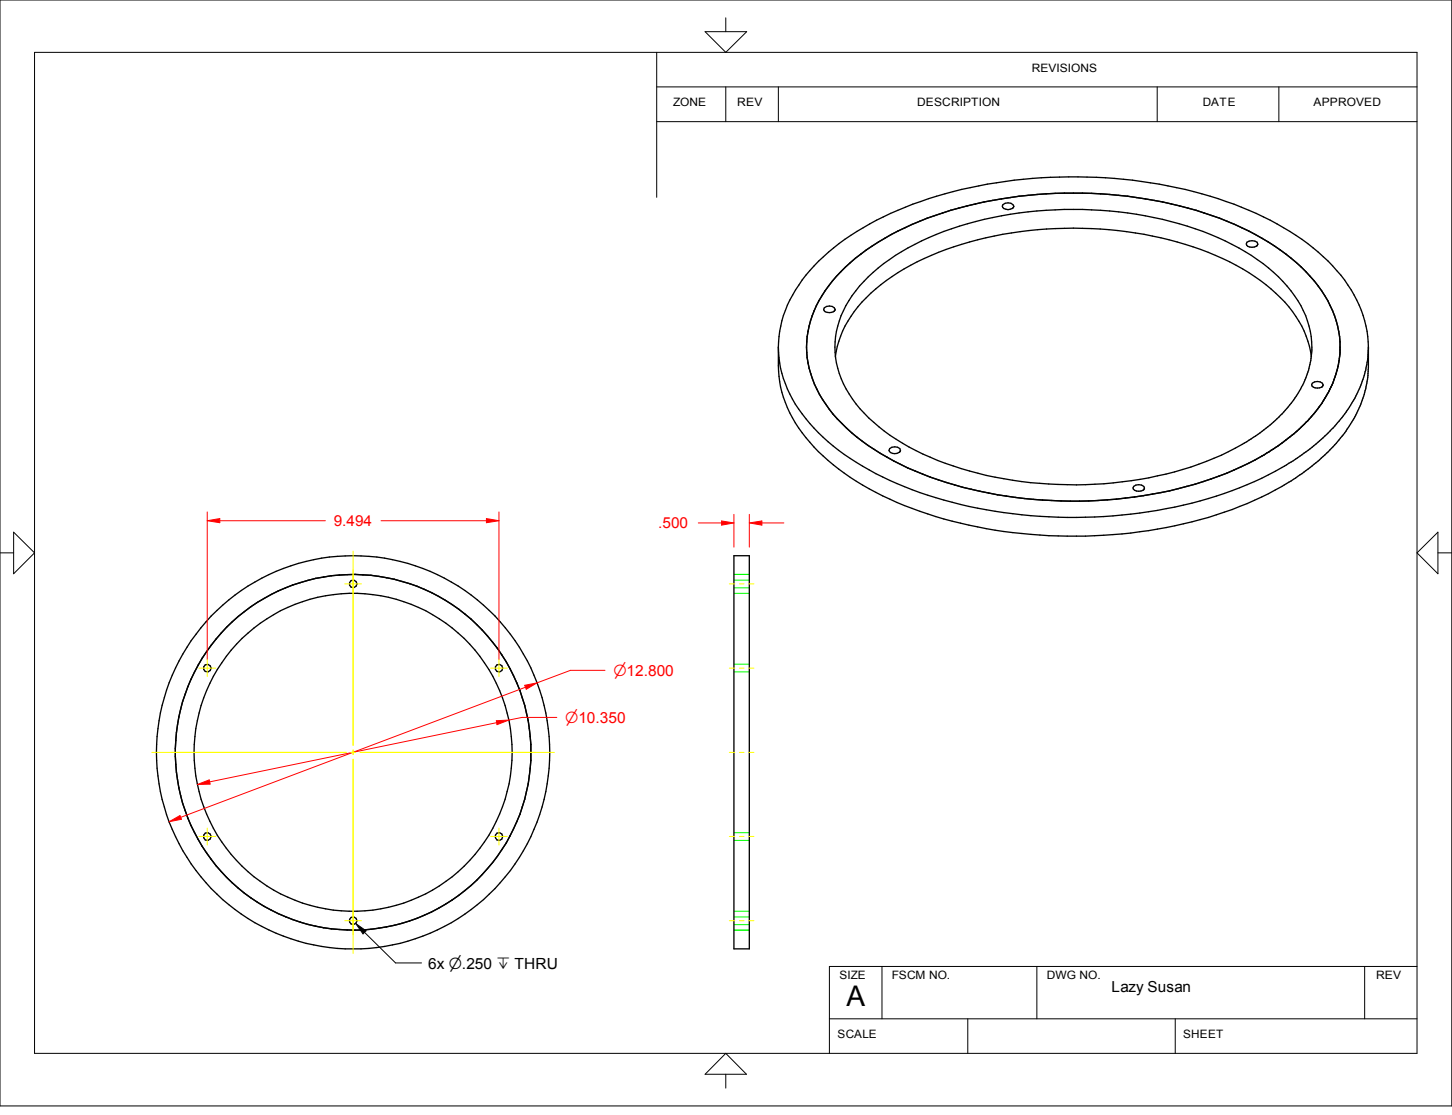
[picture p211: page 2]
6x n.250 x THRU; DESCRIPTION; APPROVED; SIZE A; FSCM NO.; REV; DATE; Lazy Susan; ZONE; DWG NO.

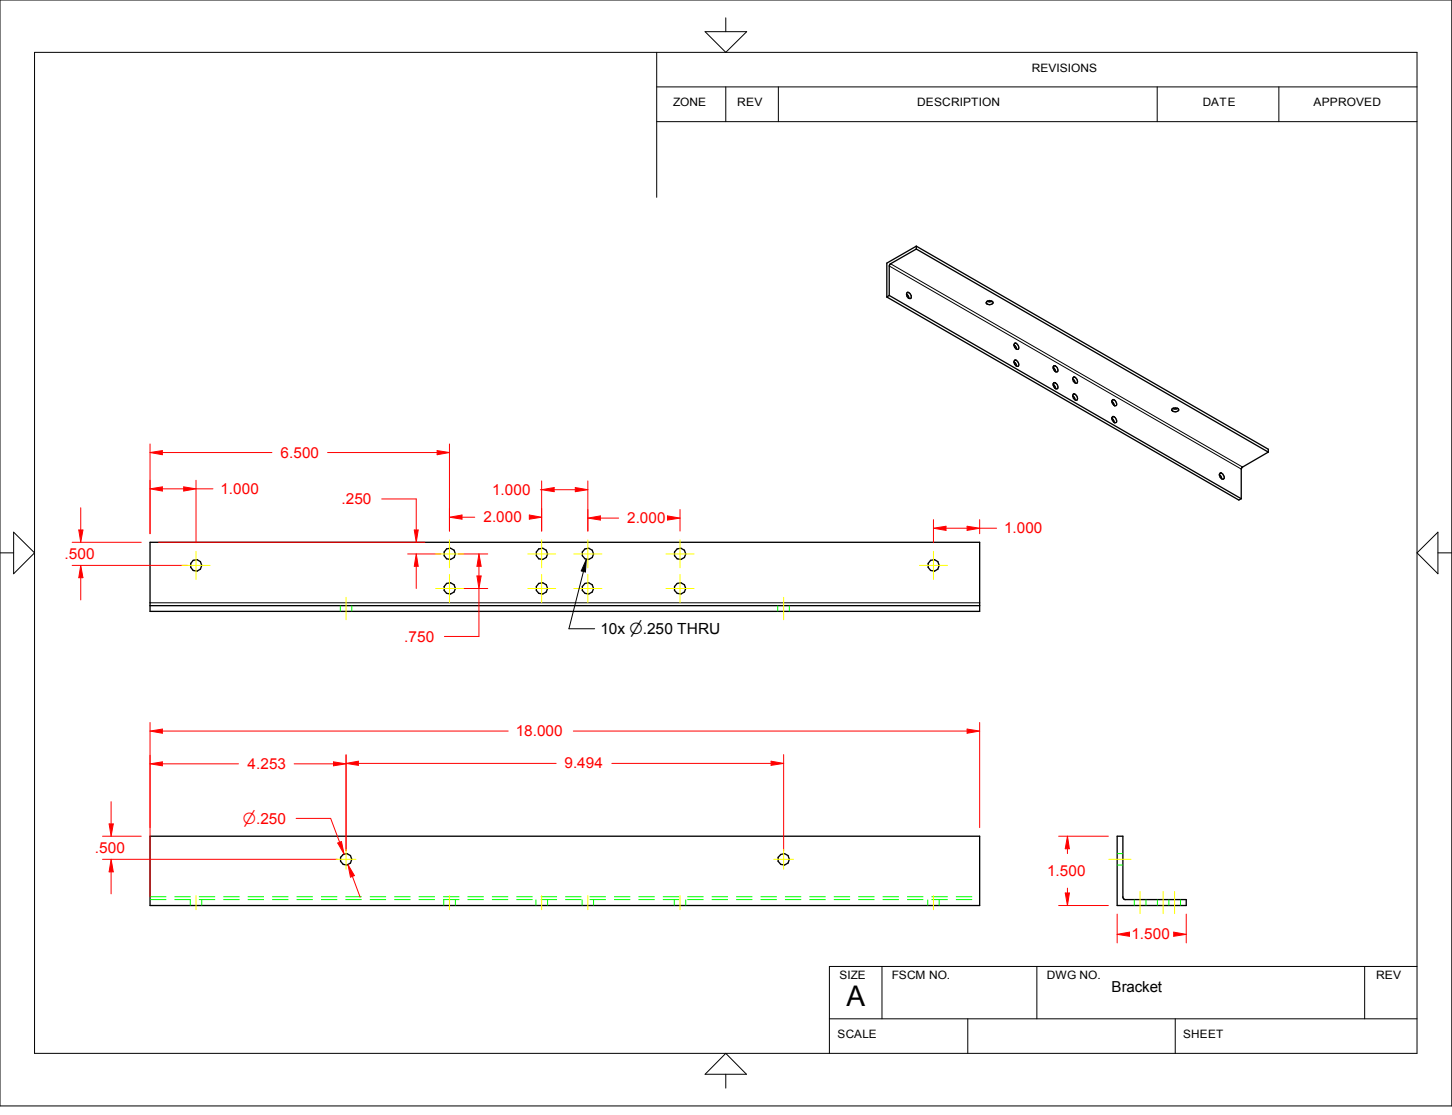
[picture p212: page 3]
10x n.250 THRU; Bracket A; SIZE; FSCM NO.; DWG NO.; ZONE; REV; APPROVED; DATE; DESCRIPTION

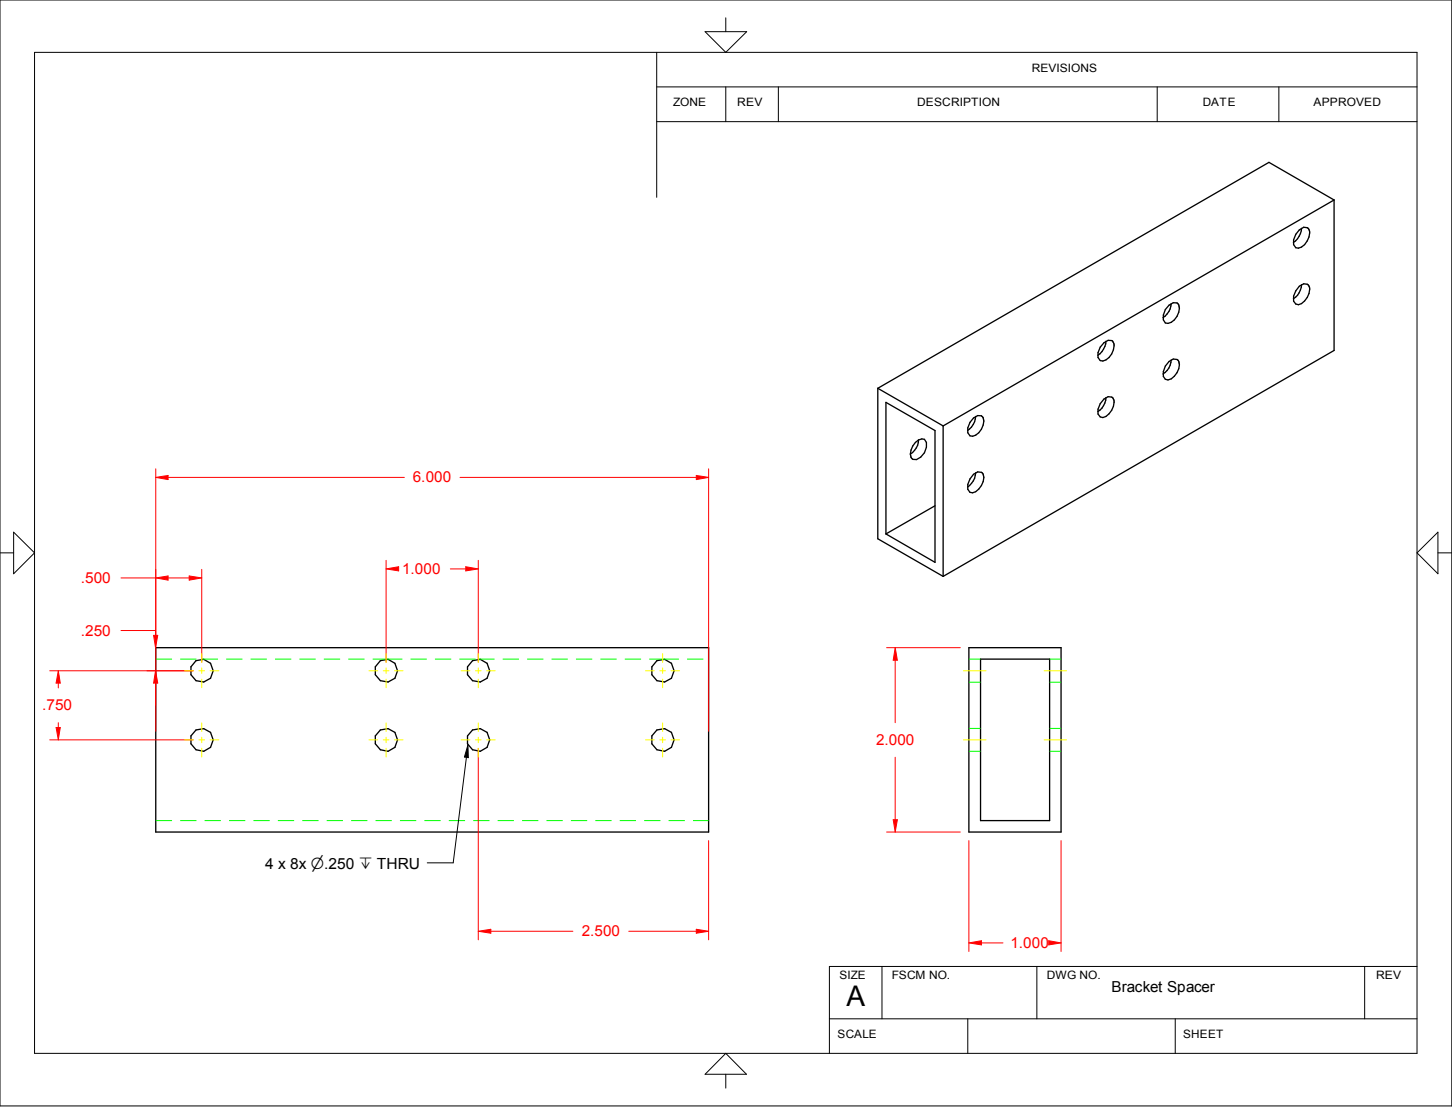
[picture p213: page 4]
4 x 8x n.250 x THRU; DESCRIPTION; DATE; REV; APPROVED; ZONE

SIZE A | FSCM NO. | DWG NO. Bracket Spacer | REV

SCALE | | SHEET

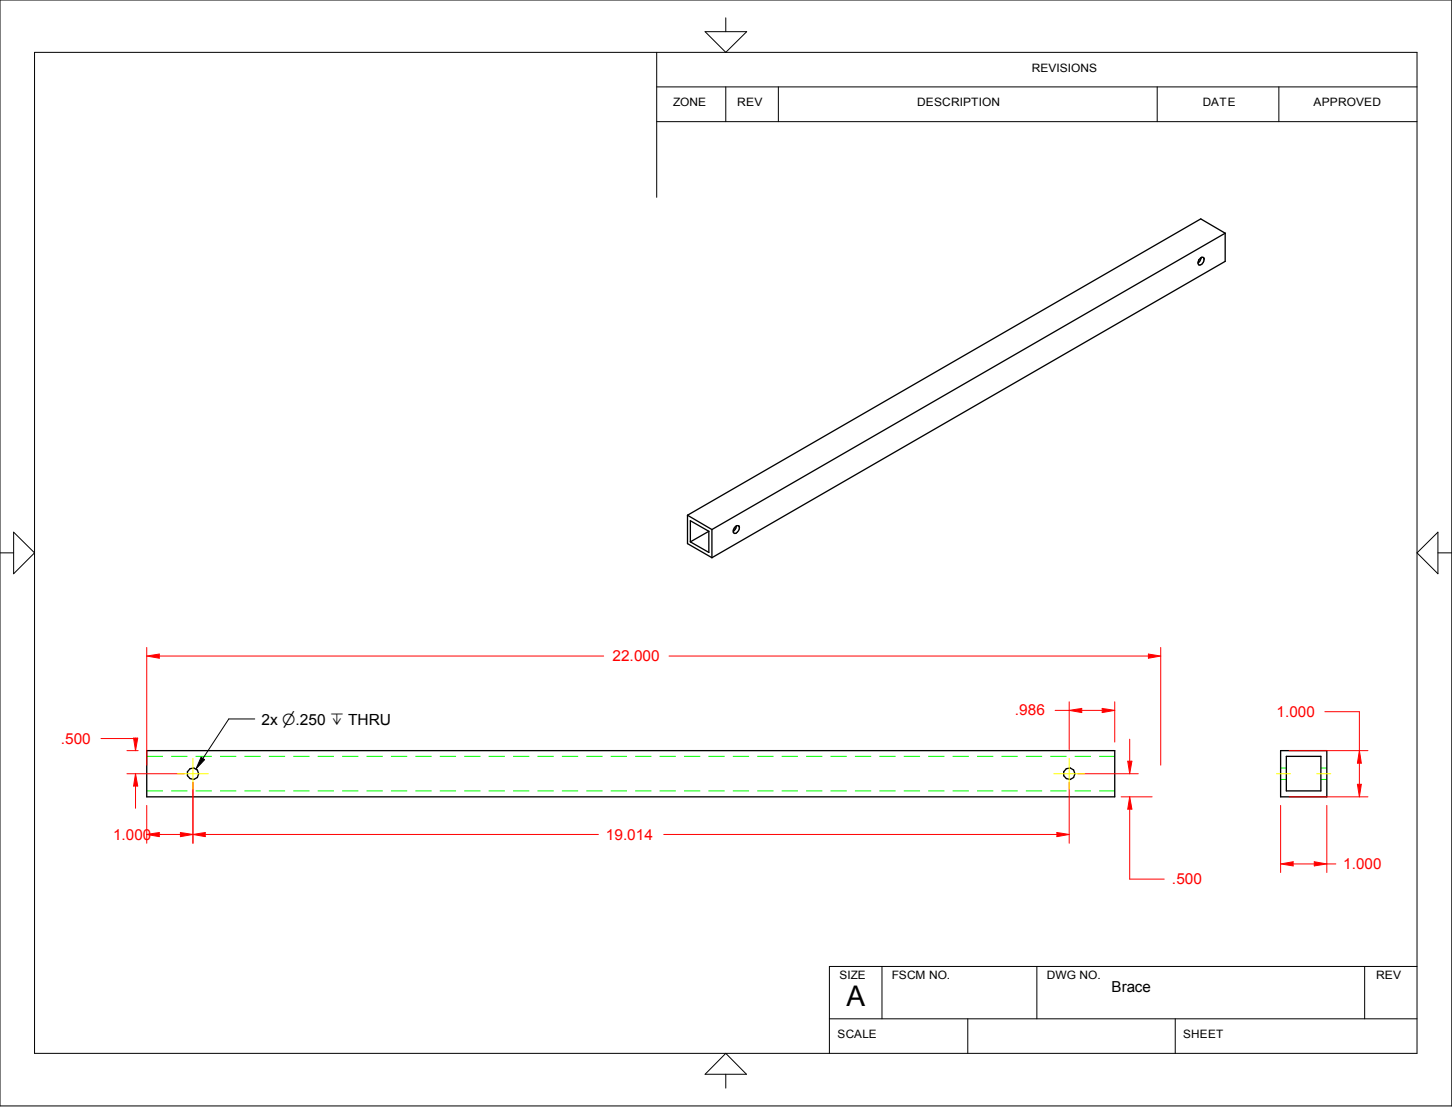
[picture p214: page 5]
.986 2x n.250 x THRU; DATE; REV; ZONE; DESCRIPTION; SIZE; APPROVED; FSCM NO.; DWG NO.; Brace
