mwelling/robot-chopper/Documentation/Design Report Appendix/Test Stand Design Drawings/Test Fixture.pdf

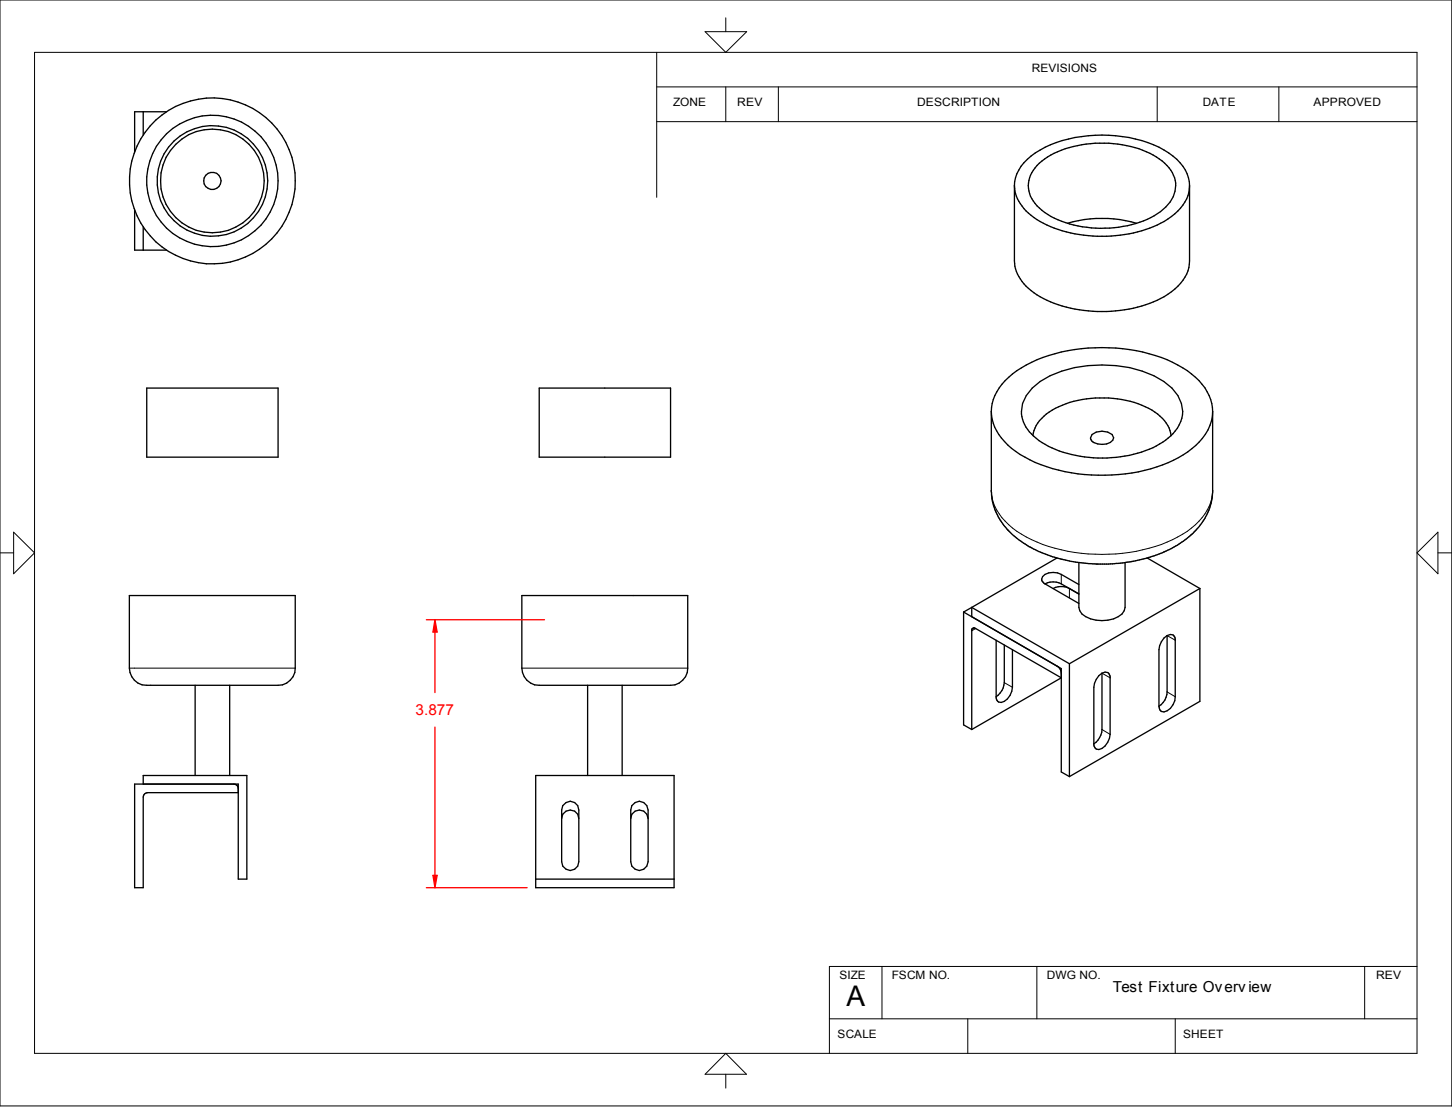
[picture p215: page 1]

REVISIONS

ZONE | REV | DESCRIPTION | DATE | APPROVED

SIZE A | FSCM NO. | DWG NO. Test Fixture Overv iew | REV

SCALE | | SHEET

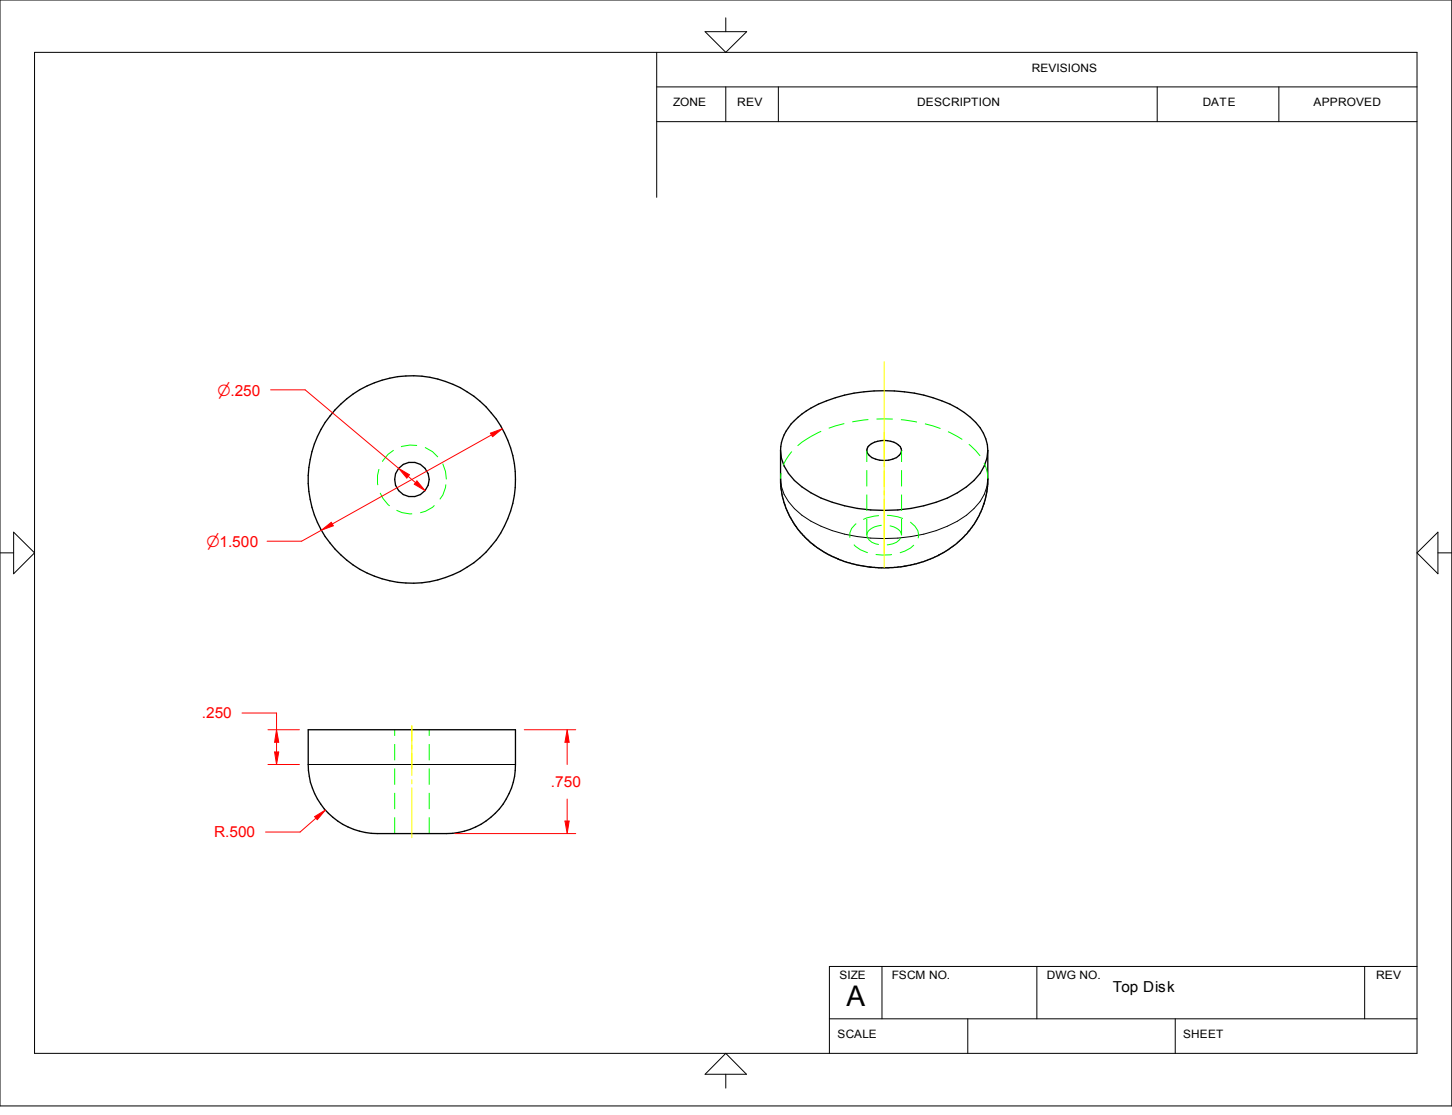
[picture p216: page 2]
DATE; Top Disk; REV; DESCRIPTION; SIZE; FSCM NO.; DWG NO.; ZONE; APPROVED

n.500

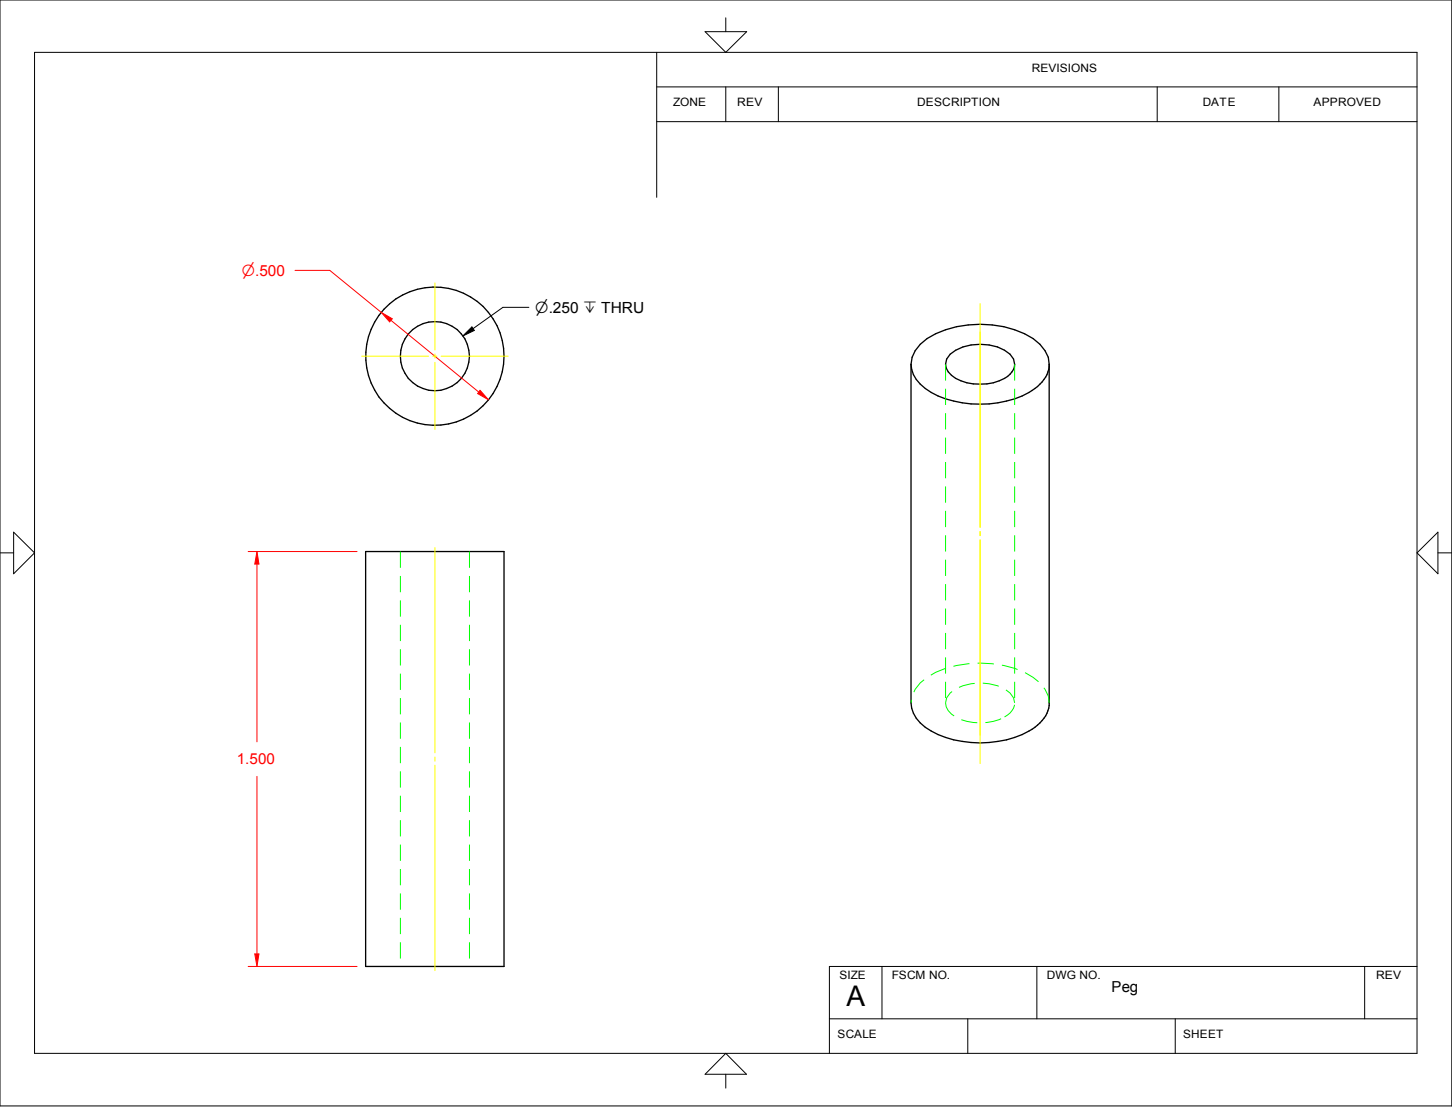
[picture p217: page 3]
n.250 x THRU; REV; APPROVED; Peg A; DWG NO.; DATE; SIZE; DESCRIPTION; ZONE; FSCM NO.

1.500

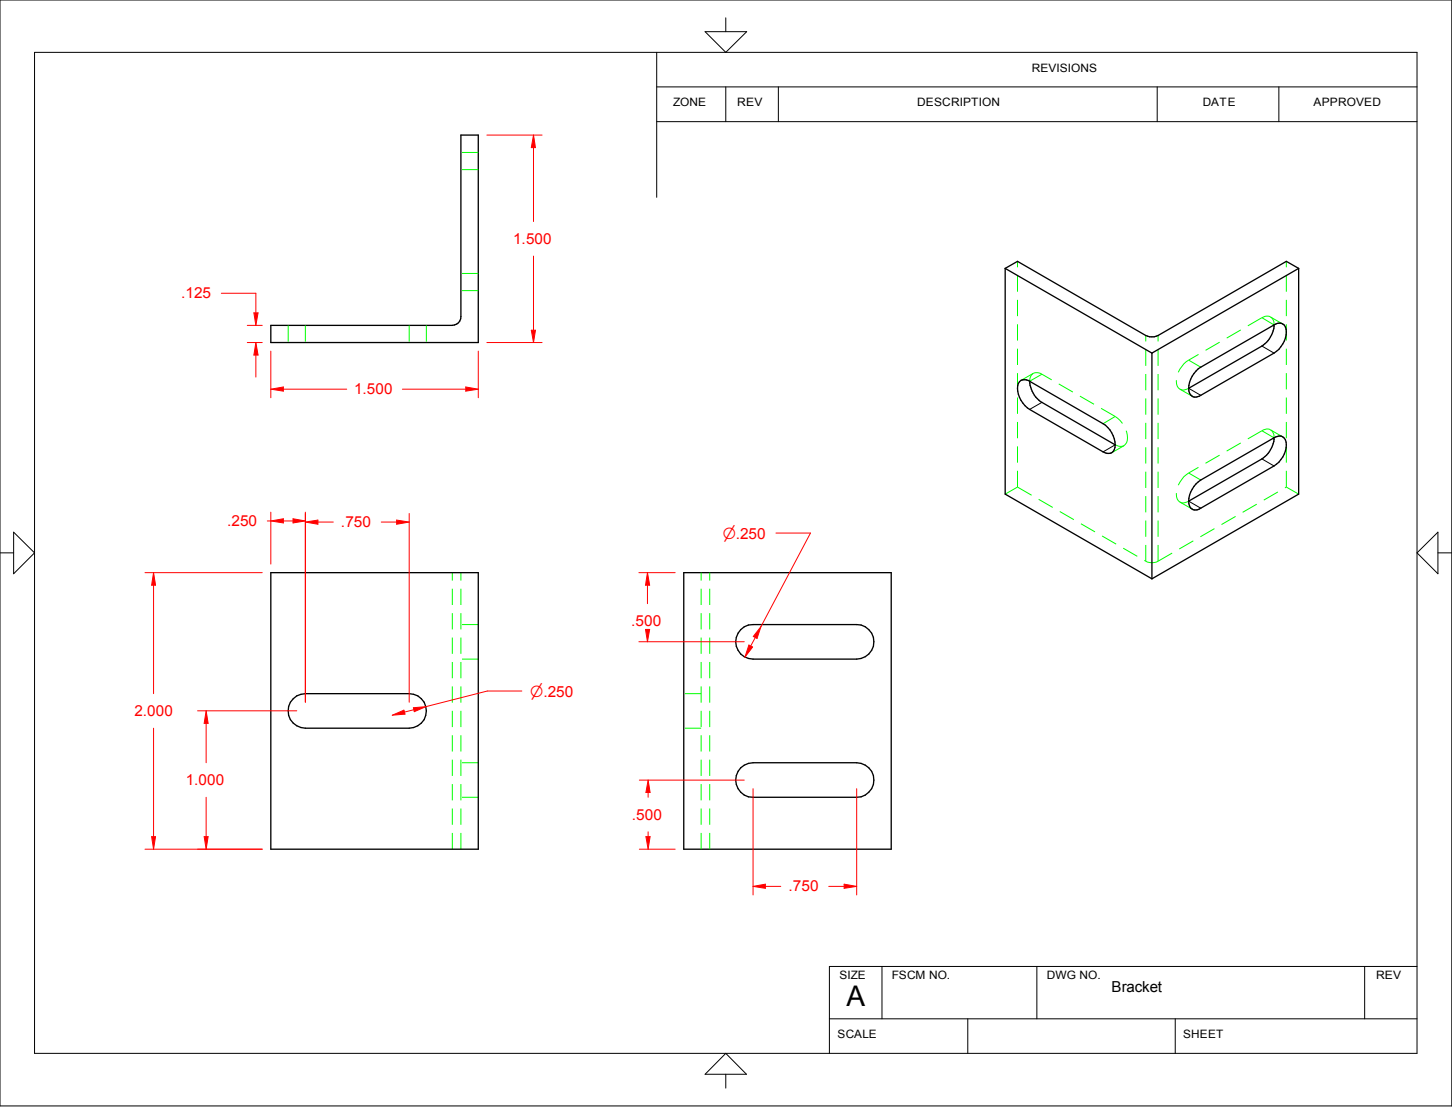
[picture p218: page 4]
FSCM NO.; REV; ZONE; APPROVED; DESCRIPTION; SIZE; DATE; DWG NO.; Bracket

n2.400

n1.750

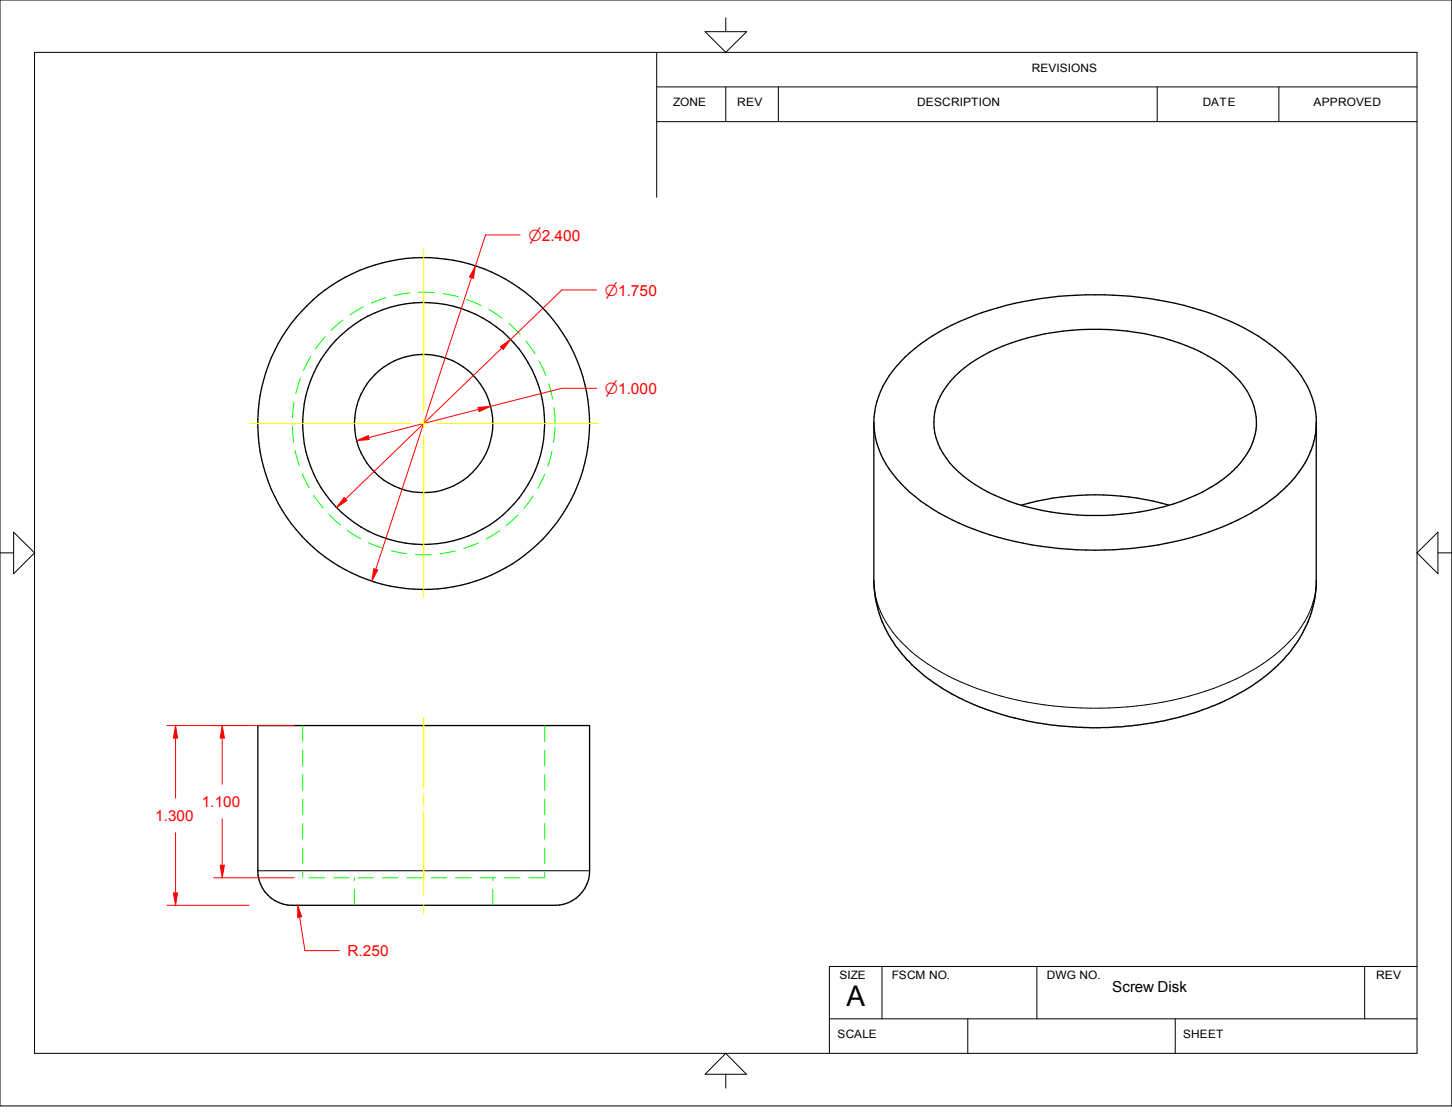
[picture p219: page 5]
REV; Screw Disk; DWG NO.; ZONE; DESCRIPTION; FSCM NO.; SIZE; APPROVED; DATE
