mwelling/robot-chopper/TestStand/Design/Drawings/Arm Assembly.pdf

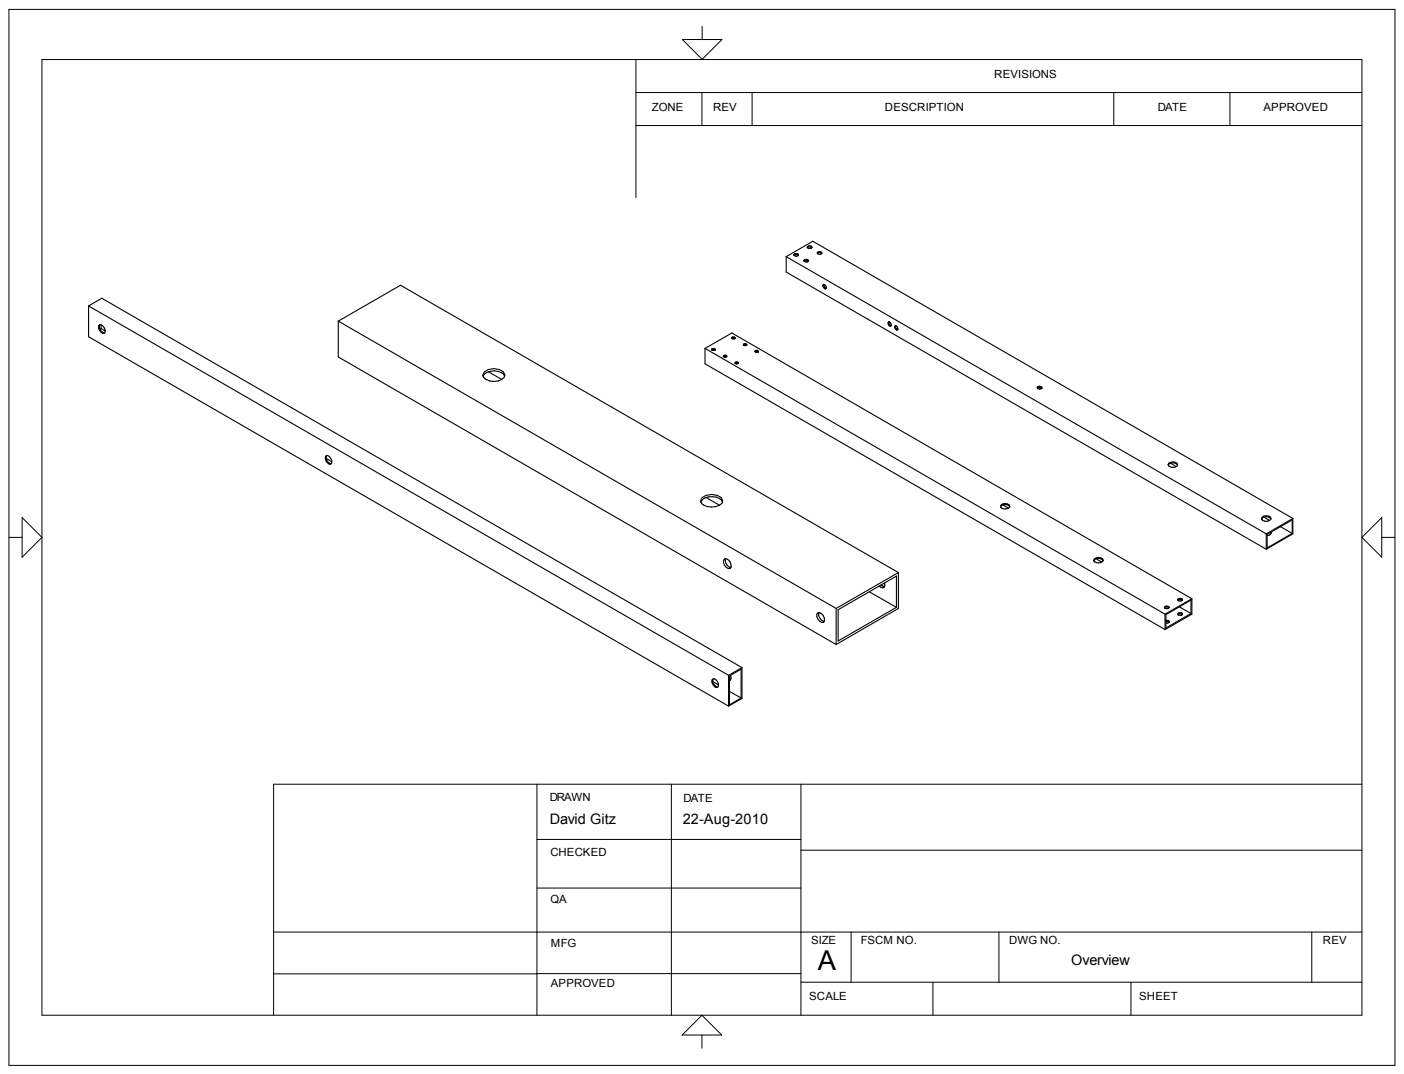
[picture p220: page 1]

REVISIONS

ZONE | REV | DESCRIPTION | DATE | APPROVED

DRAWN David Gitz | DATE 22-Aug-2010

CHECKED

MFG | | SIZE A | FSCM NO. | DWG NO. Overview | REV

APPROVED

SCALE | SHEET

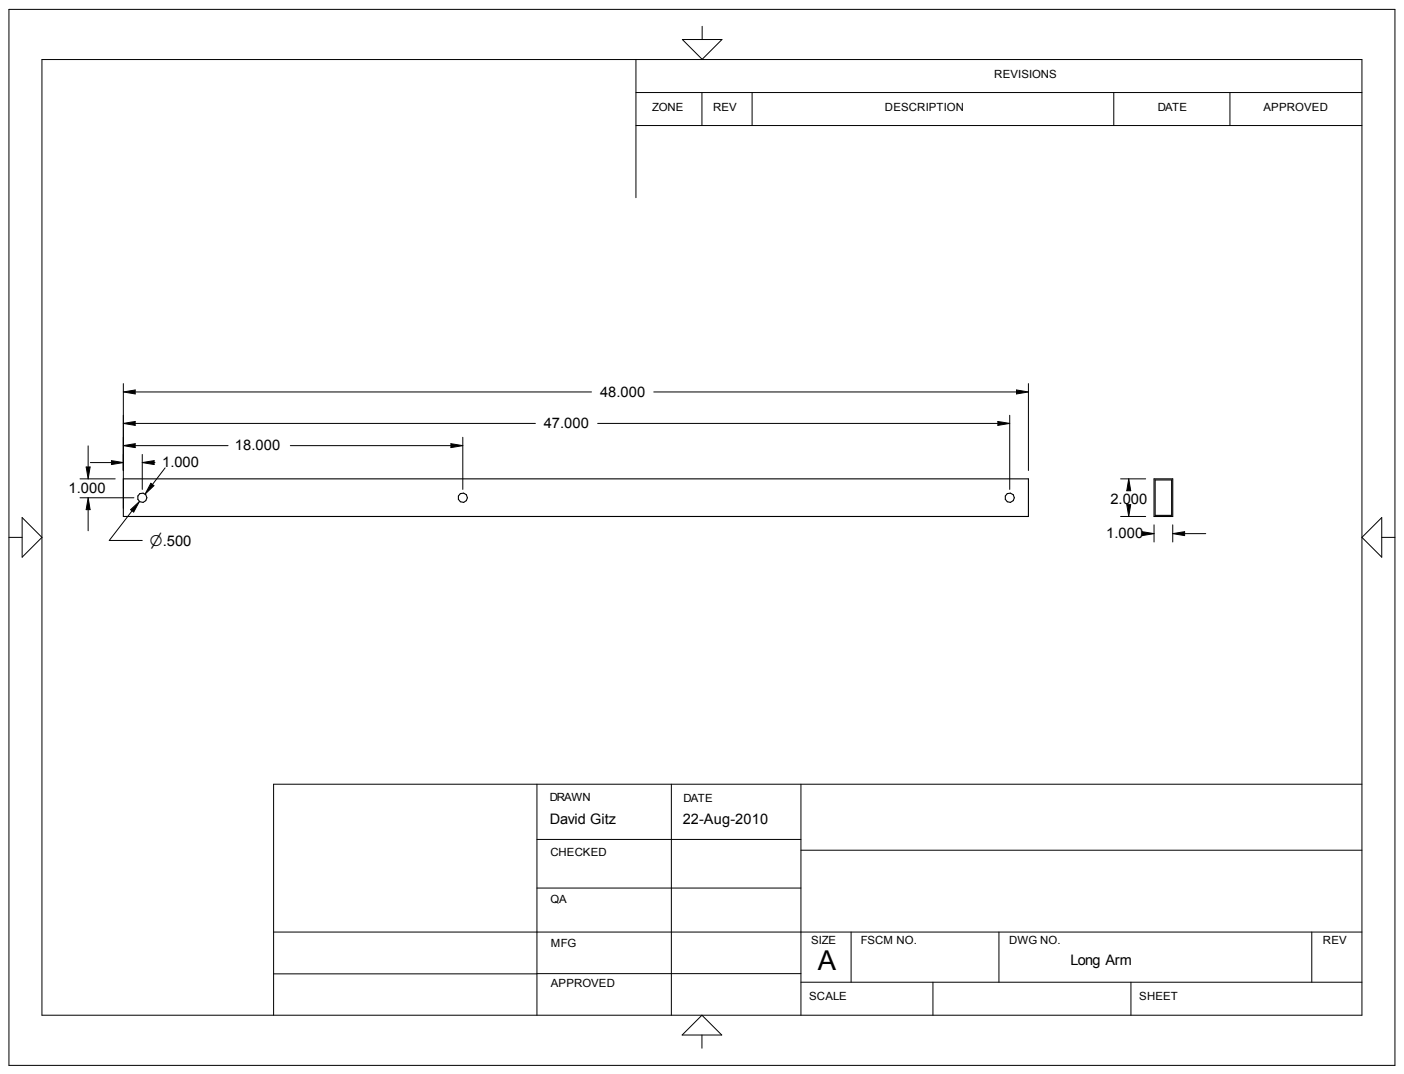
[picture p221: page 2]
DATE; ZONE; APPROVED; DESCRIPTION; REV

DRAWN David Gitz | DATE 22-Aug-2010

CHECKED

MFG | | SIZE A | FSCM NO. | DWG NO. Long Arm | REV

APPROVED

SCALE | SHEET

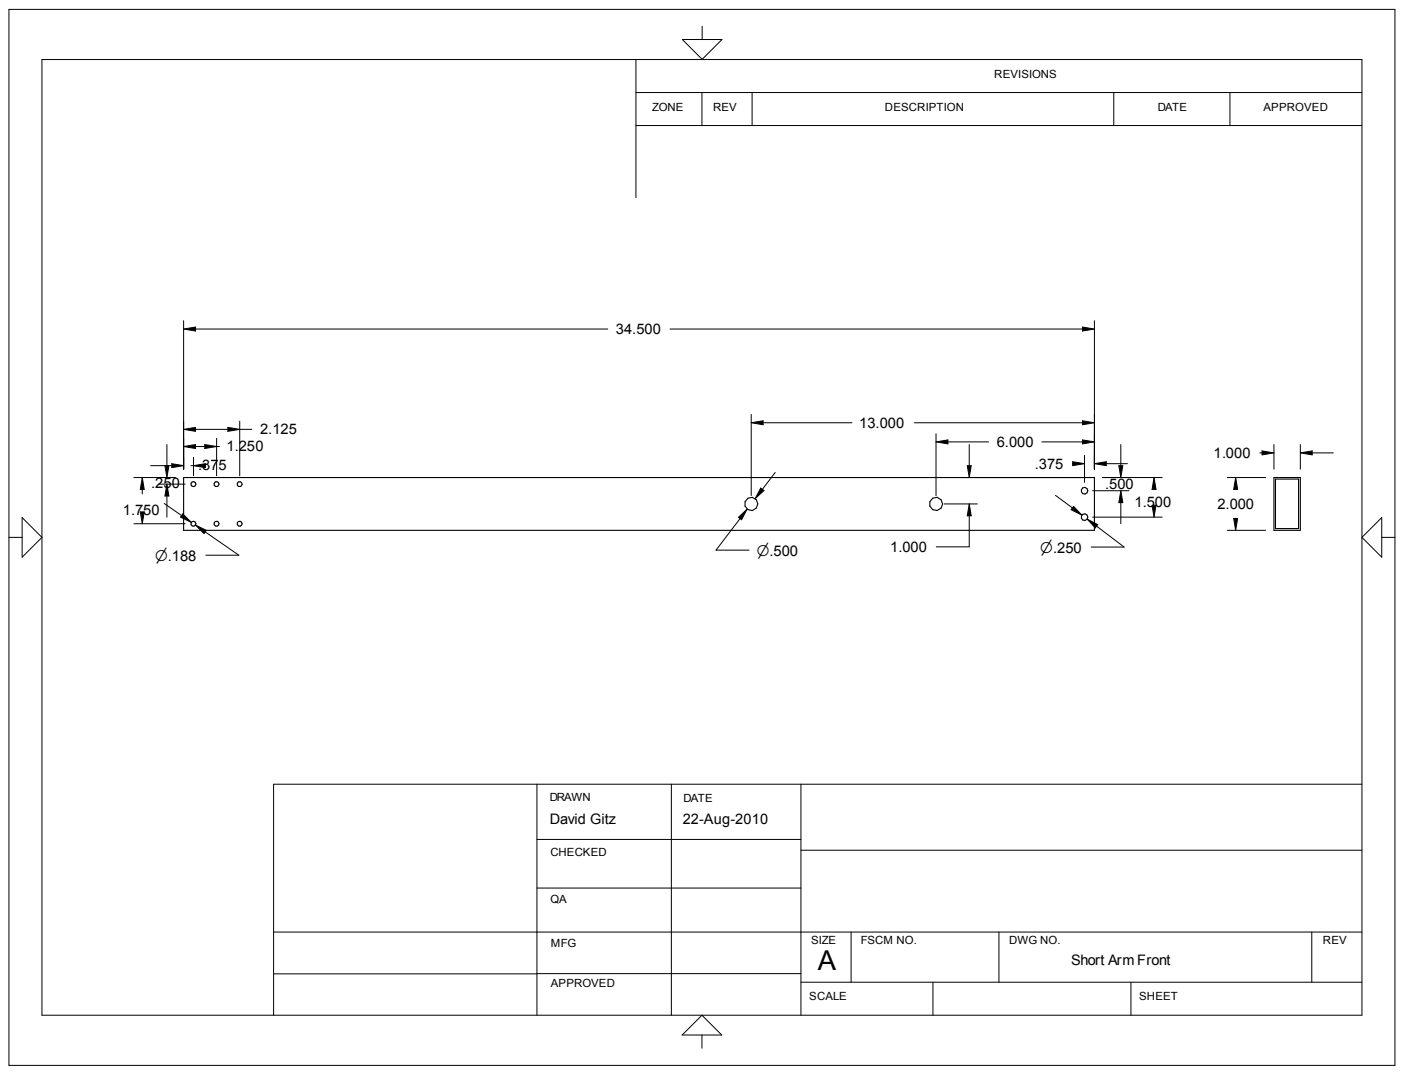
[picture p222: page 3]
DATE; DESCRIPTION; APPROVED; ZONE; REV

DRAWN David Gitz | DATE 22-Aug-2010

CHECKED

MFG | | SIZE A | FSCM NO. | DWG NO. Short Arm Front | REV

APPROVED

SCALE | SHEET

5.000

12.000

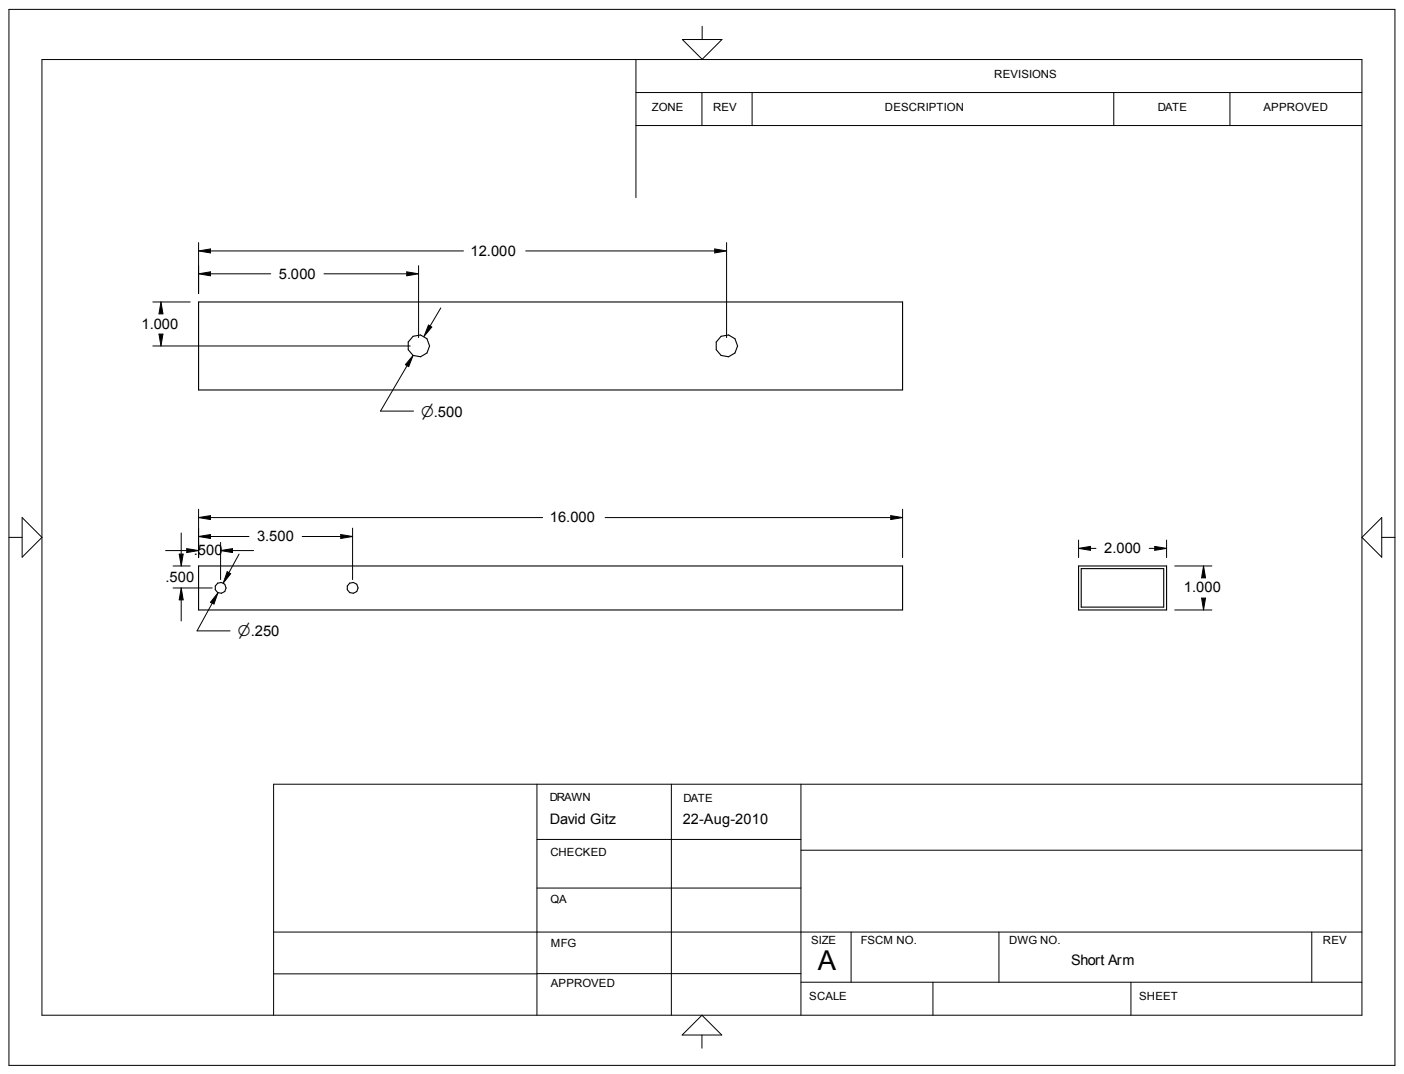
[picture p223: page 4]
ZONE; APPROVED; DATE; DESCRIPTION; REV

DRAWN David Gitz | DATE 22-Aug-2010

CHECKED

MFG | | SIZE A | FSCM NO. | DWG NO. Short Arm | REV

APPROVED

SCALE | SHEET

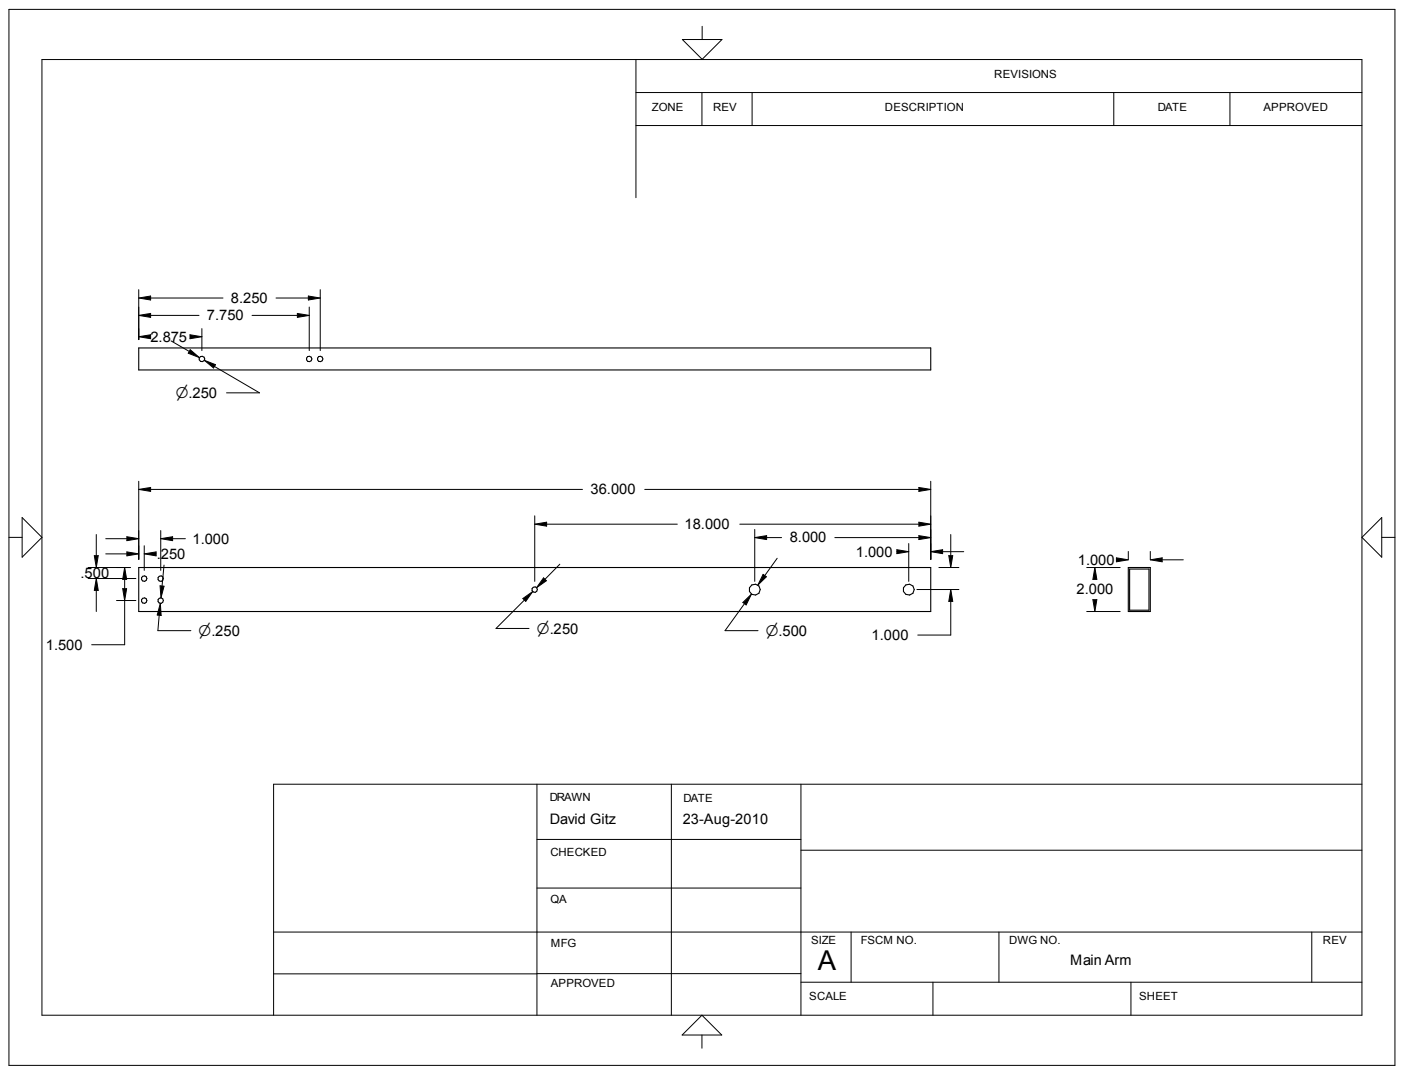
[picture p224: page 5]
APPROVED; REV; ZONE; DATE; DESCRIPTION

DRAWN David Gitz | DATE 23-Aug-2010

CHECKED

MFG | | SIZE A | FSCM NO. | DWG NO. Main Arm | REV

APPROVED

SCALE | SHEET
