mwelling/robot-chopper/TestStand/Design/Drawings/Base Assembly.pdf

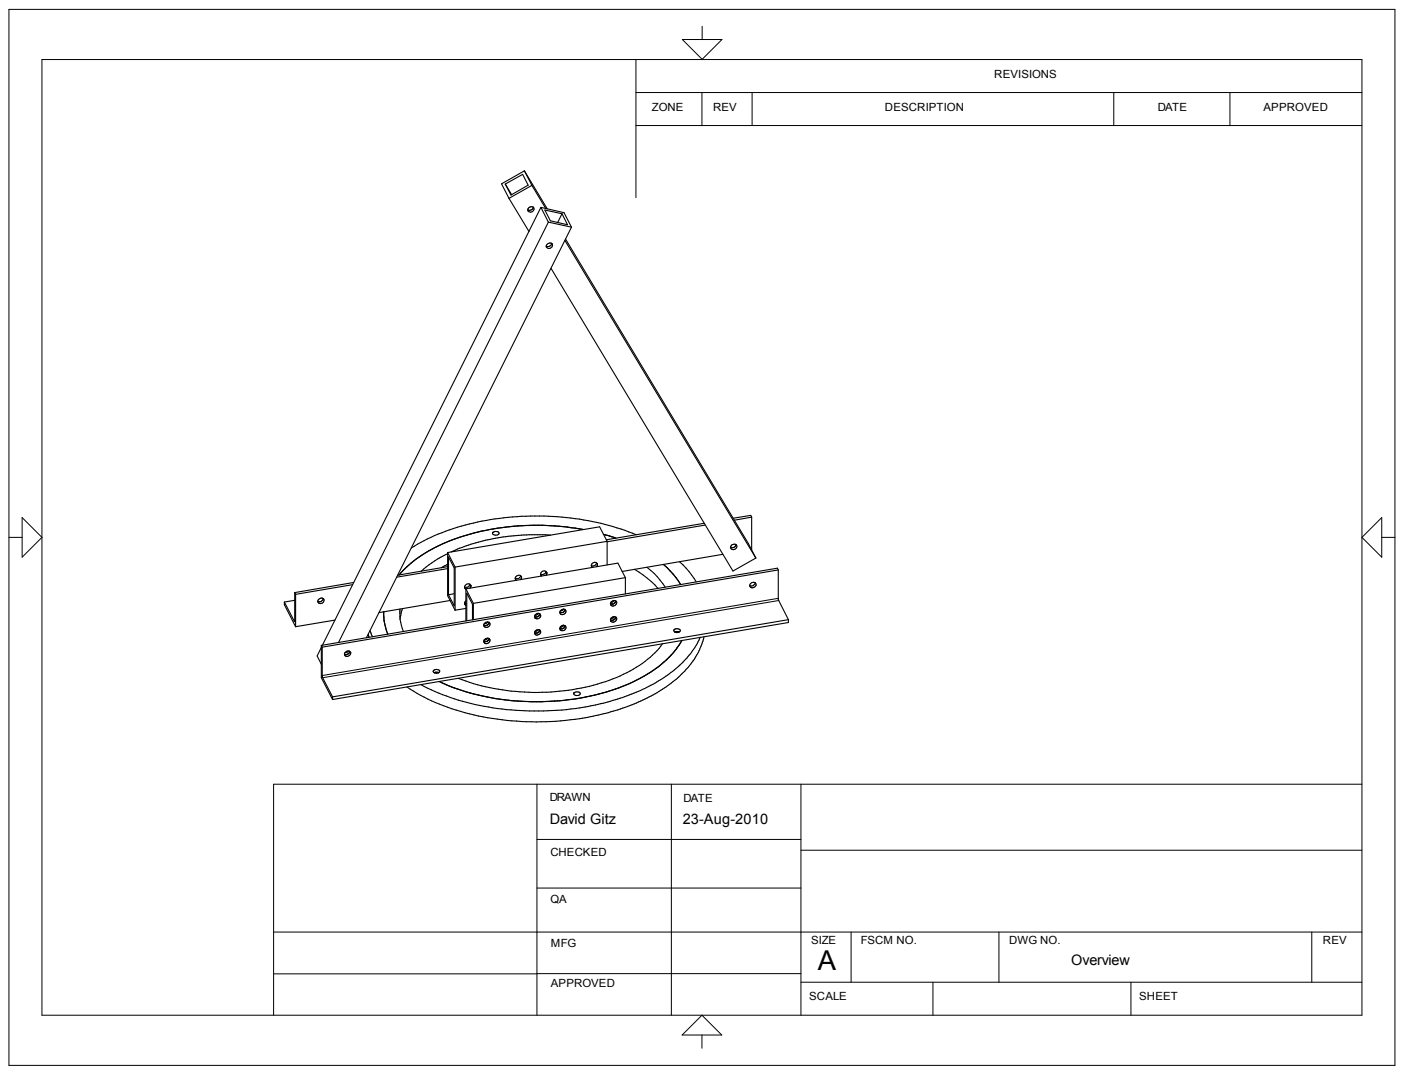
[picture p225: page 1]

REVISIONS

ZONE | REV | DESCRIPTION | DATE | APPROVED

DRAWN David Gitz | DATE 23-Aug-2010

CHECKED

MFG | | SIZE A | FSCM NO. | DWG NO. Overview | REV

APPROVED

SCALE | SHEET

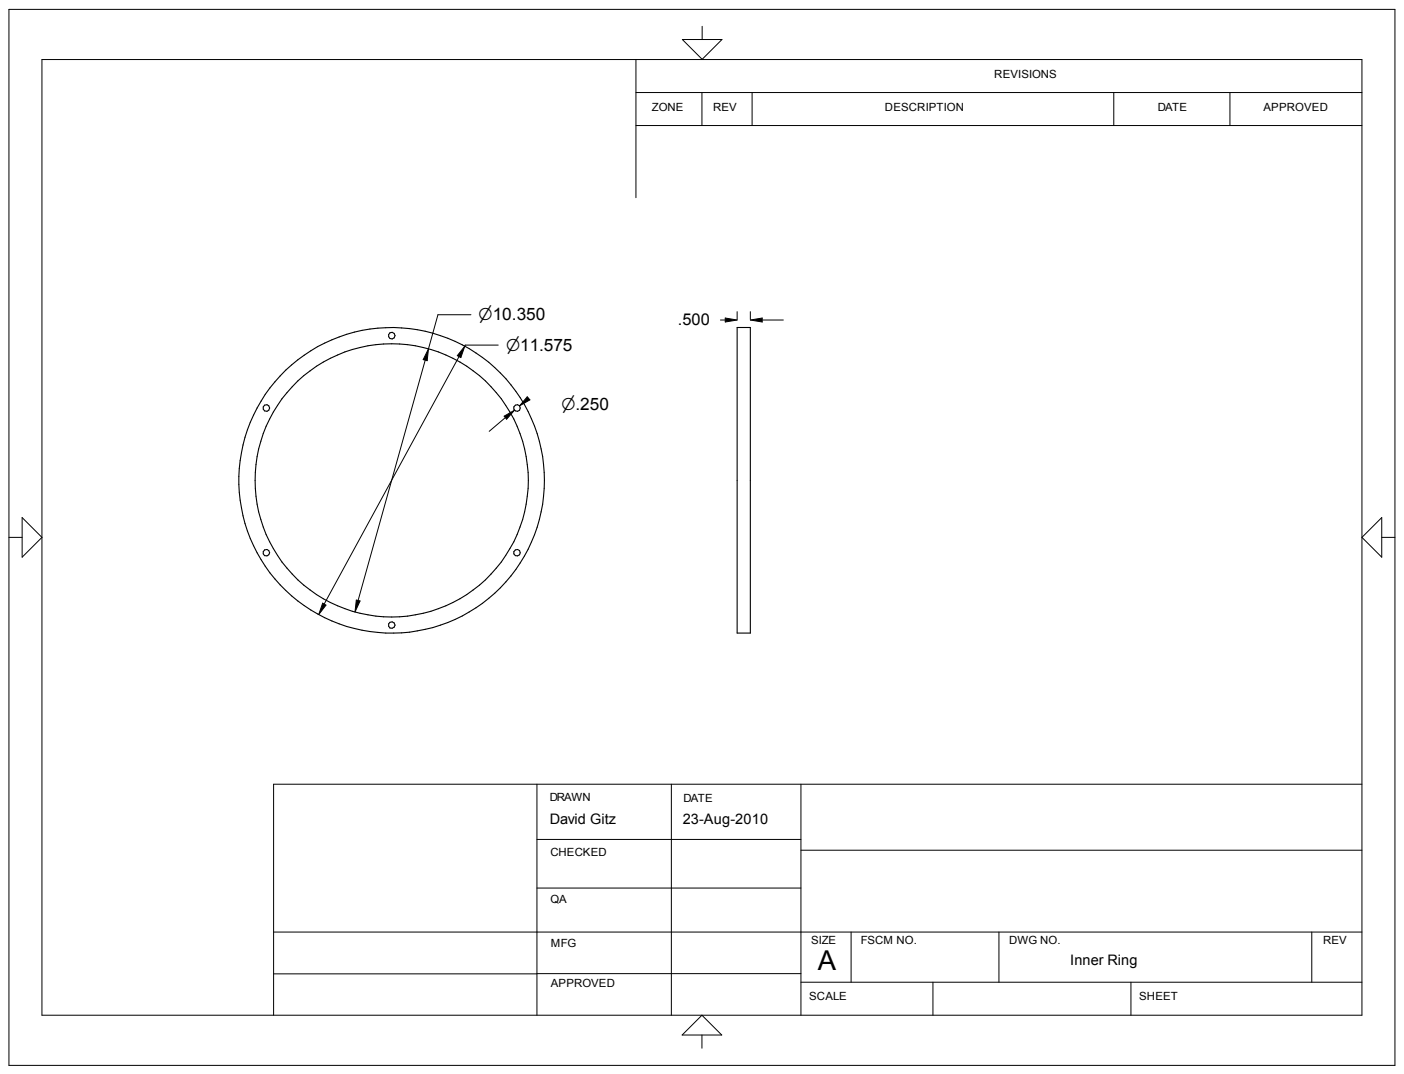
[picture p226: page 2]
DESCRIPTION; DATE; APPROVED; ZONE; REV

DRAWN David Gitz | DATE 23-Aug-2010

CHECKED

MFG | | SIZE A | FSCM NO. | DWG NO. Inner Ring | REV

APPROVED

SCALE | SHEET

n11.575

n12.800

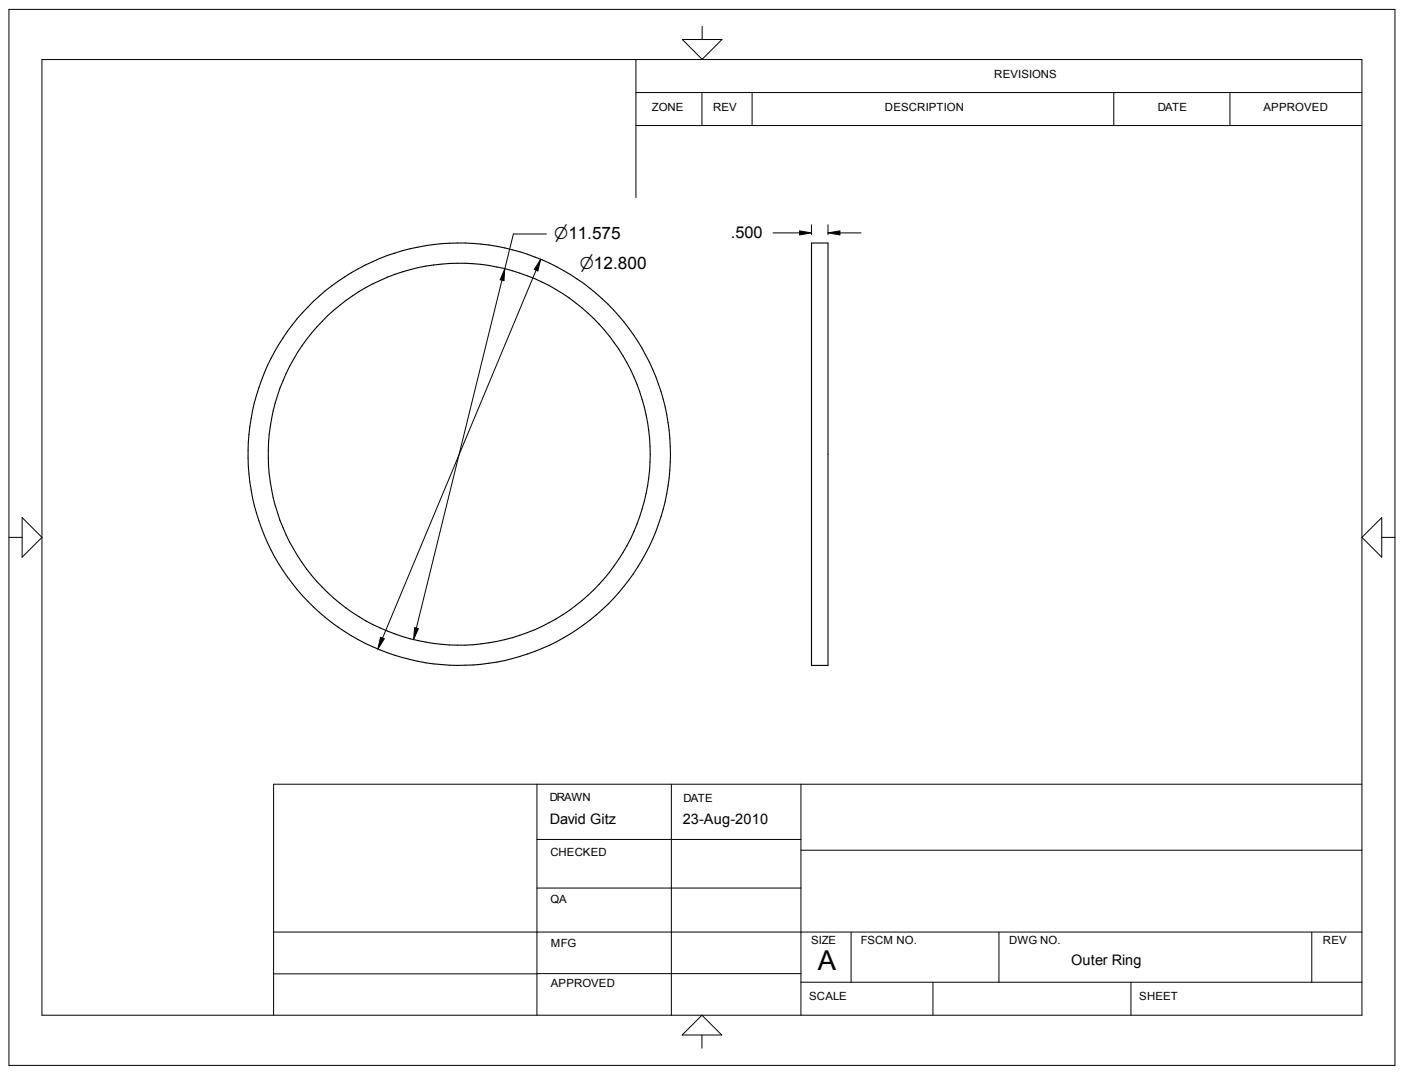
[picture p227: page 3]
ZONE; REV; DESCRIPTION; DATE; APPROVED

DRAWN David Gitz | DATE 23-Aug-2010

CHECKED

MFG | | SIZE A | FSCM NO. | DWG NO. Outer Ring | REV

APPROVED

SCALE | SHEET

3.500

5.500

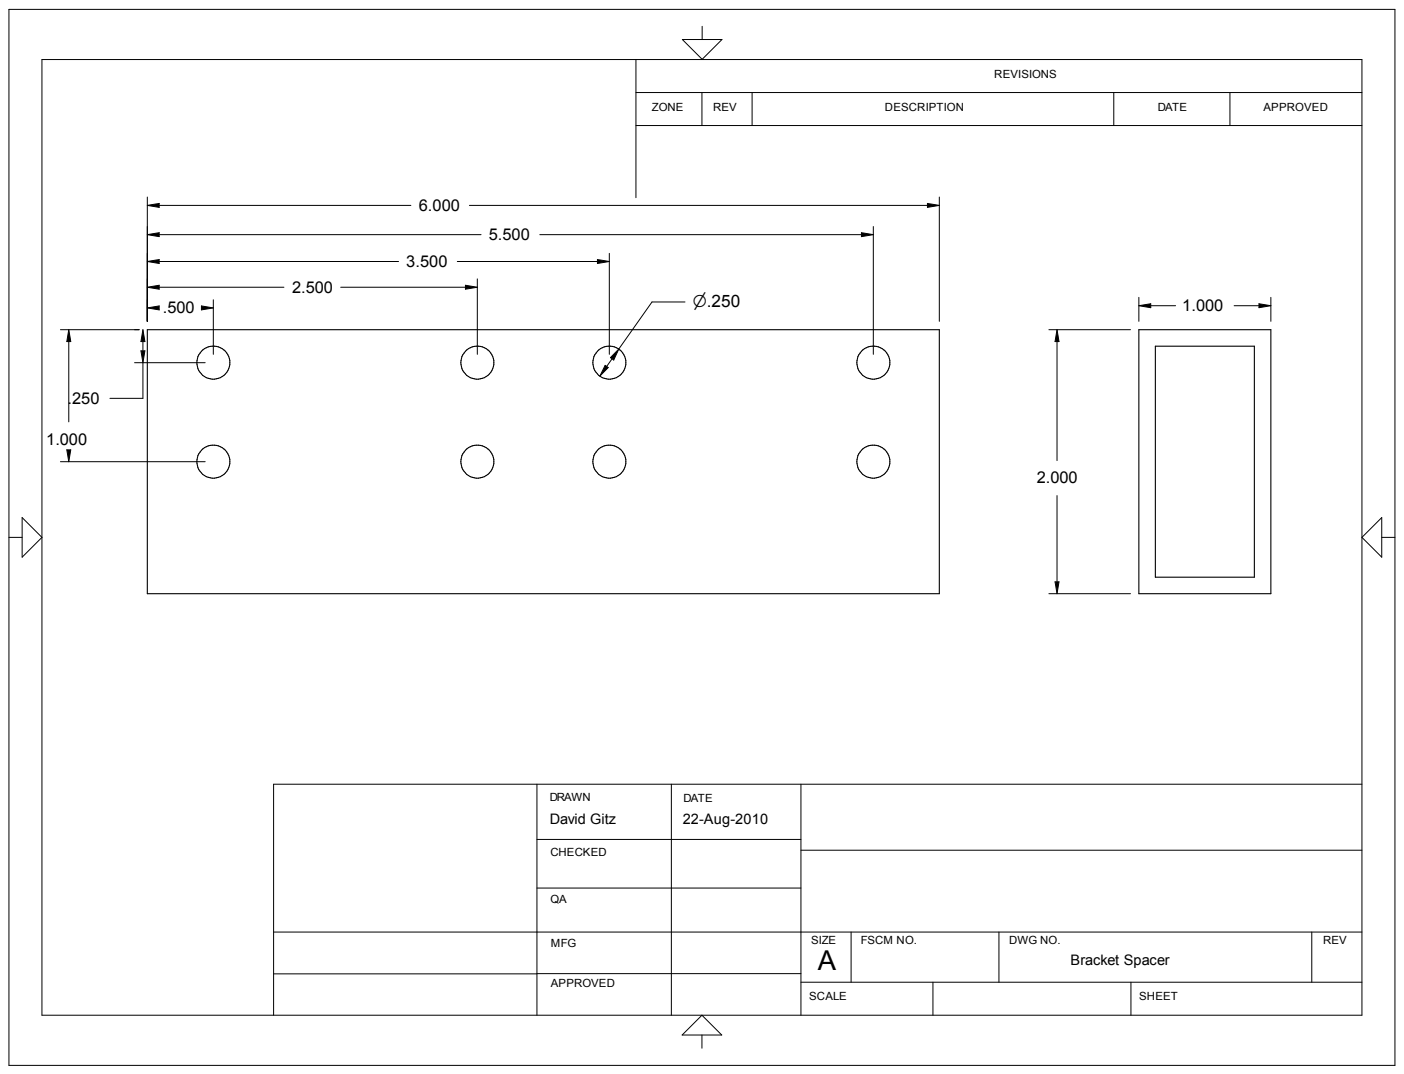
[picture p228: page 4]
DESCRIPTION; DATE; ZONE; REV; APPROVED

DRAWN David Gitz | DATE 22-Aug-2010

CHECKED

QA
MFG | | SIZE A | FSCM NO. | DWG NO. Bracket Spacer | REV

APPROVED

SCALE | SHEET

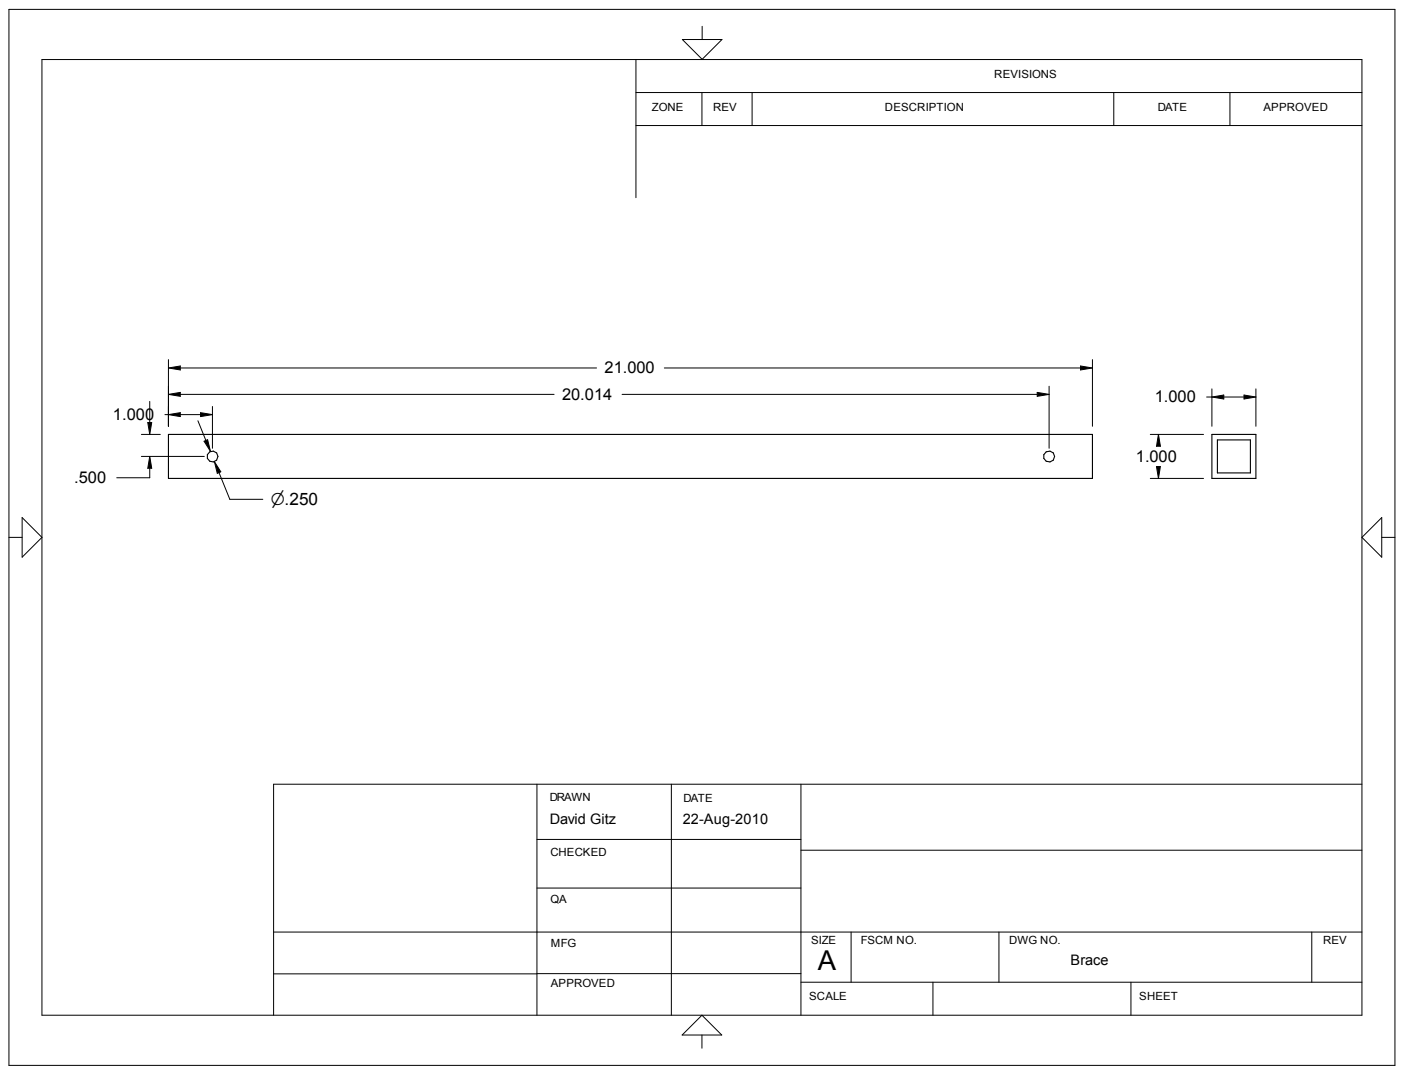
[picture p229: page 5]
REV; DESCRIPTION; ZONE; DATE; APPROVED

DRAWN David Gitz | DATE 22-Aug-2010

CHECKED

MFG | | SIZE A | FSCM NO. | DWG NO. Brace | REV

APPROVED

SCALE | SHEET

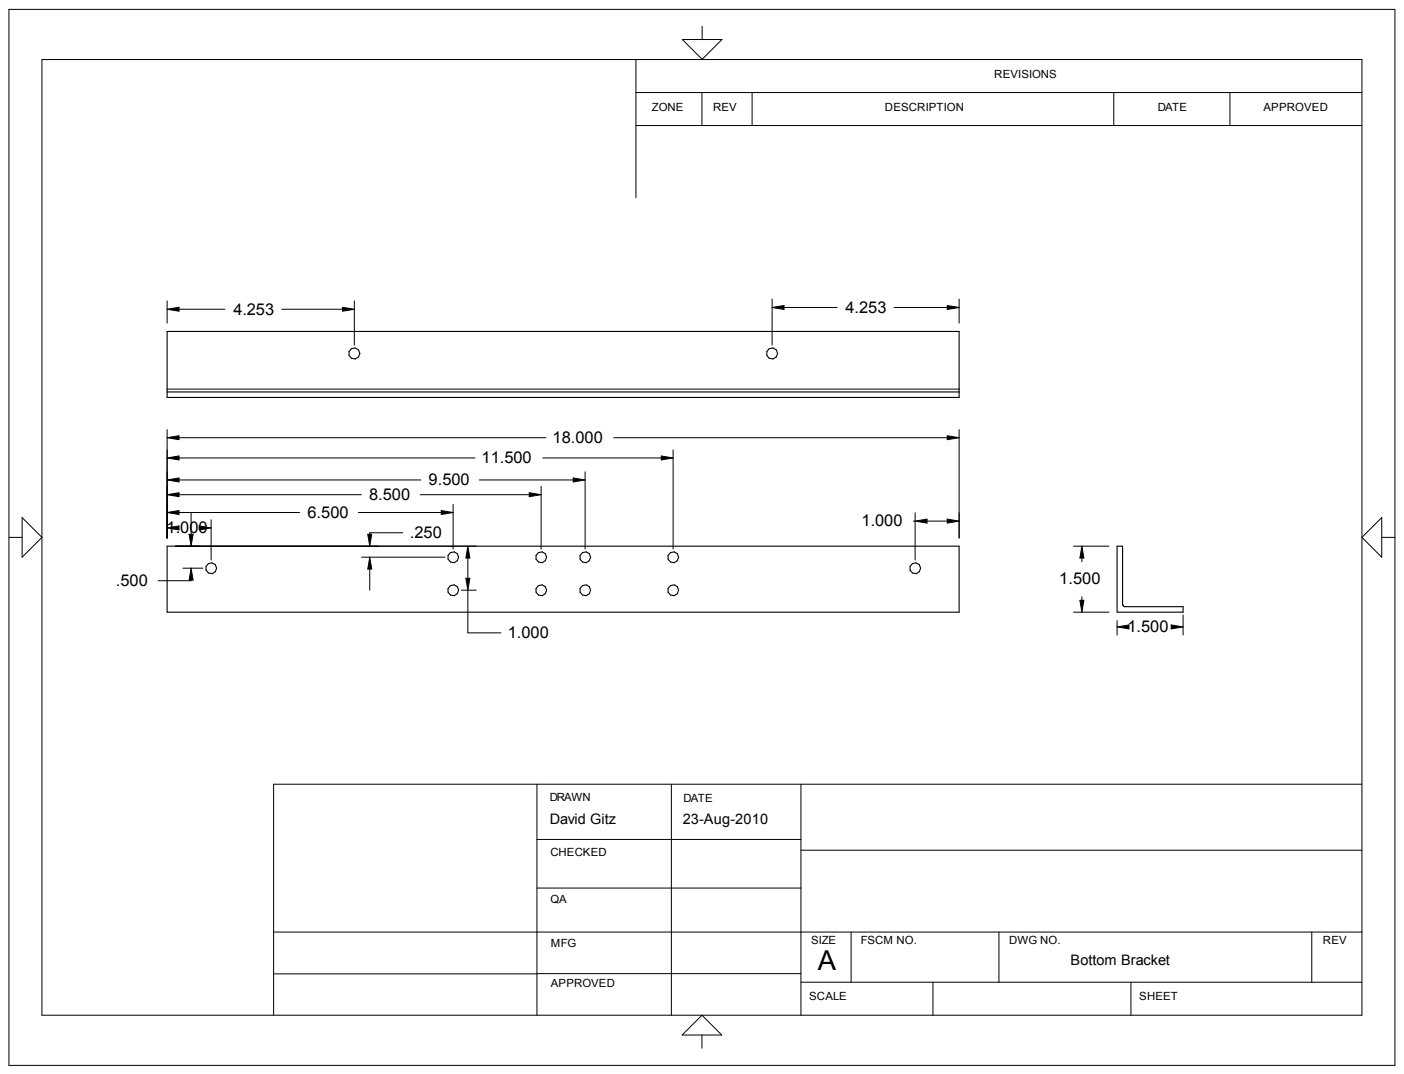
[picture p230: page 6]
REV; DATE; DESCRIPTION; ZONE; APPROVED

DRAWN David Gitz | DATE 23-Aug-2010

CHECKED

MFG | | SIZE A | FSCM NO. | DWG NO. Bottom Bracket | REV

APPROVED

SCALE | SHEET
