mwelling/robot-chopper/TestStand/Design/Drawings/Hinge Assembly.pdf

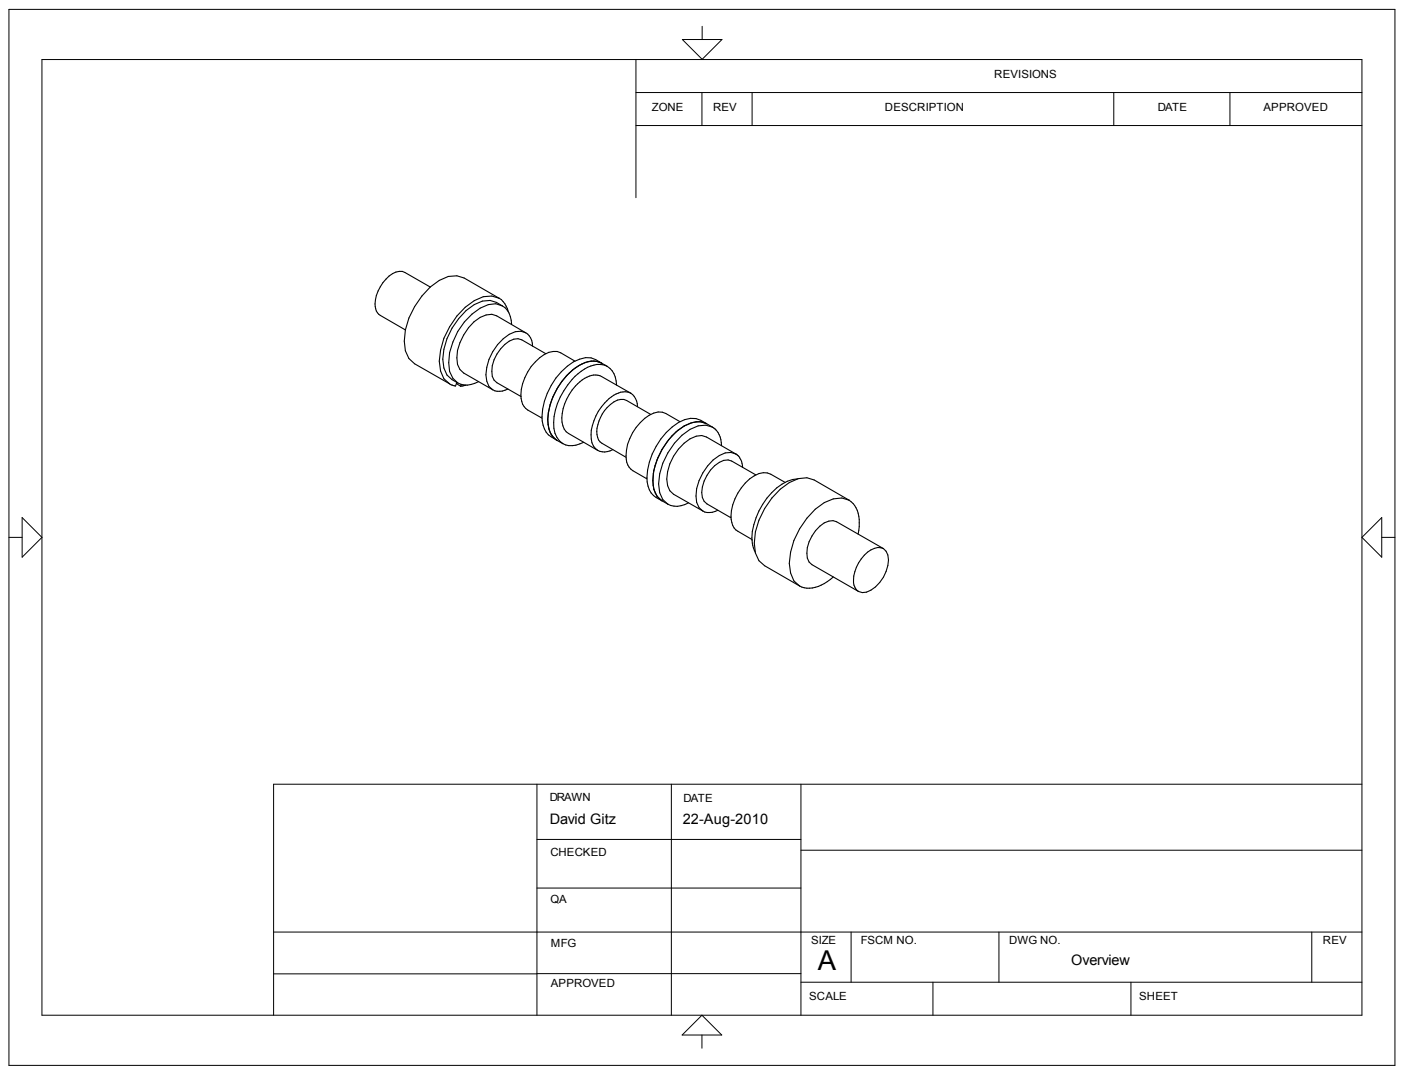
[picture p231: page 1]

REVISIONS

ZONE | REV | DESCRIPTION | DATE | APPROVED

DRAWN David Gitz | DATE 22-Aug-2010

CHECKED

QA
MFG | | SIZE A | FSCM NO. | DWG NO. Overview | REV

APPROVED

SCALE | SHEET

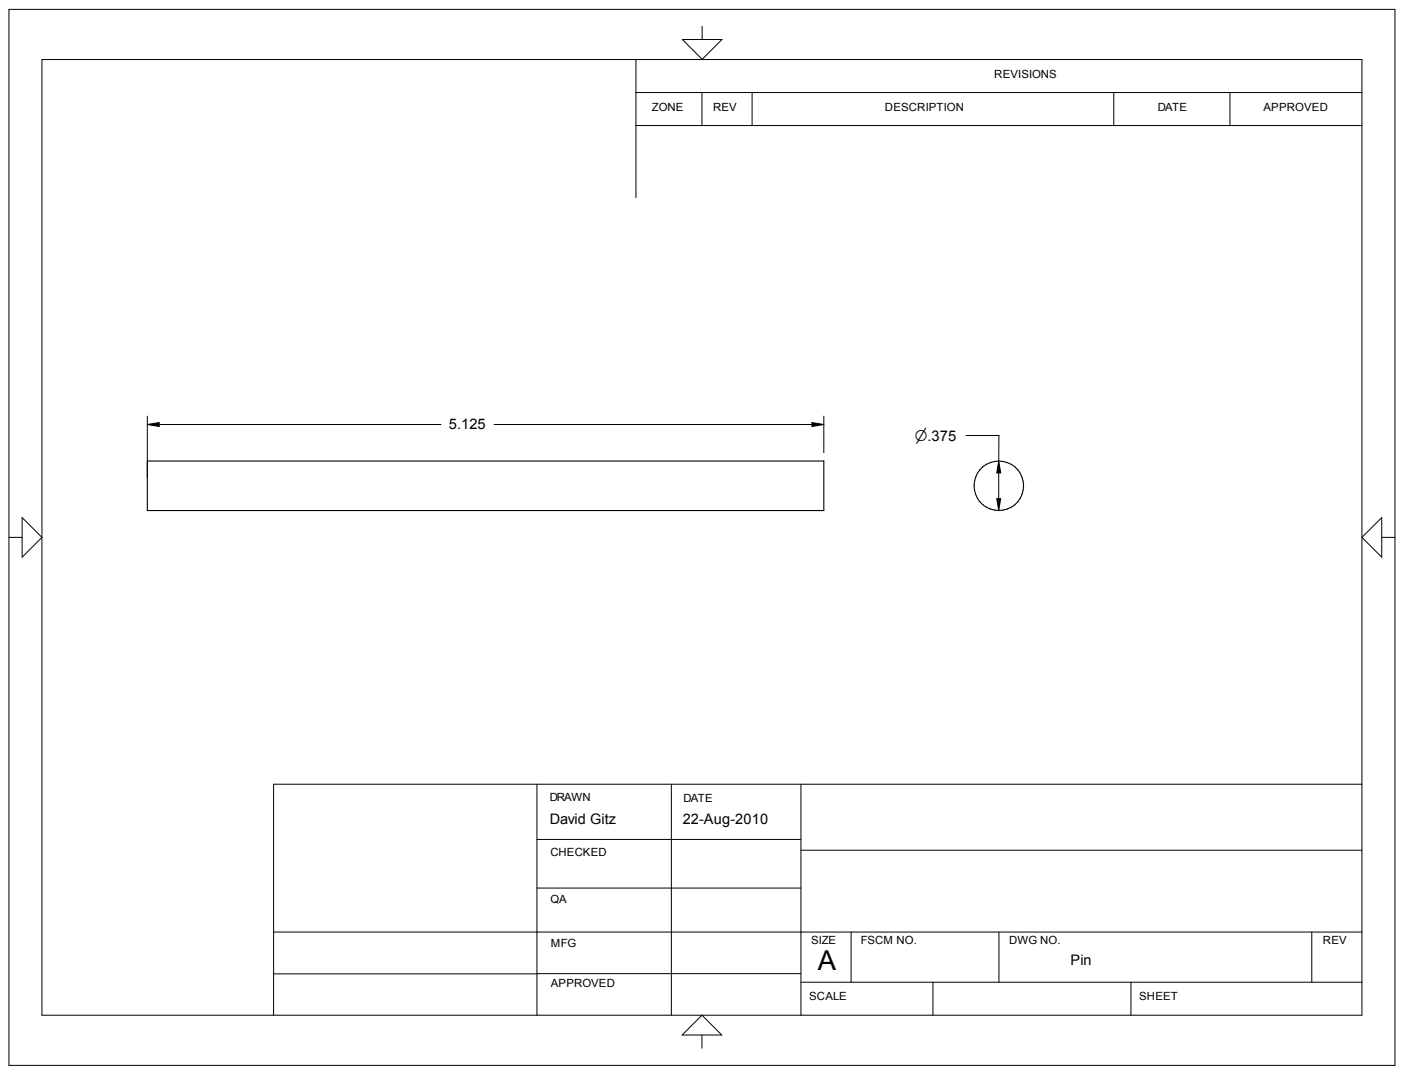
[picture p232: page 2]

REVISIONS

ZONE | REV | DESCRIPTION | DATE | APPROVED

DRAWN David Gitz | DATE 22-Aug-2010

CHECKED

MFG | | SIZE A | FSCM NO. | DWG NO. Pin | REV

APPROVED

SCALE | SHEET
