mwelling/robot-chopper/Documentation/CommDiagram.pdf

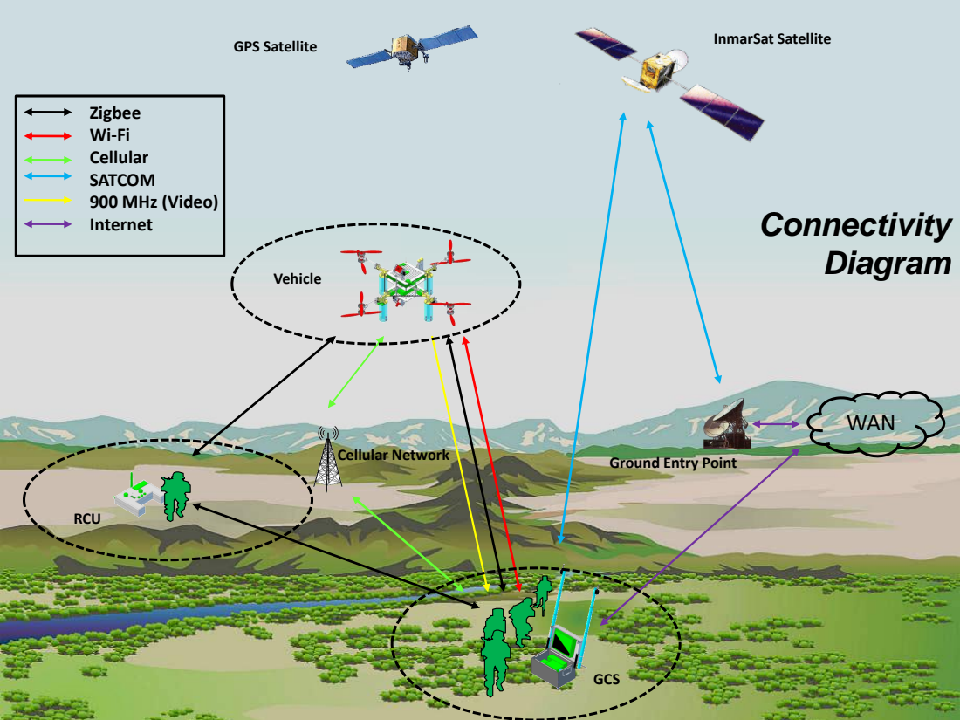
[picture p233: page 1]
GCS; RCU; Vehicle; Cellular Network; GPS Satellite; Zigbee Wi-Fi Cellular SATCOM 900 MHz (Video) Internet; InmarSat Satellite; WAN; Connectivity Diagram

Ground Entry Point

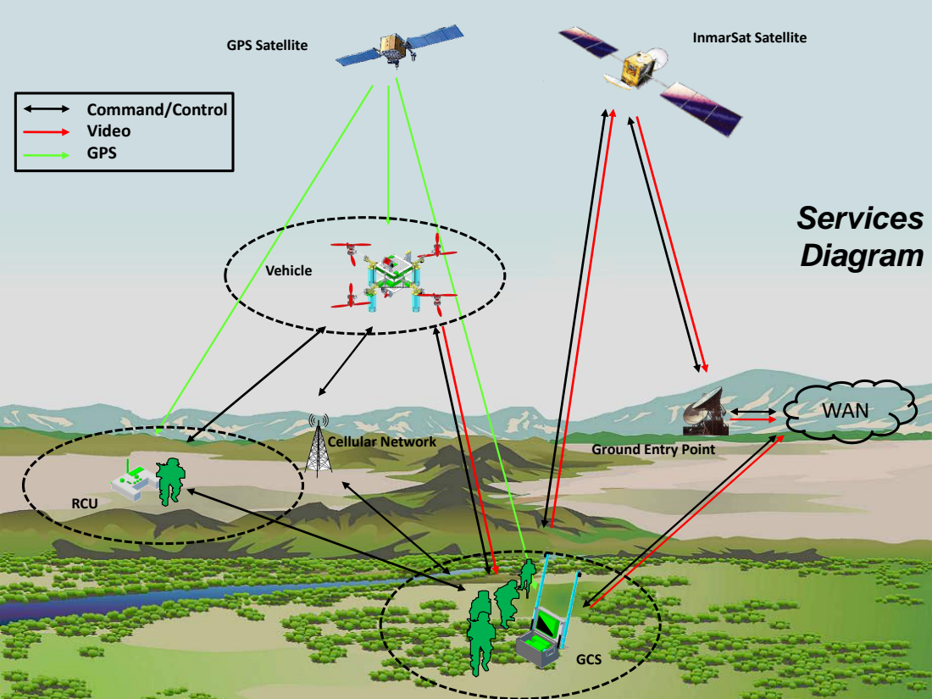
[picture p234: page 2]
GCS; RCU; Vehicle; Cellular Network; GPS Satellite; Command/Control Video GPS; InmarSat Satellite; WAN; Services Diagram

Ground Entry Point
