mwelling/robot-chopper/Documentation/SerialDeconflict.pdf

Primary = 0
Secondary = 1

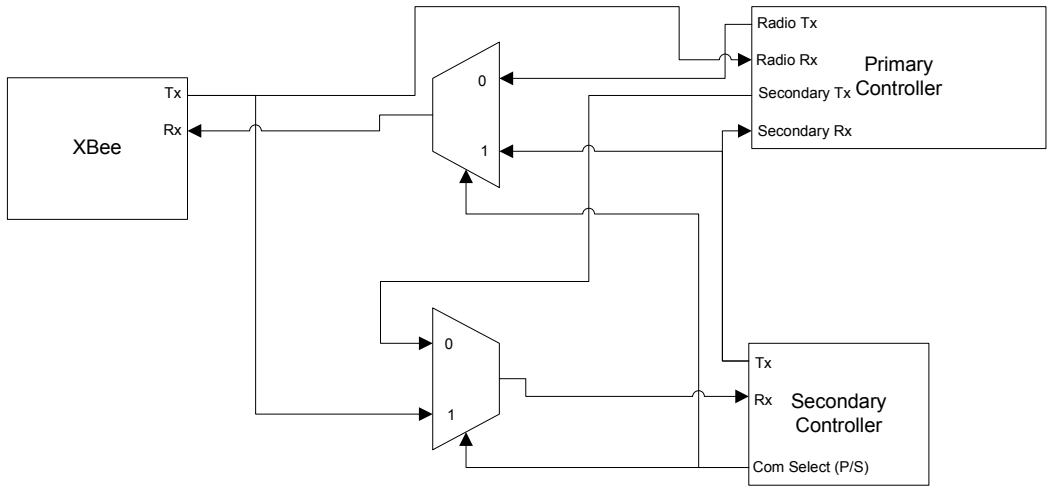
[picture p235: figure]
Primary Controller; Secondary Controller; XBee; Radio Tx; Radio Rx; Secondary Tx; Secondary Rx; Com Select (P/S)

## W/ Primary Removed

## W/ Primary Installed

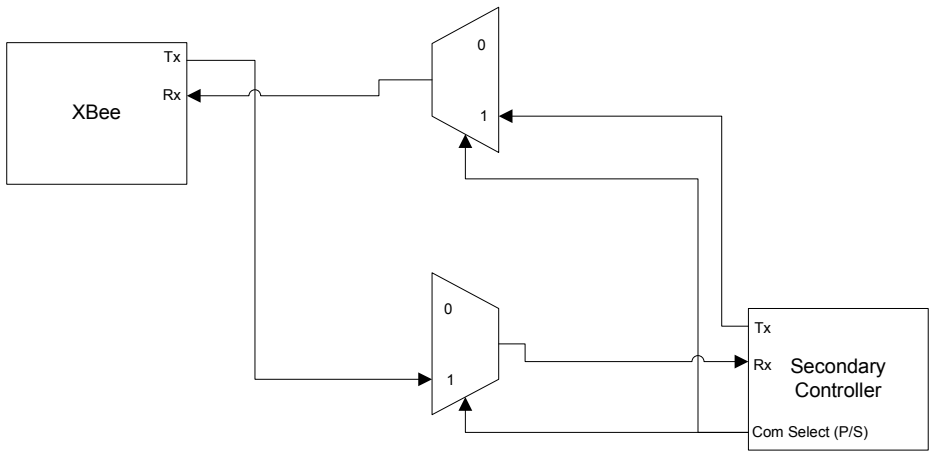
[picture p236: figure]
Secondary Controller; XBee; Com Select (P/S)
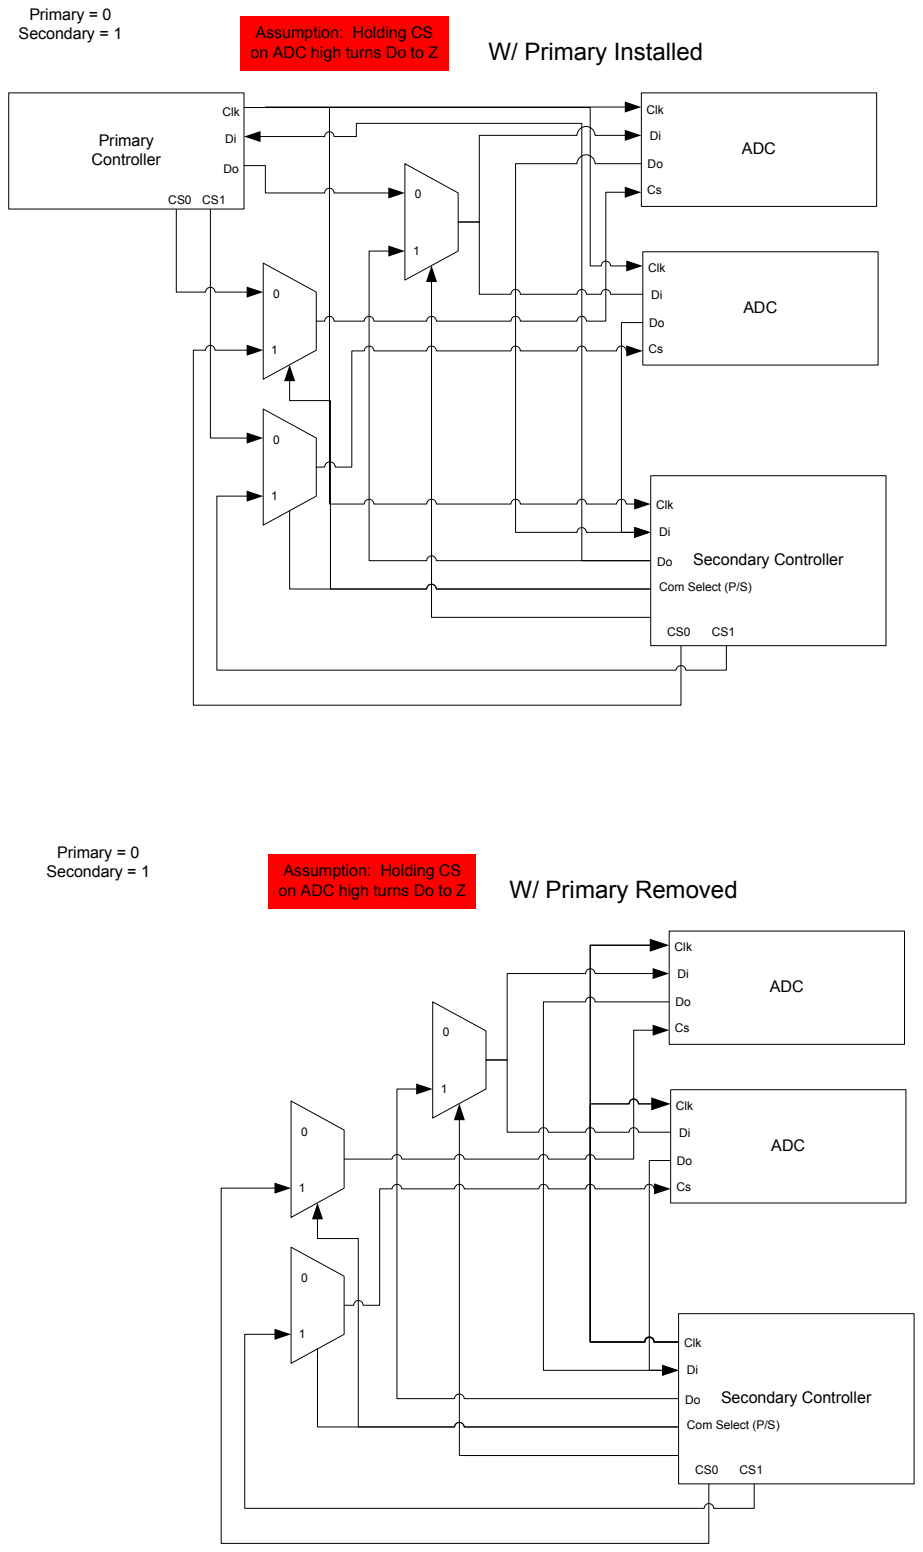
[picture p237: page 2]
Primary = 0 Secondary = 1; ADC; Clk; Primary Controller; Secondary Controller; Com Select (P/S); on ADC high turns Do to Z; W/ Primary Installed; W/ Primary Removed

Assumption: Holding CS
