mwelling/robot-chopper/Vehicle/Documentation/MainBoardDimensional.pdf

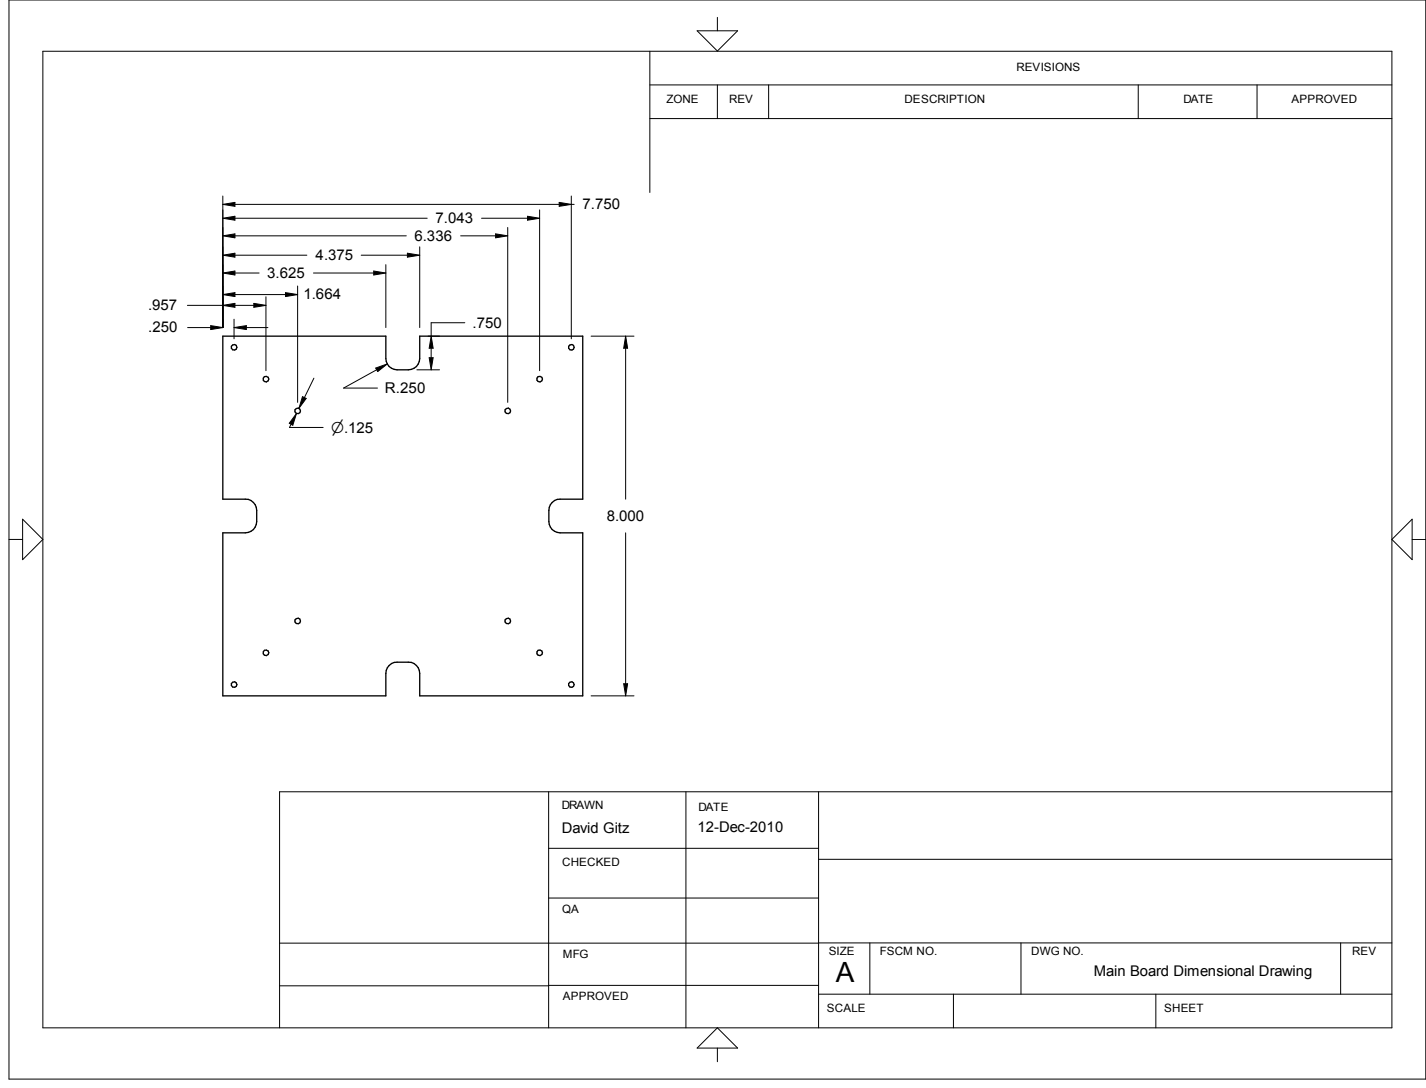
[picture p238: page 1]

REVISIONS

ZONE | REV | DESCRIPTION | DATE | APPROVED

DRAWN David Gitz | DATE 12-Dec-2010

CHECKED

MFG | | SIZE A | FSCM NO. | DWG NO. Main Board Dimensional Drawing | REV

APPROVED

SCALE | SHEET
