mwelling/robot-chopper/Engineering/Communications/icarus com v2.pdf

### ICARUS Communications Library v2

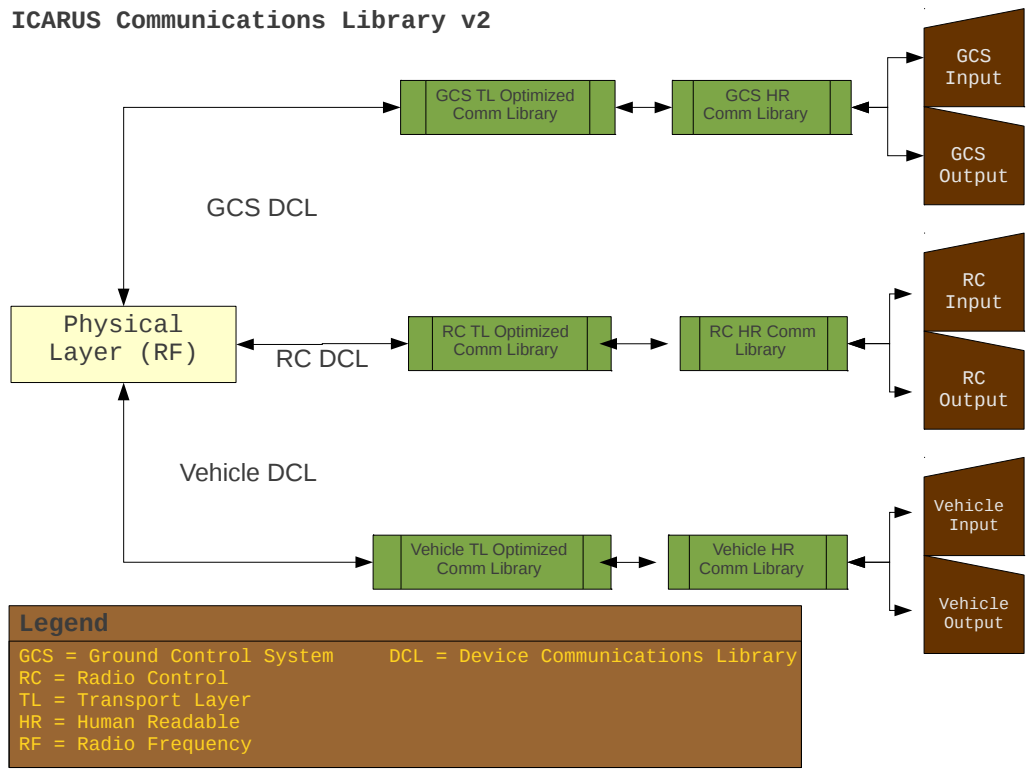
[picture p239: page 1]
RC Input; RC Output; Vehicle Input; Vehicle Output; GCS Input; GCS Output; Physical Layer (RF); Vehicle HR Comm Library; GCS HR Comm Library; GCS DCL; RC DCL; Vehicle DCL

GCS TL Optimized
Comm Library

RC TL Optimized

RC HR Comm
Library

Vehicle TL Optimized

Legend
GCS = Ground Control System
RC = Radio Control
TL = Transport Layer
HR = Human Readable
RF = Radio Frequency

DCL = Device Communications Library
