mwelling/robot-chopper/Vehicle/Schematics/Schematic.pdf

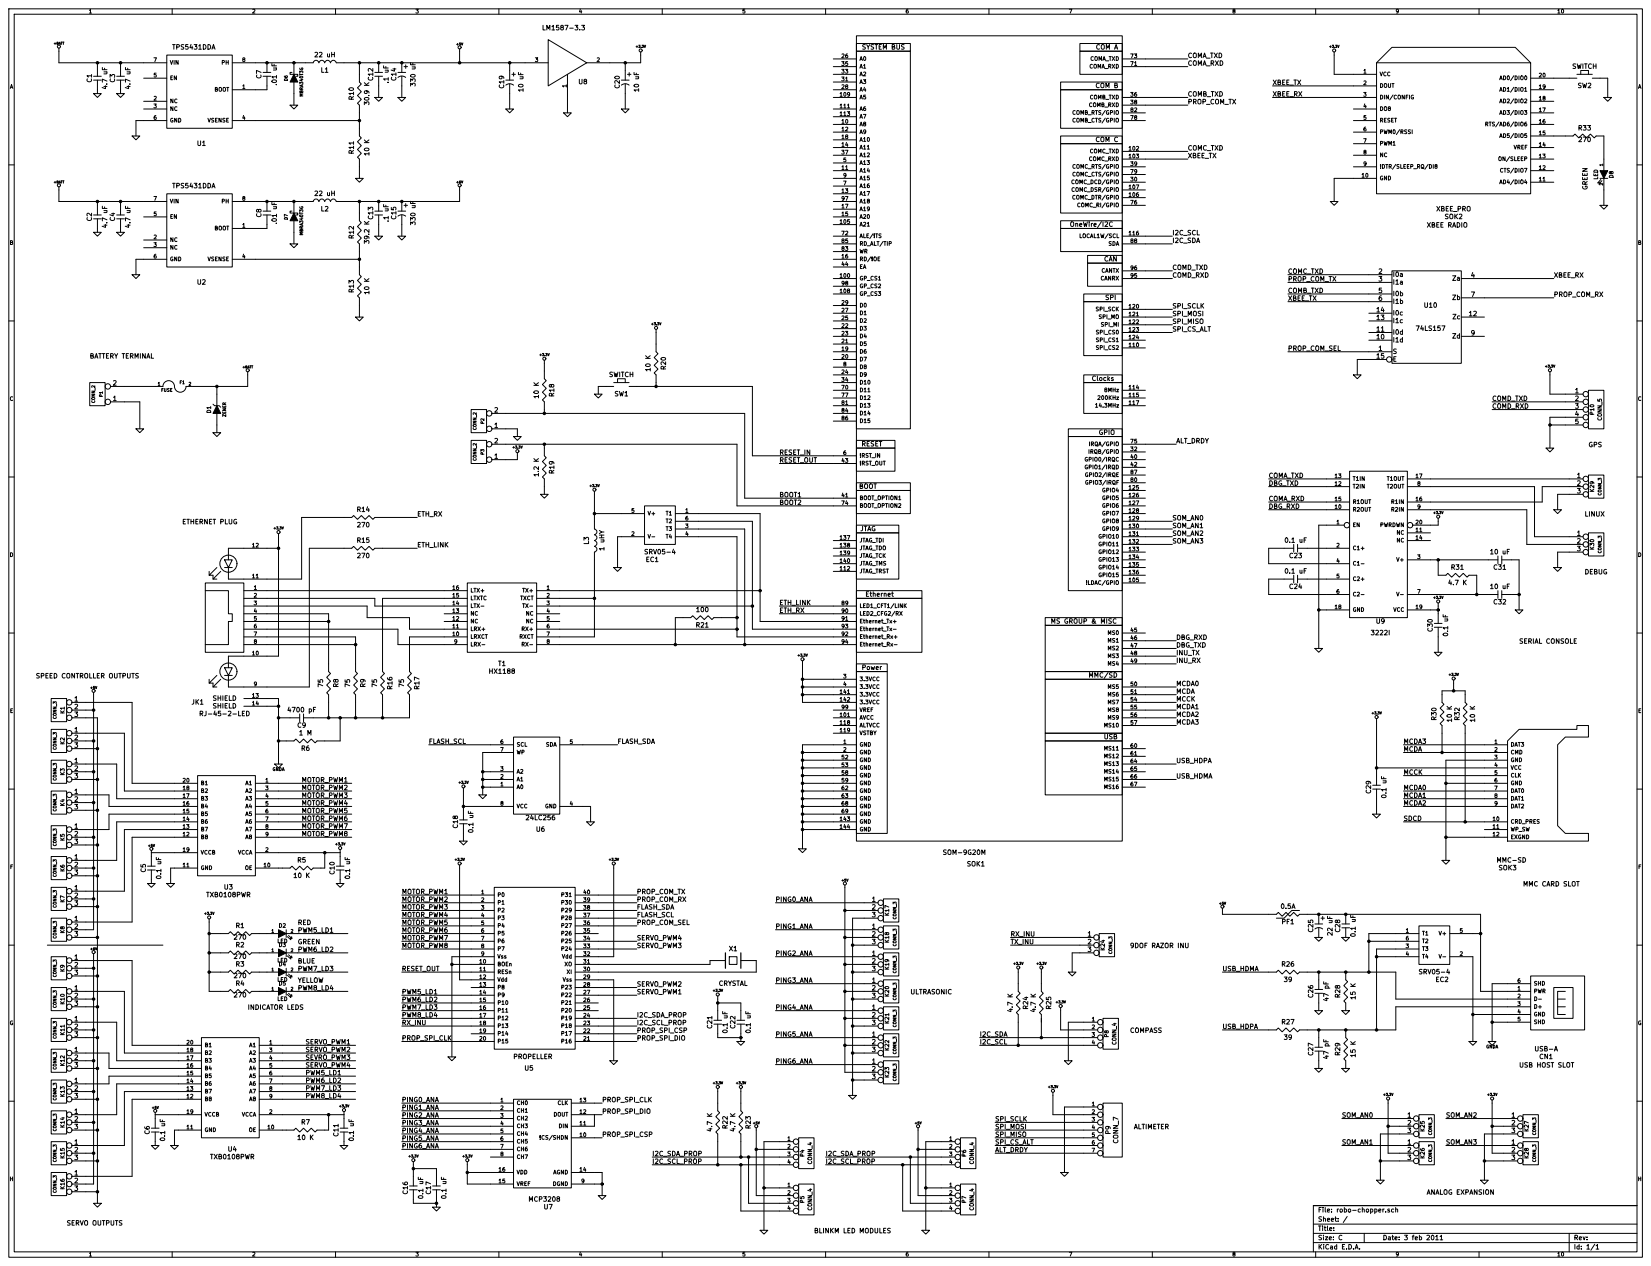
[picture p240: page 1]
