mwelling/robot-chopper/Media/Vehicle/VehicleAssySchematic.pdf

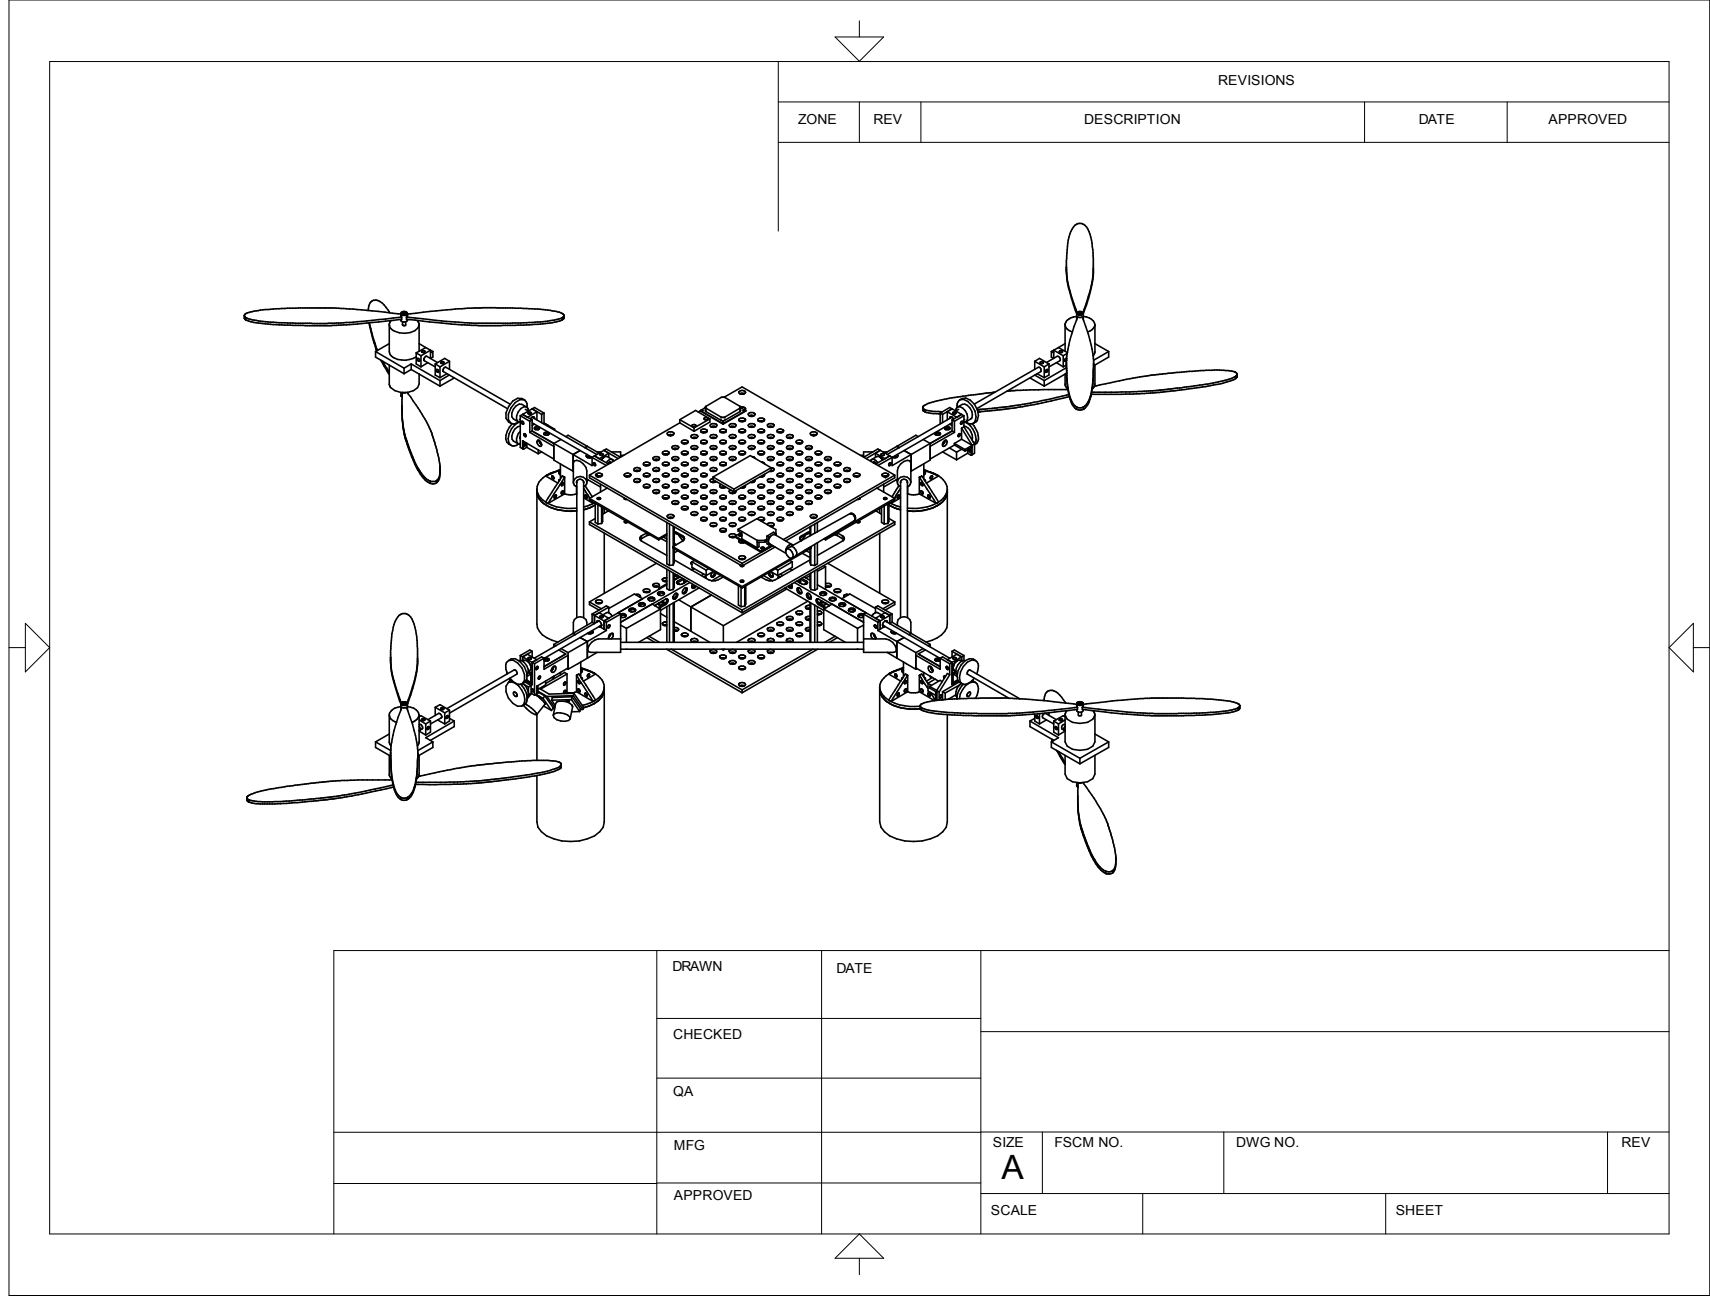
[picture p241: page 1]
FSCM NO.; DWG NO.; DATE; APPROVED; SIZE; CHECKED; REV; ZONE; MFG; SCALE; DRAWN; REVISIONS; SHEET; DESCRIPTION

47.508
35.408

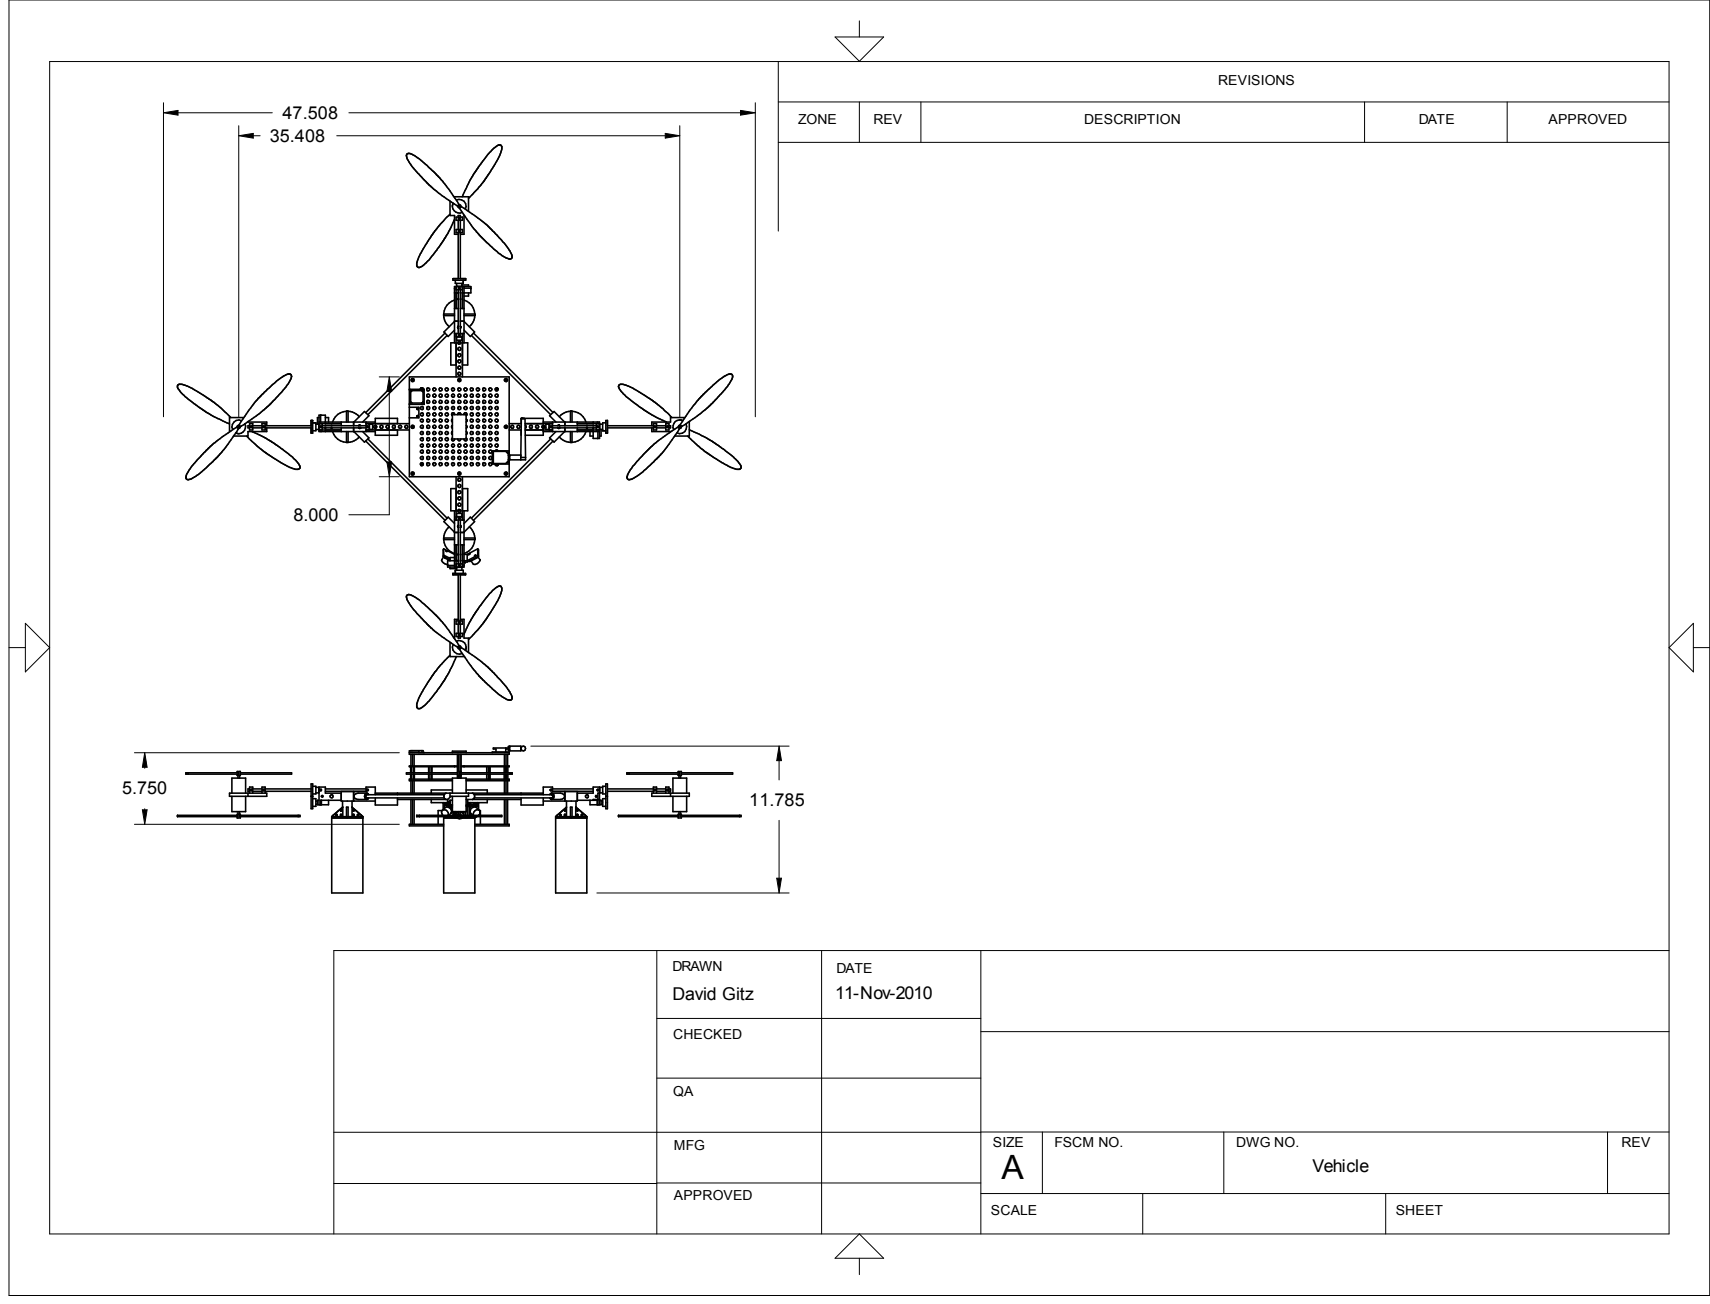
[picture p242: page 2]
Vehicle; SIZE; DRAWN; MFG; 11-Nov-2010; APPROVED; REV; DATE; David Gitz; FSCM NO.; REVISIONS; DWG NO.; ZONE; SCALE; CHECKED; DESCRIPTION; SHEET
