mwelling/robot-chopper/Documentation/Design Report Appendix/Test Stand ElectricalSchematic.pdf

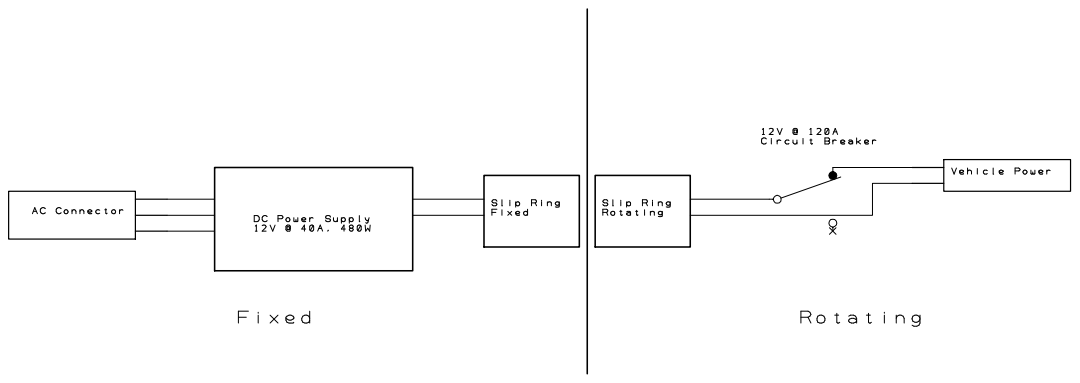
[picture p243: page 1]
