mwelling/robot-chopper/Documentation/Design Report Appendix/RCU Electrical Schematics/RCU PCB Design Large.pdf

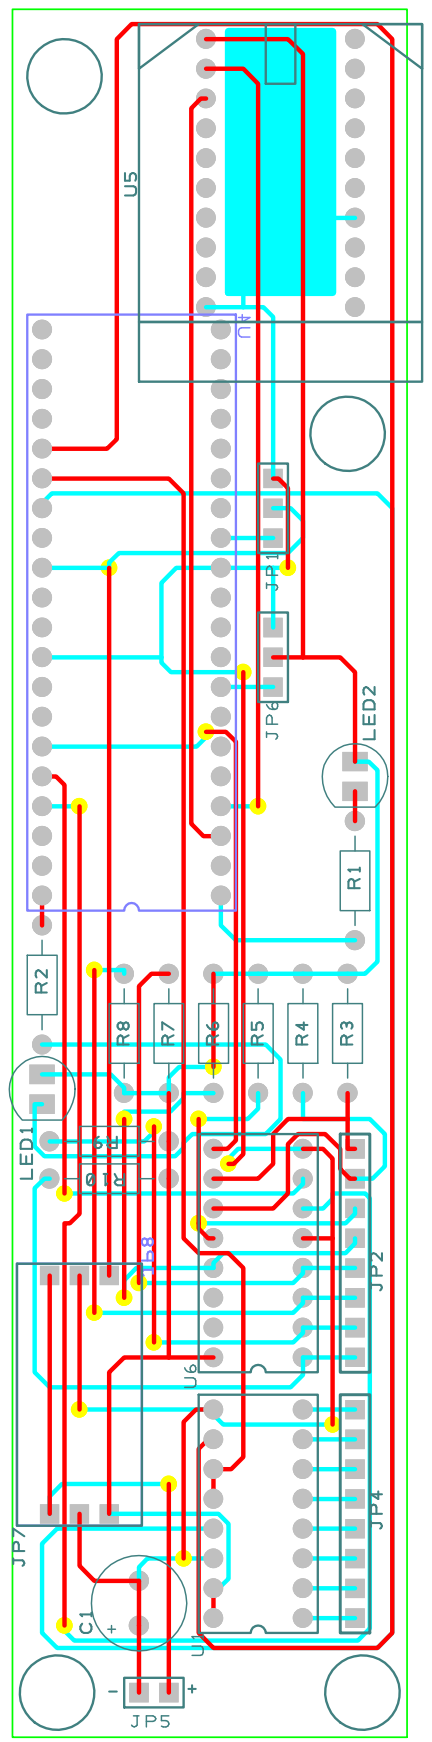
[picture p244: page 1]
