mwelling/robot-chopper/Documentation/Design Report Appendix/RCU Electrical Schematics/RCU Schematic Design.pdf

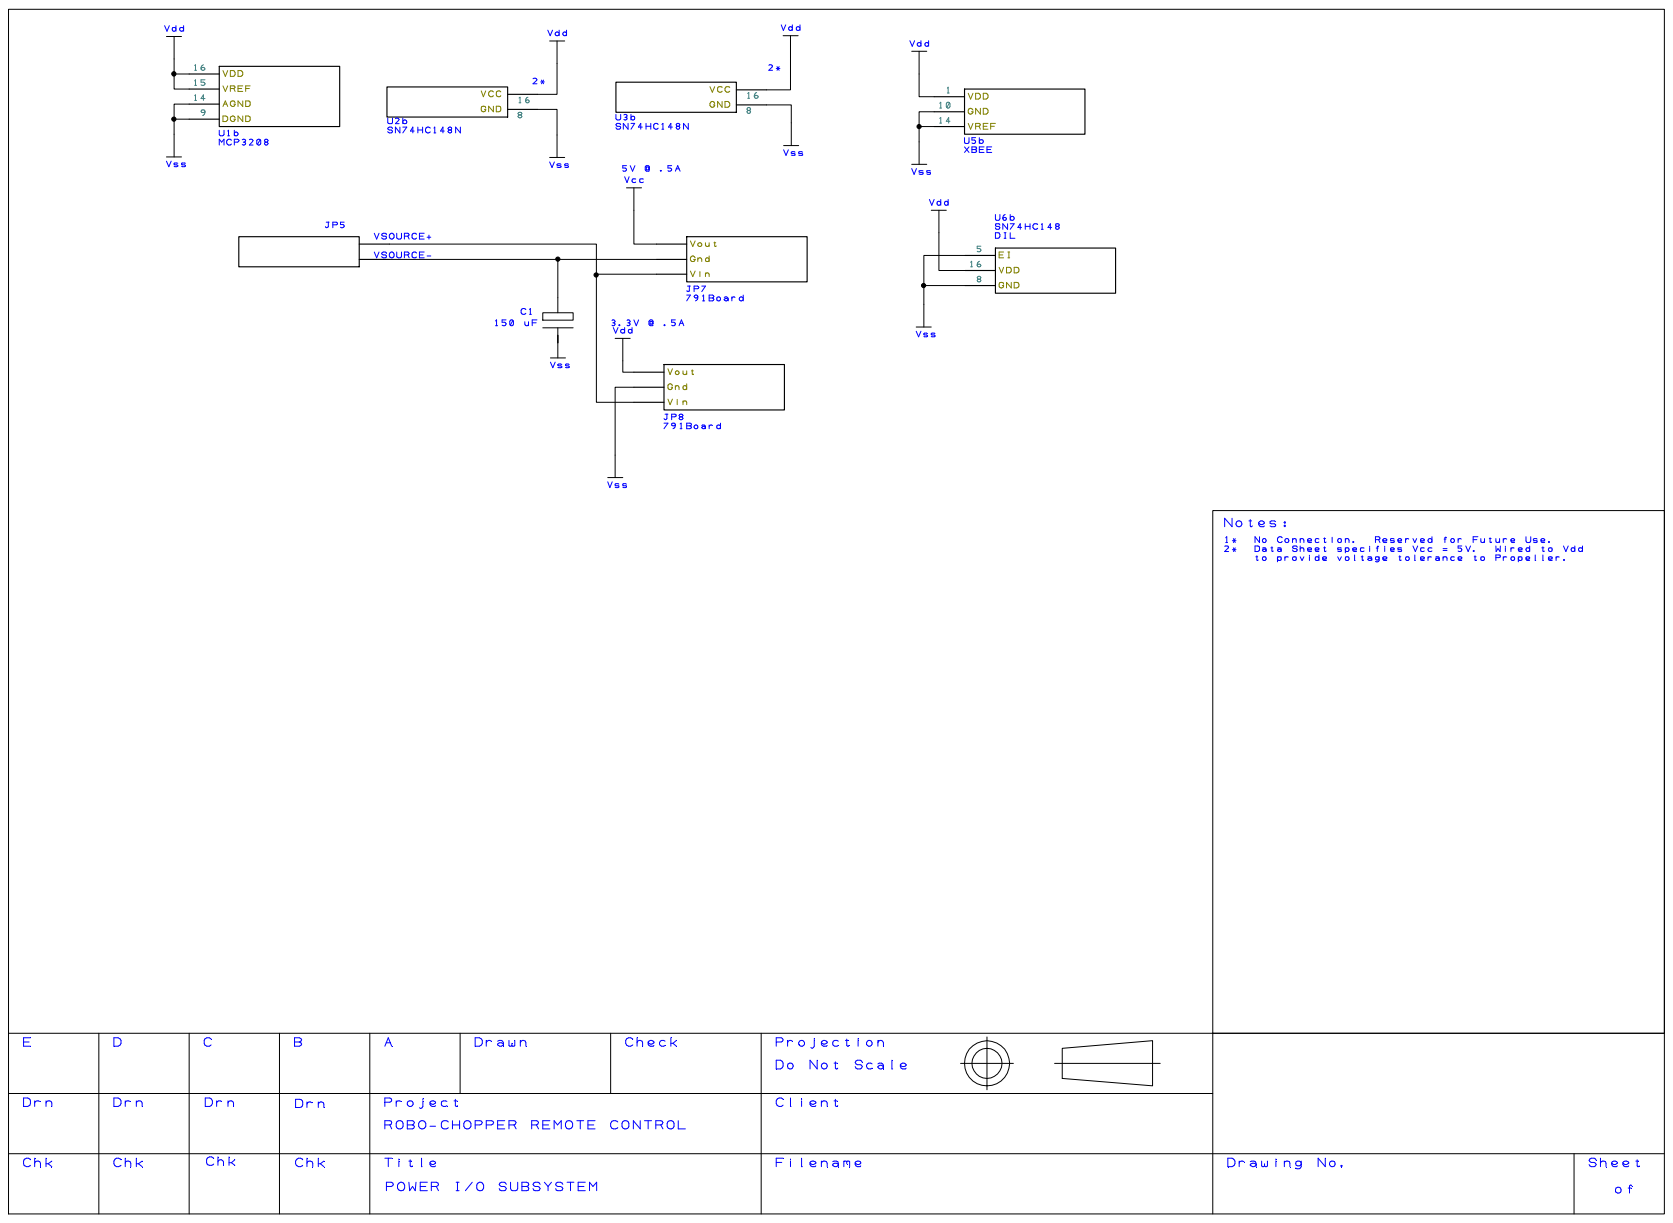
[picture p245: page 1]

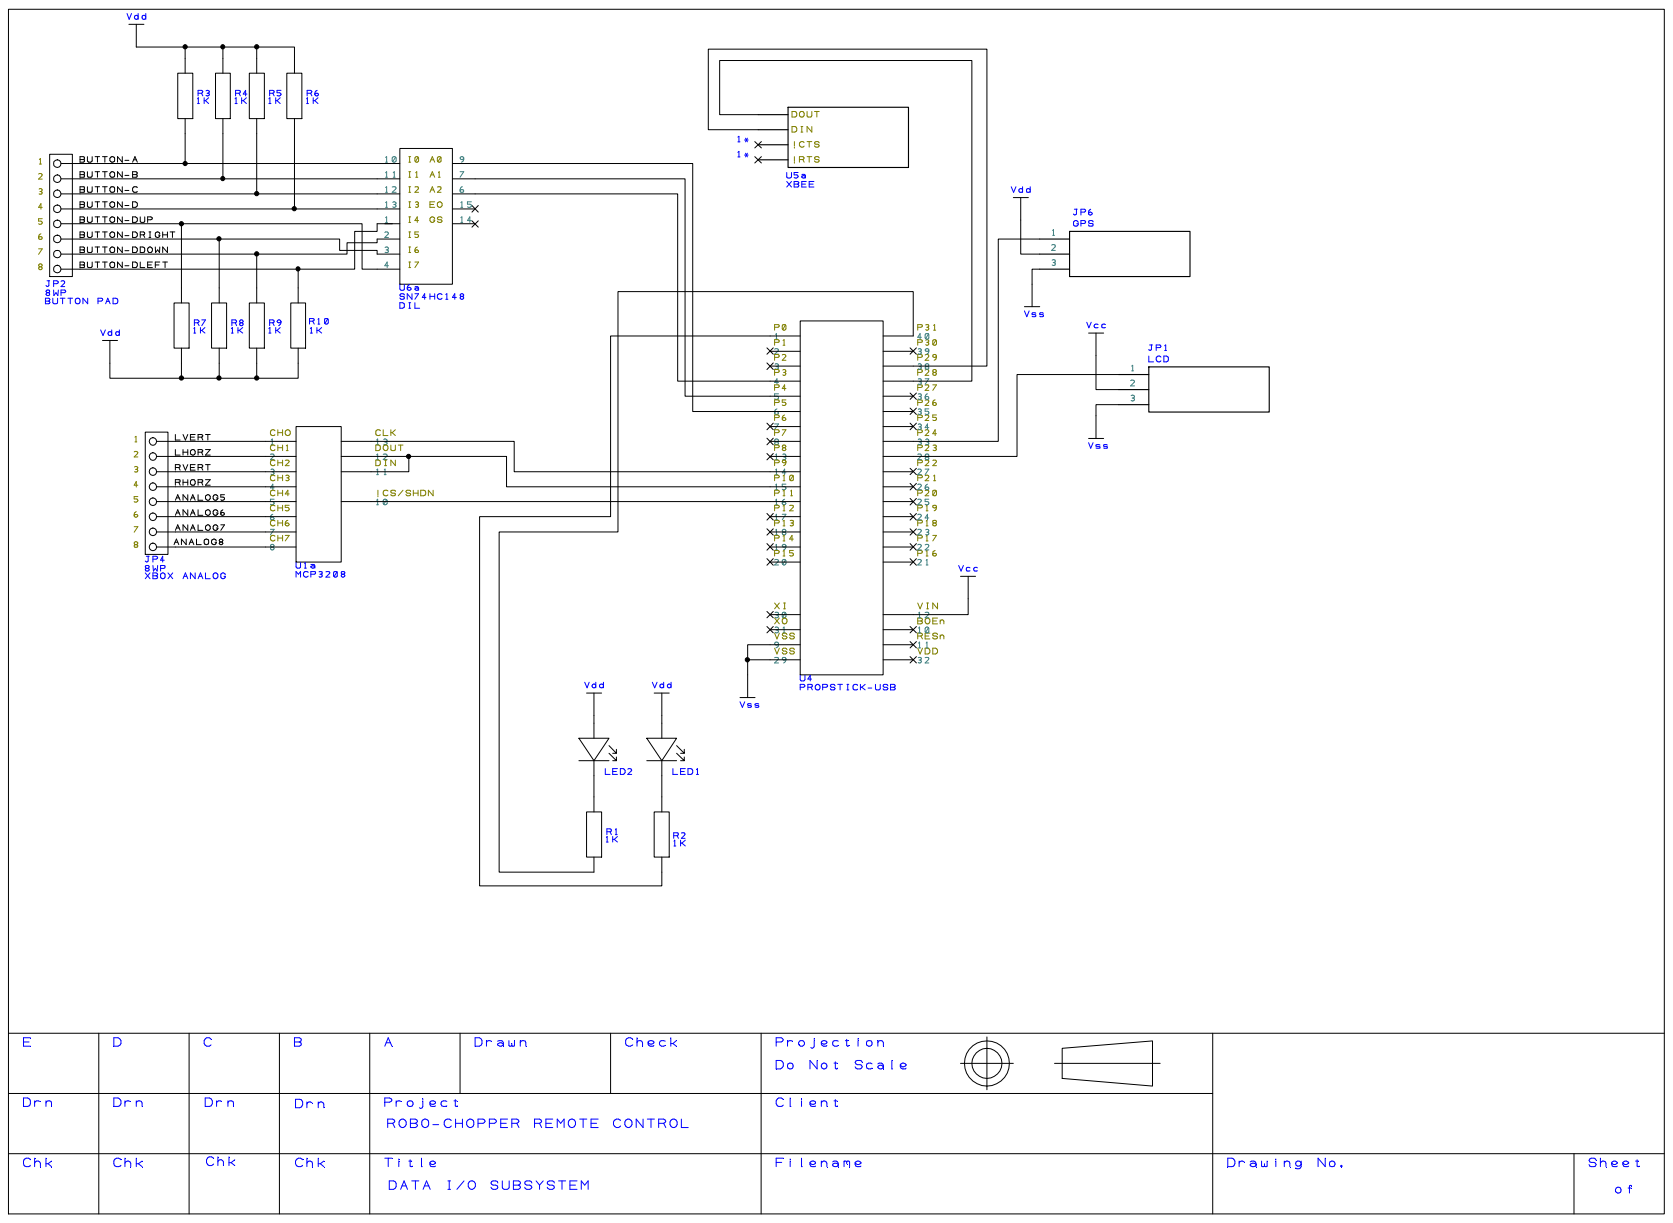
[picture p246: page 2]
