mwelling/robot-chopper/Documentation/Design Report Appendix/Test Stand Design Drawings/Shock Absorber.pdf

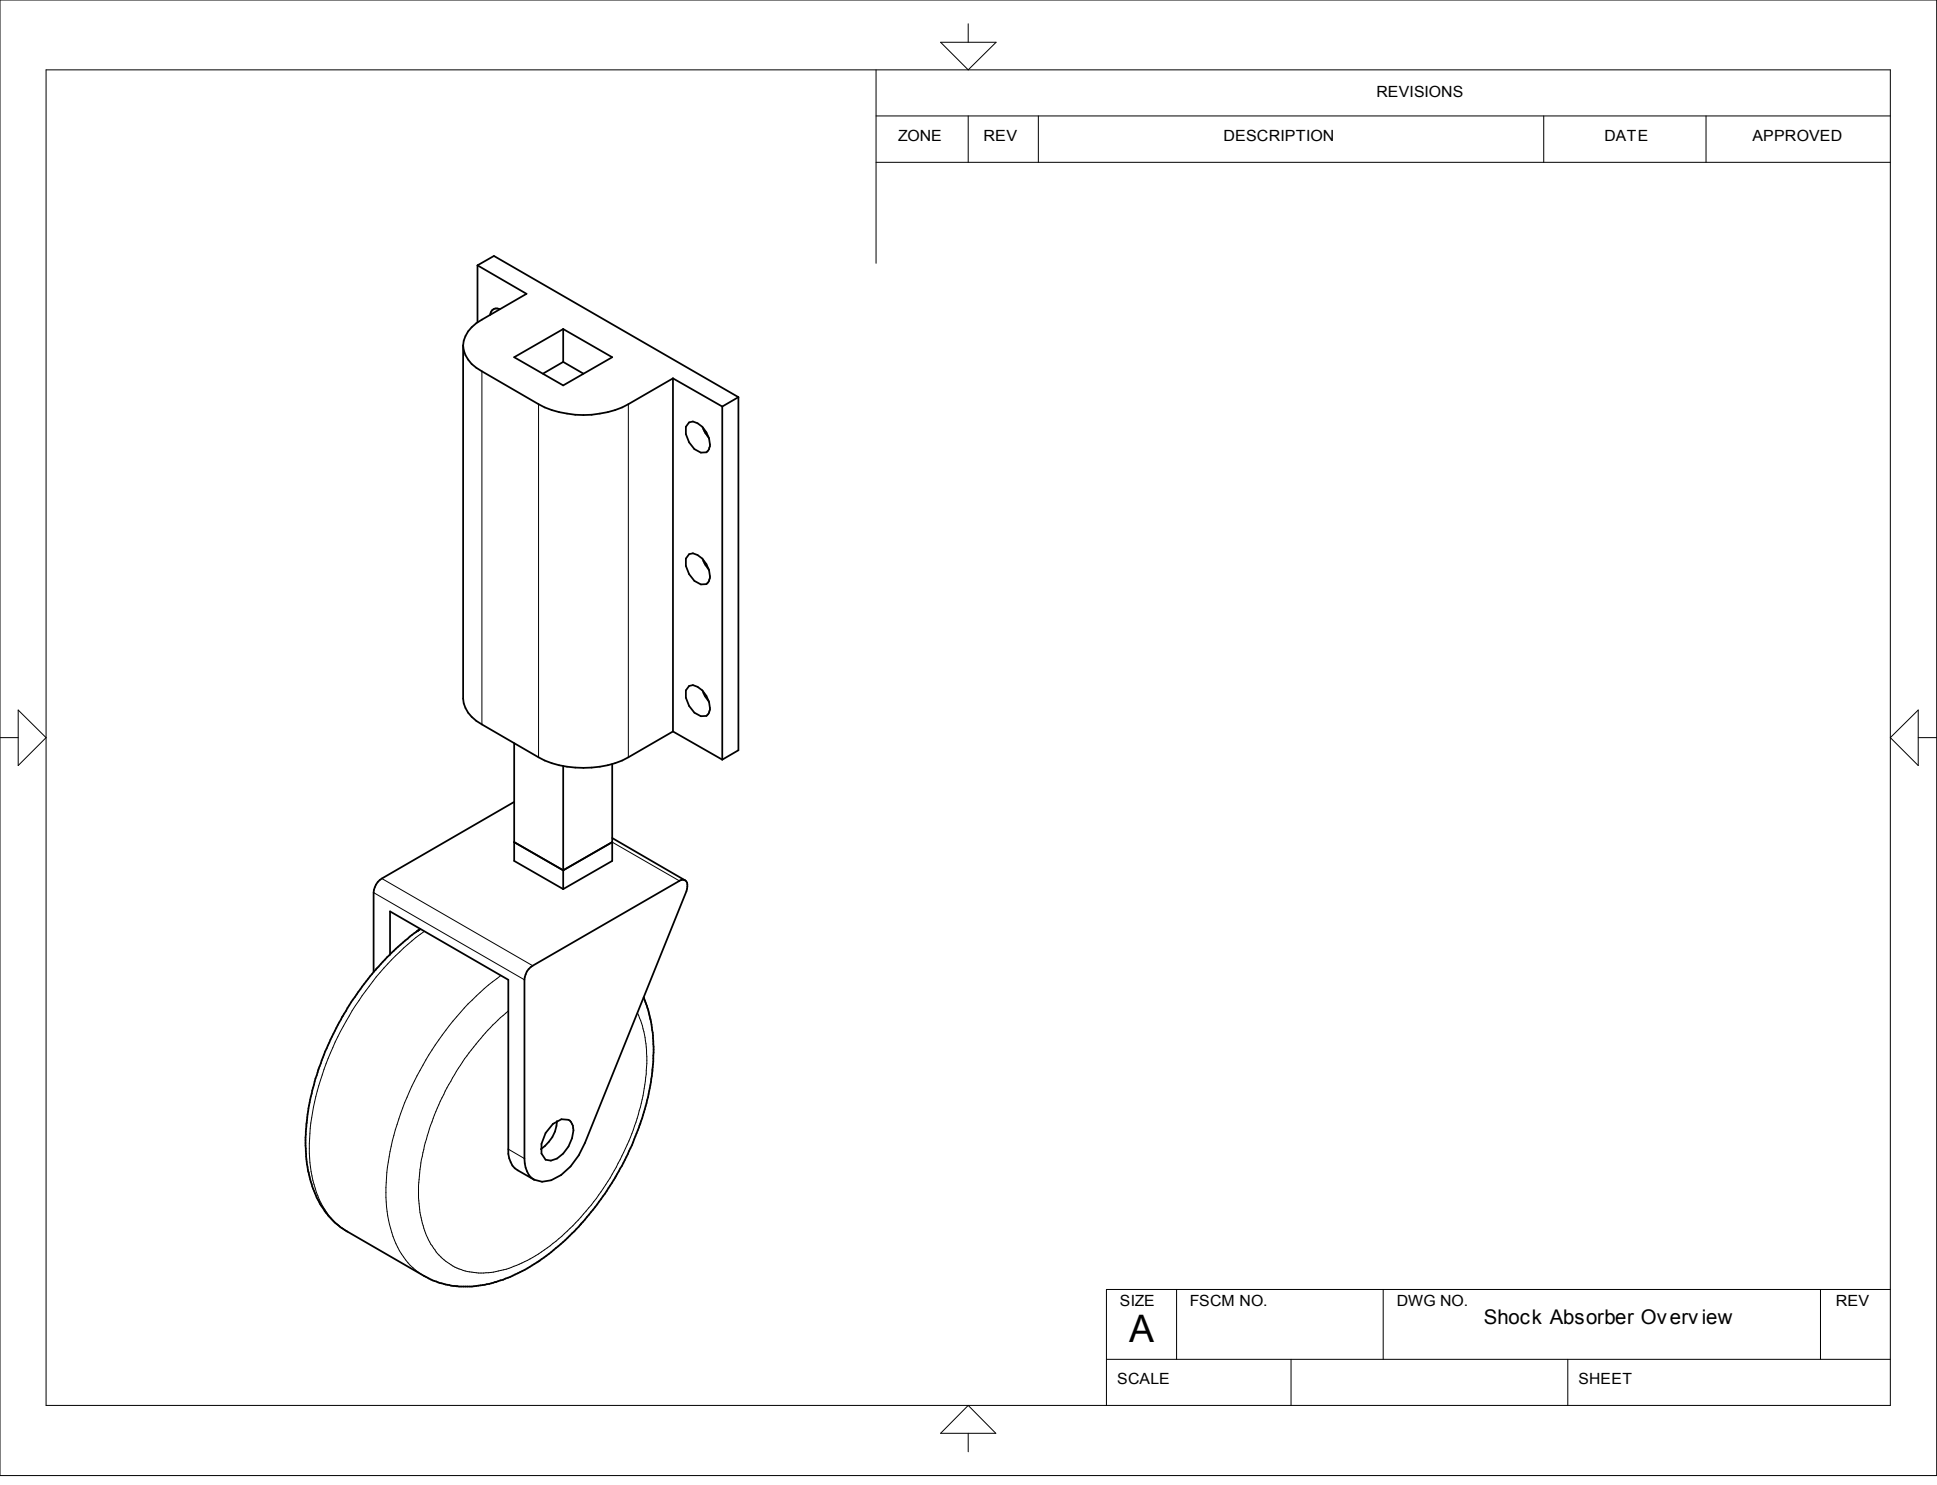
[picture p247: page 1]

REVISIONS

ZONE | REV | DESCRIPTION | DATE | APPROVED

SIZE | FSCM NO. | DWG NO. Shock Absorber Ov erv iew A | REV

SCALE | | SHEET

1.875

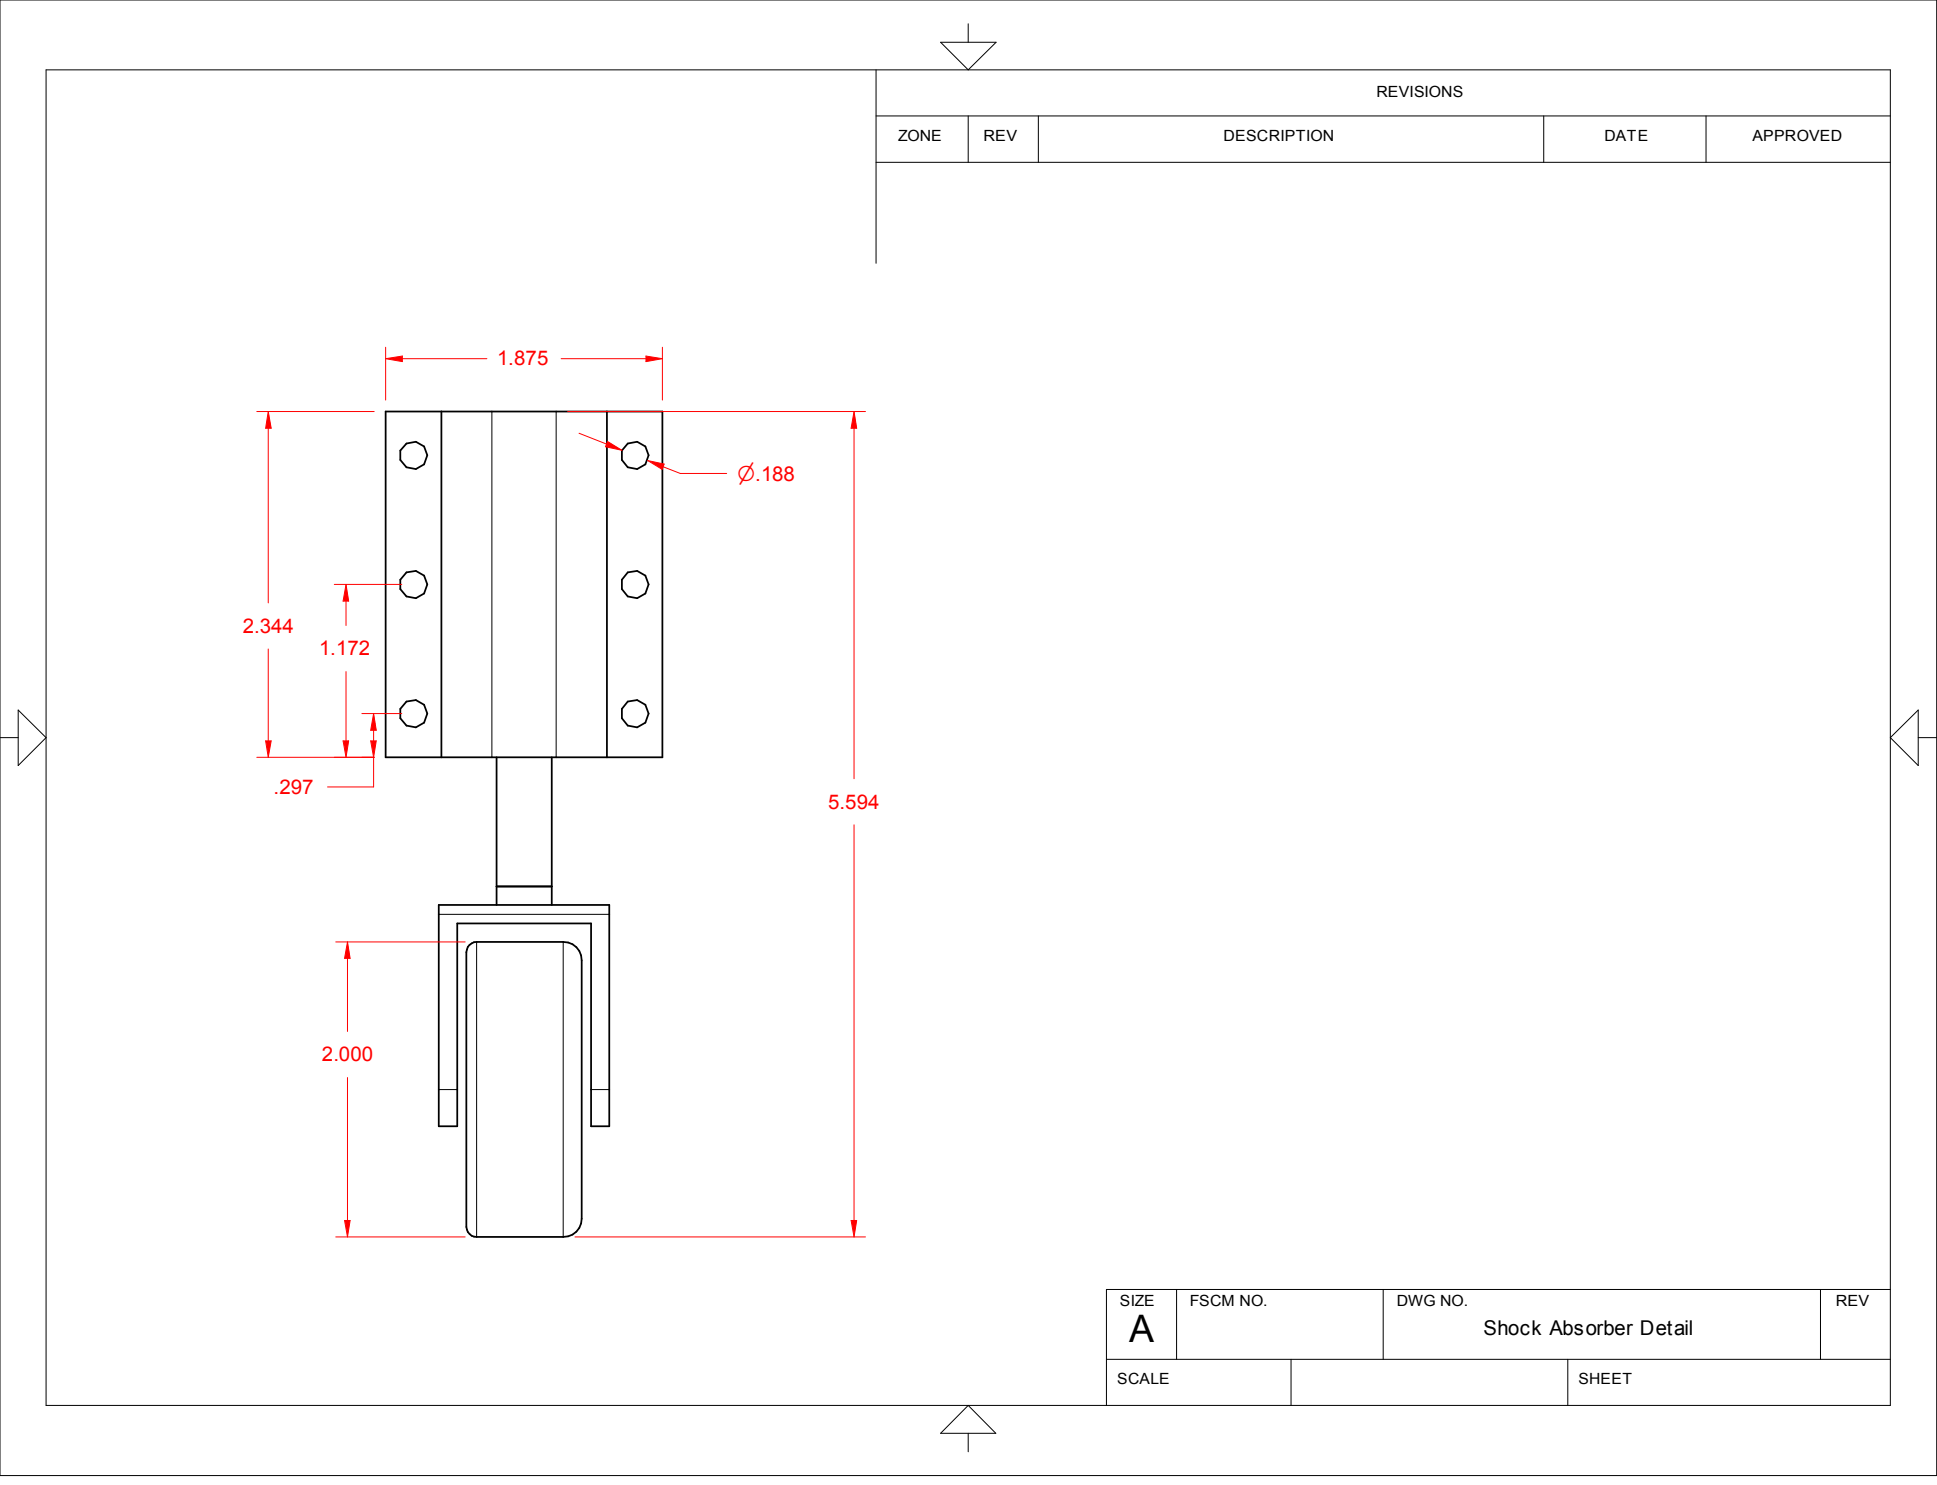
[picture p248: page 2]

REVISIONS

ZONE | REV | DESCRIPTION | DATE | APPROVED

SIZE A | FSCM NO. | DWG NO. Shock Absorber Detail | REV

SCALE | | SHEET
