mwelling/robot-chopper/Media/Vehicle/Version1/VehicleAssySchematic.pdf

3

A | A

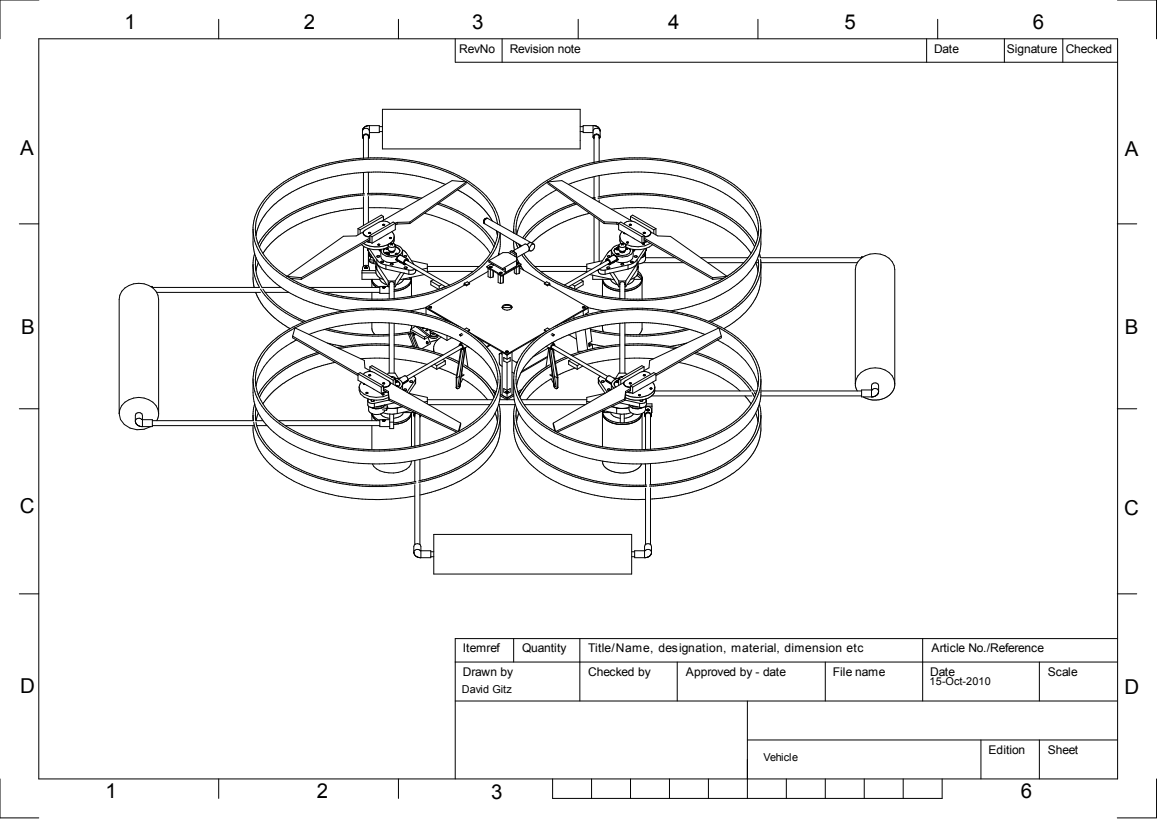
[picture p249: page 1]
Checked by; 15-Oct-2010; Vehicle; Itemref; Revision note; RevNo; Checked; Drawn by; Edition; Signature; Scale; Date; Quantity; David Gitz; File name; Sheet

Title/Name, designation, material, dimension etc

Article No./Reference

Approved by - date

n12.500

34.776

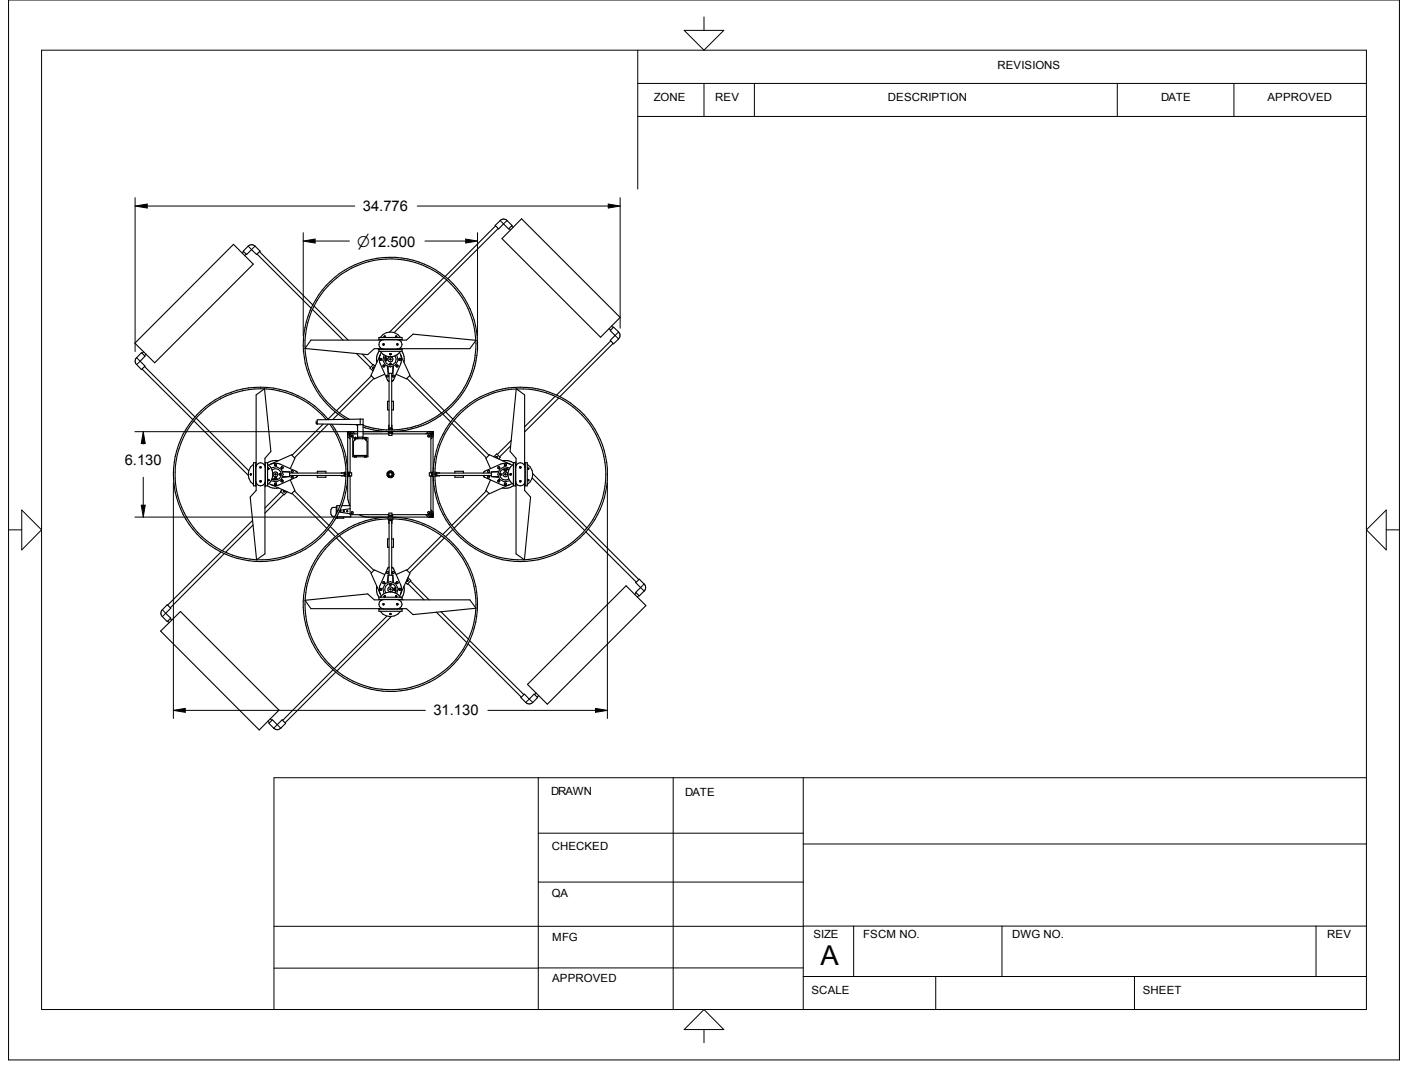
[picture p250: page 2]

REVISIONS

ZONE | REV | DESCRIPTION | DATE | APPROVED

DRAWN | DATE

CHECKED

MFG | | SIZE A | FSCM NO. | DWG NO. | REV

APPROVED

SCALE | SHEET

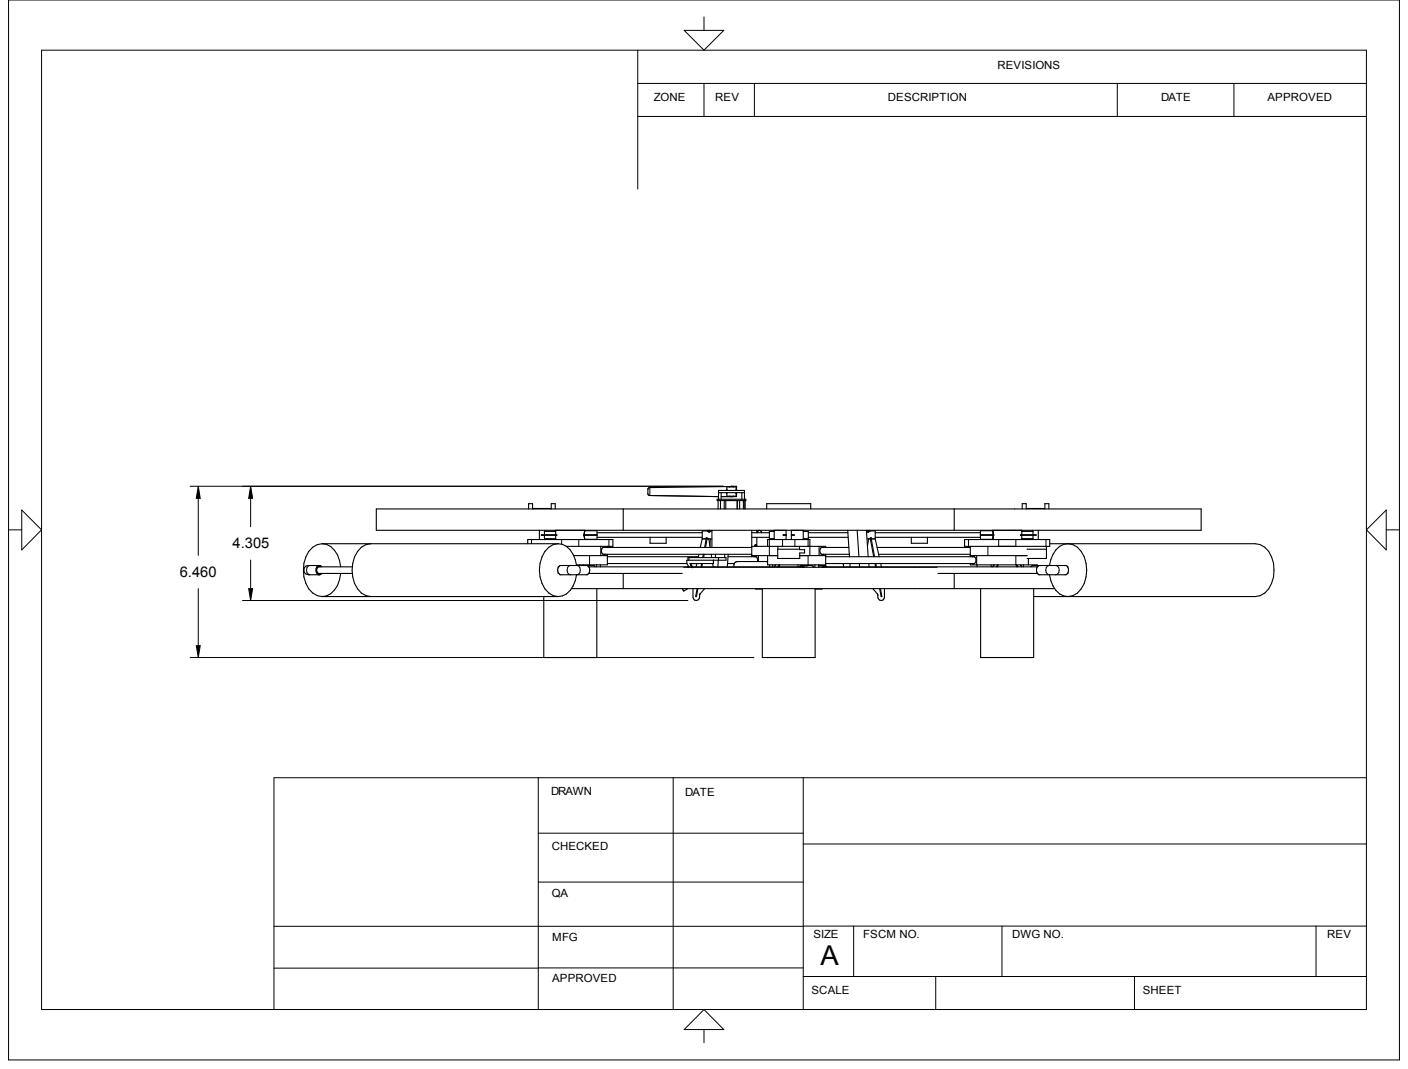
[picture p251: page 3]

REVISIONS

ZONE | REV | DESCRIPTION | DATE | APPROVED

DRAWN | DATE

CHECKED

MFG | | SIZE A | FSCM NO. | DWG NO. | REV

APPROVED

SCALE | SHEET
