mwelling/robot-chopper/RemoteControl/Schematics/PCB Artist/PCB Design.pdf

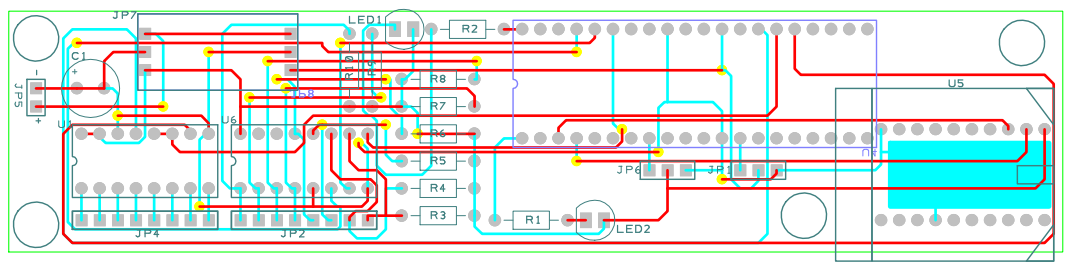
[picture p252: page 1]
