mwelling/robot-chopper/TestStand/Design/Drawings/Force Measurement Assembly.pdf

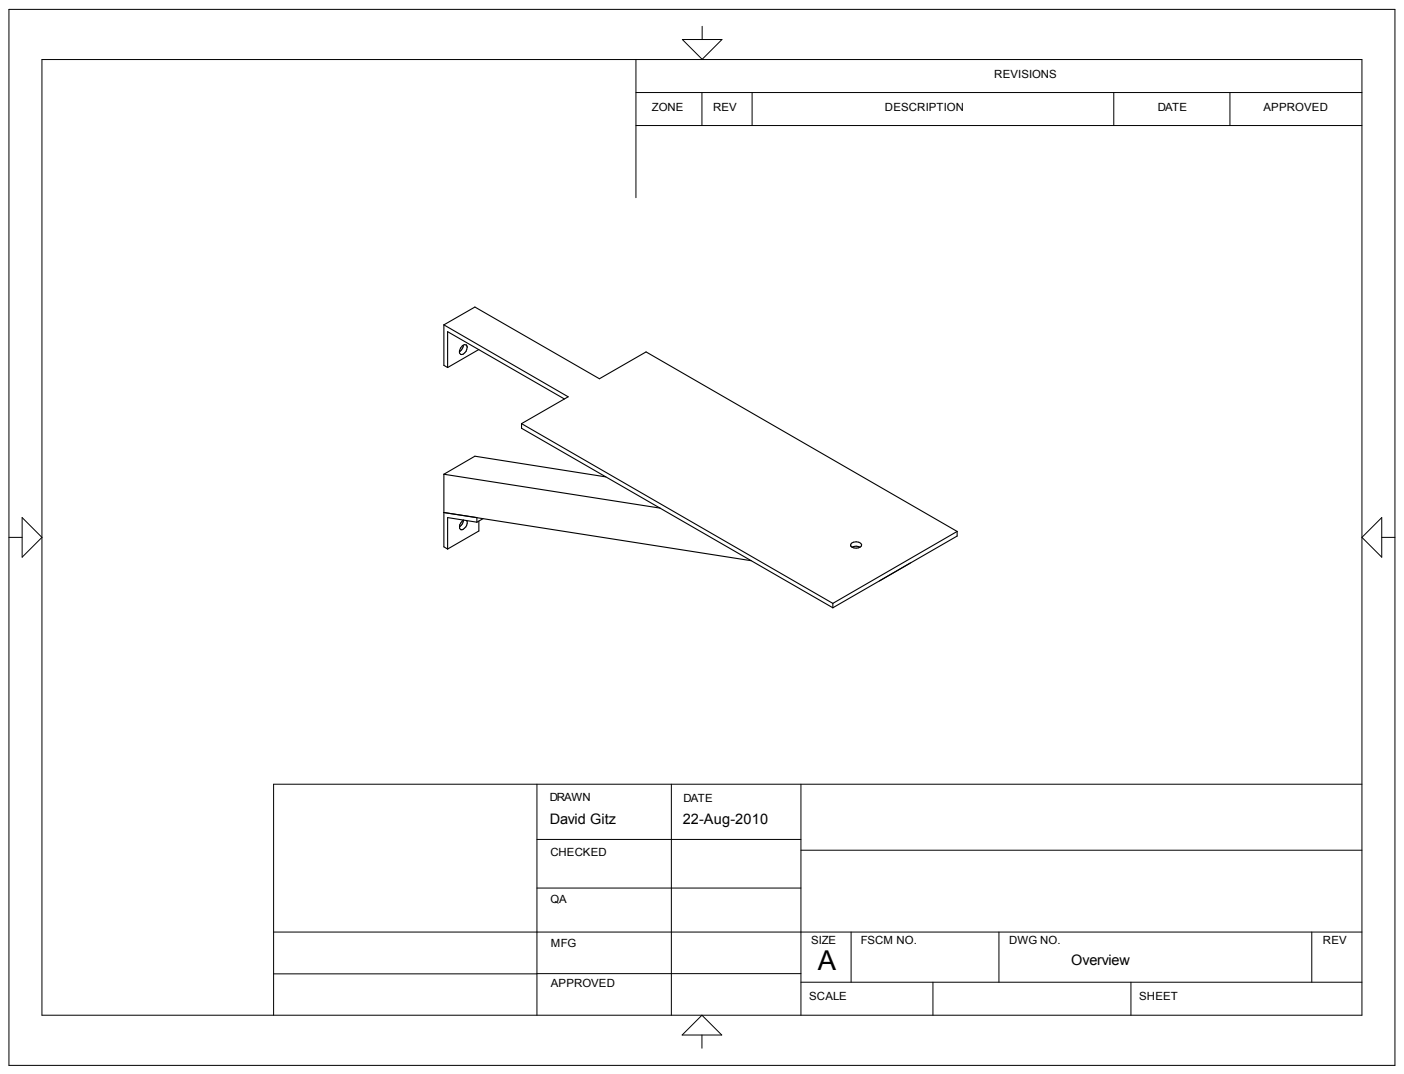
[picture p253: page 1]

REVISIONS

ZONE | REV | DESCRIPTION | DATE | APPROVED

DRAWN David Gitz | DATE 22-Aug-2010

CHECKED

MFG | | SIZE A | FSCM NO. | DWG NO. Overview | REV

APPROVED

SCALE | SHEET

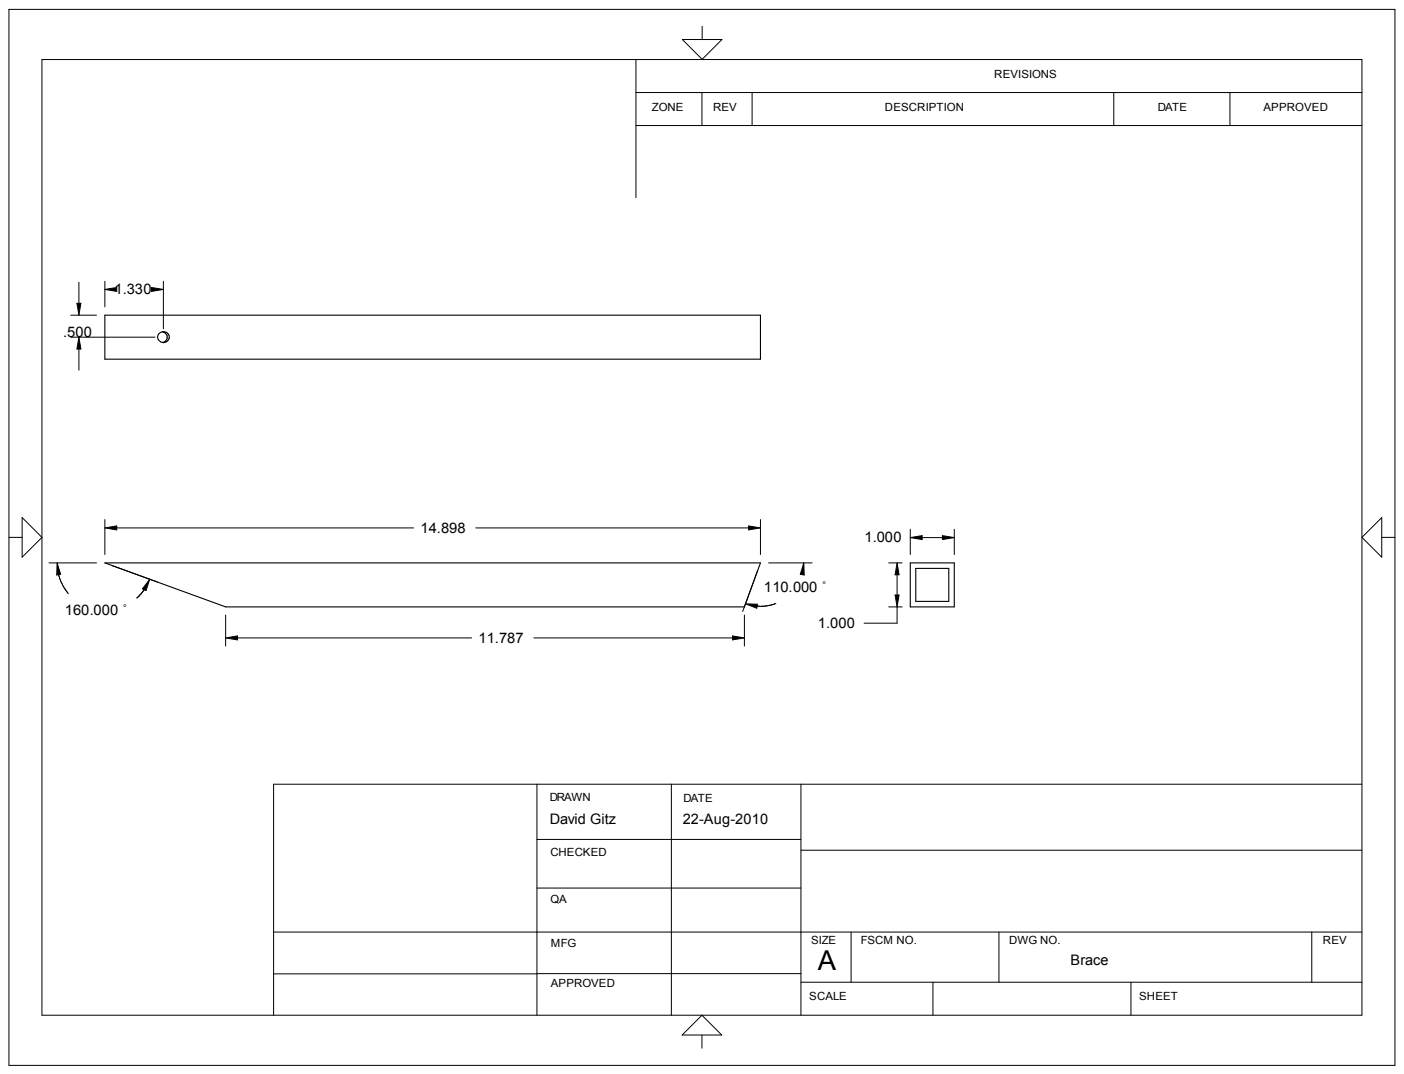
[picture p254: page 2]
APPROVED; REV; DATE; DESCRIPTION; ZONE

DRAWN David Gitz | DATE 22-Aug-2010

CHECKED

MFG | | SIZE A | FSCM NO. | DWG NO. Brace | REV

APPROVED

SCALE | SHEET

10.000

14.000

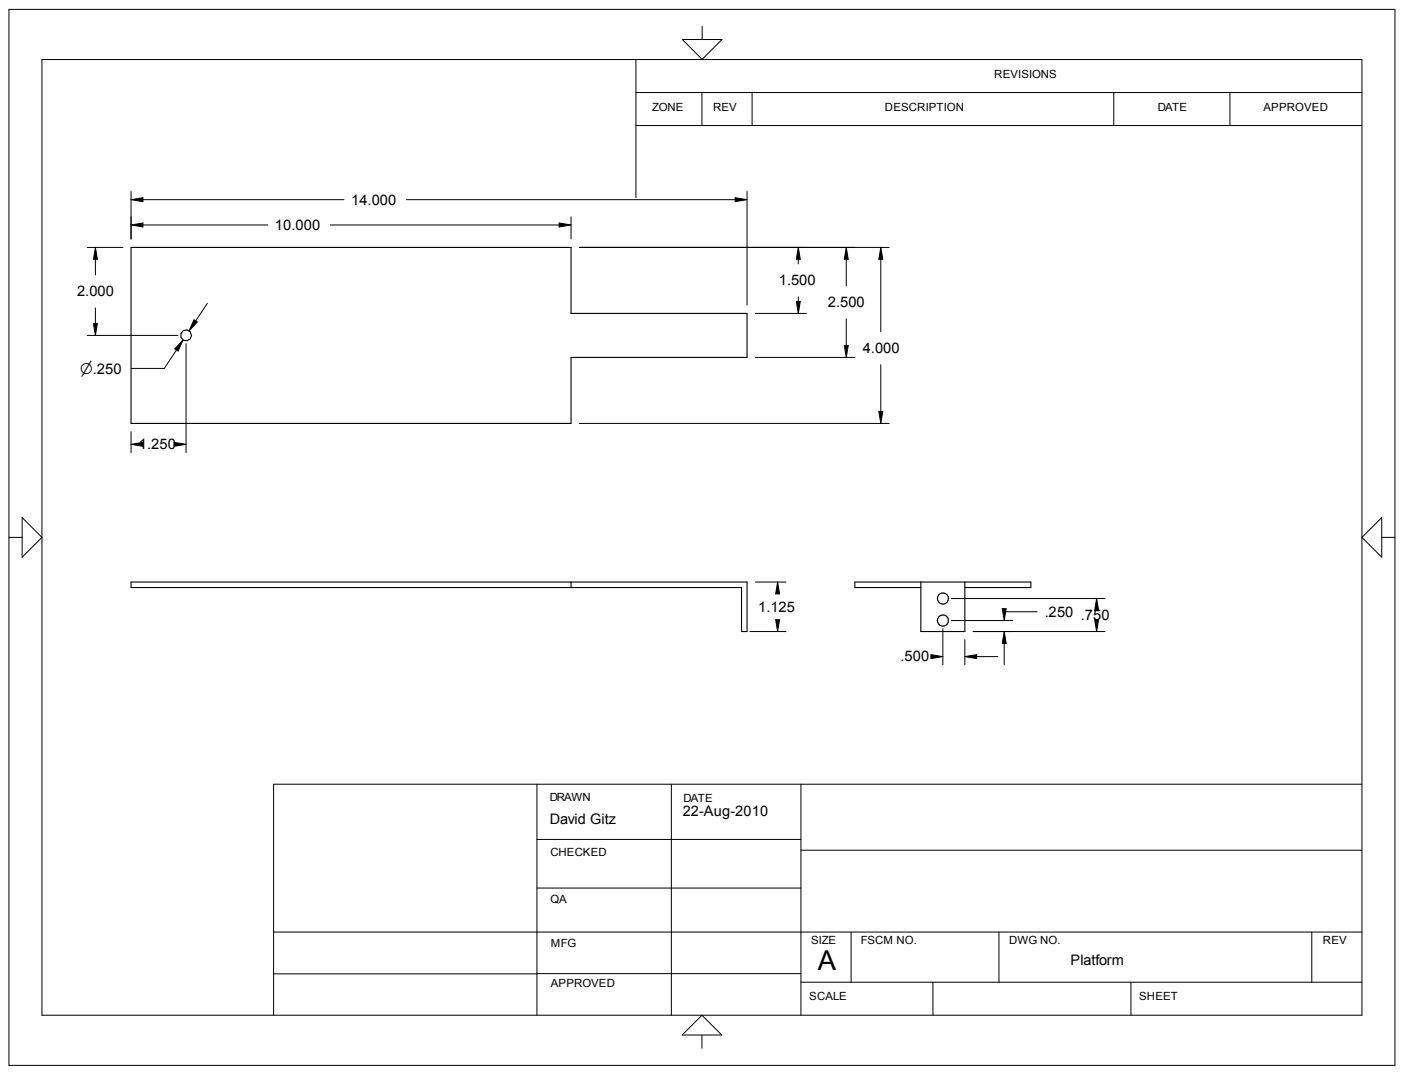
[picture p255: page 3]
DATE; ZONE; REV; APPROVED; DESCRIPTION

DRAWN David Gitz | DATE 22-Aug-2010

CHECKED

MFG | | SIZE A | FSCM NO. | DWG NO. Platform | REV

APPROVED

SCALE | SHEET

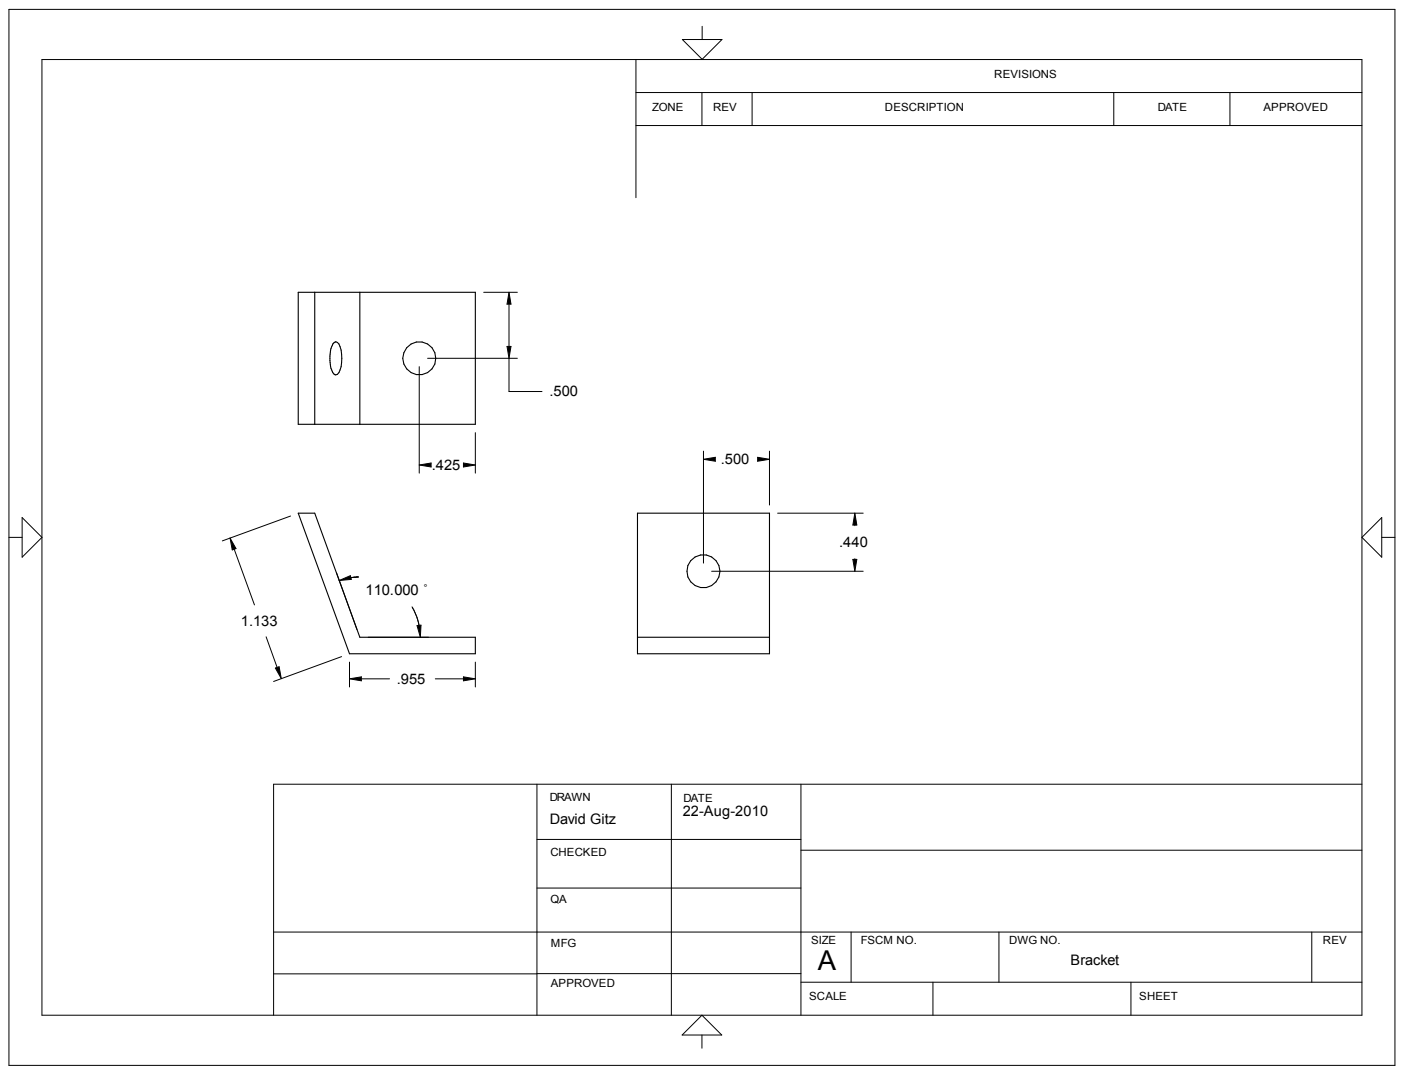
[picture p256: page 4]
APPROVED; DATE; ZONE; REV; DESCRIPTION

DRAWN David Gitz | DATE 22-Aug-2010

CHECKED

MFG | | SIZE A | FSCM NO. | DWG NO. Bracket | REV

APPROVED

SCALE | SHEET
