mwelling/robot-chopper/TestStand/Design/Drawings/Test Fixture Assembly.pdf

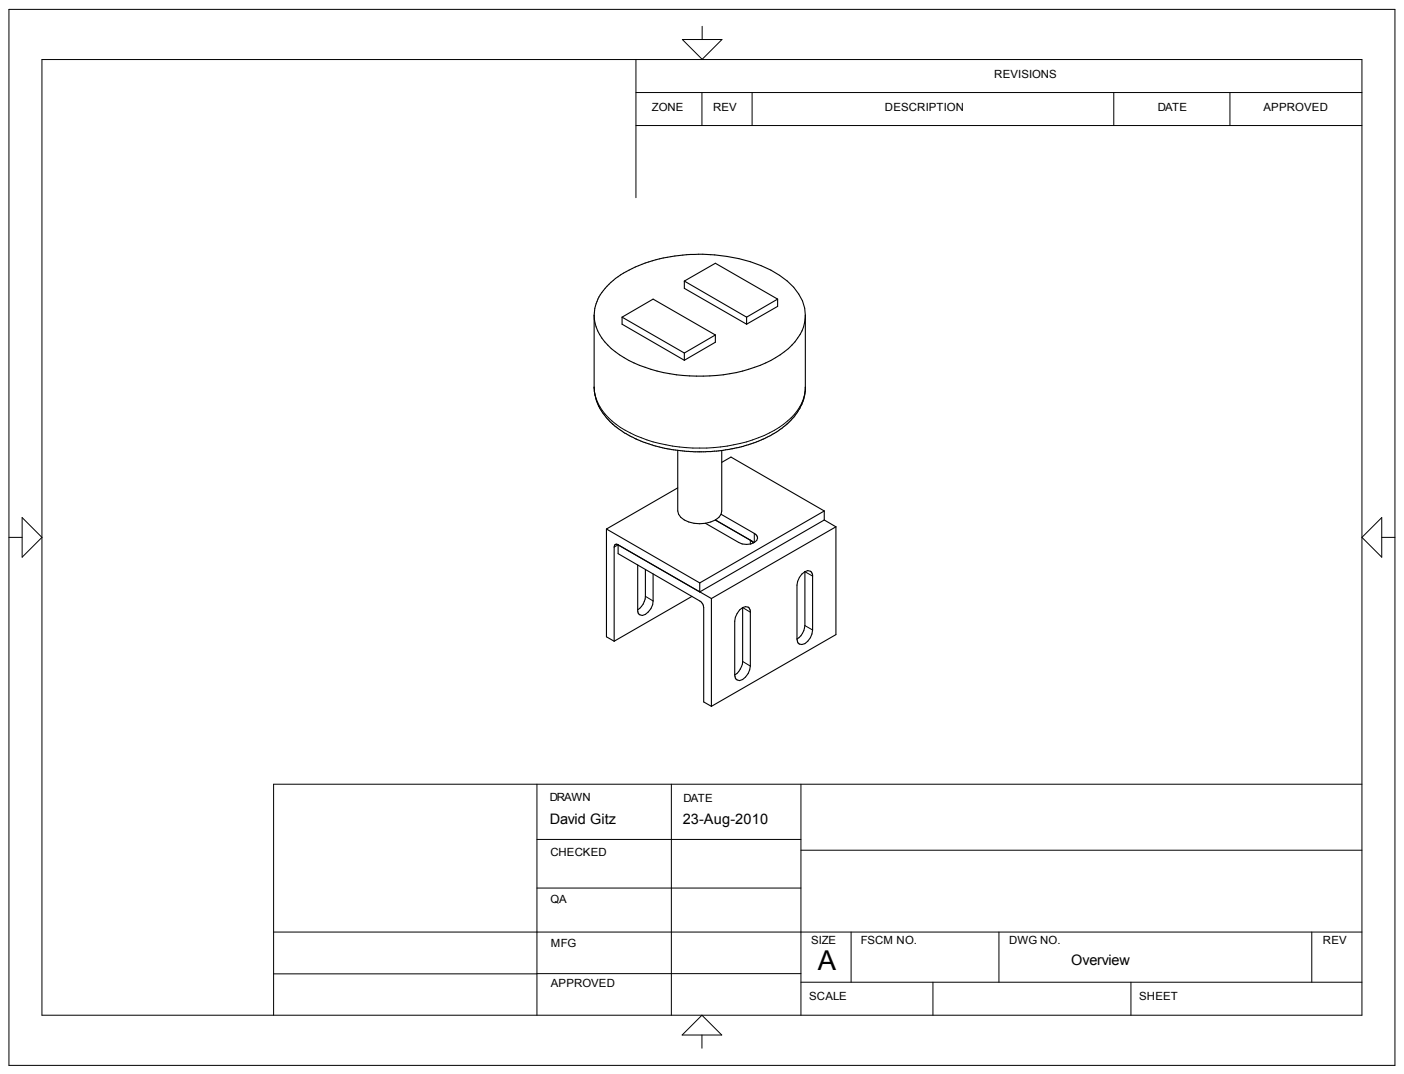
[picture p257: page 1]

REVISIONS

ZONE | REV | DESCRIPTION | DATE | APPROVED

DRAWN David Gitz | DATE 23-Aug-2010

CHECKED

MFG | | SIZE A | FSCM NO. | DWG NO. Overview | REV

APPROVED

SCALE | SHEET

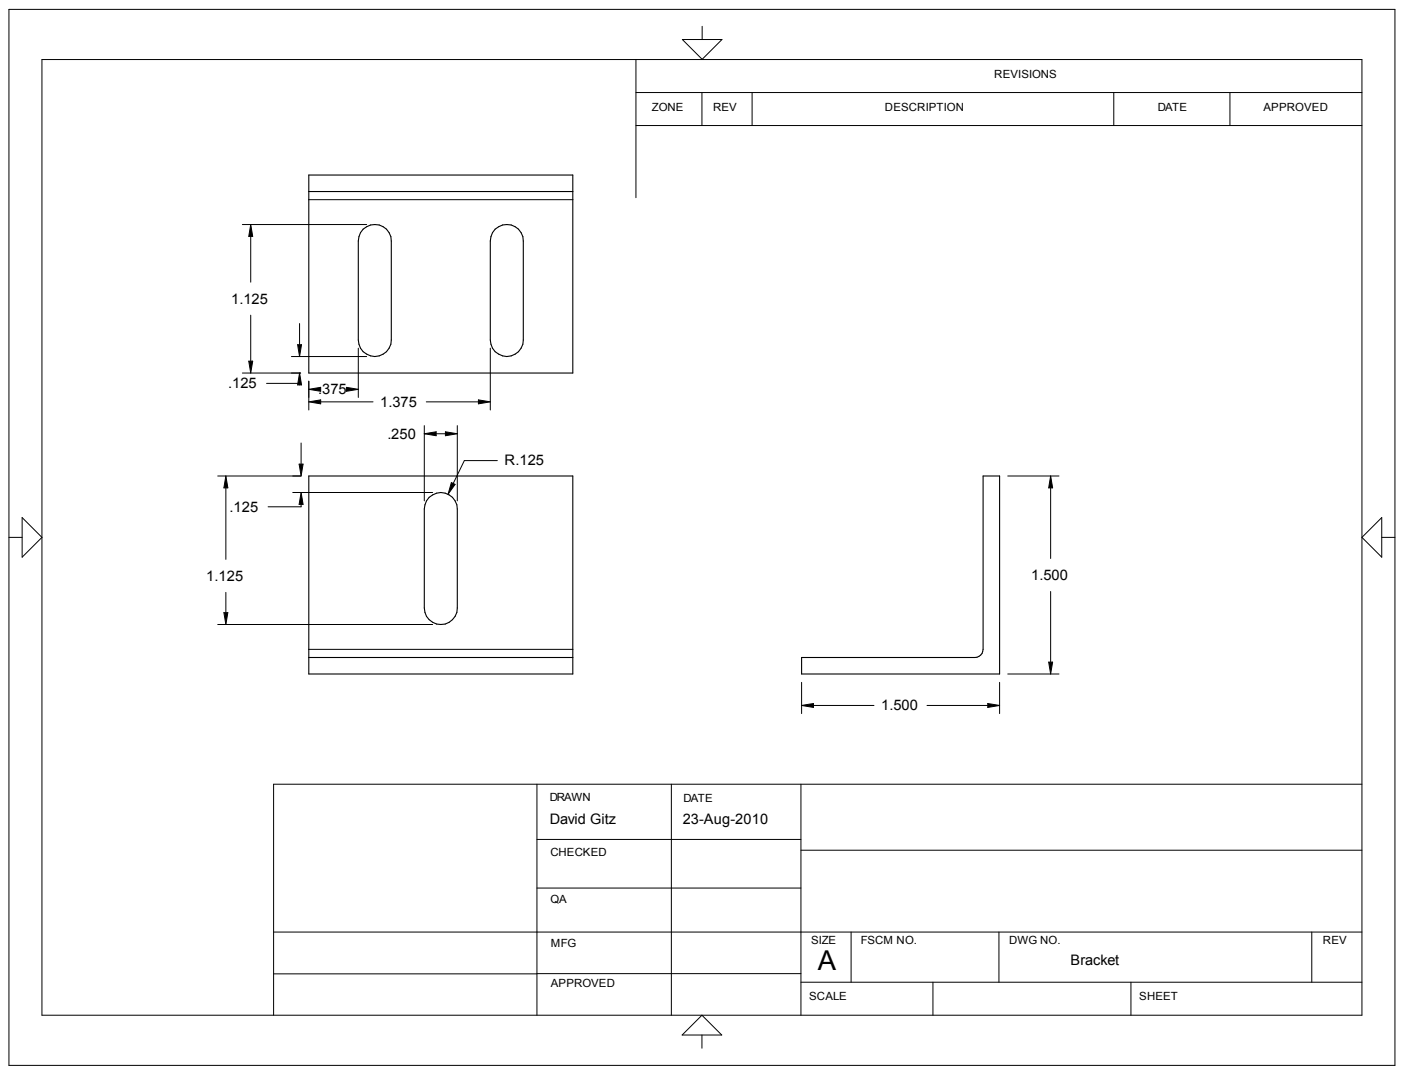
[picture p258: page 2]
DESCRIPTION; ZONE; APPROVED; REV; DATE

DRAWN David Gitz | DATE 23-Aug-2010

CHECKED

MFG | | SIZE A | FSCM NO. | DWG NO. Bracket | REV

APPROVED

SCALE | SHEET

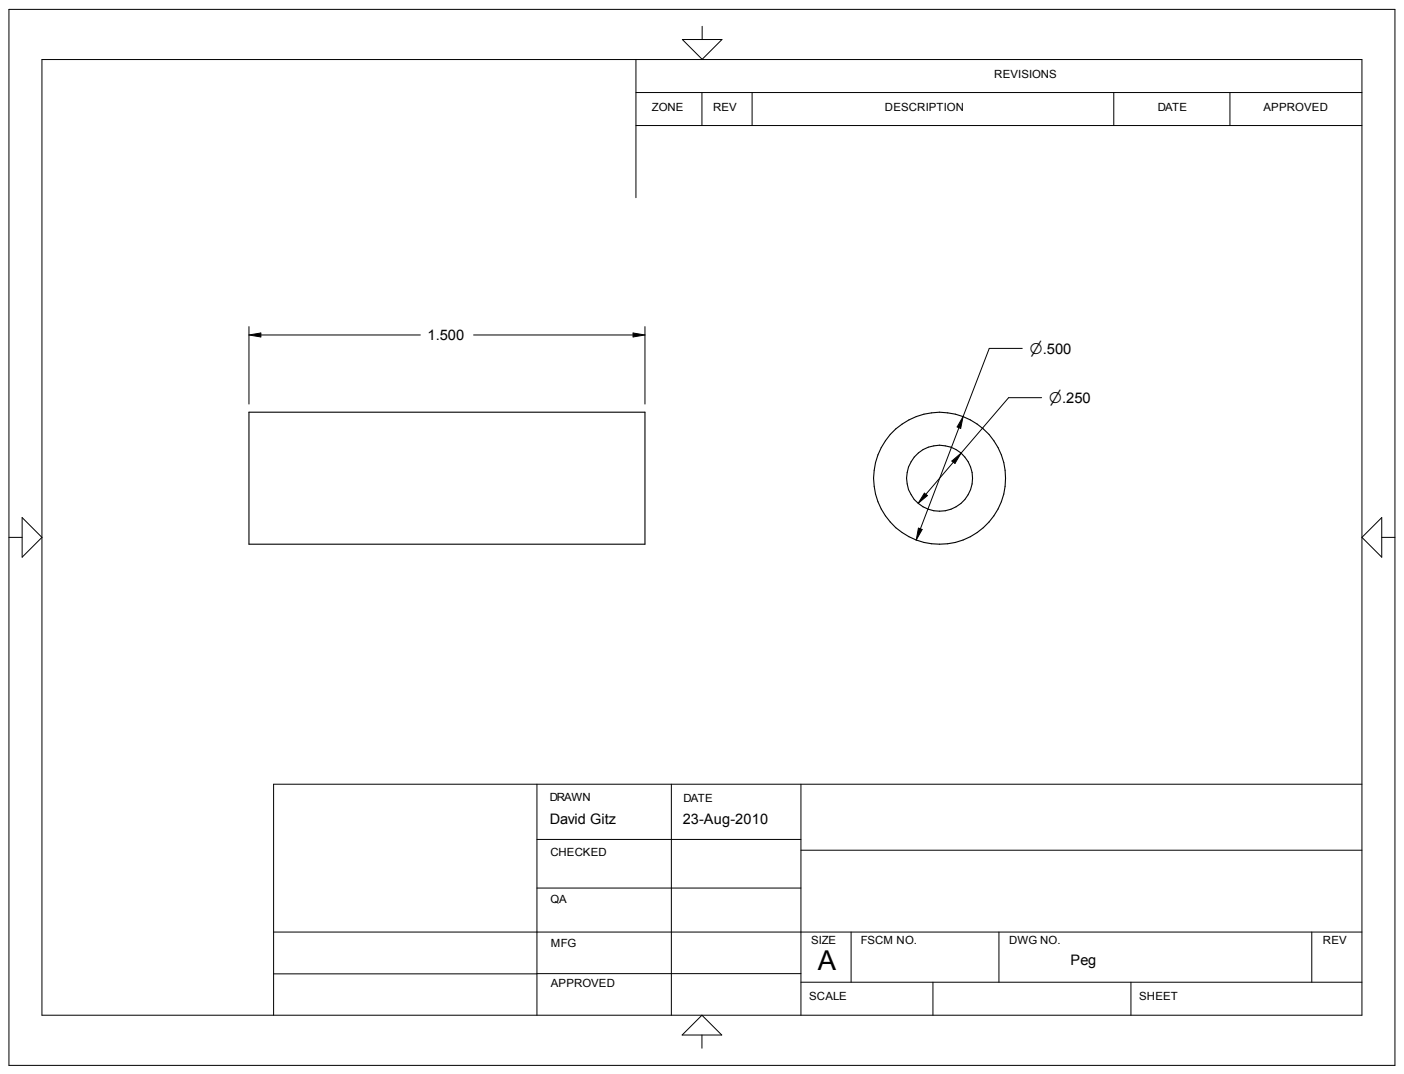
[picture p259: page 3]
DATE; ZONE; REV; DESCRIPTION; APPROVED

DRAWN David Gitz | DATE 23-Aug-2010

CHECKED

MFG | | SIZE A | FSCM NO. | DWG NO. Peg | REV

APPROVED

SCALE | SHEET

n1.500

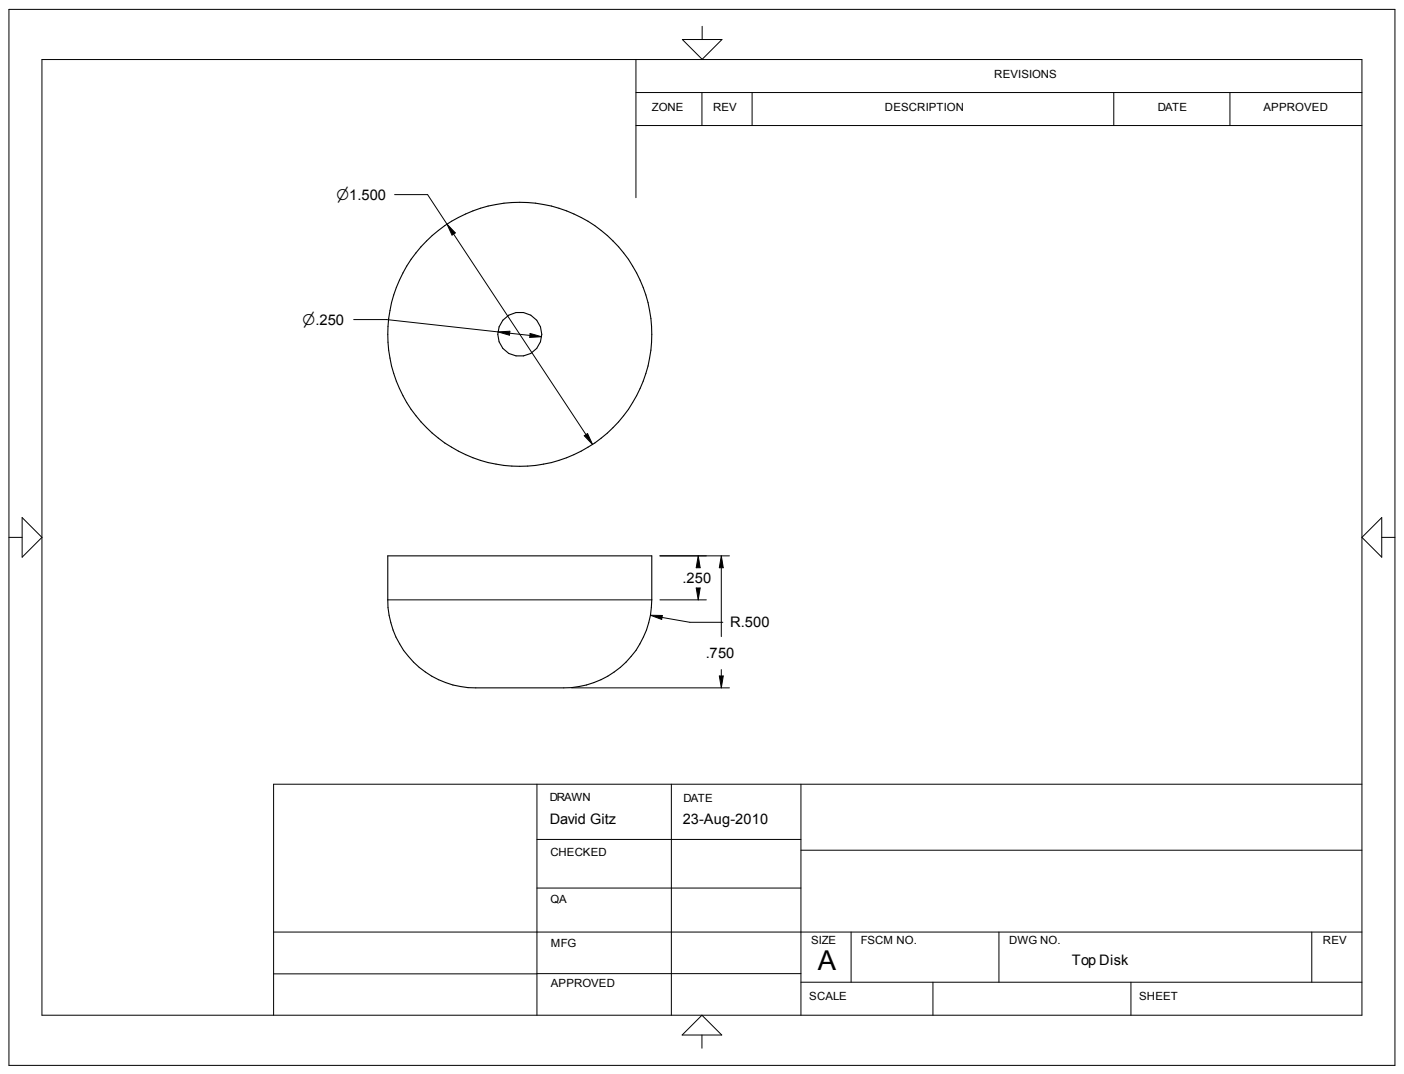
[picture p260: page 4]
ZONE; REV; DESCRIPTION; APPROVED; DATE

DRAWN David Gitz | DATE 23-Aug-2010

CHECKED

MFG | | SIZE A | FSCM NO. | DWG NO. Top Disk | REV

APPROVED

SCALE | SHEET

n2.400

n2.200

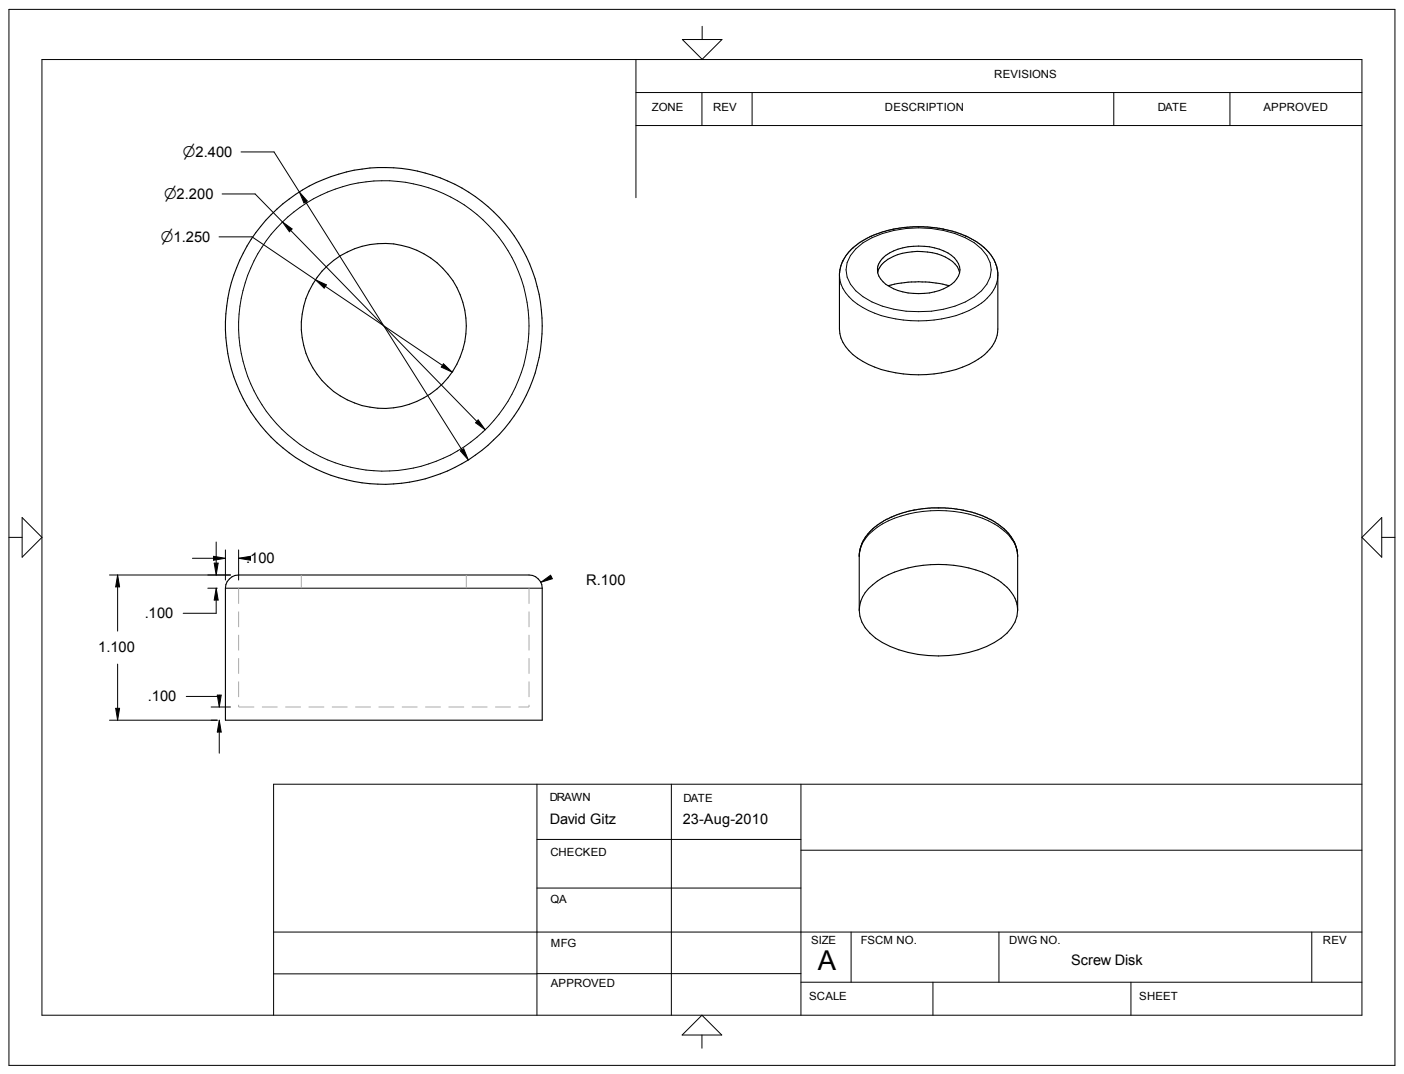
[picture p261: page 5]
REV; ZONE; DATE; DESCRIPTION; APPROVED

DRAWN David Gitz | DATE 23-Aug-2010

CHECKED

MFG | | SIZE A | FSCM NO. | DWG NO. Screw Disk | REV

APPROVED

SCALE | SHEET
