mwelling/robot-chopper/Media/Vehicle/VehicleSizeComparison.pdf

6.440 | ICARUS Vehicle ver 1

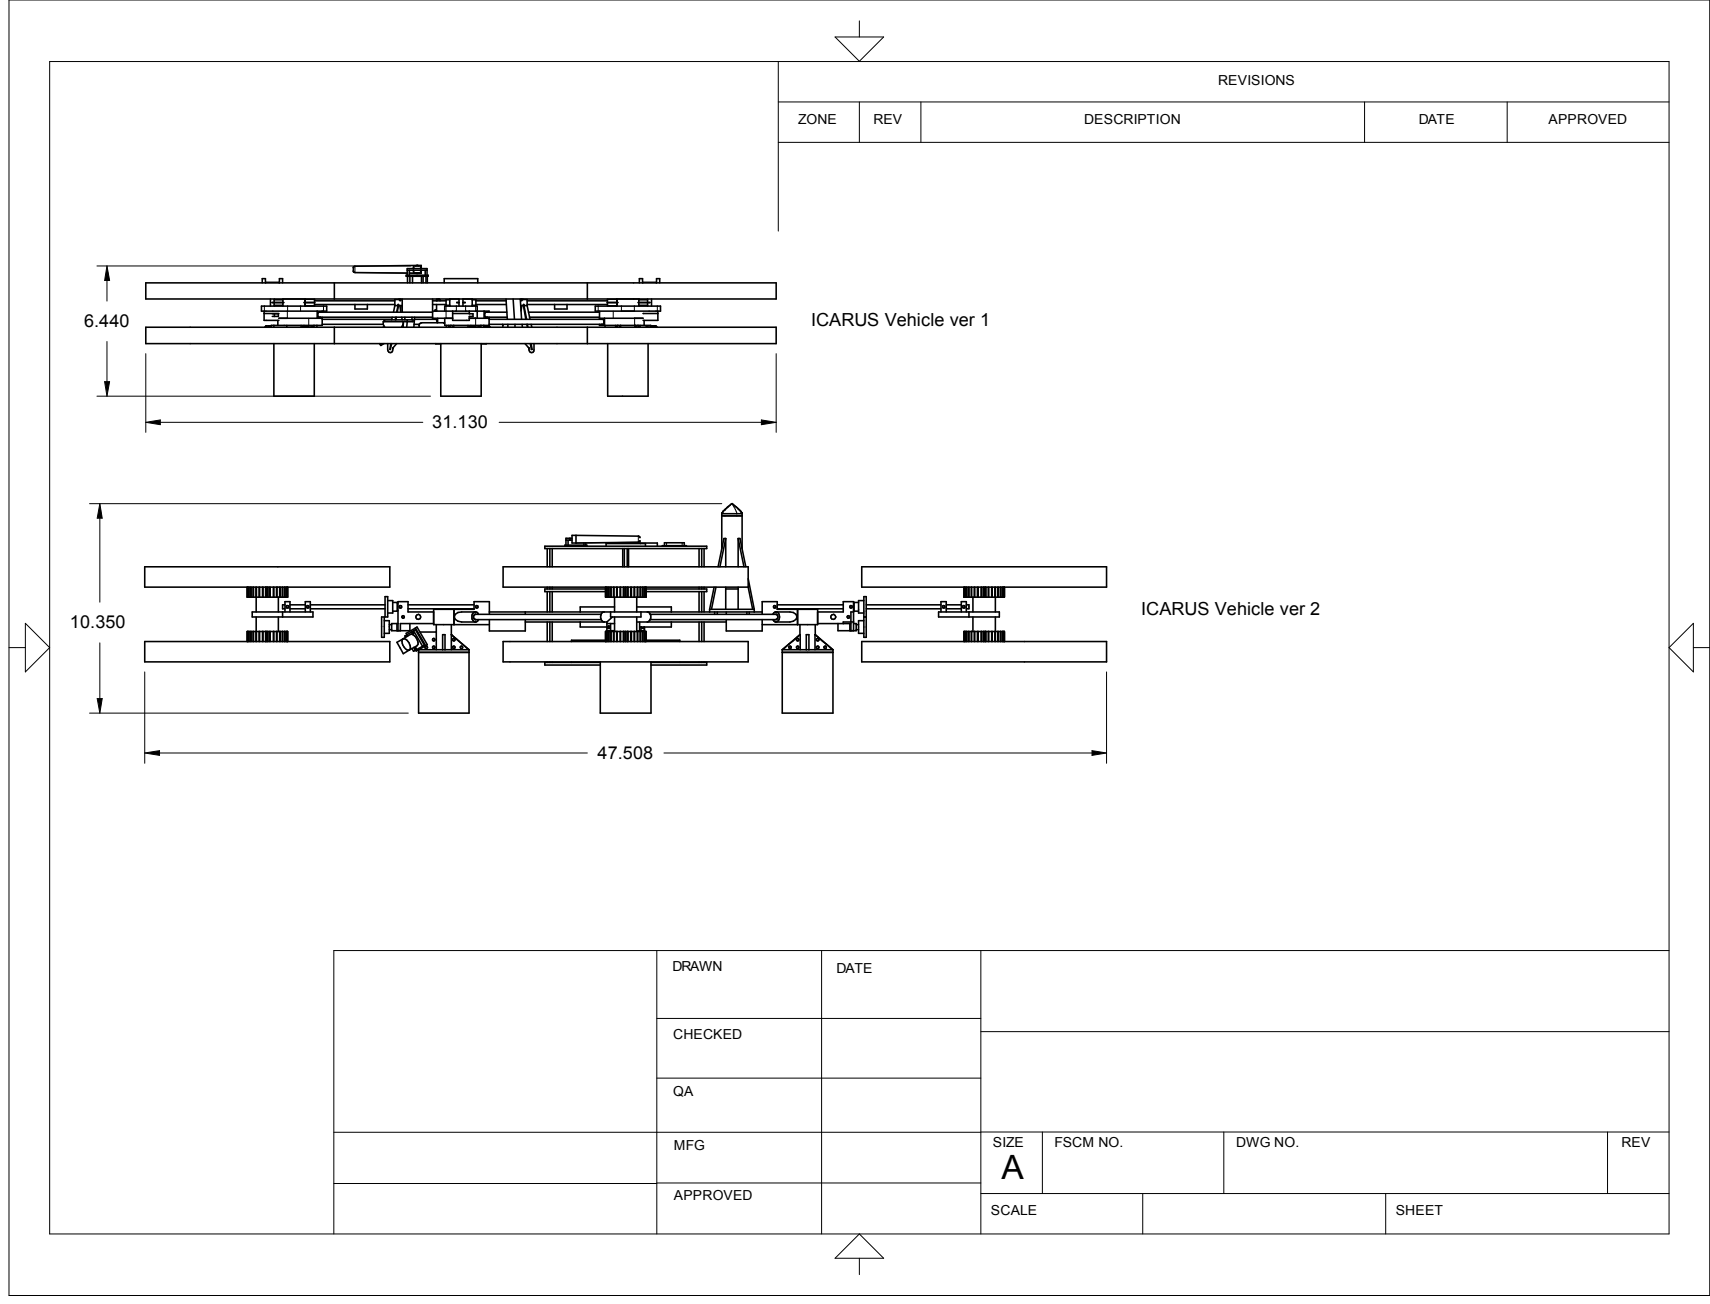
[picture p265: page 1]

REVISIONS

ZONE | REV | DESCRIPTION | DATE | APPROVED

ICARUS Vehicle ver 2

DRAWN | DATE

CHECKED

MFG | | SIZE A | FSCM NO. | DWG NO. | REV

APPROVED

SCALE | SHEET
