mwelling/robot-chopper/RemoteControl/Packages/Rev.11/ControlBoard.pdf

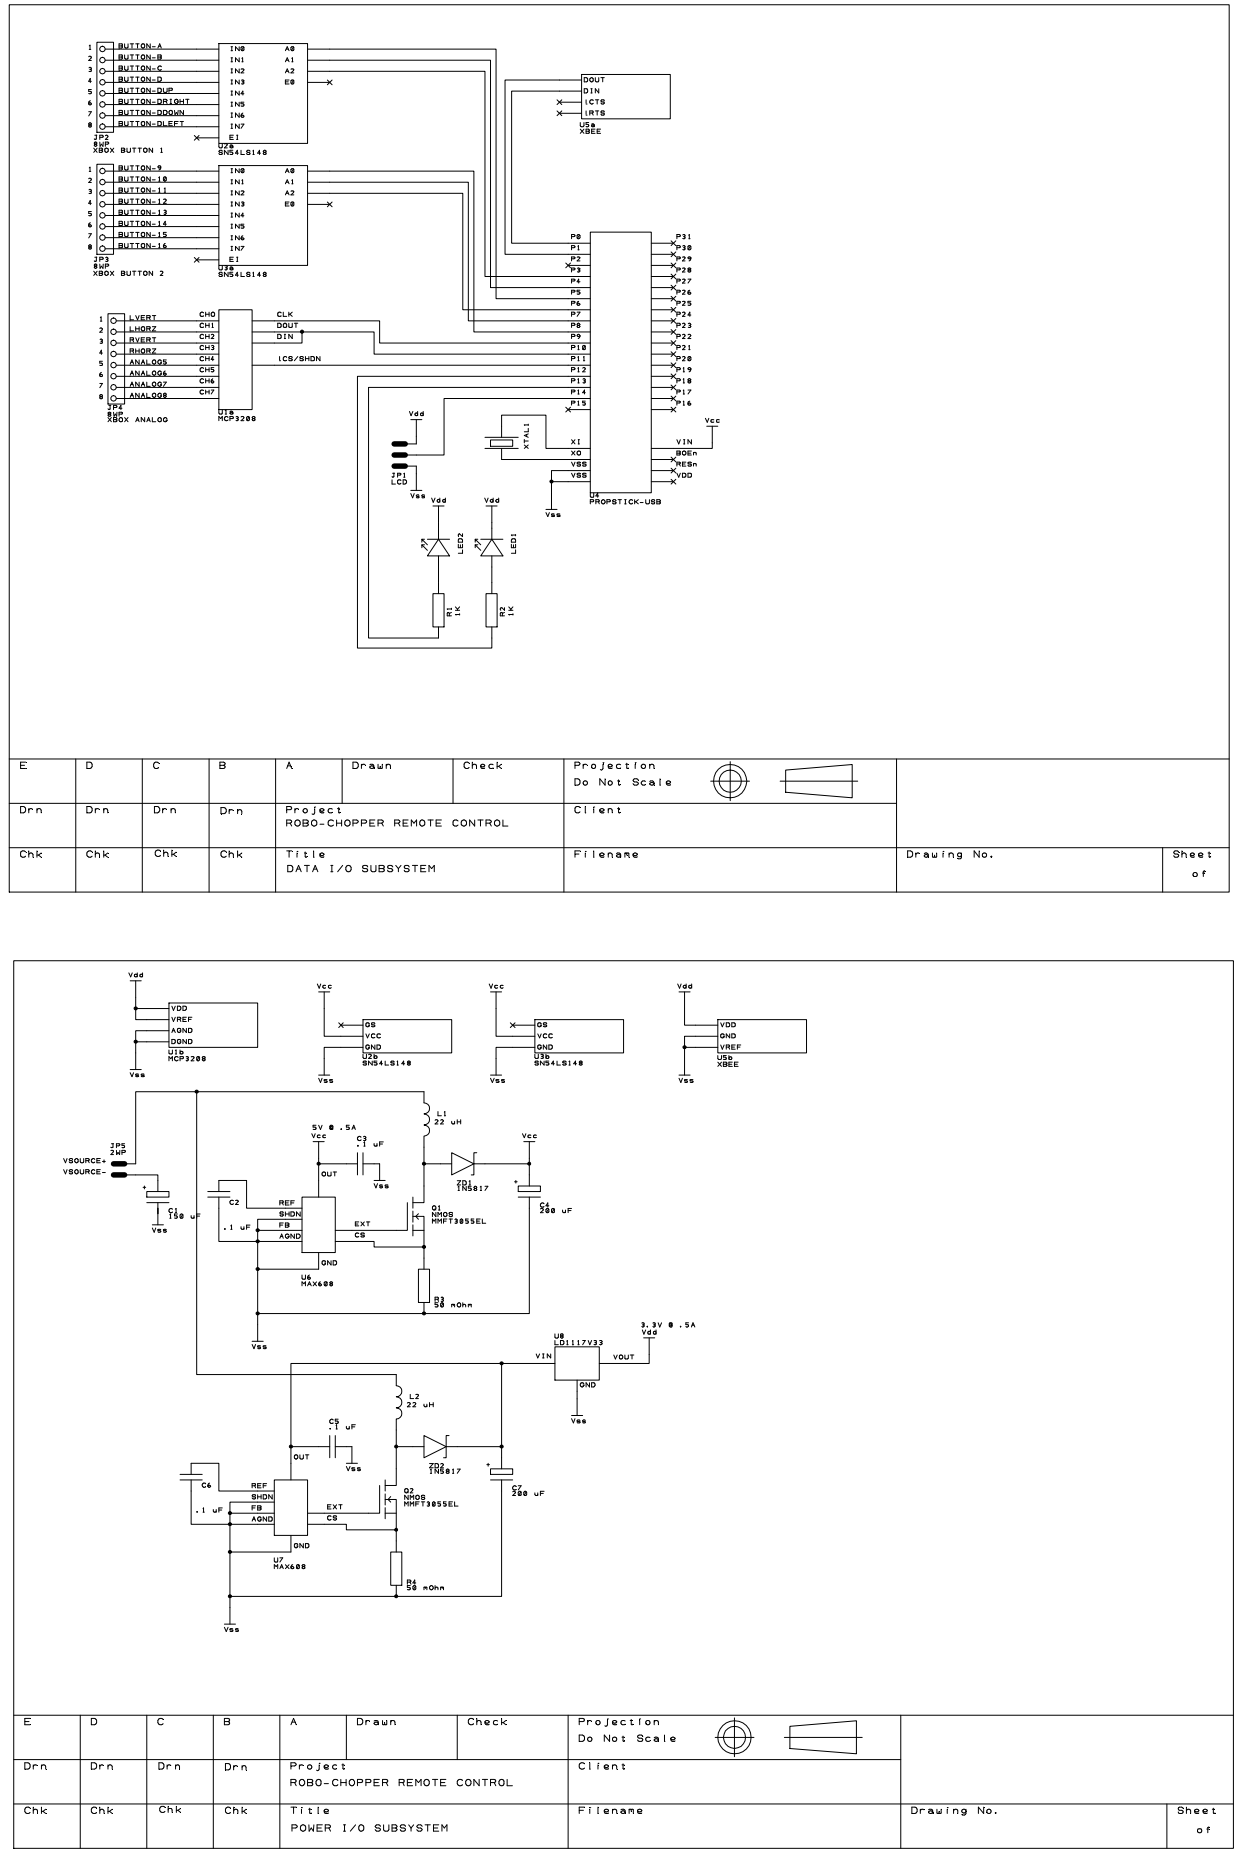
[picture p266: page 1]
