mwelling/robot-chopper/(list of files, drawings)

Other design files:
Analysis/Communications/RF DAQ/Schematics/RemoteNode.pcb
RemoteControl/Schematics/PCB Artist/ControlBoard2.pcb
RemoteControl/Schematics/PCB Artist/~ControlBoard2.pcb
