mwelling/robot-chopper/Practice/Power.sch

## KiCad design Practice/Power.sch (2010-11-17)

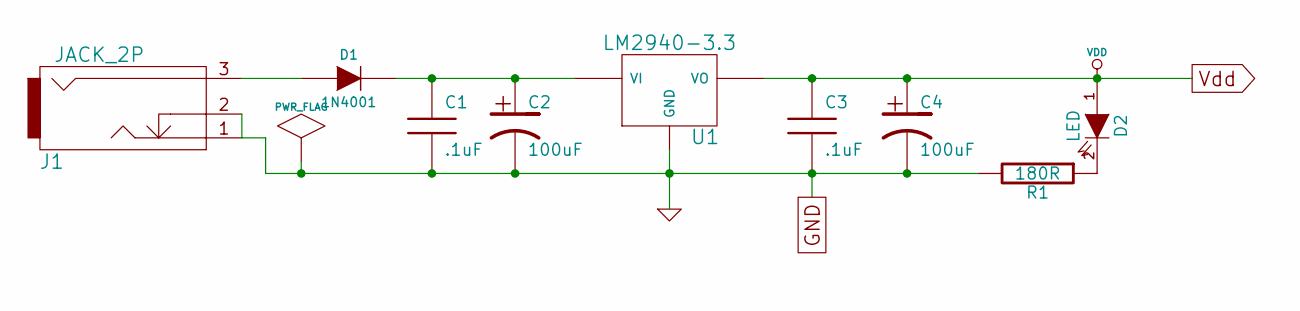
[picture p267: schematic Power.sch]

Parts:
C1, C3: .1uF
C2, C4: 100uF
D1: 1N4001
D2: LED
J1: JACK_2P
R1: 180R
U1: LM2940-3.3

Connections:
GND: C1.2, C2.2, C3.2, C4.2, J1.1, J1.2, R1.2, U1.GND
unnamed: C1.1, C2.1, D1.2 (K), U1.VI
unnamed: D1.1 (A), J1.3
unnamed: D2.2 (K), R1.1
Vdd: C3.1, C4.1, D2.1 (A), U1.VO
