mwelling/robot-chopper/Practice/PropRPM.sch

## KiCad design Practice/PropRPM.sch (2010-11-17)

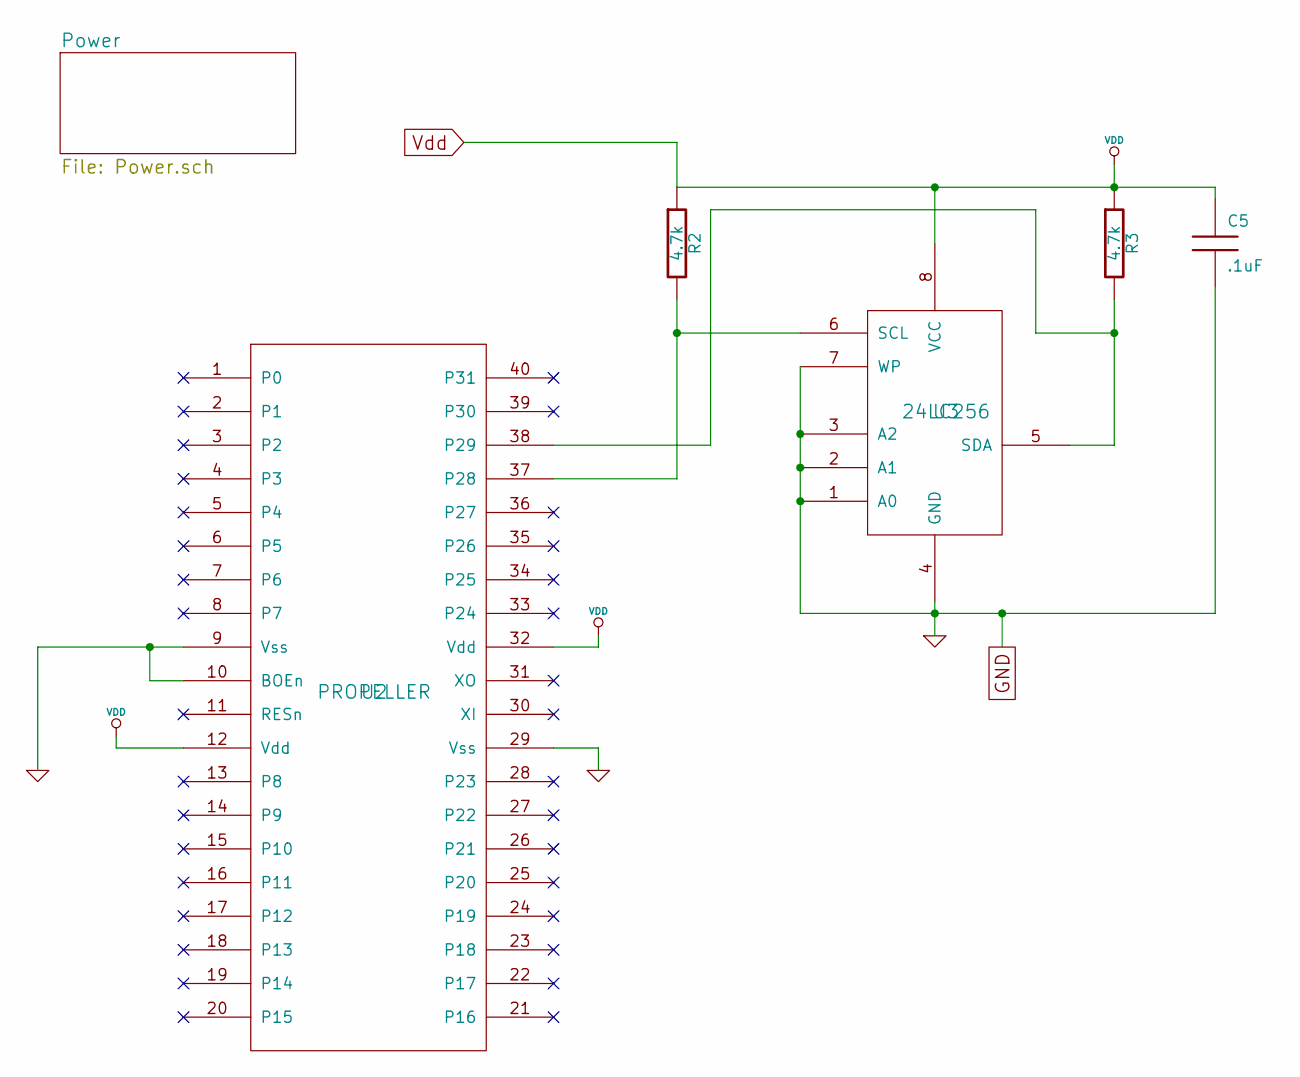
[picture p268: schematic PropRPM.sch]

Parts:
C5: .1uF
R2, R3: 4.7k
U2: PROPELLER
U3: 24LC256

Connections:
GND: C5.2, U2.9 (Vss), U2.10 (BOEn), U2.29 (Vss), U3.1 (A0), U3.2 (A1), U3.3 (A2), U3.4 (GND), U3.7 (WP)
unnamed: R2.2, U2.37 (P28), U3.6 (SCL)
unnamed: R3.2, U2.38 (P29), U3.5 (SDA)
Vdd: C5.1, R2.1, R3.1, U2.12 (Vdd), U2.32 (Vdd), U3.8 (VCC)
