mwelling/robot-chopper/Practice/noname.sch

## KiCad design Practice/noname.sch (2010-11-17)

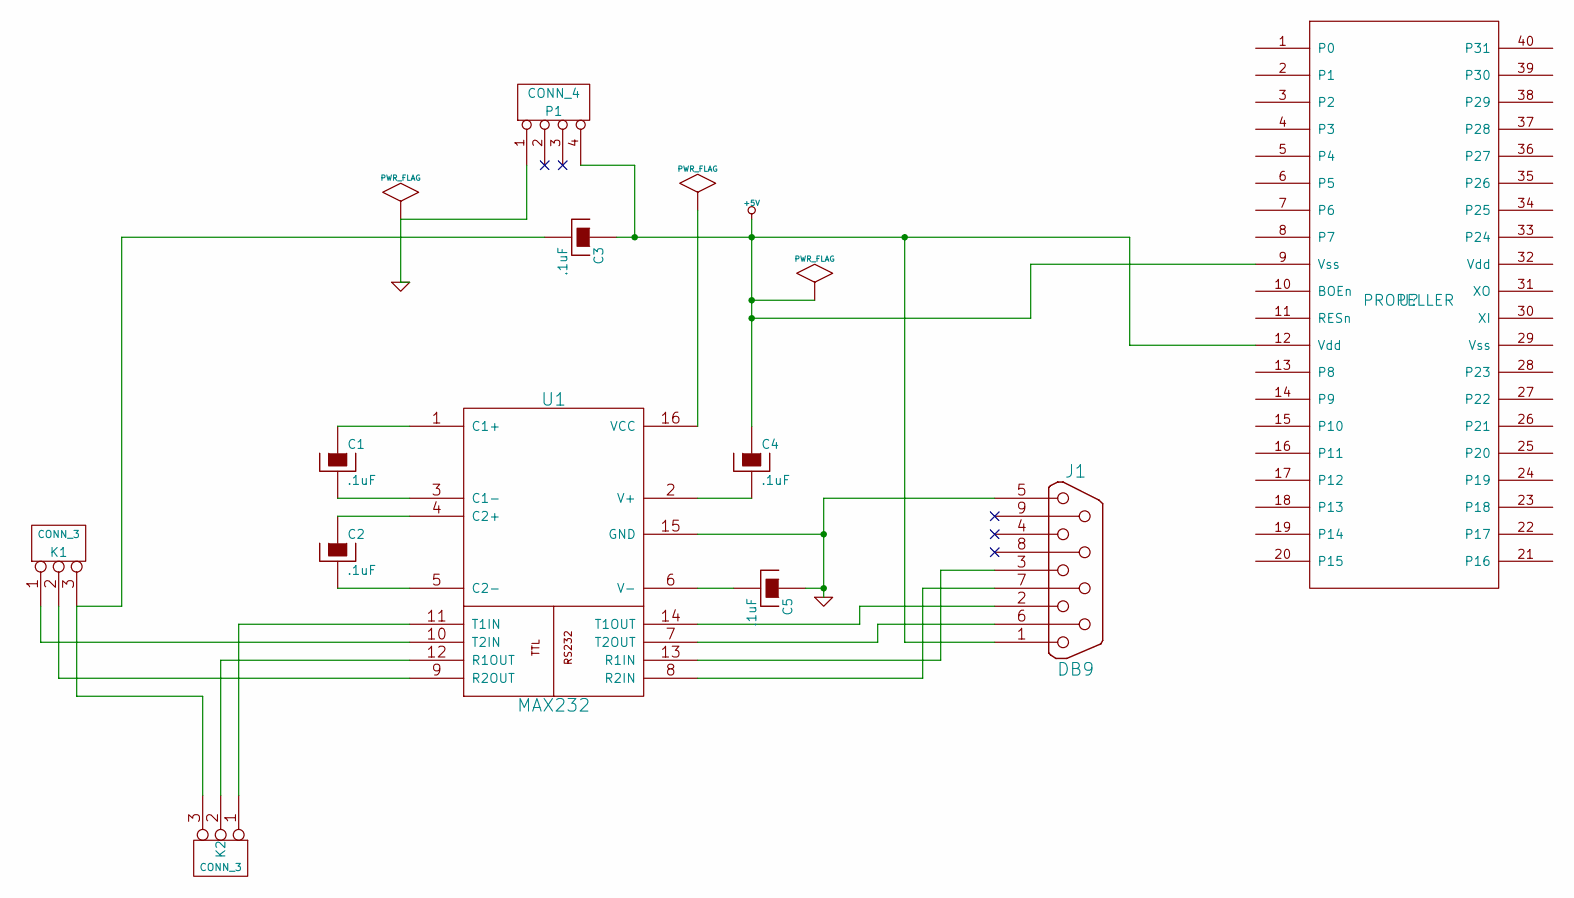
[picture p269: schematic noname.sch]

Parts:
C1, C2, C3, C4, C5: .1uF
J1: DB9
K1, K2: CONN_3
P1: CONN_4
U1: MAX232

Connections:
+5V: C3.1, C4.1, J1.1, P1.4
GND: C5.1, J1.5, P1.1, U1.15 (GND)
unnamed: C1.1, U1.1 (C1+)
unnamed: C1.2, U1.3 (C1-)
unnamed: C2.1, U1.4 (C2+)
unnamed: C2.2, U1.5 (C2-)
unnamed: C3.2, K1.3, K2.3
unnamed: C4.2, U1.2 (V+)
unnamed: C5.2, U1.6 (V-)
unnamed: J1.2, U1.14 (T1OUT)
unnamed: J1.3, U1.13 (R1IN)
unnamed: J1.6, U1.7 (T2OUT)
unnamed: J1.7, U1.8 (R2IN)
unnamed: K1.1, U1.10 (T2IN)
unnamed: K1.2 (PM), U1.9 (R2OUT)
unnamed: K2.1, U1.11 (T1IN)
unnamed: K2.2 (PM), U1.12 (R1OUT)
