mwelling/robot-chopper/RemoteControl/Schematics/KiCAD/RemoteControl.sch

## KiCad design RemoteControl/Schematics/KiCAD/RemoteControl.sch (2010-11-17)

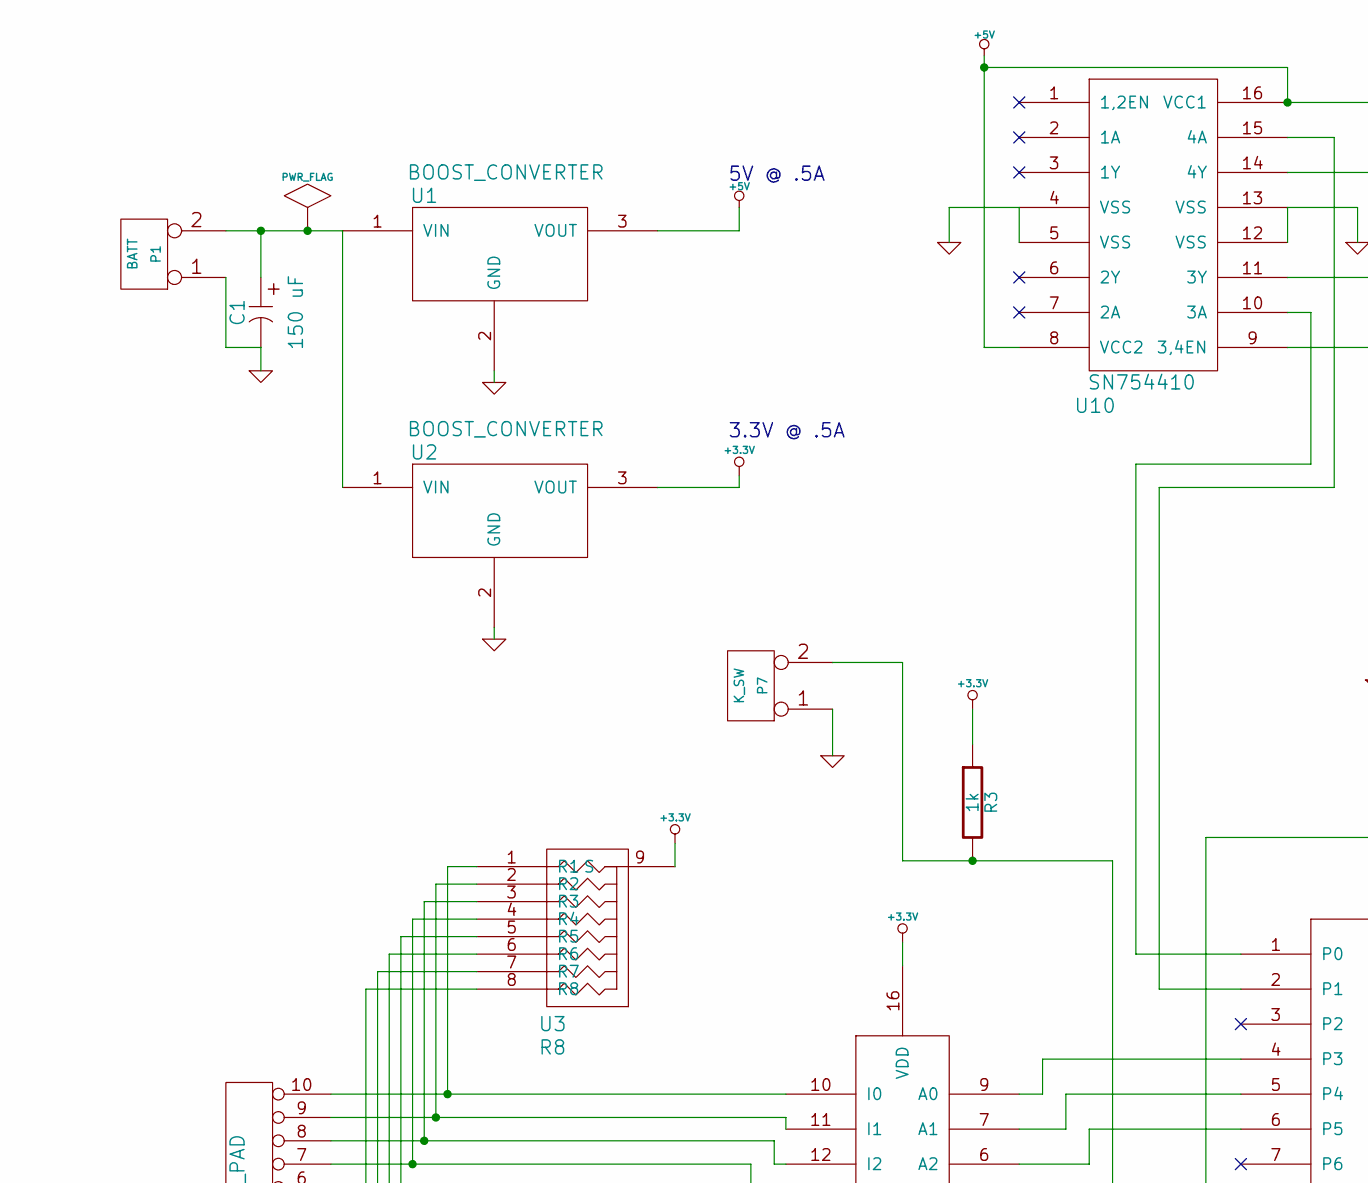
[picture p270: schematic RemoteControl.sch, part in row 1, column 1]

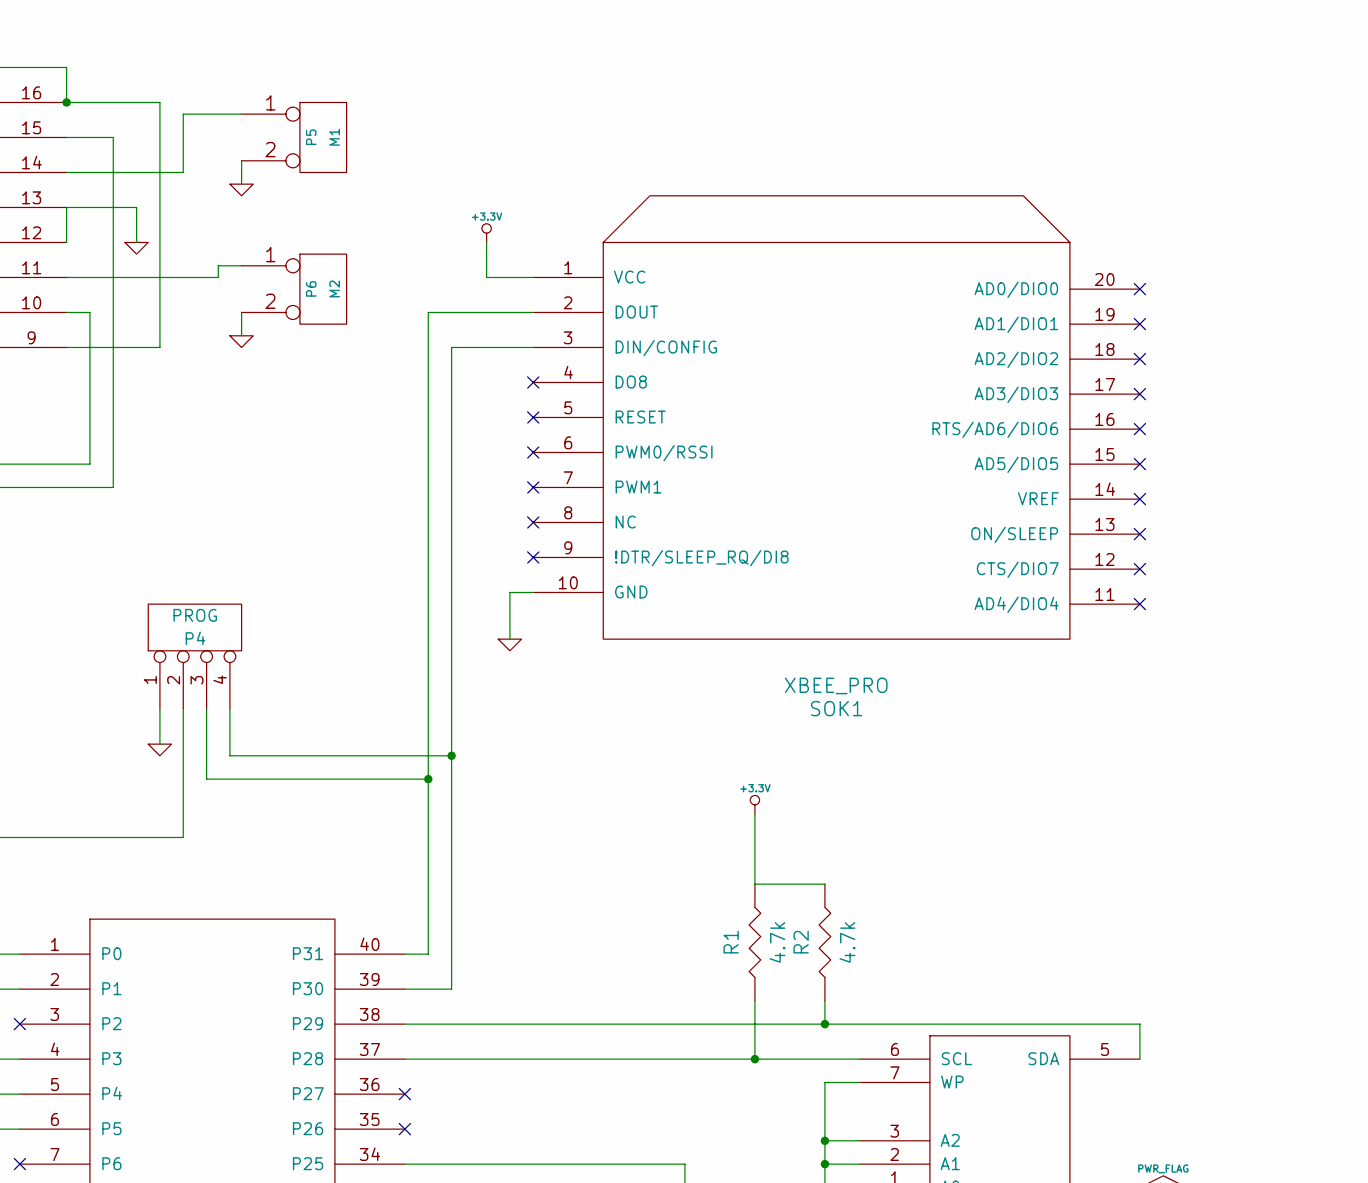
[picture p271: schematic RemoteControl.sch, part in row 1, column 2]

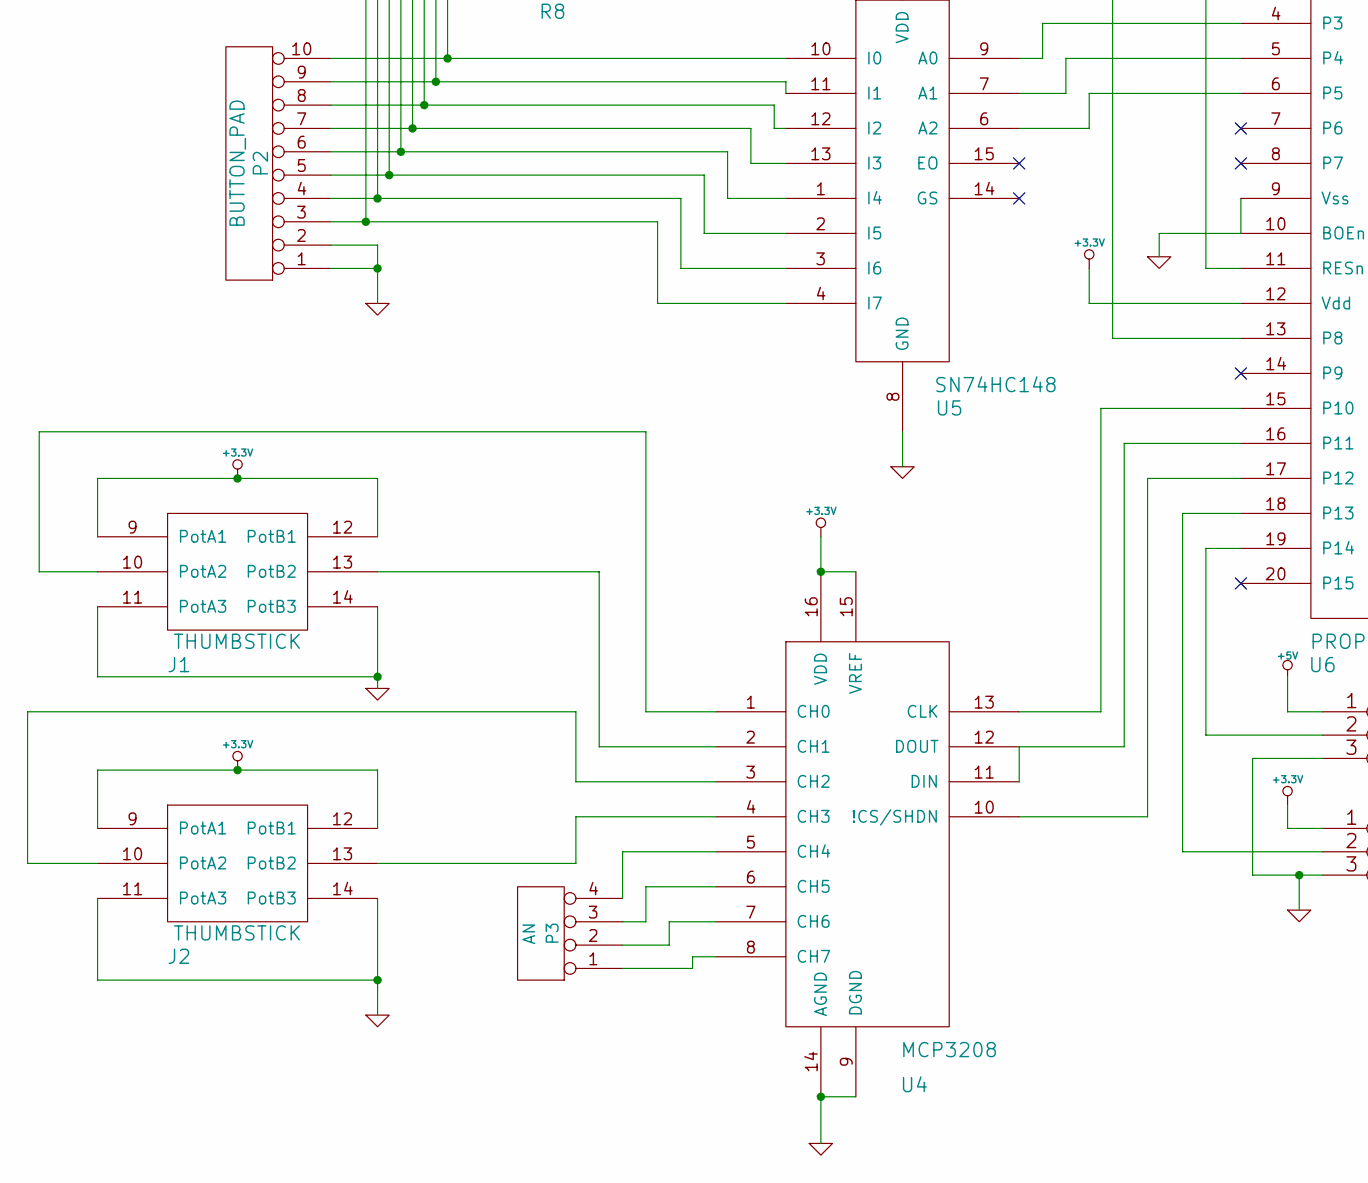
[picture p272: schematic RemoteControl.sch, part in row 2, column 1]

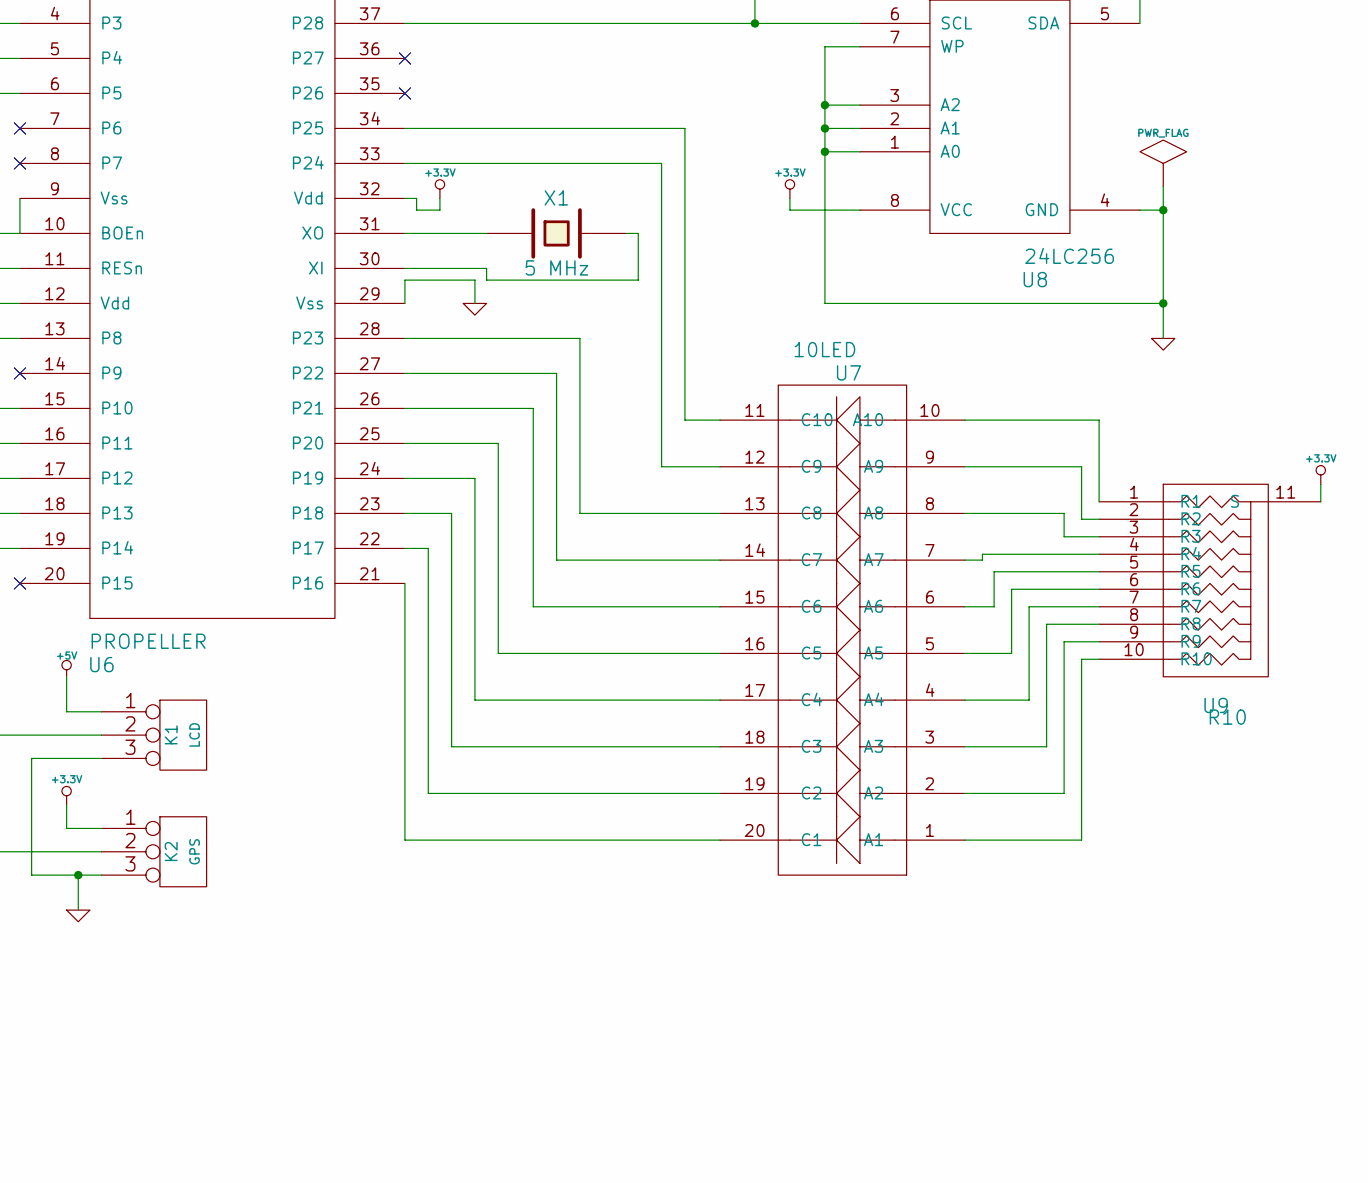
[picture p273: schematic RemoteControl.sch, part in row 2, column 2]

Parts:
C1: 150 uF
J1, J2: THUMBSTICK
K1: LCD
K2: GPS
P1: BATT
P2: BUTTON_PAD
P3: AN
P4: PROG
P5: M1
P6: M2
P7: K_SW
R1, R2: 4.7k
R3: 1k
SOK1: XBEE_PRO
U1, U2: BOOST_CONVERTER
U3: R8
U4: MCP3208
U5: SN74HC148
U6: PROPELLER
U7: 10LED
U8: 24LC256
U9: R10
U10: SN754410
X1: 5 MHz

Connections:
+3.3V: J1.9 (PotA1), J1.12 (PotB1), J2.9 (PotA1), J2.12 (PotB1), K2.1, R1.1, R2.1, R3.1, SOK1.1 (VCC), U2.3 (VOUT), U3.9 (S), U4.15 (VREF), U4.16 (VDD), U5.16 (VDD), U6.12 (Vdd), U6.32 (Vdd), U8.8 (VCC), U9.11 (S)
+5V: K1.1, U1.3 (VOUT), U10.8 (VCC2), U10.9 (3,4EN), U10.16 (VCC1)
GND: C1.2, J1.11 (PotA3), J1.14 (PotB3), J2.11 (PotA3), J2.14 (PotB3), K1.3, K2.3, P1.1, P2.1, P2.2, P4.1, P5.2 (PM), P6.2 (PM), P7.1, SOK1.10 (GND), U1.2 (GND), U2.2 (GND), U4.9 (DGND), U4.14 (AGND), U5.8 (GND), U6.9 (Vss), U6.10 (BOEn), U6.29 (Vss), U8.1 (A0), U8.2 (A1), U8.3 (A2), U8.4 (GND), U8.7 (WP), U10.4 (VSS), U10.5 (VSS), U10.12 (VSS), U10.13 (VSS)
unnamed: C1.1, P1.2 (PM), U1.1 (VIN), U2.1 (VIN)
unnamed: J1.10 (PotA2), U4.1 (CH0)
unnamed: J1.13 (PotB2), U4.2 (CH1)
unnamed: J2.10 (PotA2), U4.3 (CH2)
unnamed: J2.13 (PotB2), U4.4 (CH3)
unnamed: K1.2 (PM), U6.19 (P14)
unnamed: K2.2 (PM), U6.18 (P13)
unnamed: P2.3, U3.8 (R8), U5.4 (I7)
unnamed: P2.4, U3.7 (R7), U5.3 (I6)
unnamed: P2.5, U3.6 (R6), U5.2 (I5)
unnamed: P2.6, U3.5 (R5), U5.1 (I4)
unnamed: P2.7, U3.4 (R4), U5.13 (I3)
unnamed: P2.8, U3.3 (R3), U5.12 (I2)
unnamed: P2.9, U3.2 (R2), U5.11 (I1)
unnamed: P2.10, U3.1 (R1), U5.10 (I0)
unnamed: P3.1, U4.8 (CH7)
unnamed: P3.2, U4.7 (CH6)
unnamed: P3.3, U4.6 (CH5)
unnamed: P3.4, U4.5 (CH4)
unnamed: P4.2, U6.11 (RESn)
unnamed: P4.3, SOK1.2 (DOUT), U6.40 (P31)
unnamed: P4.4, SOK1.3 (DIN/CONFIG), U6.39 (P30)
unnamed: P5.1, U10.14 (4Y)
unnamed: P6.1, U10.11 (3Y)
unnamed: P7.2 (PM), R3.2, U6.13 (P8)
unnamed: R1.2, U6.37 (P28), U8.6 (SCL)
unnamed: R2.2, U6.38 (P29), U8.5 (SDA)
unnamed: U4.10 (!CS/SHDN), U6.17 (P12)
unnamed: U4.11 (DIN), U4.12 (DOUT), U6.16 (P11)
unnamed: U4.13 (CLK), U6.15 (P10)
unnamed: U5.6 (A2), U6.6 (P5)
unnamed: U5.7 (A1), U6.5 (P4)
unnamed: U5.9 (A0), U6.4 (P3)
unnamed: U6.21 (P16), U7.20 (C1)
unnamed: U6.22 (P17), U7.19 (C2)
unnamed: U6.23 (P18), U7.18 (C3)
unnamed: U6.24 (P19), U7.17 (C4)
unnamed: U6.25 (P20), U7.16 (C5)
unnamed: U6.26 (P21), U7.15 (C6)
unnamed: U6.27 (P22), U7.14 (C7)
unnamed: U6.28 (P23), U7.13 (C8)
unnamed: U6.30 (XI), X1.2
unnamed: U6.31 (XO), X1.1
unnamed: U6.33 (P24), U7.12 (C9)
unnamed: U6.34 (P25), U7.11 (C10)
unnamed: U7.1 (A1), U9.10 (R10)
unnamed: U7.2 (A2), U9.9 (R9)
unnamed: U7.3 (A3), U9.8 (R8)
unnamed: U7.4 (A4), U9.7 (R7)
unnamed: U7.5 (A5), U9.6 (R6)
unnamed: U7.6 (A6), U9.5 (R5)
unnamed: U7.7 (A7), U9.4 (R4)
unnamed: U7.8 (A8), U9.3 (R3)
unnamed: U7.9 (A9), U9.2 (R2)
unnamed: U7.10 (A10), U9.1 (R1)
unnamed: U6.1 (P0), U10.10 (3A)
unnamed: U6.2 (P1), U10.15 (4A)

Notes on the sheet:
3.3V @ .5A
5V @ .5A
