mwelling/robot-chopper/Analysis/Communications/RF DAQ/Schematics/RFDAQ.sch

## KiCad design Analysis/Communications/RF DAQ/Schematics/RFDAQ.sch (2010-11-17)

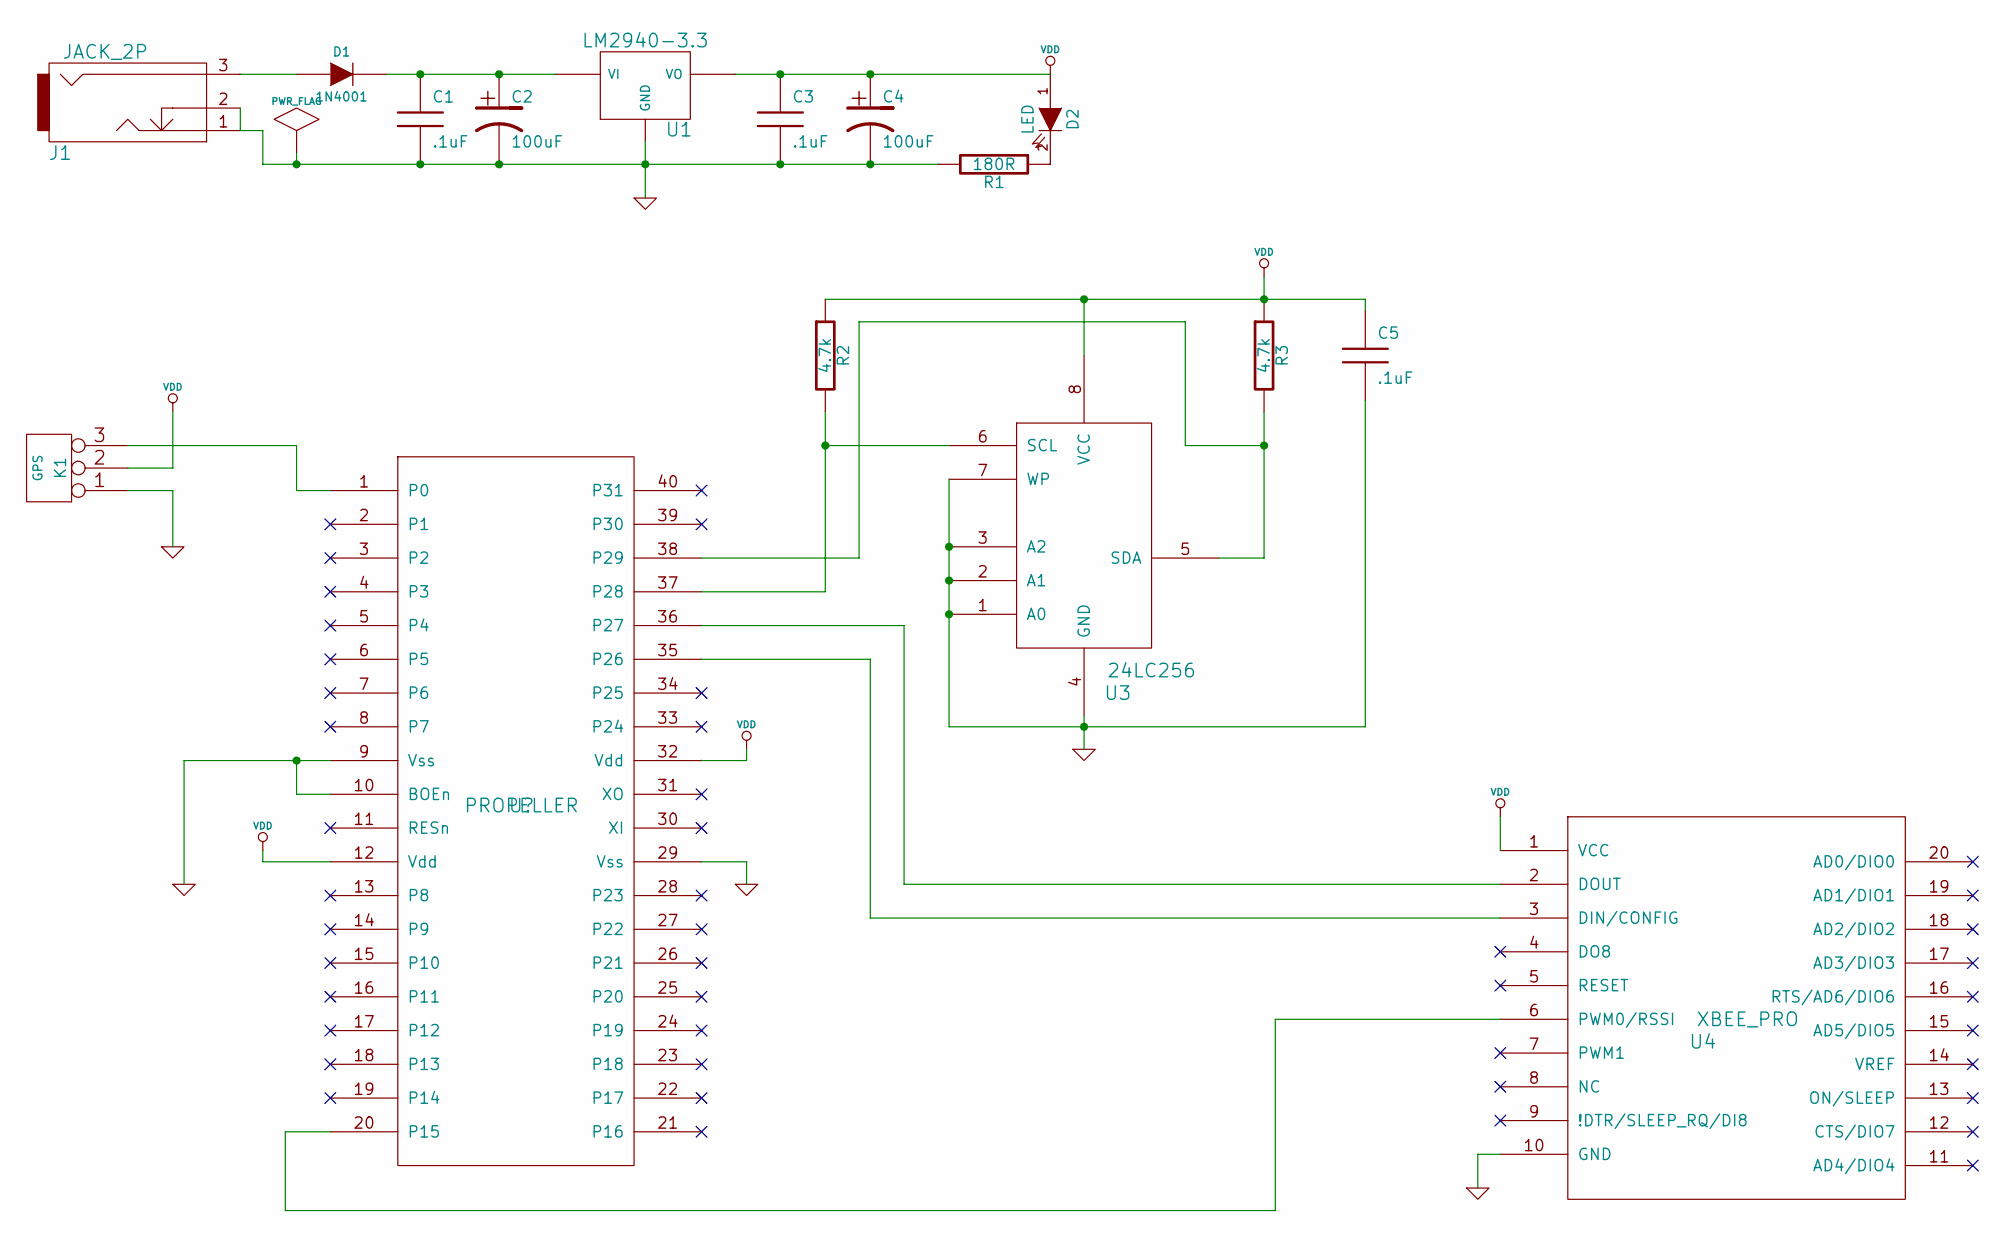
[picture p274: schematic RFDAQ.sch]

Parts:
C1, C3, C5: .1uF
C2, C4: 100uF
D1: 1N4001
D2: LED
J1: JACK_2P
K1: GPS
R1: 180R
R2, R3: 4.7k
U1: LM2940-3.3
U3: 24LC256
U4: XBEE_PRO

Connections:
GND: C1.2, C2.2, C3.2, C4.2, C5.2, J1.1, J1.2, K1.1, R1.2, U1.GND, U3.1 (A0), U3.2 (A1), U3.3 (A2), U3.4 (GND), U3.7 (WP), U4.10 (GND)
unnamed: C1.1, C2.1, D1.2 (K), U1.VI
unnamed: D1.1 (A), J1.3
unnamed: D2.2 (K), R1.1
unnamed: R2.2, U3.6 (SCL)
unnamed: R3.2, U3.5 (SDA)
VDD: C3.1, C4.1, C5.1, D2.1 (A), K1.2 (PM), R2.1, R3.1, U1.VO, U3.8 (VCC), U4.1 (VCC)
