mwelling/robot-chopper/(commit log)

2010-11-18 Business Stuff
    [Bill of Materials.xls, CompetitorAnalysis.xls]
2010-11-19 Worked on Newsletter, Business plan, Competitor Analysis, Capabilities/Technologies.
    [CompetitorAnalysis.xls, ComponentSelection.xls]
2010-11-22 Vehicle CAD RCU CAD
    [CapabilitiesTechnologiesTracker.xls, Flight Dynamics.xls]
2010-11-25 Worked on several prototype systems
    [Bill of Materials.xls, CompetitorAnalysis.xls, ComponentSelection.xls]
2010-11-30 Removes encoders. Removes accelerometer. Removes gyro. Adds 2 Ping inputs. Adds 4 Servo outputs. Adds 9DOF INU input. Adds another LED status.
    TODO:
    Resize servo headers.
    Design power supply circuitry.
    Move compass to propeller according to spec.
    Isolate servo and speed controller PWMs.
    Adds 4 banks of tricolor LEDs.
    [robo-chopper.sch]
2010-12-01 Worked on Documentation, GCSI
    [Bill of Materials.xls, ComponentSelection.xls]
2010-12-03 Adds 5V, 6V, and 3.3V power supply circuitry.
    [robo-chopper.sch]
2010-12-06 GCSI, Documentation
    [ComponentSelection.xls]
2010-12-10 Adds work completed last weekend at D's apartment.
    [robo-chopper.sch]
2010-12-12 Vehicle Prototype Landing Pad Vehicle Prototype Camera Mount GCS Interface bugs Conceptual Documents Block Diagram
    [Bill of Materials.xls, CompetitorAnalysis.xls, ComponentSelection.xls, RF Analysis.xls]
2010-12-16 Worked on XBEE API Mode.
    [ComponentSelection.xls, Flight Dynamics.xls]
2010-12-21 GCSI Release .2
    [ComponentSelection.xls, RF Analysis.xls]
2011-01-03 Flight Dyanmics Motor Propeller Test Set
    [Bill of Materials.xls, Flight Dynamics.xls, Software Roadmap.xls]
2011-02-03 Adds power input terminals with overcurrent and reverse voltage protection. Adds 4 BlinkM module connectors. Adds reference designators.
    Schematic is ready for internal design review and PCB artwork.
    [robo-chopper.sch]
2015-03-23 Update bad schematic print.
    The project was not loading local library for whatever reason.
    Any one want to draw the PCB?
